derlucae98/spr23e-bmu/Doc/SPR23e-BMU-Doc_WIP.pdf

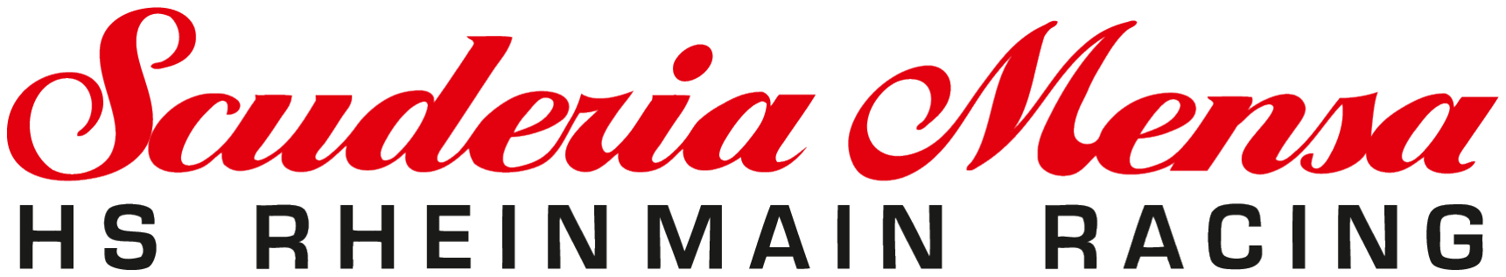
[picture p2: figure]
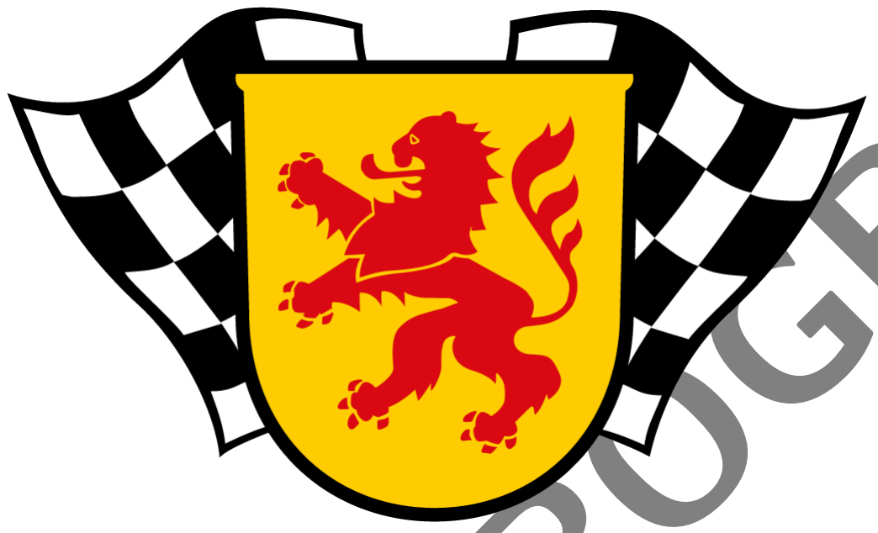
[picture p3: figure]
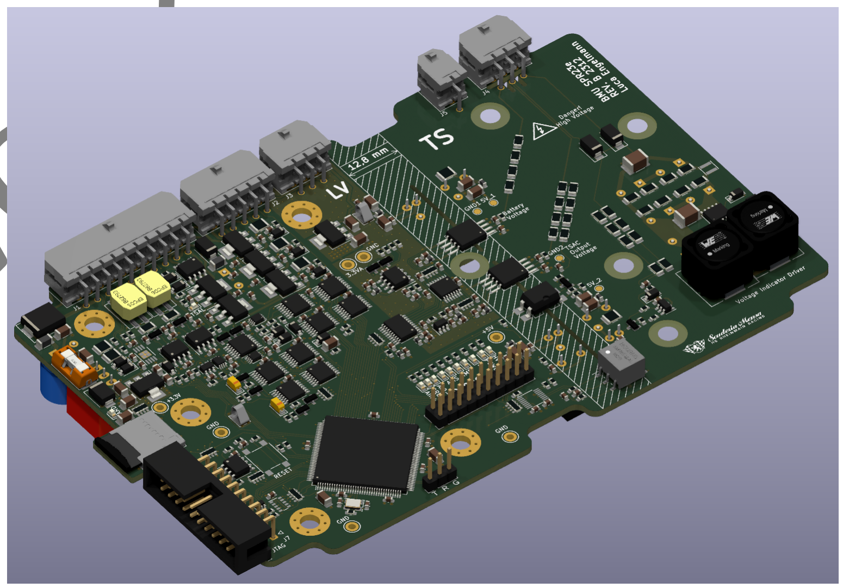
[picture p4: figure]

Department: | Electric Drive
Name: | Luca Engelmann
Season: | 2023/2024

# WORK IN PROGRESS

# Design Report

## Battery Management System for SPR23e

# Contents

Glossary | ii
List of Figures | iii
List of Tables | iv
1. Introduction | 1
2. Potential Improvements | 4
3. BMU Hardware Design | 5
4. Battery Disconnect Unit | 13
5. Software Architecture | 14
6. Test and Validation | 15
7. Bibliography | 26
A. Schematics Revision A (Only for reference!) | 27
B. Changelog Revision B | 40
C. Schematics Revision B | 41

i

# Glossary

AIR Accumulator Isolation Relay

AMS Accumulator Management System (See BMS)

BMS Battery Management System

BMU Battery Management Unit

BOM Bill Of Material

CAN Controller Area Network

CSV Comma-separated Values

EMI Electromagnetic Interference

ESD Electrostatic Discharge

FSG Formula Student Germany

HIL Hardware In the Loop

IMD Insulation Monitoring Device

LED Light Emitting Diode

LVS Low Voltage System

MCU Microcontroller Unit

PCB Printed Circuit Board

TS Tractive System

TSAC Tractive System Accumulator Container

TSAL Tractive System Active Light

UART Universal Asynchronous Receiver Transmitter

ii

# List of Figures

iii

# List of Tables

3.1. Truth table for the plausibility check for each AIR | | 10
3.2. Truth table for the TSAC output voltage plausibility check | | 11

iv

# 1. Introduction

## 1.1. Accumulator

Kurz auf den Akku eingehen; Zellen, Konfiguration und Rendering.

### 1.1.1. System Overview

Blockdiagramm mit Stacks, BMS Slave, AIRs und Sicherung, AIR-PCB mit pre-charge und abgesicherte Messabgriffe, Stromsensor, BMU, IMD

## 1.2. Requirements

### 1.2.1. General Requirements

The requirements are mostly based on the FSG rule set for 2023 [1]. Some general requirements for the vehicle integration apply also. These include

- Power supply from the low-voltage system (LVS) in a range from 18 V to 25 V, which is the unregulated voltage from the low-voltage accumulator.
- One CAN bus with a bitrate of 1 Mbit/s for the communication with the Vehicle Control Unit.
- One IsoSPI [2] interface for the communication with the BMS slaves on the accumulator stacks.
- Isolated voltage measurement for the accumulator and TSAC output voltage with an accuracy better than 1 % of the full measuring range.
- Isolated current measurement with a resolution better than ±140 A, which is two times the fuse rating to allow for any short current peaks, and an accuracy better than 1 % of the full measuring range.

### 1.2.2. Rule Requirements

Since the BMU contains many different parts required by the rules, all of the following rules have to be fulfilled. For the TSAL logic in the accumulator these rules apply:

- EV 4.10.3 [p. 85][1] The TSAL itself must have a green light, continuously on, active if and only if the LVS is active and ALL of the following conditions are true:

– All AIRs are opened.

– The pre-charge relay, see EV 5.7.2, is opened.

– The voltage at the vehicle side of the AIRs inside the TSAC does not exceed 60 V DC or 50 V AC RMS.

- EV 4.10.4 [p. 85][1] The mentioned voltage detection must be performed inside the respective TS enclosure.
- EV 4.10.5 [p. 85][1] The mentioned states of the relays (opened/closed) are the actual mechanical states. The mechanical state can differ from the intentional state, i.e. if a relay is stuck. Any circuitry detecting the mechanical state must meet EV 5.6.2.
- EV 4.10.6 [p. 85][1] The voltage detection circuit of the red light and the relay state and voltage detection circuit of the green light must be independent. Any plausibility check between both lights is not allowed. A TSAL state with both lights simultaneously active might occur and must not be prevented.
- EV 4.10.9 [p. 85][1] The TSAL and all needed circuitry must be hard-wired electronics. Software control is not permitted.
- EV 4.10.10 [p. 85][1] A green indicator light in the cockpit that is easily visible even in bright sunlight and clearly marked with “TS off” must light up if TSAL green light is on, see EV 4.10.3.
- EV 4.10.11 [p. 86][1] Signals influencing the TSAL and the indicator according to EV 4.10.10 are SCS, see T 11.9. The individual safe state of each of the TSAL lights is off. The TSAL has an active indication of the absence of failures (continuous green illumination) and thus the red light must not be illuminated for a visible check, see T 11.9.5.
- EV 4.10.13 [p. 86][1] The TSAL’s green light relay state detection circuit, see EV 4.10.3, does not need to detect an open circuit, as required by T 11.9, when the intentional state of the used (auxiliary) contact is opened. A plausibility check against the intentional relay state must be implemented in a way that the TSAL’s green light stays off after the open circuit is detectable.
- EV 4.10.14 [p. 86][1] The TSAL’s green light voltage detection circuit, see EV 4.10.3, does not need to detect an open circuit, as required by T 11.9, when no voltage is present. A plausibility check against the intentional relay states must be implemented in a way that the TSAL’s green light stays off after the open circuit of the accumulator voltage detection circuit is detectable.
- EV 4.10.14 [p. 86][1] The latching required by EV 4.10.13 and EV 4.10.14 must not be triggered during normal operation conditions and must only be reset by power cycling the LVS.

### 1.2.3. Additional Requirements

Firlefanz, der von der Regeln nicht gefordert wird, aber trotzdem drin ist

## 1.3. SPR21evo BMU

Kurz auf 21er BMU eingehen, Bild der Platine und Beschreibung der Key Features.

## 1.4. Comparing Legacy and Contemporary Solutions

Was kann die alte BMU anders als die neue? Welche Features kamen hinzu? Welche sind entfernt worden? Was ist der Ausblick auf Software-Seite? Logging auf SD-Karte, EEPROM, 2 CAN-Busse

Auch auf AIR-PCB und Stromsensor eingehen

# 2. Potential Improvements

Mögliche Verbesserungen

# 3. BMU Hardware Design

## 3.1. Implementations

Umsetzung der Anforderungen in REV A und REV B beschreiben.

Für REV A wird nur auf den Schaltplan und einen Changelog im Anhang verwiesen. REV B wird im Detail beschrieben

The TSAL logic will be implemented in the following way:

- The actual states of the relays will be monitored using auxiliary contacts in the relays. They are mechanically linked to the main contacts as explained in the application note [3, p. 2]: “The auxiliary contact actuating method will indicate the true position of the main contacts. The auxiliary contact actuation is directly coupled to the main contact moving bridge, and will not indicate “open” unless both contact gaps of the double-make, Form X contact are fully disconnected.”
- The plausibility check to fulfill EV 4.10.5 is done against the intentional state indicated by the BMU. The following possible states can trigger the latch:

– The intentional state is active, the actual state reports inactive: A line break in the state detection is to be assumed.

– The intentional state is inactive, the actual state reports active: The relay is most probably stuck

Due to its mechanical construction, the relay takes 25 ms to switch from the opened to the closed position and 10 ms for the reverse [4, p. 2]. In these time periods, the relay states are implausible and must not trigger the latch, as EV 4.10.14 indicates.

- In order to fulfill EV 4.10.13, a line break in the state detection is detected by a plausibility check against the TSAC output voltage in the following way. In case the TSAC output voltage detection circuit detects a voltage greater than 60 V although all relays are open, these possibilities can occur:

– The discharge circuit is still active after the relay opened. This is not a fault condition, since the discharge circuit takes about 2 seconds to discharge the TS below 60 V.

– If the fault persists for more than 3 seconds than the discharge should have finished and it is to be expected that the relays are stuck and the state detection circuitry is broken.

Note that the permissible state during discharge must not lead to a detected fault. However, a delay of 3 seconds to detect the fault is permissible by the rule.

- Likewise, a line break in the voltage detection circuitry is detected using a plausibility check against the relay states. If the relays are closed and the voltage detection circuitry detects no voltage, a fault in the detection circuitry is to be assumed and must lead to the latched deactivation of the green light.
- Since the TSAL accumulator logic is located on the BMU PCB and all TS components needed to perform the checks are located inside the TSAC, EV 4.10.4 is fulfilled.

- The circuit will be build with logic gates without any software control. Therefore, EV 4.10.9 is fulfilled as well. The final circuit is discussed in full detail in section 3.3.3.

## 3.2. Hardware Block Diagram

Blockdiagramm der BMU Hardware

## 3.3. Schematic Explanation

The schematic is rather complex and would not fit on one page. It is divided into 11 logical modules, which are connected on the top-level schematic seen in Figure 3.1. Each module will be discussed in the
following subsections. The full schematic is available in Appendix C. 1 | 2 | 3 | 4 | 5 | 6
1 | 2 | 3 | 4 | 5 | 6

A

BC

D

A

BC

D Date: 2023-03-25 KiCad E.D.A. kicad 6.0.11-2627ca5db0~126~ubuntu22.04.1 Size: A4 | Rev: B

Id: 1/12 Title: SPR23e Battery Management Unit (BMU) File: spr23e-bmu.kicad_sch Sheet: / Scuderia Mensa HS RheinMain racing e.V. Author: Luca Engelmann Car number: 65

IMD_RESET AMS_RESET SC_INPUT SC_OUTPUT

IMD_RESET_STATUS
AMS_RESET_STATUS

IMD_INDICATOR

AMS_INDICATOR

IMD_STATUS | AMS_FAULT Shutdown ULINK+ ULINK- HVI_LED+ HVI_LED- PRE-CHARGE HVI | ULINK_ISO_B ULINK_ISO_A
TSAL_VOLTAGE_PRESENT ULINK- | UBATT_ISO_B UBATT_ISO_A ULINK+ UBATT- UBATT+ | VREF_H

TS_ISO

Power Datei: Power.kicad_sch | AIR+_STATE
| PRE-CHARGE_STATE

AIR-_STATE

TSAL_VOLTAGE_PRESENT

TSAL_SIG
PRE-CHRG_INTENT AIR+_INTENT AIR-_INTENT

TSAL SHUTDOWN_CIRCUIT DISCHARGE

PRE-CHARGE_INTENT AIR+_INTENT AIR-_INTENT Discharge_Ctrl | MISO_ADC MOSI_ADC

~{CS_ADC}

~{IRQ_ADC} CURRENT_SENS_B ULINK_ISO_A CURRENT_SENS_A ULINK_ISO_B UBATT_ISO_A UBATT_ISO_B SCK_ADC

VREF_H

ADC

~{CARD_DETECT}

~{CS_EEPROM}

~{CS_CARD} SCK_PERIPH MOSI_PERIPH MISO_PERIPH

CS_RTC

~{IRQ_RTC} CLKOUT_RTC

Periphery

ISO_A_SLAVES

ISO_B_SLAVES

~{CS_SLAVES} CAN_H_DIAG CAN_L_DIAG CAN_H_VEHIC CAN_L_VEHIC
CAN0_TX CAN0_RX CAN1_TX CAN1_RX

SCK_SLAVES MOSI_SLAVES MISO_SLAVES

Interface

IMD_STATUS

IMD_MEAS

SC_STATUS

AMS_FAULT

IMD_RESET_STATUS

AMS_RESET_STATUS

AIR+_STATE

AIR-_STATE

PRE-CHARGE_STATE | CAN0_TX CAN0_RX

SPI0_MOSI SPI1_SCK

SPI1_MISO

# SPI1_MOSI SPI2_MOSI UART0_TX UART0_RX CAN1_TX CAN1_RX

SPI0_MISO

SPI0_SCK

SPI2_SCK
SPI2_MISO

AIR+_~{RESET}

AIR-_~{RESET} PRE-CHARGE_SET AIR+_SET PRE-CHARGE_~{RESET} AIR-_SET

~{CS_ADC}
~{IRQ_ADC}

~{CS_EEPROM}
~{CS_CARD} CS_RTC

~{IRQ_RTC}

~{CARD_DETECT}

~{CS_SLAVES} AIR+_INTENT AIR-_INTENT PRE_INTENT

TSAC_VOLTAGE_PRESENT CLKOUT_RTC

AMS-Master AIR+_STATE

PRE-CHARGE_STATE

AIR-_STATE

IMD_MEAS

IMD_STATUS

SC_RETURN

AIR+_~{RESET} AIR+_SET AIR-_SET AIR-_~{RESET} PRE-CHARGE_SET PRE-CHARGE_~{RESET} AIR-_STATE_FILT AIR+_STATE_FILT PRE-CHARGE_STATE_FILT

IMD_MEAS_FILT

IMD_STATUS_FILT SC_STATUS

AIR+ PRE-CHARGE
AIR-

IMD_RESET_FILT AMS_RESET_FILT

IMD_RESET AMS_RESET | PRE-CHRG_INTENT AIR-_INTENT AIR+_INTENT
IO_EMI | GND | GND

H2 GND

H1 | GNDGND | GND
H9 H3 H4 H5 GND | GND

1
2
3

4
5
6

J3 SENSOR

1
2
3

J6UART VCC

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
LV_IO

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
LV ACCU

+24V | H8 N2SHIELD GND | GND

N1SHIELD

1 | 2

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
J4TS | H10 S4SYMBOL S1SYMBOL | H6 H7 S3SYMBOL S2SYMBOL GND

IMD_STATUS

ISO_A CAN_L_VEHIC

HVI+

IMD_RESET CAN_L_DIAG

PRE-CHRG

HVI- TSAL_SIG
AMS_RESET AMS_INDICATOR

## SC_INPUT GND

IMD_INDICATOR

SC_OUTPUT SC_INPUT PRE-CHARGE_STATE

PRE-CHARGE
AIR+ AIR+_STATE HVI+

IMD_MEAS

IMD_STATUS

AIR+_STATE
AIR-_STATE

SC_RETURN

AMS_RESET | AMS_INDICATOR DISCHARGE ULINK+ HVI- | ULINK- DISCHARGE

PRE-CHRG

SENS- | SENS+ | UBATT- ULINK+ AIR-_STATE UBATT+ | UBATT+
ISO_B | ULINK+ ULINK- UBATT-

ISO_A

# SENS+ SENS- SC_OUTPUT

IMD_RESET SC_RETURN

CAN_H_VEHIC

IMD_INDICATOR

CAN_H_DIAG

AIR-

# IMD_MEAS ULINK-

ISO_B

PRE-CHARGE

PRE-CHARGE_STATE
AIR+ AIR- +24V

TSAL_SIG

CAN_H_DIAG

CAN_L_VEHIC

CAN_H_VEHIC

CAN_L_DIAG

GND

J6UART

1
2
3 +24V

J1

LV_IO

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
9 | VCC

J3 SENSOR
1
2
3

4
5
6 | H3 H4 H5 GNDGND

H1 GND

H2 GND | GND
H9 H8 H7 H6 S1SYMBOL S3SYMBOL S2SYMBOL S4SYMBOL N1SHIELD GND | GND

N2SHIELD

Figure 3.1.: Top-level BMU schematic.

### 3.3.1. Power Supply

The power supply schematic provides input protection and all necessary power rails for the BMU. The schematic for the power supply section is shown in Figure 3.2. At the input, L1, C77, and C78 form a low-pass filter to filter out any high-frequency noise which might be on the low-voltage system. D16 is used in conjunction with F1 to protect the BMU against over-voltages. D15 not only protects the BMU from reverse-polarity, but it also isolates the BMU supply from the low-voltage system. A high-current spike will not drain C78, leading to a stable power supply of the BMU in case of voltage dips caused by switching of the cooling fans or pumps. The 18 V to 25 V provided by the LVS is stepped-down to 5 V using an integrated DC to DC converter. Two low-dropout regulators U25 and U26 generate the main 3.3 V digital voltage rail used by the microcontroller and the other digital circuits and a secondary 3.3 V voltage rail used by the analog circuits. The use of two independent regulators for analog and digital circuits prevents noise coupling from the digital to the analog circuit. A power LED signalizes that the BMU is powered. Test points for all voltage rails are provided for easy measurement on the PCB.

B

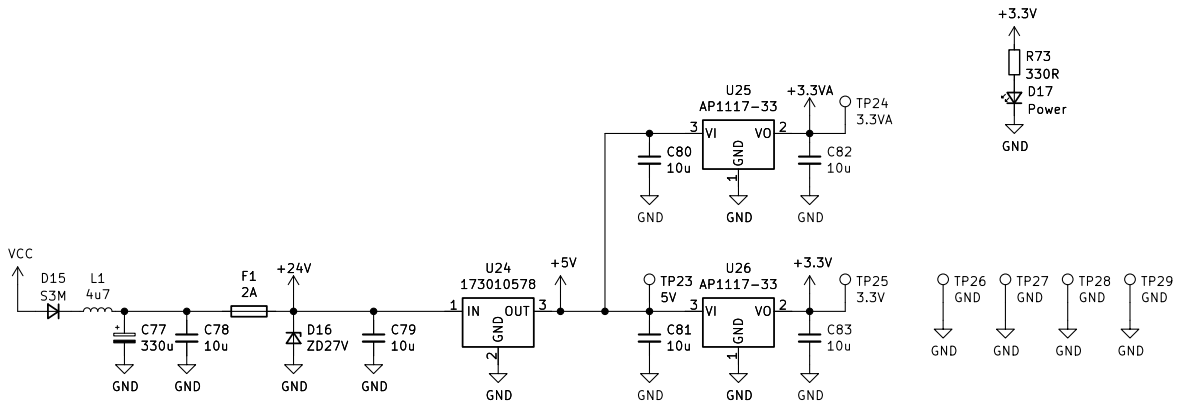
[picture p5: figure]
GND; 2 OUT 3 U24; 10u VCC; 1 VO 2 VI 3 U25 AP1117-33 +3.3VAC82; 10u GND; TP28 GND GND GND; D16 ZD27V C78 10u GND; 2A GND; D17 Power GND; TP27 GND; TP26 GND; +3.3V GND GND 1 VO 2 VI 3 U26 AP1117-33 GND; 5V GND; R73 330RGND; C81 10u GND; TP29 GND; +3.3V U26 AP1117-33GND; 1 VO 2 VI 3 GND; U25 AP1117-33GND; 1 VO 2 VI 3 +3.3VA GND; 2 OUT 3 GND; C78 10u GND; C77 330u GND; +24VD16 ZD27V GND; 330R GND; D17 Power +3.3V

Figure 3.2.: Schematic of the power supply section.

### 3.3.2. I/O

This section of the schematic conditions the input signals for the BMU logic and drives the AIRs. It can be seen in Figure 3.3. Since the digital section operates at 3.3 V and the signals outside the BMU operate at LVS levels, zener diodes are used to limit the voltages. Each signal has a pull-down resistor to ensure stable logic levels in case of unconnected inputs. The 2.2 kΩ resistors at the inputs for the state detection of each relay ensure the minimum wetting current needed for the LEV100 relays: "Minimum Aux Contact Load 10mA/12Vdc" [4, p. 3]. Likewise, the pull-down resistors R77 and R78 for the IMD are the recommended values from the datasheet [5, p. 5]. Note that these resistors have to dissipate some power at the maximum voltage of the LVS: Pd,pull−down =

(25 V)

2
2.2 kΩ = 0.28 W. Therefore, resistors in a 1210 package are used, since they are rated for 0.5 W of power [6]. The capacitors form in combination with the zener diode dropper resistors a low-pass filter used to filter out any noise which might be picked up by the signal wires. The status of the shutdown circuit is also evaluated by the BMU. The same input protection circuit is used to measure the voltage of it. The relays are directly supplied from the shutdown circuit. L2 and C96 form low-pass filter, which limits the current spike caused by the switching of the relays. D18 is important to separate the high-current path from the detection path. Imagine that the AIRs are not energized and the shutdown circuit is active. Now, one emergency button is pressed. The shutdown circuit is turned off but C96 is still charged. Without D18, it would lead to a false reading of the SC_STATUS signal until the capacitor is discharged. With D18, C96 is blocked from holding up the voltage at the SC_RETURN node in this scenario. This ensures, that the microcontroller and the latches U28A, U28B, and U29A detect a power-loss in the shutdown circuit without any noticeably delay.

The AIRs are controlled by ITS4200 high-side switches [7] which are supplied by the shutdown circuit. This is required by EV 6.1.1 [1]. U30 is used as level shifters to drive the high-side switches. This step is needed, since the ITS4200 is advertised with a "CMOS compatible input" [7, p. 2] and has an input voltage turn-on threshold of 3.0 V [7, Table 4]. Its input is driven with 5 volt instead of 3.3 V to avoid potential problems. The inputs of the 74HCT logic series recognize a logical high signal at and above 2.0 V. The ITS4200 is internally protected against short-circuits and voltage backfeed, making it an ideal output driver for the BMU. The relays are not directly controlled by the BMU. Instead, flip-flops isolate the control from the microcontroller to the outputs. The MCU can set and clear the flip-flops. Additionally, the flip-flops can be cleared by the shutdown circuit signal. This has the advantage that the relays are not only de-energized by the loss of power but also the turn-on request is cleared in hardware. In the BMU for the SPR21e, this was solely done in software. Now imagine that the flip-flops were omitted and the microcontroller crashes as soon as the AIRs are energized. If the emergency switch is pushed, the AIRs will de-energize. However, since the crashed microntroller still requests the positive and negative AIR to be energized, re-activation of the emergency switch results in an uncontrolled re-activation of the tractive system without pre-charging. Due to the large current spike, both the positive and negative AIR will be most likely stuck after this event. This has happened in the early testing phase of the SPR21e. With the hardware flip-flops, it doesn’t matter if the microcontroller crashes while the AIRs are energized. The flip-flops will only react on the rising-edge of the SET-signals and will be cleared, as soon as the shutdown circuit opens. The intentional states of the relays are taken from the outputs of the flip-flops. Notice that the flip-flops are reset-dominant, meaning that they cannot be set if the clear input is set to a logical zero.

# 10k GND

# 2k2D18 US1M

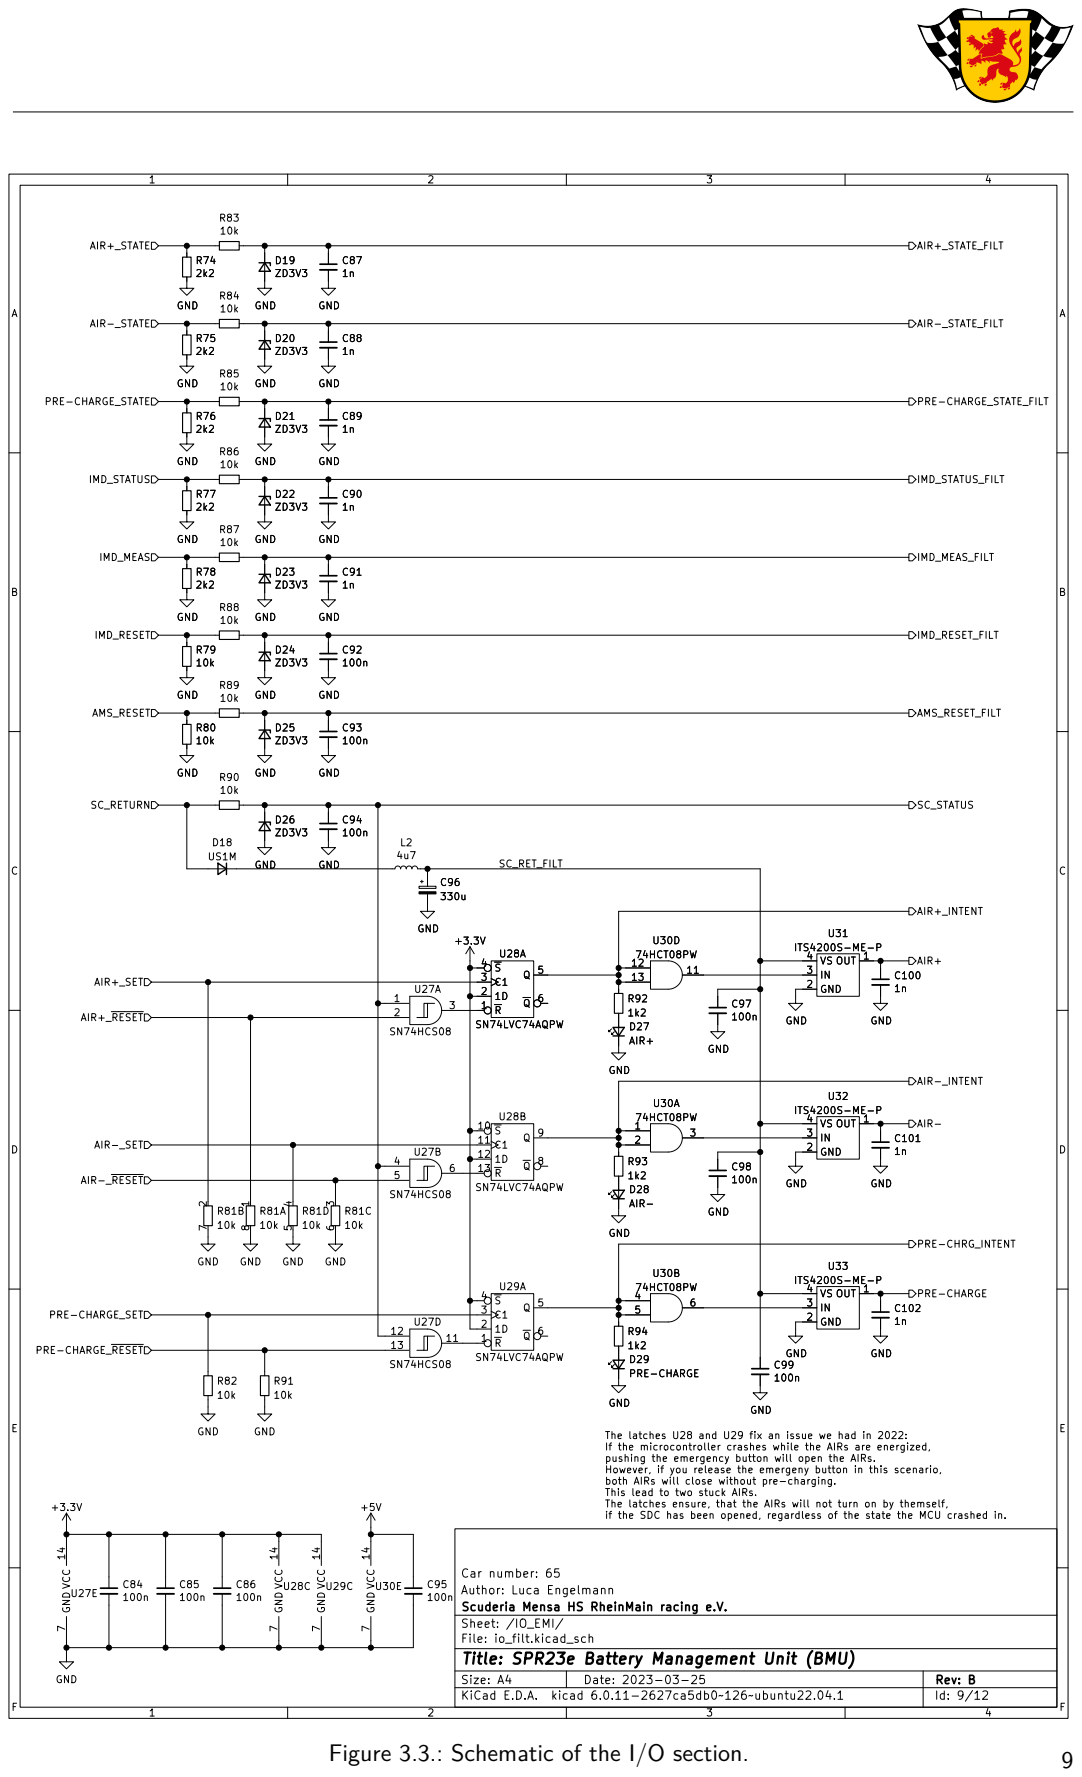
[picture p6: page 15]

1n GND VCC ¹⁴ GND
IMD_STATUS

ITS4200S-ME-P OUT 1 GND 2
OUT 1 GND 2
ITS4200S-ME-P GND GND OUT 1 GND 2

The latches U28 and U29 fix an issue we had in 2022:
pushing the emergency button will open the AIRs. However, if you release the emergeny button in this scenario, both AIRs will close without pre-charging. This lead to two stuck AIRs. The latches ensure, that the AIRs will not turn on by themself,

Id: 9/12 Title: SPR23e Battery Management Unit (BMU) File: io_filt.kicad_sch Sheet: /IO_EMI/ Scuderia Mensa HS RheinMain racing e.V. Author: Luca Engelmann Car number: 65

### 3.3.3. TSAL

The TSAL schematic can be divided into three logical sections. The top section checks the three AIRs for plausible states. The second section checks the TS detection circuit for plausibility. The third section
controls the green light and contains the required latch. Figure 3.4 shows the schematic of the TSAL logic. 1 | 2 | 3 | 4 | 5 | 6
1 | 2 | 3 | 4 | 5 | 6

A

BC

D

A

BC

D Date: 2023-03-25 KiCad E.D.A. kicad 6.0.11-2627ca5db0~126~ubuntu22.04.1 Size: A4 | Rev: B

Id: 11/12 Title: SPR23e Battery Management Unit (BMU) File: tsal_accu.kicad_sch Sheet: /TSAL/ Scuderia Mensa HS RheinMain racing e.V. Author: Luca Engelmann Car number: 65

1

2 3 Q7 BSS84AK

+3.3V

11

12

13 U38D
SN74HCS7266QPWR
TP33 AIR_ACTIVE
+24V GND

4
5

6 U39B
74AHC32PW

10

8

9 U39C
74AHC32PW

1
2

3 U39A
74AHC32PW

R126
10k

1
2

3 U38A
SN74HCS7266QPWR

10

8

9 U38C
SN74HCS7266QPWR

D37 TSAL_GREEN

TP29 TSAL_LATCH_RESET | R122 100R

~{S} 10 C1 11

1D

12 ~{R} 13 | ~{Q}8 Q

9 U29B

SN74LVC74AQPW

GND

11
12

13 U37D
74AHC02PW

GND

11
12

13 U39D
74AHC32PW

GND

1

2 3 Q8 BSS84AK

+3.3VR119

10k +3.3VD36

1N4148 | R125

10k R123
100R

C124
10u

1

2

3 U37A
74AHC02PW

1

2 3 Q6 SQ2308CES

11

12

13 U1D
SN74HCS08 4

5

6 U38B
SN74HCS7266QPWR | GND

C126
1n GND

TP36 GREEN_SIG

GNDGND OUT 1 GND 2

IN

3 VS 4 U40

ITS4200S-ME-P C125

100n R120
1k 10

8

9 U30C
74HCT08PW

+3.3V

10

8

9 U37C
74AHC02PW

TP32 AIR_PLAUSIBLE

TP34 HV_DET_PLAUS

+3.3V

1

# 2 3 Q5 SQ2308CES R121

1k GND

C119

100n | C121

100n C120

100n | TP35 GREEN_EN
TP31 TSAL_PWR_ON_RST

10

8

9 U27C

SN74HCS08 C118

100n

4

5

6 U37B
74AHC02PW

10
8
9 | U1C
SN74HCS08 | TP37 AIR_PLAUSIBLE_DELAY VCC ¹⁴ GND

7 U38E VCC 14 GND

7 U39E VCC 14 GND

7 U1E

1
2

3 U1A
SN74HCS08 TP38 HV_DET_PLAUS_DLY VCC ¹⁴ GND

7 U37E R124
10k TP30 VOLTAGE_PRESENT GND | GND | GND

C123
10u C122
10u | +3.3V GND

AIR+_STATE

# TSAL_VOLTAGE_PRESENT AIR+_INTENT PRE-CHARGE_STATE

TSAL_SIG

AIR-_INTENT PRE-CHRG_INTENT AIR-_STATE | HV_DET_PLAUSIBLE
AIR+_ACTIVE | GREEN_EN

HV_DET_PLAUS_DLY

AIR-_ACTIVE

PRE_ACTIVE | AIR_ACTIVE

AIR_PLAUSIBLE

AIR+_PLAUSIBLE

PRE_PLAUSIBLE

AIR-_PLAUSIBLE

AIR_PLAUSIBLE_DELAY Retriggerable | delay
(falling | edge) 100ms Retriggerable | delay
(falling | edge) 100ms AIR plausibility | check | TS detection | plausibility | check | GND

C122

10u D36

1N4148 +3.3V R119

10k +3.3V | GND

C125
100n U40

ITS4200S-ME-P OUT 1 GND 2

IN

3 VS 4GND GND | GND

C126

1n GND Q6
1 | SQ2308CES

2 3 Q5
1 | SQ2308CES

2 3 U29B

SN74LVC74AQPW

~{S} 10 C1 11

1D

12 ~{R} 13 | ~{Q}8 Q

# 9 +3.3V U38D

SN74HCS7266QPWR
11

12
13 | R126
10k D37 TSAL_GREEN GND | GND
| R125
10k C124

## 10u GND

C123
10u GND

R124
10k

Figure 3.4.: Schematic of the TSAL accumulator logic.

The logic evaluates if the current state is plausible. A plausible state is always reached when the TSAC output voltage matches the relay state and if the actual relay state matches the intentional state. The truth table for the AIR plausibility check for each AIR is shown in Table 3.1. The resulting boolean function corresponds to an exclusive NOR gate (U38 in Figure 3.4).

Table 3.1.: Truth table for the plausibility check for each AIR.
AIR intentional | AIR actual | plausible | Comment
inactive | inactive | yes | No error
inactive | active | no | AIR stuck
active | inactive | no | State detection or coil wire broken
active | active | yes | No error

The AND gate U1 (Figure 3.4) combines the plausibility of all AIRs to one signal AIR_PLAUSIBLE, which is low as soon as one of the AIRs is implausible and high if all AIRs are plausible. A retriggerable delay circuit accommodates for the mechanical switching time of the AIRs. It delays the falling edge only and passes the rising edge through without any delay. The delay time is set by the time constant of C123 and

R124 (Figure 3.4) and the input threshold of the following AND gate (U1, Figure 3.4). The following gate needs to have Schmitt trigger inputs due to the slow falling edge caused by the delay. The input thresholds have a large tolerance and are not specified for a supply voltage of 3.3 V [8, Section 6.5]. The interpolated values for the negative threshold are 0.61 V < UT − < 1.22 V. At the maximum lower input threshold, the delay time is minimal and corresponds to the RC time constant τ . The circuit ensures a minimum delay time of 100 ms. At the minimum lower input voltage threshold, the delay time will increase to 170 ms.

The plausibility check for the TSAC output voltage detection uses both the intentional and the actual AIR states for comparison. U37 and U39 combine the six signals to one signal. If any of the AIRs is active (either intentional or unintentional) the signal AIR_ACTIVE will be high. The complex appearing connection of U37 and U38D results in an efficient utilization of the four independent gates within a package. U38D is configured to behave like an inverter. The signal HV_DET_PLAUSIBLE is a combination of the TSAC output voltage detection and the AIR state with the truth table shown below. The corresponding boolean function is an OR gate with one inverted input.

Table 3.2.: Truth table for the TSAC output voltage plausibility check.
Voltage present | AIR active | plausible | Comment
no | no | yes | No error
no | yes | no | Voltage detection broken wire
yes | no | yes | See text
yes | yes | yes | No error

A voltage greater than 60 V present at the TSAC output while no AIR is active is not considered as implausible since this happens on every discharge cycle. In this case, the green and the red LED of the TSAL will be active. This edge case is allowed by rule EV 4.10.6 and is thus not prevented. The HV_DET_PLAUSIBLE signal uses an identical retriggerable delay circuit. In this case, it is used to accommodate for the sum of the pre-charge time and the relay turn-on time. During pre-charge, the TSAC output voltage will rise depending on the time constant of the pre-charge resistor and the DC-Link capacitor. In order to detect a broken wire in the voltage detection circuitry, the plausibility check waits for the DC-Link voltage to rise above 60 V. This ensures that the broken wire is detected if the implausibility persists after the pre-charge time and pre-charging will not lead to a false triggering. The time it takes for the DC-Link voltage to rise above 60 V can be calculated with the basic capacitor charging formula shown in Equation 3.1.

Uc(t) = U0 · (1 − e

− t
τ ) | (3.1)

Re-arranging Equation 3.1 to solve for t is shown in Equation 3.2. The maximum t will be at the minimum battery voltage of 430 V. Solving for Uc(t) = 60 V, U0 = 430 V, τ = RC = 1000 Ω · 300 µF, Equation 3.2 yields:

tpre = −τ · ln
1 −

Uc(t)
U0

= −(1 kΩ · 300 µF) ln
1 −

60
430
= 45 ms | (3.2)

The turn-on time of the relays add to the pre-charge time. The resulting total pre-charge time tpre,sum equals:
tpre,sum = ton,relay + tpre = 25 ms + 45 ms = 70 ms | (3.3)

Therefore, a delay of 100 ms is sufficient as well.

The last section of the TSAL logic combines the plausibility check, the voltage detection signal, and the AIR_ACTIVE signal to control the green light of the TSAL. The flip-flop U29B is the latch required by EV 4.10.13 and EV 4.10.14. It is set on startup after a short delay, to ensure that all signals which clear the latch are stable. If the AIRs or the voltage detection are implausible, the latch is cleared. The output of the latch is used as enable signal for the green light. Therefore, the green light can only be activated, if the whole system is in a plausible state. The green light is then controlled by the AIR_ACTIVE and TSAL_VOLTAGE_PRESENT signal in a way that either of these signals turn off the green light. This ensures that the green light is deactivated as soon as at least one AIR is active and reactivated only if the voltage at the TSAC output is less than 60 V and all AIRs are off. The signal output uses the same method as described in subsection 3.3.2. The signal produced by U40 is sent to the TSAL logic in the inverter, where it is routed to the TSAL lights.

# 4. Battery Disconnect Unit

Hier auf AIR-PCB und Stromsensor eingehen und die Platzierung der Komponenten in der BDU; Rendering

## 4.1. AIR PCB

Schaltplan und Beschreibung der Funktion, Rendering

## 4.2. Current Sensor

Schaltplan, Beschreibung der Komponenten, Berechnung der Genauigkeit und Rendering

# 5. Software Architecture

Softwarearchitektur erläutern

## 5.1. <Software Modul>

Softwaremodule erläutern

# 6. Test and Validation

## 6.1. Test Setup

Testaufbau erklären

## 6.2. TSAL Test

The TSAL accumulator logic has been simulated with LTSpice before putting it onto the PCB. The simulation tests all possible error conditions, including stuck relays, broken relay state detections and a line break in the voltage detection. The simulation results have been checked against the real behavior using a Hardware-in-the-loop (HIL) test procedure. A S32K144-Q100 evaluation board [9] is connected via CAN to the BMU and controls the relays in the test setup based on the commands sent by the BMU. It also feeds back the current state of the TSAL signal. The BMU runs a modified firmware which contains the test procedures. These tests can be initiated via the UART interface. During the test, the BMU will output all necessary values in CSV format over the UART interface in 50 ms time intervals. The BMU firmware uses the measured DC-Link and battery voltages to perform the pre-charge. The simulation performs the pre-charge using a constant timing for the relays. Stuck relays may lead to different pre-charge times than usual. The simulation will not account for that fact. However, it does not influence the behavior of the TSAL logic. Furthermore, the slow appearing rise and fall times in the test results are an artifact from the 50 ms time slices. They do not represent the real rise and fall times. Another artifact from the same source are shifted edges by ±50 ms. The following pages show the simulation result on the left side and the real behavior on the right side in the following order:

1. No error
2. Positive AIR stuck
3. Pre-charge relay stuck
4. Negative AIR stuck
5. Voltage detection broken wire
6. Positive AIR state detection broken wire
7. Pre-charge relay state detection broken wire
8. Negative AIR state detection broken wire

The graphs in each plot represent the logic signals at the most important points in the circuit. The upper most plot shows the output of the TSAL logic, which controls the green light. The second graph shows the voltage detection with a logical high at 3.3 V representing a detected voltage > 60 V. The relay intent and state plots are self explanatory. They represent the intentional and actual state of the relay with a logical high representing an active state. The last plot shows the DC-Link voltage measured by the BMU. The simulation uses the accumulator voltage of 600 V while the HIL test uses 24 V. The plots of the HIL tests use 0 and 1 to denote the logical states.

Test 1: No error

In this test, the BMU performs a pre-charge and a discharge cycle. The TSAL green light shall turn off, as soon as at least one AIR is closed or the voltage across the DC-Capacitor is greater than 2.5 V and shall turn back on, if all AIRs are open and the DC-Link voltage is less than 2.5 V. The 24 V/2.5 V ratio between the battery voltage in the test setup and the TS detection threshold is approximately the same as in the real setup with a ratio of 600 V/60 V. As seen in Figure 6.2, the TSAL logic behaves exactly as simulated. The test would not be passed, if the LED would not turn off at the 1 s mark or would remain off at the 4.4 s mark.

Test 2: Positive AIR stuck

This test simulates a stuck positive AIR. The AIR+ state is therefore always high. During pre-charging, the negative AIR closes. Therefore, the pre-charge resistor is bridged in this scenario. Notice that the simulation uses a simple time-controlled pre-charging while the real BMU performs the pre-charging based on the DC-Link and battery voltage. This explains the short on-time of the pre-charge relay compared to the simulation due to the fast rise time of the DC-Link voltage. Notice also, that the BMU with the final firmware would not allow to close any relay if one of the relay is stuck. Both the simulation in Figure 6.3 and the HIL test in Figure 6.4 show, that the TSAL green light never turns on, as required.

Test 3: Pre-charge relay stuck

A stuck pre-charge relay does not directly lead to malfunction of the pre-charge sequence or the general function of the tractive system. However, it would violate EV 5.6.2 [1, p. 90]. A stuck pre-charge relay is detected correctly as Figure 6.5 and Figure 6.6 show. The TSAL’s green light does not turn on at all.

Test 4: Negative AIR stuck

Similarly to test 3, a stuck negative AIR causes no direct malfunction of the system but it will also violate EV 5.6.2 [1, p. 90]. This fault is correctly detected as well, as seen in Figure 6.7 and Figure 6.8.

Test 5: Voltage detection broken wire

A broken wire or blown fuse in the voltage detection circuit is simulated in this test. Since the voltage detection circuit and the TSAC output voltage measurement share the same wire and fuse, the DC-Link voltage and the voltage detection in both the simulation and the real hardware read always zero. Additionally, since the simulation does not use the DC-Link voltage to perform the pre-charge, the relay sequence looks identical to any other test (Figure 6.9). The BMU will remain in the pre-charge state since the DC-Link voltage does not reach 95 % of the battery voltage, causing the positive AIR to never energize (Figure 6.10). It is apparent that as soon as the negative AIR and the pre-charge relay turn on, the green light turns off and remains off, after both relays de-energize again.

Tests 6, 7, and 8: Relay state detection broken

Due to their similarities, the last three tests are summarized here. As seen in Figure 6.12, Figure 6.14, and Figure 6.16, the state detection of the positive AIR, pre-charge relay, and negative AIR read constantly zero. This fault is detectable, as soon as the corresponding relay is energized. The green light turns of, as soon as the AIRs are energized and remains off after the relays de-energize due to the fault latching.

TSAL Test: Summary

In summary, the tests show that the TSAL accumulator logic recognizes all possible faults correctly and behaves rule compliant. While these tests seem extremely elaborate and time-consuming, it is important to fully validate the functionality of the TSAL logic, since it is a safety-critical part that must behave under all circumstances as expected.

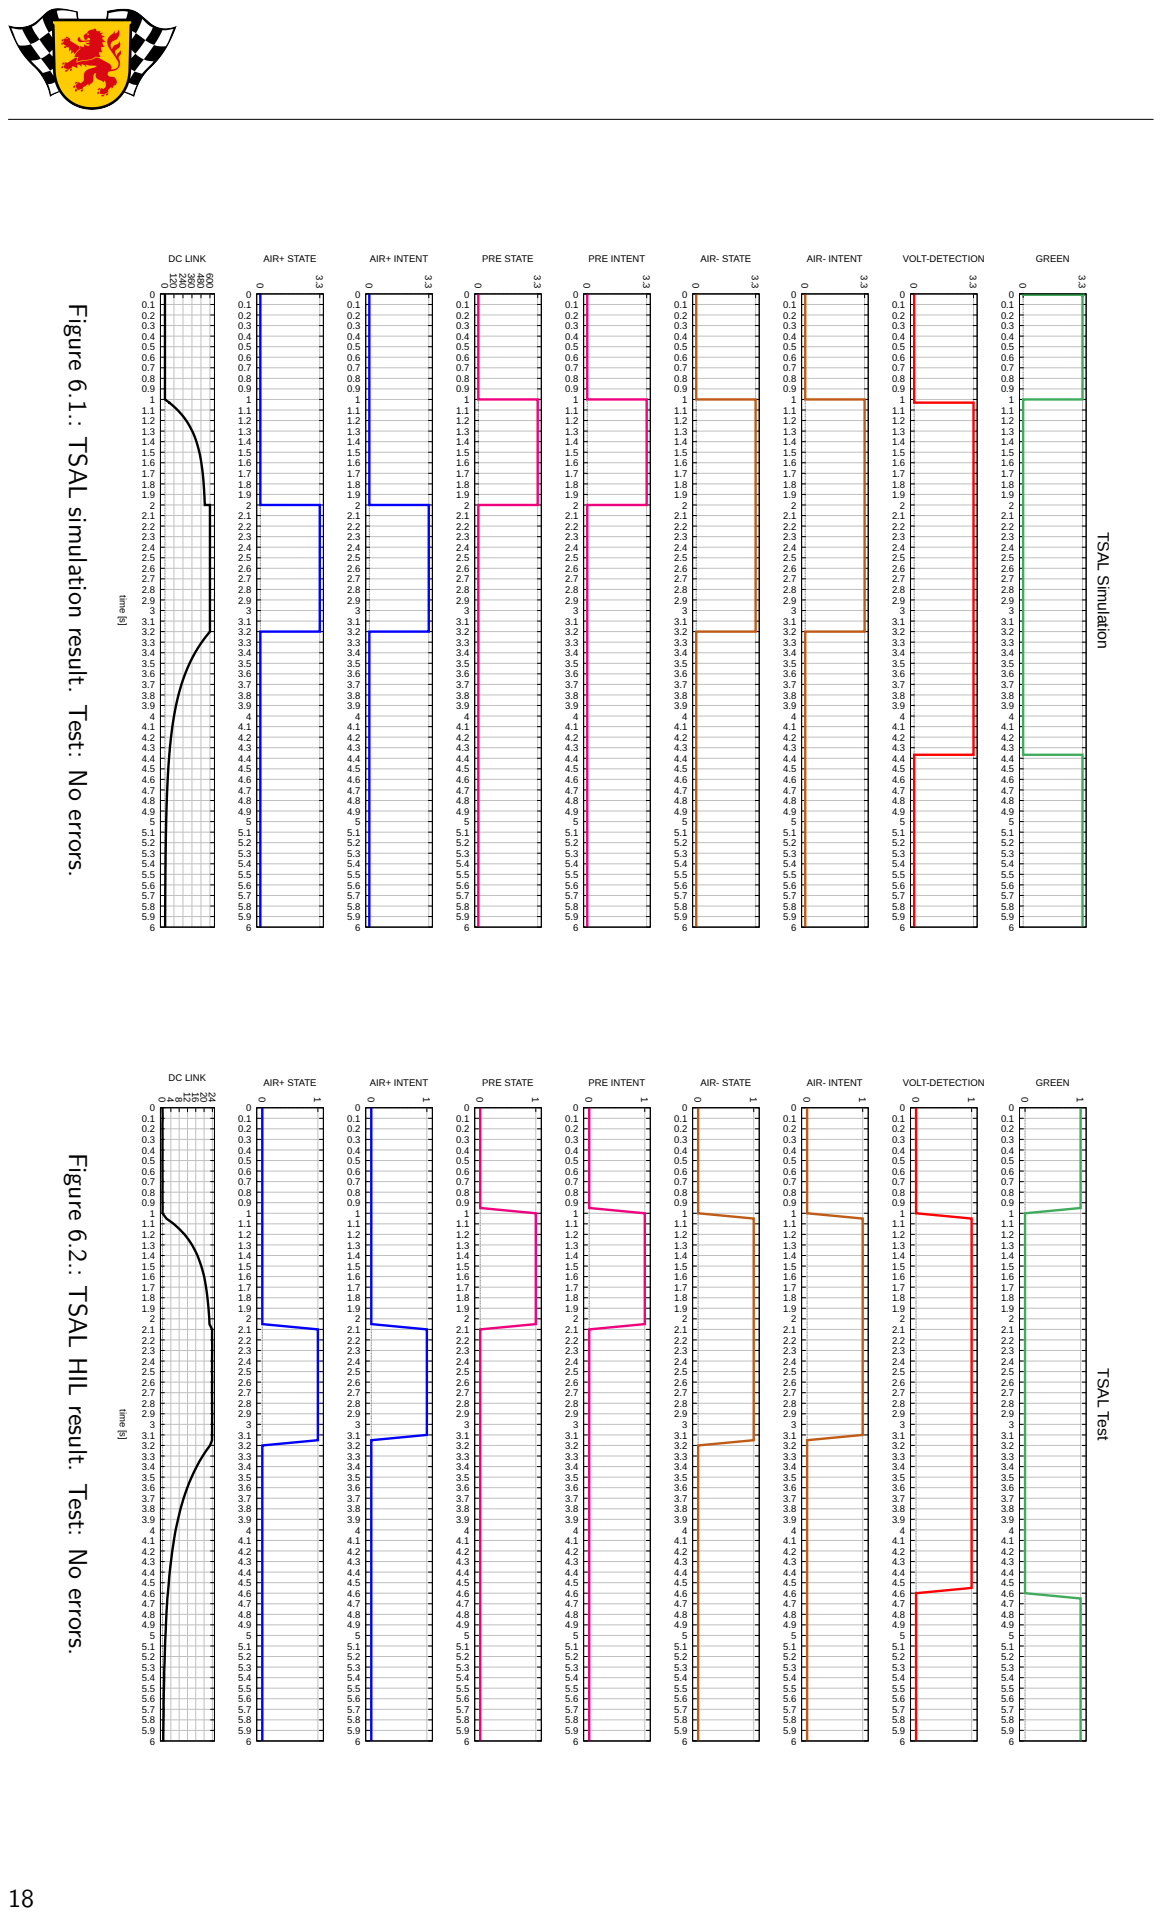
[picture p7: page 24]
TSAL Simulation; GREEN; VOLT-DETECTION; AIR- INTENT; AIR- STATE; PRE INTENT; PRE STATE; AIR+ INTENT; AIR+ STATE; DC LINK; time [s]; TSAL Test

Figure 6.1.: TSAL simulation result. Test: No errors.

Figure 6.2.: TSAL HIL result. Test: No errors.

TSAL Simulation

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
GREEN

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
VOLT-DETECTION

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
AIR- INTENT

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
AIR- STATE

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
PRE INTENT

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
PRE STATE

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
AIR+ INTENT

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
AIR+ STATE

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
DC LINK

time [s]

Figure 6.3.: TSAL simulation result. Test: Positive AIR

stuck.

TSAL Test

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
GREEN

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
VOLT-DETECTION

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
AIR- INTENT

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
AIR- STATE

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
PRE INTENT

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
PRE STATE

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
AIR+ INTENT

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
AIR+ STATE

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
DC LINK

time [s]

Figure 6.4.: TSAL HIL result. Test: Positive AIR stuck.

TSAL Simulation

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
GREEN

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
VOLT-DETECTION

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
AIR- INTENT

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
AIR- STATE

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
PRE INTENT

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
PRE STATE

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
AIR+ INTENT

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
AIR+ STATE

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
DC LINK

time [s]

Figure 6.5.:

relay stuck.

TSAL simulation result. Test: Pre-charge

TSAL Test

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
GREEN

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
VOLT-DETECTION

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
AIR- INTENT

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
AIR- STATE

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
PRE INTENT

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
PRE STATE

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
AIR+ INTENT

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
AIR+ STATE

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
DC LINK

time [s]

Figure 6.6.:

stuck.

TSAL HIL result. Test: Pre-charge relay

TSAL Simulation

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
GREEN

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
VOLT-DETECTION

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
AIR- INTENT

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
AIR- STATE

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
PRE INTENT

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
PRE STATE

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
AIR+ INTENT

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
AIR+ STATE

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
DC LINK

time [s]

Figure 6.7.: TSAL simulation result. Test: Negative AIR

stuck.

TSAL Test

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
GREEN

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
VOLT-DETECTION

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
AIR- INTENT

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
AIR- STATE

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
PRE INTENT

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
PRE STATE

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
AIR+ INTENT

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
AIR+ STATE

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
DC LINK

time [s]

Figure 6.8.: TSAL HIL result. Test: Negative AIR stuck.

TSAL Simulation

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
GREEN

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
VOLT-DETECTION

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
AIR- INTENT

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
AIR- STATE

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
PRE INTENT

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
PRE STATE

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
AIR+ INTENT

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
AIR+ STATE

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
DC LINK

time [s]

Figure 6.9.:

tection broken wire.

TSAL simulation result. Test: Voltage de-

TSAL Test

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
GREEN

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
VOLT-DETECTION

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
AIR- INTENT

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
AIR- STATE

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
PRE INTENT

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
PRE STATE

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
AIR+ INTENT

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
AIR+ STATE

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
DC LINK

time [s]

Figure 6.10.:

broken wire.

TSAL HIL result. Test: Voltage detection

TSAL Simulation

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
GREEN

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
VOLT-DETECTION

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
AIR- INTENT

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
AIR- STATE

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
PRE INTENT

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
PRE STATE

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
AIR+ INTENT

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
AIR+ STATE

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
DC LINK

time [s]

Figure 6.11.: TSAL simulation result. Test: Positive AIR

state detection broken wire.

TSAL Test

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
GREEN

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
VOLT-DETECTION

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
AIR- INTENT

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
AIR- STATE

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
PRE INTENT

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
PRE STATE

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
AIR+ INTENT

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
AIR+ STATE

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
DC LINK

time [s]

Figure 6.12.: TSAL HIL result. Test: Positive AIR state

detection broken wire.

TSAL Simulation

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
GREEN

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
VOLT-DETECTION

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
AIR- INTENT

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
AIR- STATE

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
PRE INTENT

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
PRE STATE

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
AIR+ INTENT

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
AIR+ STATE

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
DC LINK

time [s]

Figure 6.13.:

relay state detection broken wire.

TSAL simulation result. Test: Pre-charge

TSAL Test

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
GREEN

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
VOLT-DETECTION

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
AIR- INTENT

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
AIR- STATE

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
PRE INTENT

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
PRE STATE

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
AIR+ INTENT

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
AIR+ STATE

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
DC LINK

time [s]

Figure 6.14.:

state detection broken wire.

TSAL HIL result. Test: Pre-charge relay

TSAL Simulation

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
GREEN

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
VOLT-DETECTION

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
AIR- INTENT

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
AIR- STATE

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
PRE INTENT

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
PRE STATE

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
AIR+ INTENT

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
AIR+ STATE

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
DC LINK

time [s]

Figure 6.15.: TSAL simulation result. Test: Negative

AIR state detection broken wire.

TSAL Test

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
GREEN

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
VOLT-DETECTION

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
AIR- INTENT

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
AIR- STATE

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
PRE INTENT

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
PRE STATE

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
AIR+ INTENT

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
AIR+ STATE

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
DC LINK

time [s]

Figure 6.16.: TSAL HIL result. Test: Negative AIR state

detection broken wire.

# 7. Bibliography

[1] Formula Student Rules 2023, Formula Student Germany, 2023, Version 1.1. [Online]. Available: https://www.formulastudent.de/fileadmin/user_upload/all/2023/rules/FS-Rules_2023_v1.1.pdf [Accessed: 2023/03/19]
[2] J. | Munson, | “Low | Cost | isoSPI | Coupling | Circuitry | for | High | Voltage | High | Capac-
ity | Battery | Systems.” | [Online]. | Available: | https://www.analog.com/en/technical-articles/
low-cost-isospi-coupling-circuitry-for-high-voltage-high-capacity-battery-systems.html (https://www.analog.com/en/technical-articles/low-cost-isospi-coupling-circuitry-for-high-voltage-high-capacity-battery-systems.html) | [Accessed:
2023/03/19]
[3] Application Notes for EV/LEV Contactors, | TE | Connectivity, | 2013. | [Online]. | Avail-
able: | https://www.flamecorp.com/PDF/TE-Connectivity/Kilovac/Application%20Notes%20for%
20EV-LEC%20Contactors.pdf (https://www.flamecorp.com/PDF/TE-Connectivity/Kilovac/Application%20Notes%20for%20EV-LEC%20Contactors.pdf) [Accessed: 2023/03/19]
[4] LEV100H Extended Performance w/ Aux Contact Data Sheet, TE Connectivity, 2016. [Online]. Available: https://www.te.com/commerce/DocumentDelivery/DDEController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. pdf%7F1618408-2 (https://www.te.com/commerce/DocumentDelivery/DDEController?Action=showdoc) [Accessed: 2023/03/19]
[5] ISOMETER® | IR155-3203/IR155-3204. | Isolationsüberwachungsgerät | für | ungeerdete | DC-
Antriebssysteme (IT-Systeme) in Elektrofahrzeugen., BENDER, 2021, Version V004. [Online]. Available: https://www.bender.de/fileadmin/content/Products/d/d/IR155-32xx-V004_D00115_D_XXDE.pdf (https://www.bender.de/fileadmin/content/Products/d/d/IR155-32xx-V004_D00115_D_XXDE.pdf) [Accessed: 2022/09/23]
[6] EEPOWER, “Resistor Sizes and Packages .” [Online]. Available: https://eepower.com/resistor-guide/resistor-standards-and-codes/resistor-sizes-and-packages/ (https://eepower.com/resistor-guide/resistor-standards-and-codes/resistor-sizes-and-packages/) [Accessed: 2023/03/31]
[7] ITS4200S-ME-P. Smart High-Side NMOS-Power Switch, | Infineon, | 2012. | [Online]. | Avail-
able: | https://www.infineon.com/dgdl/Infineon-ITS4200S_ME_P_01092012S-DS-v01_00-en.pdf?
fileId=db3a304339dcf4b1013a0140684a5741 (https://www.infineon.com/dgdl/Infineon-ITS4200S_ME_P_01092012S-DS-v01_00-en.pdf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) [Accessed: 2023/03/26]
[8] SN74HCS08 Quadruple 2-Input AND Gates with Schmitt-Trigger Inputs, Texas Instruments, 2021. [Online]. Available: https://www.ti.com/lit/ds/symlink/sn74hcs08.pdf [Accessed: 2023/03/26]
[9] NXP, | “S32K144-Q100 | Evaluation | Board | for | Automotive | General | Purpose.” | [Online].
Available: | https://www.nxp.com/design/development-boards/automotive-development-platforms/
s32k-mcu-platforms/s32k144-q100-evaluation-board-for-automotive-general-purpose:S32K144EVB (https://www.nxp.com/design/development-boards/automotive-development-platforms/s32k-mcu-platforms/s32k144-q100-evaluation-board-for-automotive-general-purpose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) [Accessed: 2023/03/26]

# A. Schematics Revision A (Only for reference!)

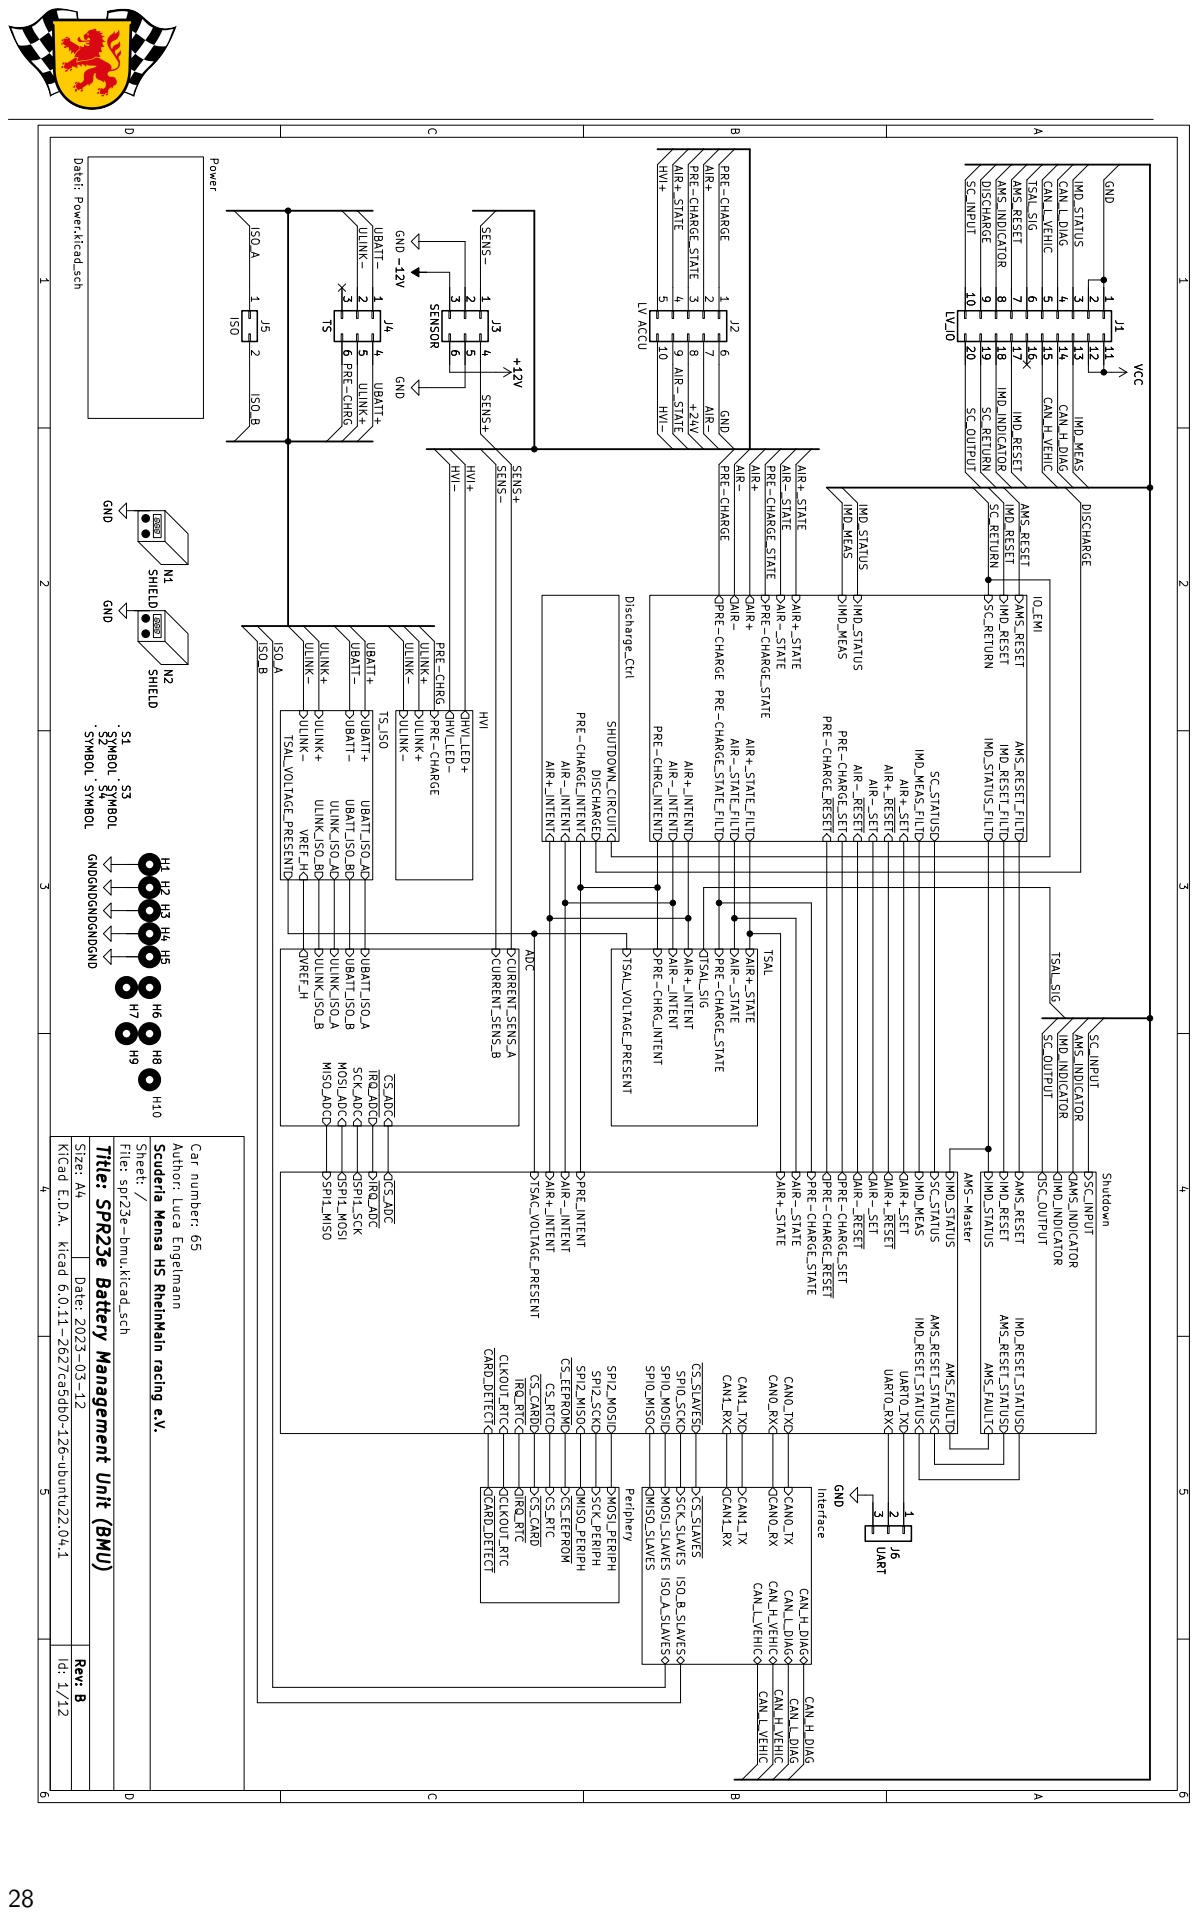
[picture p8: page 34]
TSAL_SIG; PRE-CHARGE_STATE; AIR-_STATE; AIR+_STATE; IMD_RESET AMS_RESET SC_OUTPUT SC_INPUT AMS_RESET_STATUS; IMD_RESET_STATUS; IMD_INDICATOR; AMS_INDICATOR; AMS_FAULT IMD_STATUS; Shutdown SHUTDOWN_CIRCUIT DISCHARGE; ISO_B_SLAVES; ~{CS_SLAVES} CAN_L_DIAG; CAN_H_DIAG; CAN_L_VEHIC; CAN_H_VEHIC MISO_SLAVES MOSI_SLAVES; SCK_SLAVES CAN1_RX CAN1_TX CAN0_RX CAN0_TX; Interface PRE-CHARGE_STATE; IMD_MEAS; IMD_STATUS; SC_RETURN; IMD_MEAS_FILT; IMD_STATUS_FILT SC_STATUS; PRE-CHARGE; AIR- AIR+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

TSAL Datei: Power Power.kicad_sch

PRE-CHARGE ULINK- ULINK+ UBATT+ PRE-CHARGE_STATE UBATT+

AIR- SENS+ AIR+ AIR+ SC_OUTPUT CAN_H_DIAG

ISO_B ULINK- UBATT- HVI- HVI+ AIR- ULINK+

LV ACCU GND

SENS+ ULINK+ PRE-CHRG

IMD_RESET PRE-CHARGE HVI- PRE-CHRG

PRE-CHARGE_INTENT AIR+_INTENT AIR-_INTENT Discharge_Ctrl ISO_A_SLAVES

IMD_RESET AMS_RESET PRE-CHRG_INTENT AIR-_INTENT AIR+_INTENT

N2 SYMBOL S3 SYMBOL S2SYMBOL S1 SYMBOL S4

AIR+_~{RESET} AIR-_SET AIR+_SET AIR-_~{RESET} PRE-CHARGE_SET PRE-CHARGE_~{RESET} AIR-_STATE_FILT AIR+_STATE_FILT PRE-CHARGE_STATE_FILT

Periphery ULINK- ULINK+ PRE-CHARGE HVI_LED- HVI_LED+ HVI ULINK_ISO_B ULINK_ISO_A

SYMBOL S3 H4 SYMBOL S2SYMBOL S1 GND GND

TSAL_VOLTAGE_PRESENT ULINK- UBATT_ISO_B UBATT_ISO_A ULINK+ UBATT- UBATT+ VREF_H

AMS-Master GND

TSAL_VOLTAGE_PRESENT PRE-CHRG_INTENT AIR-_INTENT AIR+_INTENT

A Date: 2023-03-12 KiCad E.D.A. kicad 6.0.11-2627ca5db0~126~ubuntu22.04.1 Rev: B Size: A4

Id: 1/12 Title: SPR23e Battery Management Unit (BMU) File: spr23e-bmu.kicad_sch Sheet: / Scuderia Mensa HS RheinMain racing e.V. Author: Luca Engelmann Car number: 65

PRE-CHARGE_~{RESET} PRE-CHARGE_SET AIR-_~{RESET} AIR-_SET AIR+_~{RESET} AIR+_SET

-> 10 mcd ideal: LED rt: 1 mA (1.2k) LED brgn: 5 mA (330R) LED Amber: 2 mA (680R) GND

LED gn: 20 mcd @ 1mA

LED rd: 20 mcd @ 2mA

LED brgn: 20 mcd @ 10mA

LED brgn: 3 mcd @ 2mA

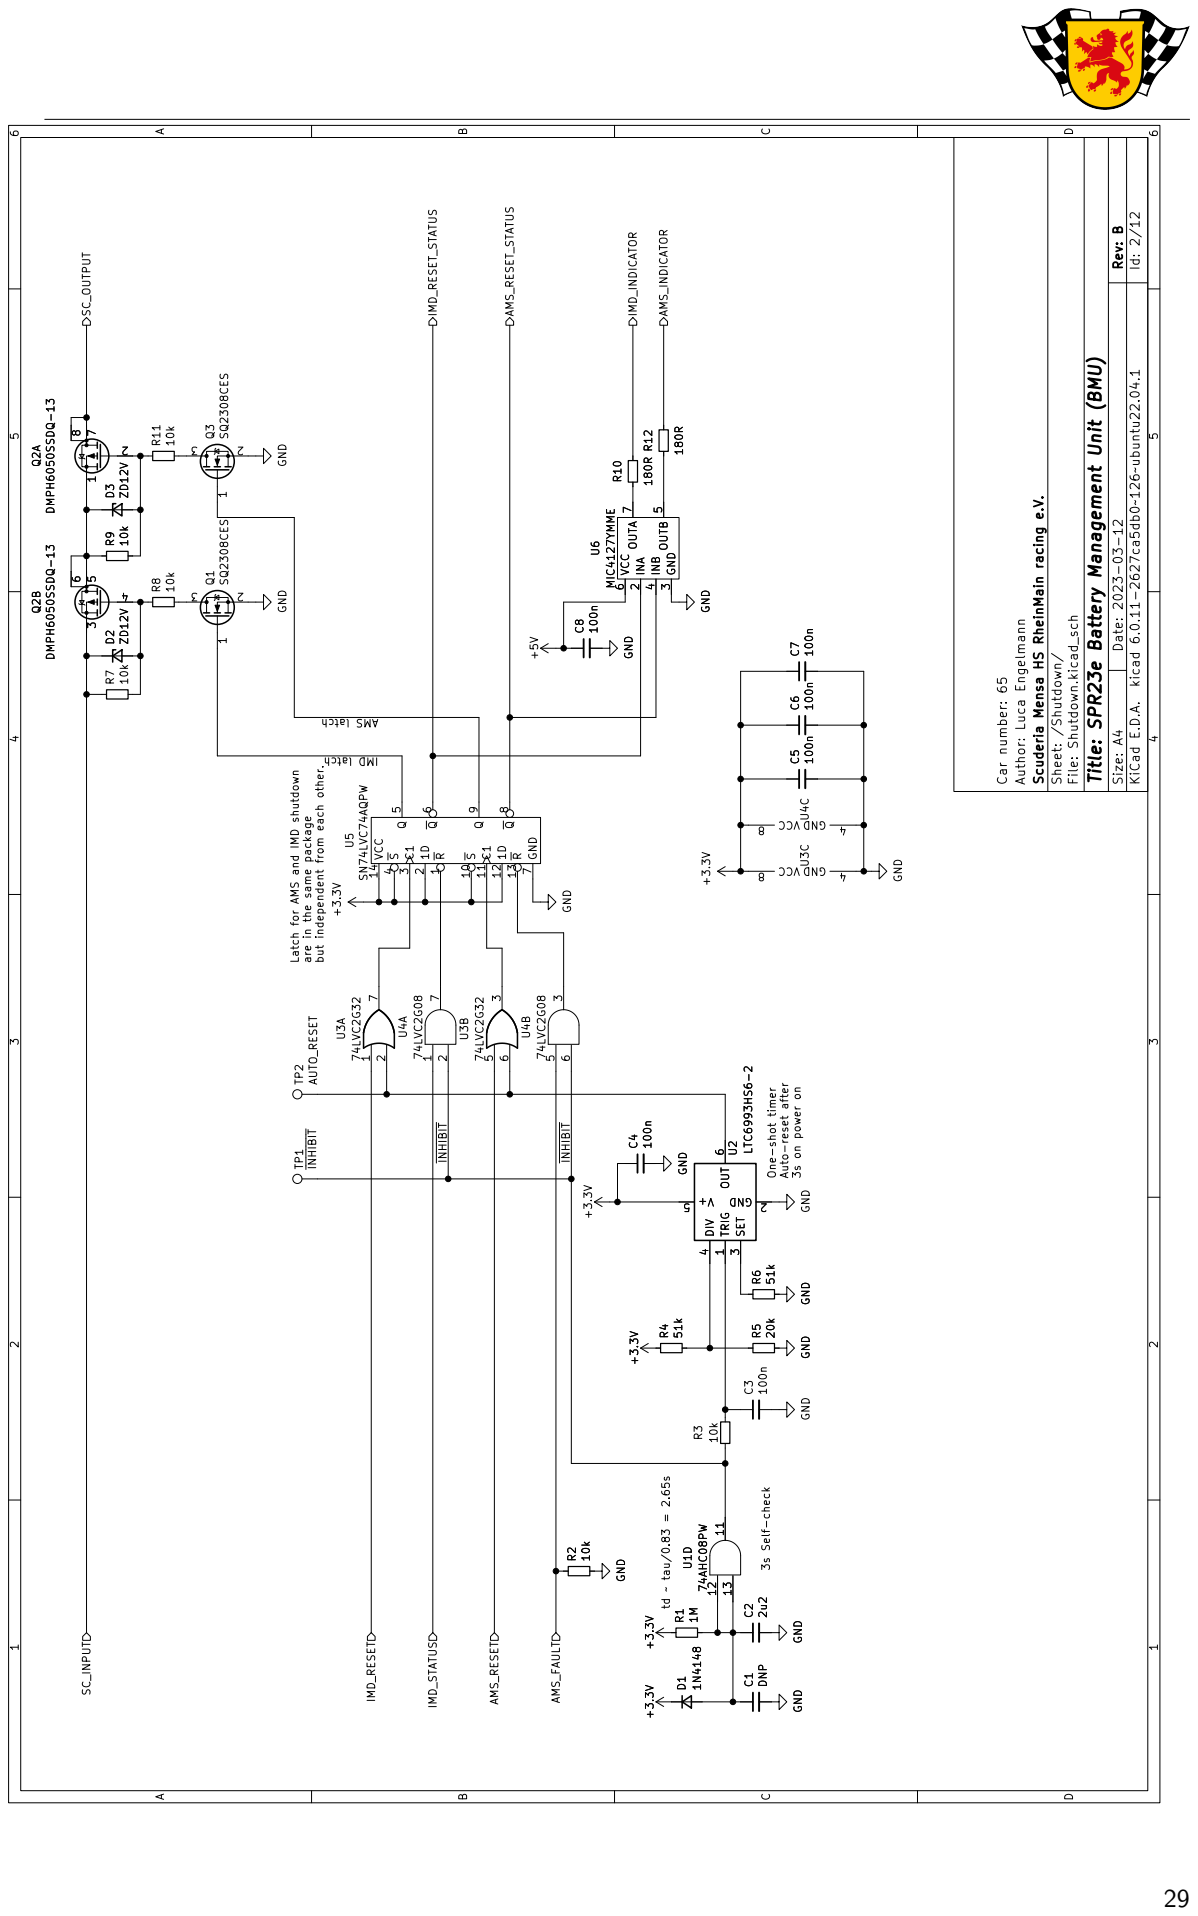
[picture p9: page 35]

D Date: 2023-03-12 KiCad E.D.A. kicad 6.0.11-2627ca5db0~126~ubuntu22.04.1 Rev: B Size: A4

Id: 2/12 Title: SPR23e Battery Management Unit (BMU) File: Shutdown.kicad_sch Sheet: /Shutdown/ Scuderia Mensa HS RheinMain racing e.V. Author: Luca Engelmann Car number: 65 GND GND

4 OUTB 5 VCC 6 OUTA 7 U6 MIC4127YMME GND

4 OUTB 5 VCC 6 OUTA 7 GND

but independent from each other. latch AMS One-shot timer Auto-reset after 3s on power on

td ~ tau/0.83 = 2.65s latch IMD

~{INHIBIT} Latch for AMS and IMD shutdown

are in the same package

1k C11

# 122 VSS 123 VDD ¹²⁴ PTE19

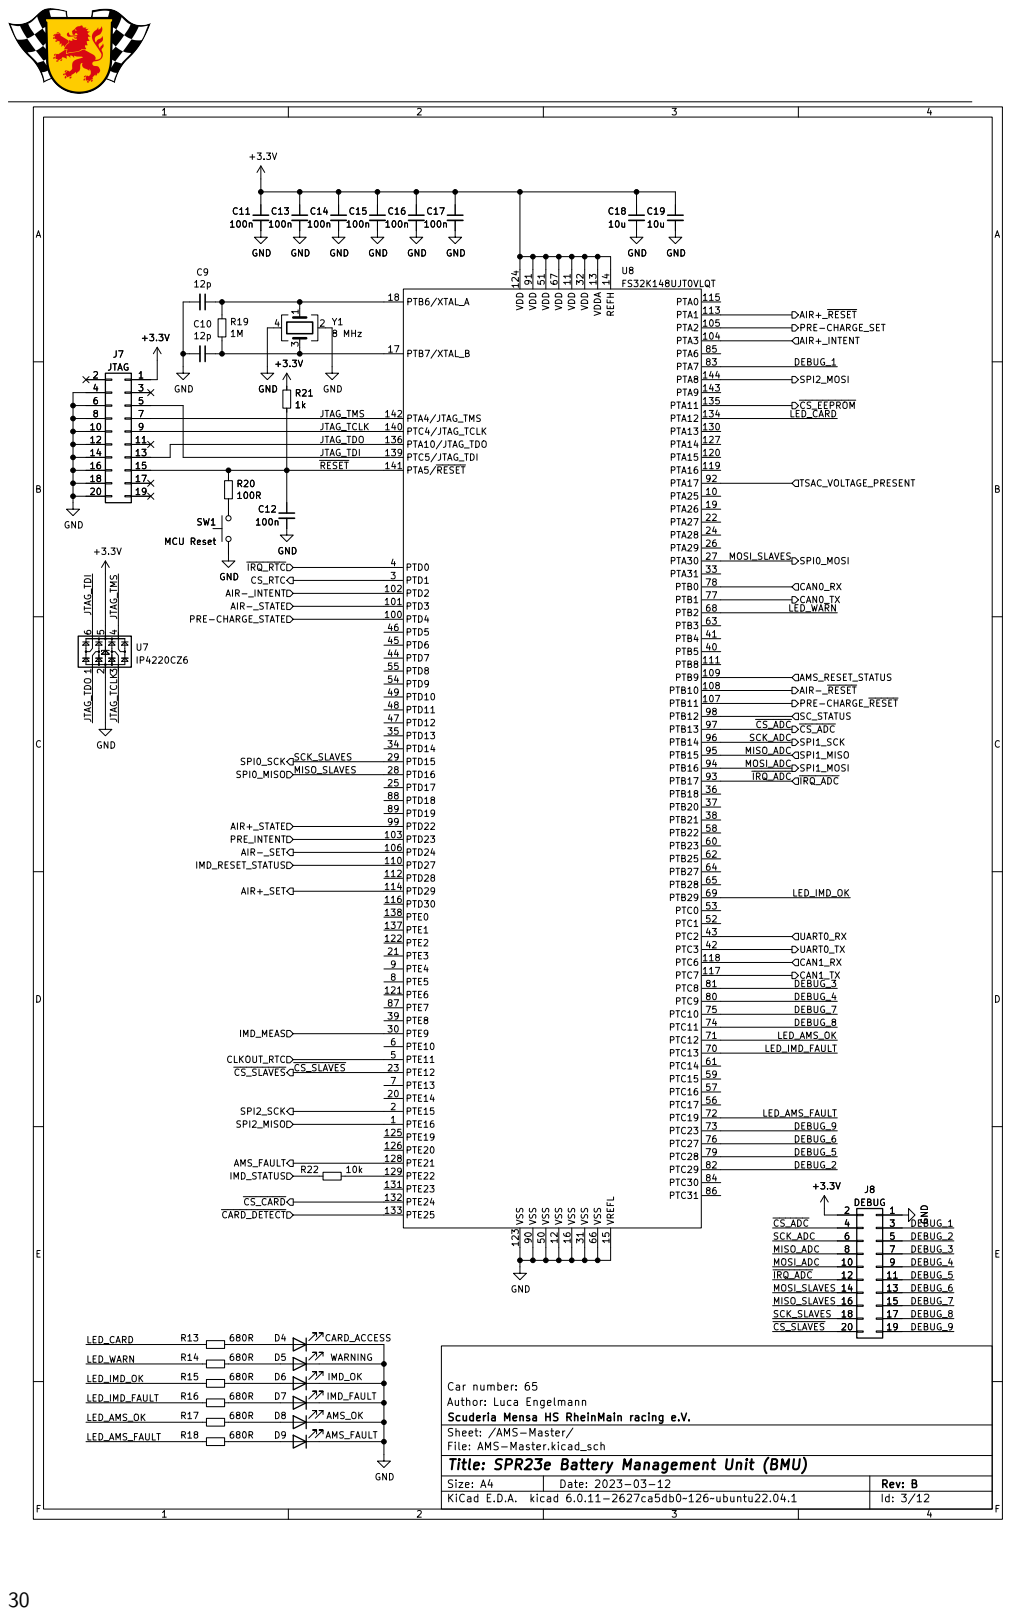
[picture p10: page 36]

Id: 3/12 Title: SPR23e Battery Management Unit (BMU) File: AMS-Master.kicad_sch Sheet: /AMS-Master/ Scuderia Mensa HS RheinMain racing e.V. Author: Luca Engelmann Car number: 65

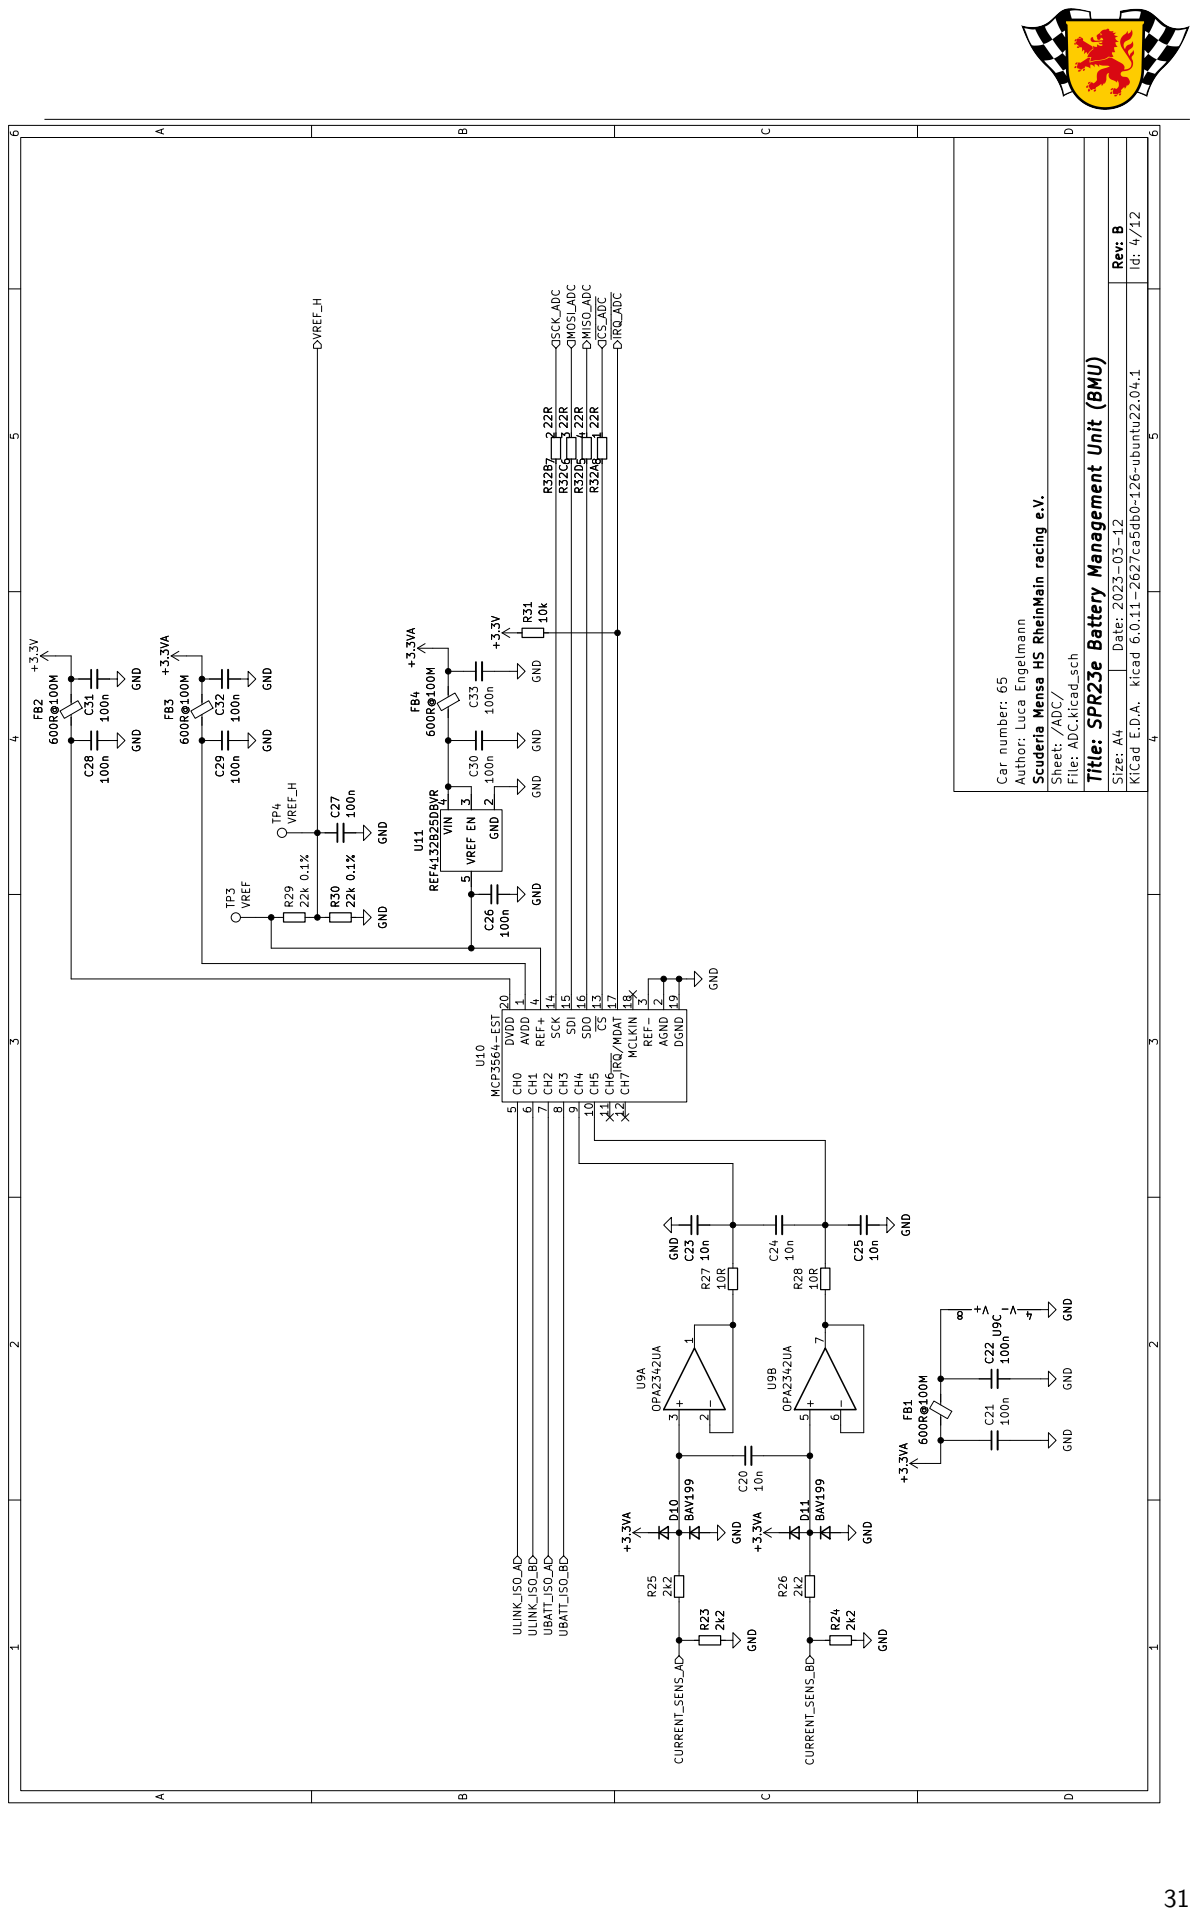
[picture p11: page 37]

D Date: 2023-03-12 KiCad E.D.A. kicad 6.0.11-2627ca5db0~126~ubuntu22.04.1 Rev: B Size: A4

Id: 4/12 Title: SPR23e Battery Management Unit (BMU) File: ADC.kicad_sch Sheet: /ADC/ Scuderia Mensa HS RheinMain racing e.V. Author: Luca Engelmann Car number: 65

10n GND GND GND GND

1 CH5 10 CH6 11 CH7 12 ~{CS}13 SCK 14 SDI 15 SDO 16 ~{IRQ}/MDAT17 MCLKIN 18 DGND 19 AGND 2 DVDD

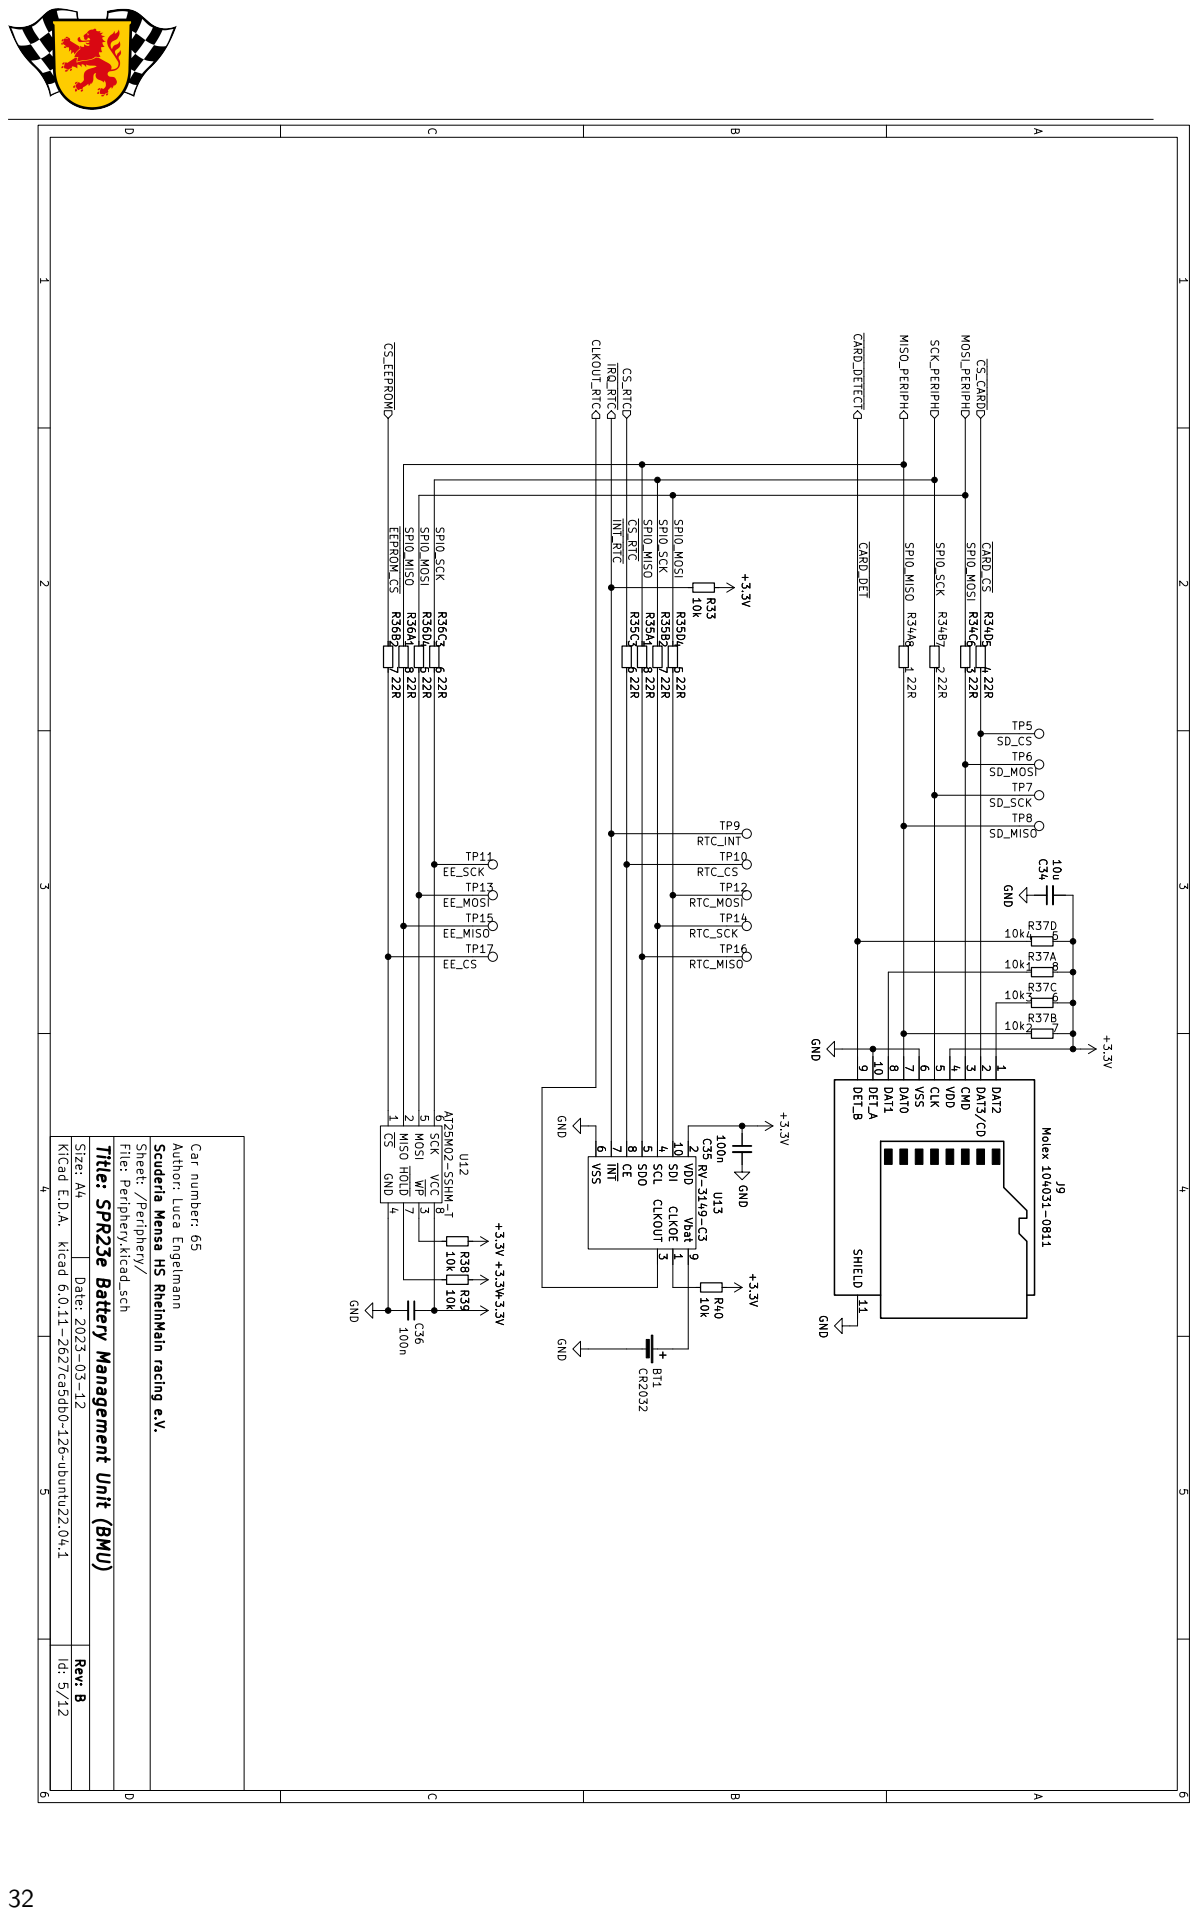
[picture p12: page 38]

2 CLKOUT 3 SCL 4 SDO 5 VSS 6 ~{INT} 7 CE 8 Vbat 9 GND

~{CS} 1 MISO 2 ~{WP}3 GND 4 MOSI 5 SCK 6 ~{HOLD}7 VCC 8 U12 AT25M02-SSHM-T TP16 RTC_MISO

10 SHIELD 11 DAT3/CD 2 CMD 3 VDD

2 CLKOUT 3 SCL 4 SDO 5 VSS 6 ~{INT} 7 CE 8 Vbat 9 U13 RV-3149-C3 GND

A Date: 2023-03-12 KiCad E.D.A. kicad 6.0.11-2627ca5db0~126~ubuntu22.04.1 Rev: B Size: A4

Id: 5/12 Title: SPR23e Battery Management Unit (BMU) File: Periphery.kicad_sch Sheet: /Periphery/ Scuderia Mensa HS RheinMain racing e.V. Author: Luca Engelmann Car number: 65

10k R38 +3.3V +3.3V U13 RV-3149-C3 CLKOE 1 SDI 10 VDD

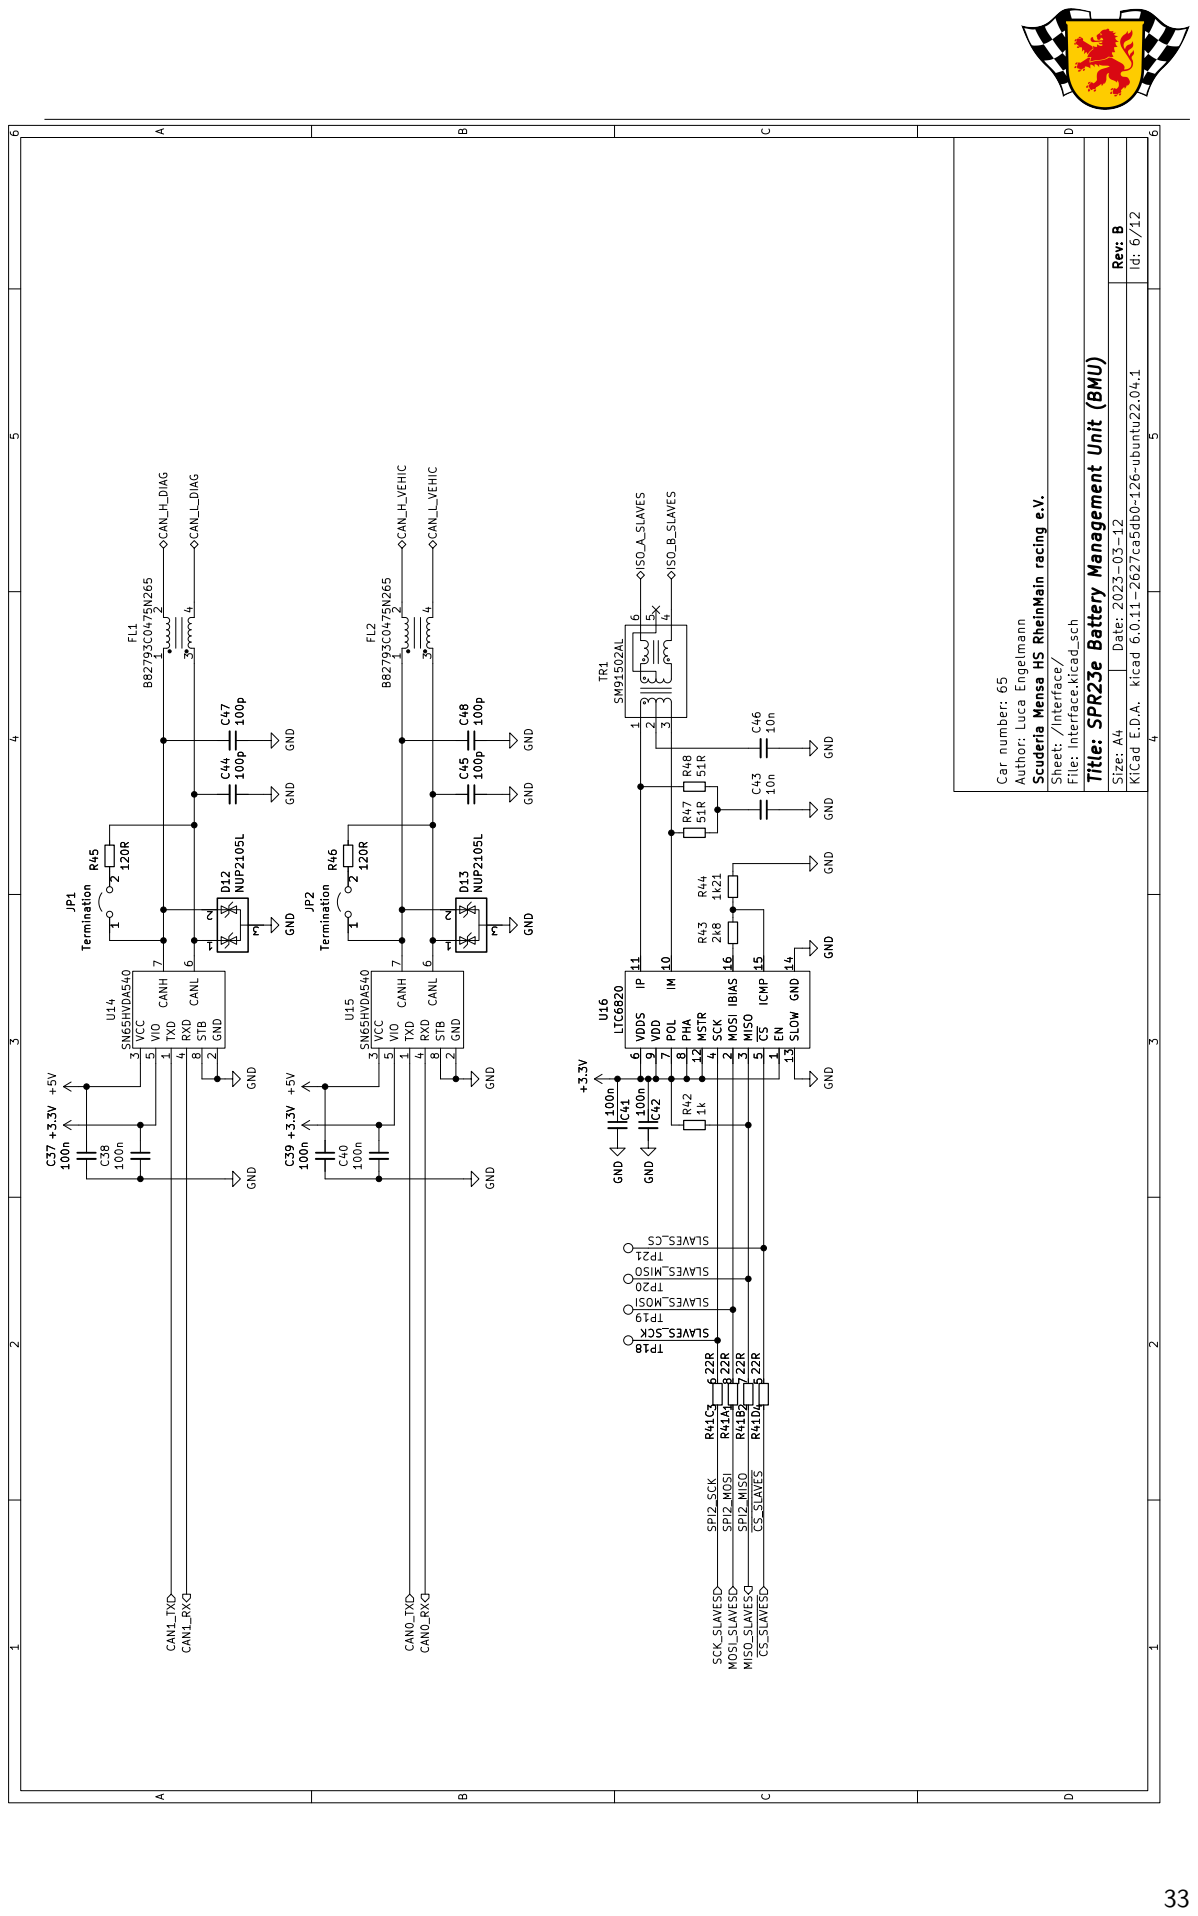
[picture p13: page 39]

D Date: 2023-03-12 KiCad E.D.A. kicad 6.0.11-2627ca5db0~126~ubuntu22.04.1 Rev: B Size: A4

Id: 6/12 Title: SPR23e Battery Management Unit (BMU) File: Interface.kicad_sch Sheet: /Interface/ Scuderia Mensa HS RheinMain racing e.V. Author: Luca Engelmann Car number: 65

100n GND GND GND GND

4 VIO 5 CANL 6 CANH 7 STB 8 U14 SN65HVDA540 C45

4 VIO 5 CANL 6 CANH 7 STB 8 U15 SN65HVDA540 C43

IBIAS 16 MOSI 2 MISO 3 SCK 4 ~{CS} 5 VDDS 6 POL 7 PHA

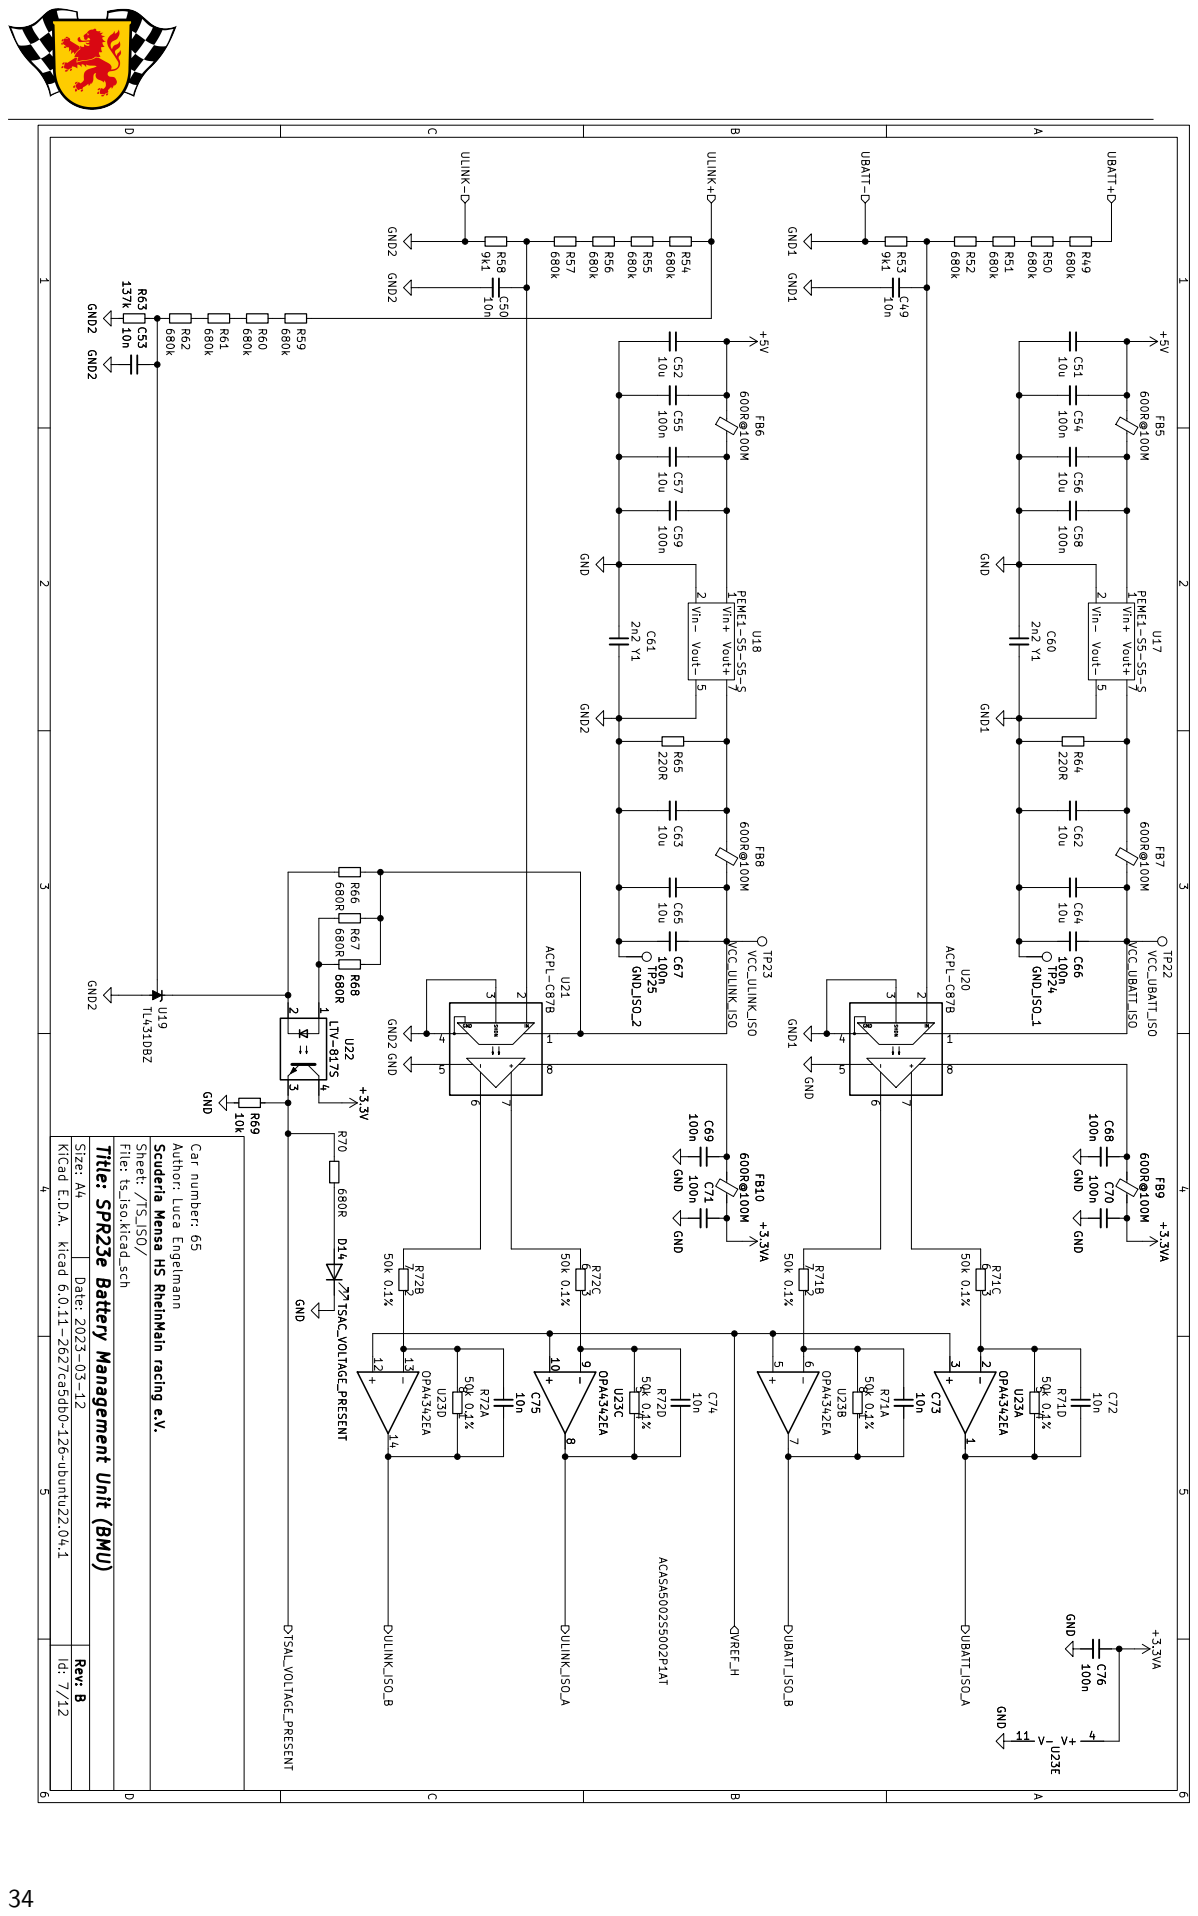
[picture p14: page 40]

Id: 7/12 Title: SPR23e Battery Management Unit (BMU) File: ts_iso.kicad_sch Sheet: /TS_ISO/ Scuderia Mensa HS RheinMain racing e.V. Author: Luca Engelmann Car number: 65 GND1 GND2

A Date: 2023-03-12 KiCad E.D.A. kicad 6.0.11-2627ca5db0~126~ubuntu22.04.1 Rev: B Size: A4

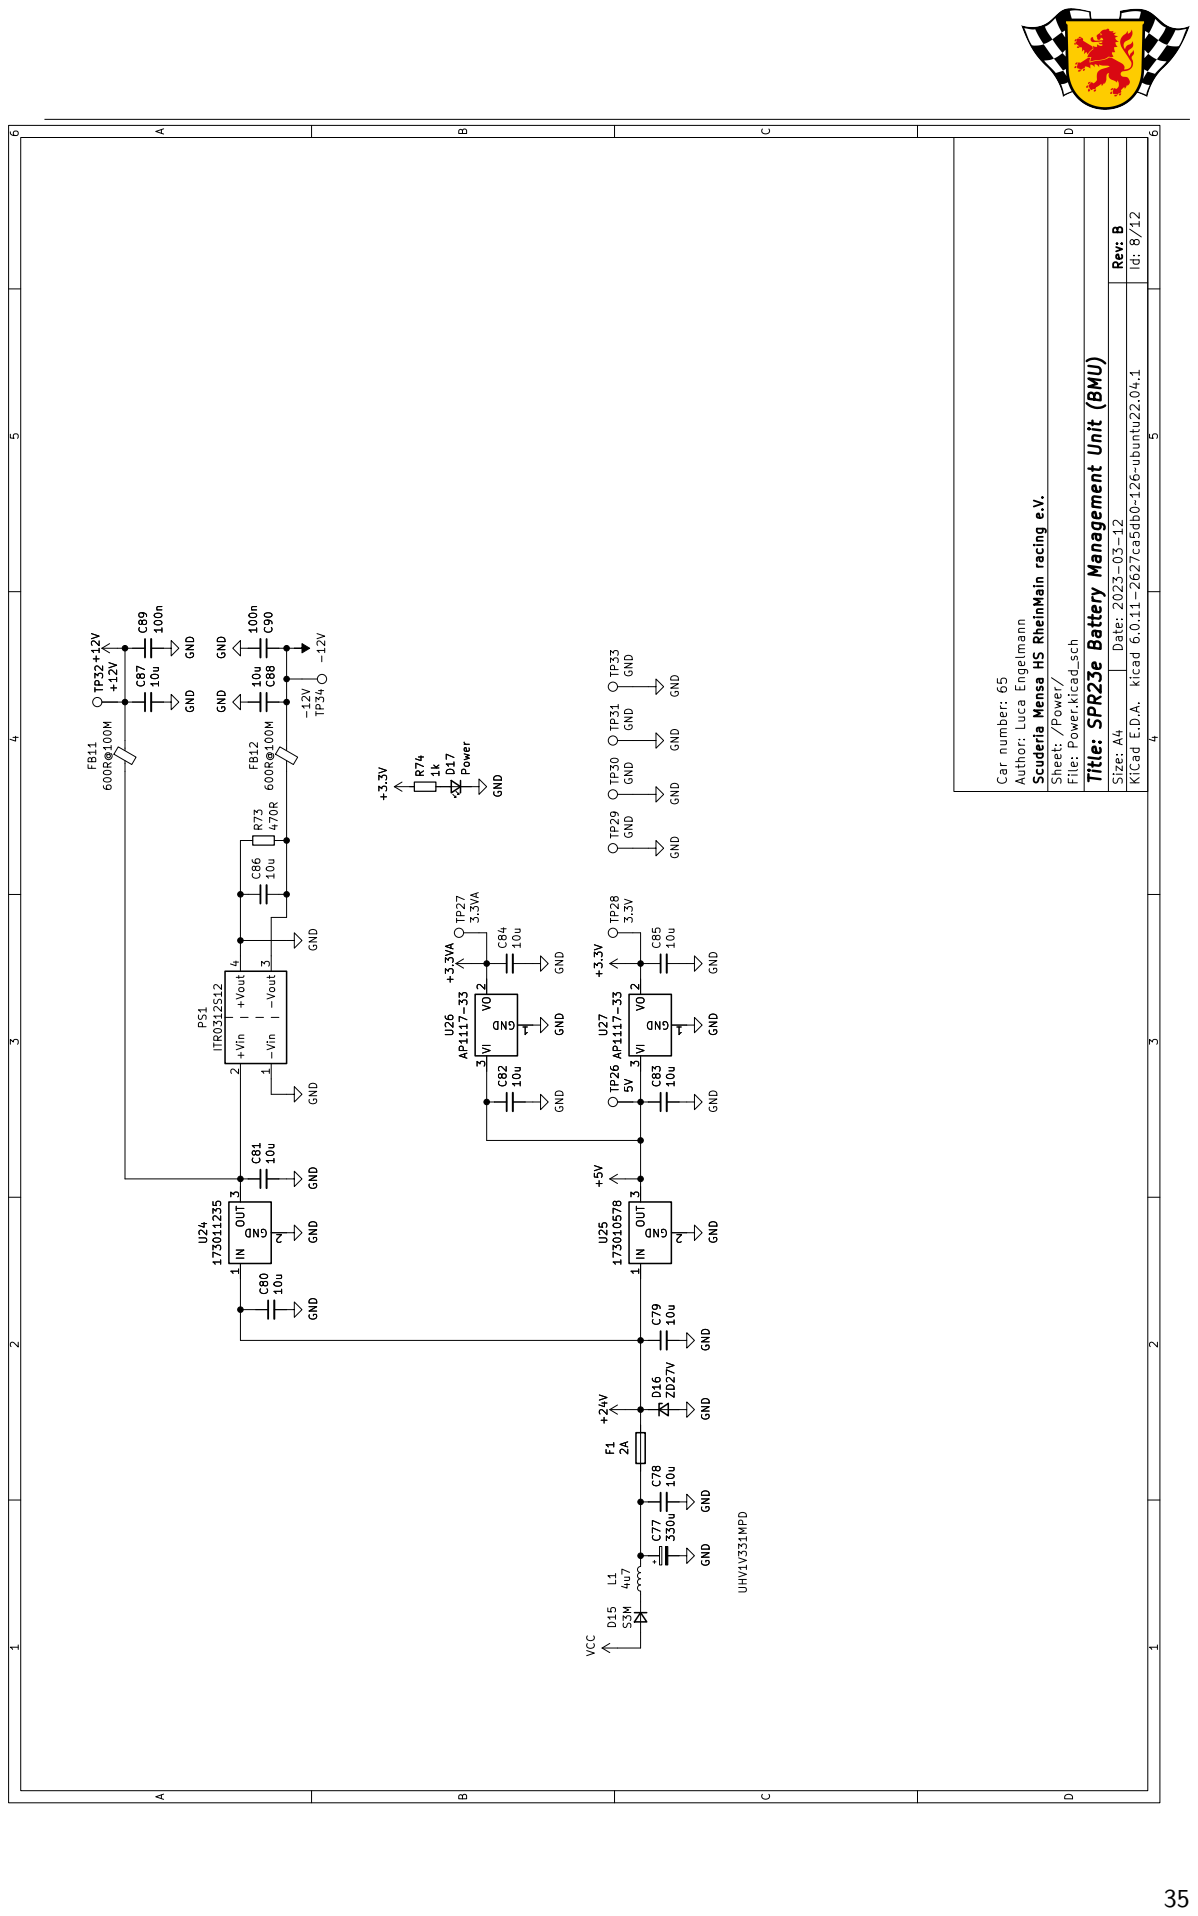
[picture p15: page 41]
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

Id: 8/12 Title: SPR23e Battery Management Unit (BMU) File: Power.kicad_sch Sheet: /Power/ Scuderia Mensa HS RheinMain racing e.V. Author: Luca Engelmann Car number: 65

10u GND GND GND GND

# GND VCC ¹⁴ GND

# 10k D22 ZD3V3 GND GND R91

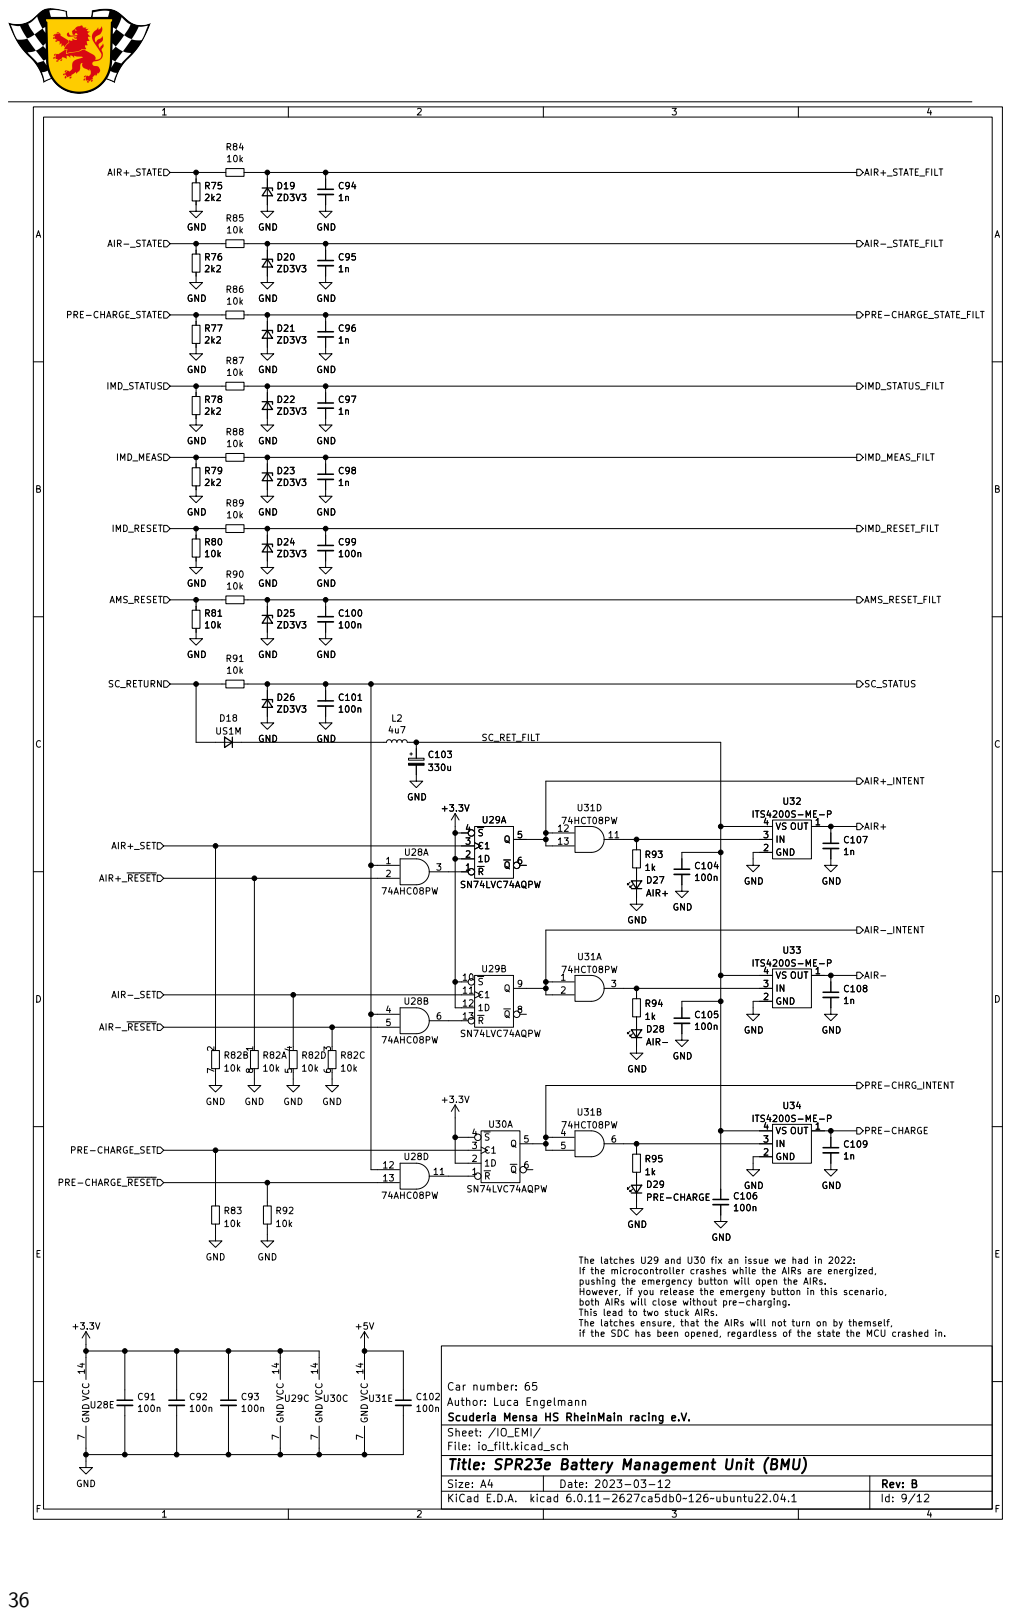
[picture p16: page 42]

The latches U29 and U30 fix an issue we had in 2022:
pushing the emergency button will open the AIRs. However, if you release the emergeny button in this scenario, both AIRs will close without pre-charging. This lead to two stuck AIRs. The latches ensure, that the AIRs will not turn on by themself,

Id: 9/12 Title: SPR23e Battery Management Unit (BMU) File: io_filt.kicad_sch Sheet: /IO_EMI/ Scuderia Mensa HS RheinMain racing e.V. Author: Luca Engelmann Car number: 65

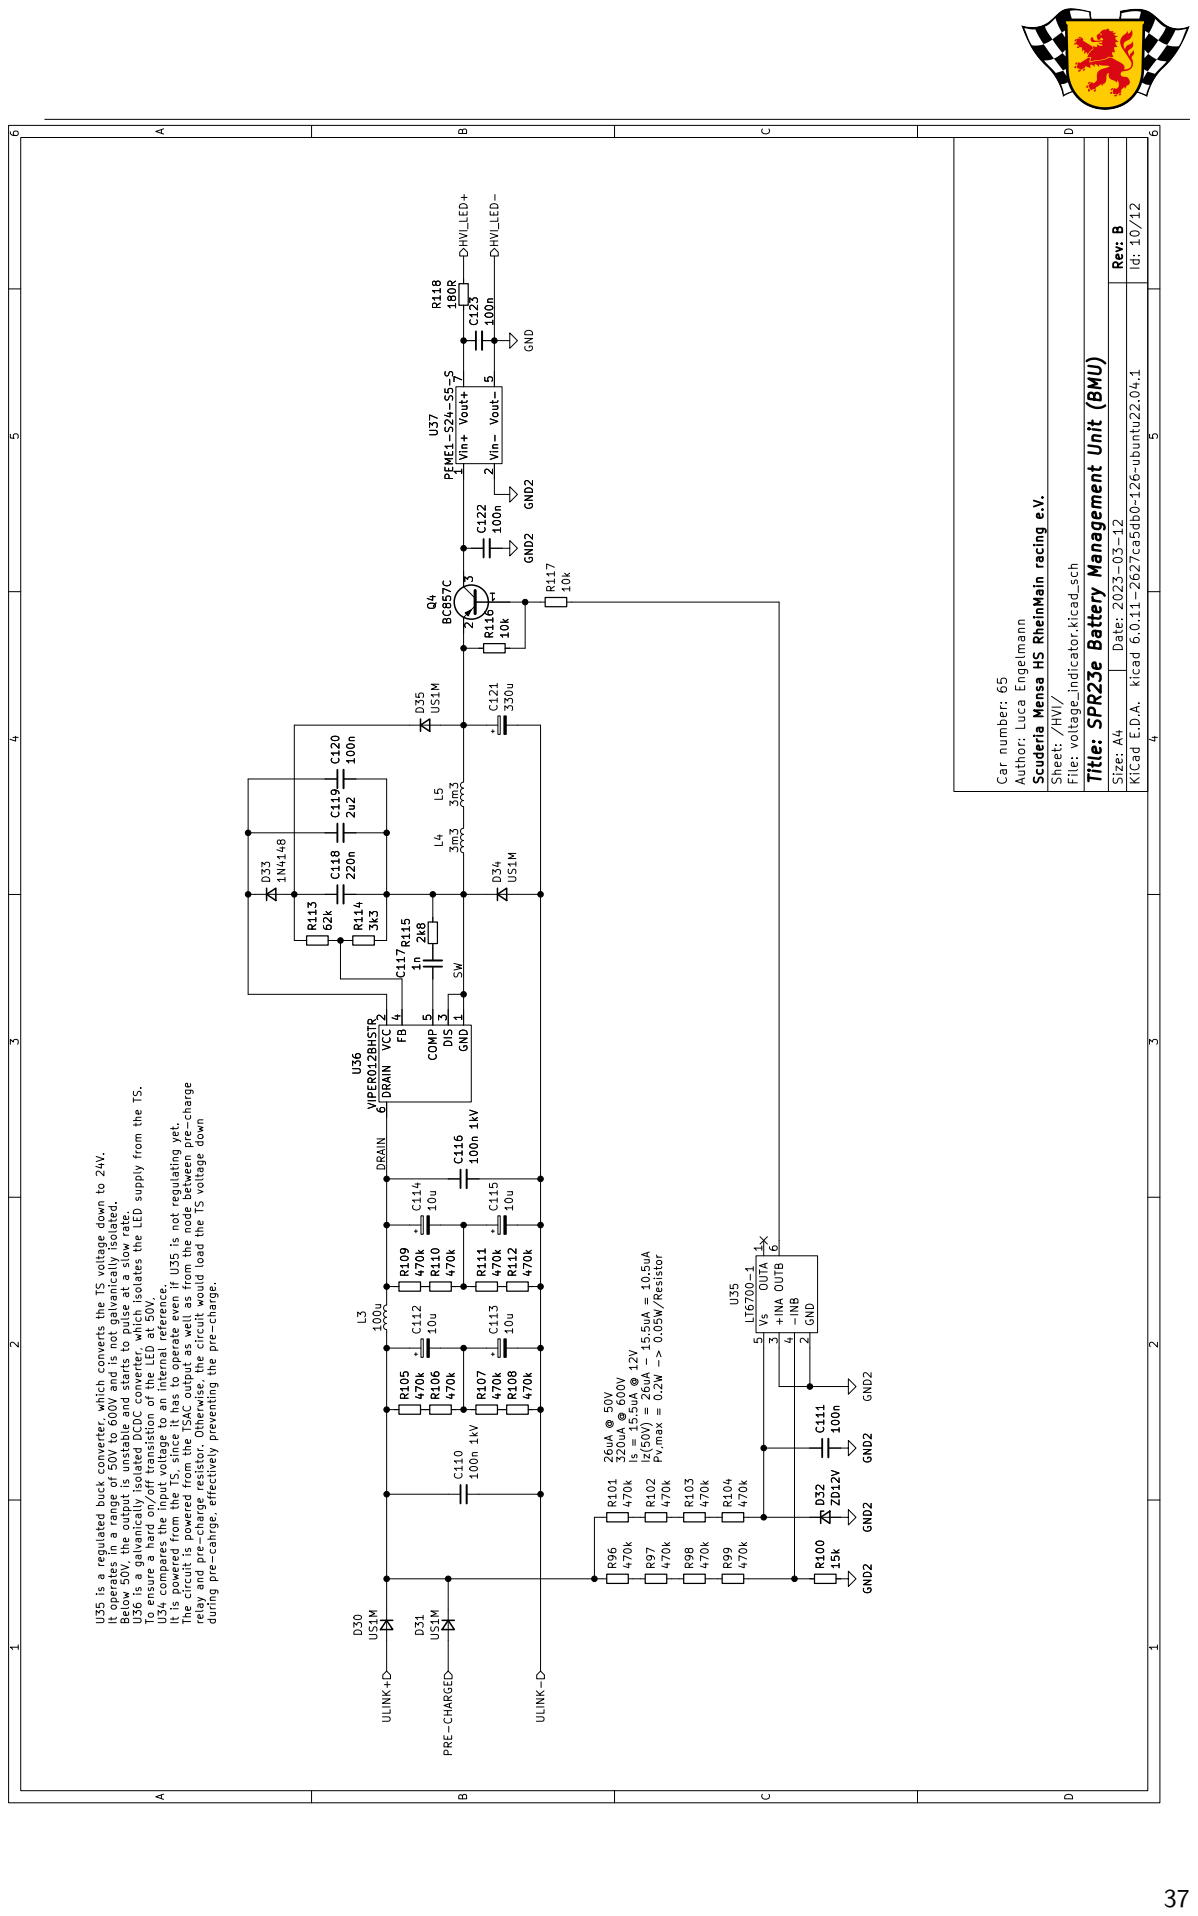
[picture p17: page 43]
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

10k ULINK+ PRE-CHARGE ULINK- HVI_LED+ HVI_LED- DRAIN

Id: 10/12 Title: SPR23e Battery Management Unit (BMU) File: voltage_indicator.kicad_sch Sheet: /HVI/ Scuderia Mensa HS RheinMain racing e.V. Author: Luca Engelmann Car number: 65 R108

2 3 U36 VIPER012BHSTR GND 1 VCC 2 DIS 3 FB

100n 1kV GND 1 VCC 2 DIS 3 FB

It operates in a range of 50V to 600V and is not galvanically isolated. Below 50V, the output is unstable and starts to pulse at a slow rate. U36 is a galvanically isolated DCDC converter, which isolates the LED supply from the TS. To ensure a hard on/off transistion of the LED at 50V, U34 compares the input voltage to an internal reference.

It is powered from the TS, since it has to operate even if U35 is not regulating yet. The circuit is powered from the TSAC output as well as from the node between pre-charge

relay and pre-charge resistor. Otherwise, the circuit would load the TS voltage down

U35 is a regulated buck converter, which converts the TS voltage down to 24V.

during pre-cahrge, effectively preventing the pre-charge. 26uA @ 50V

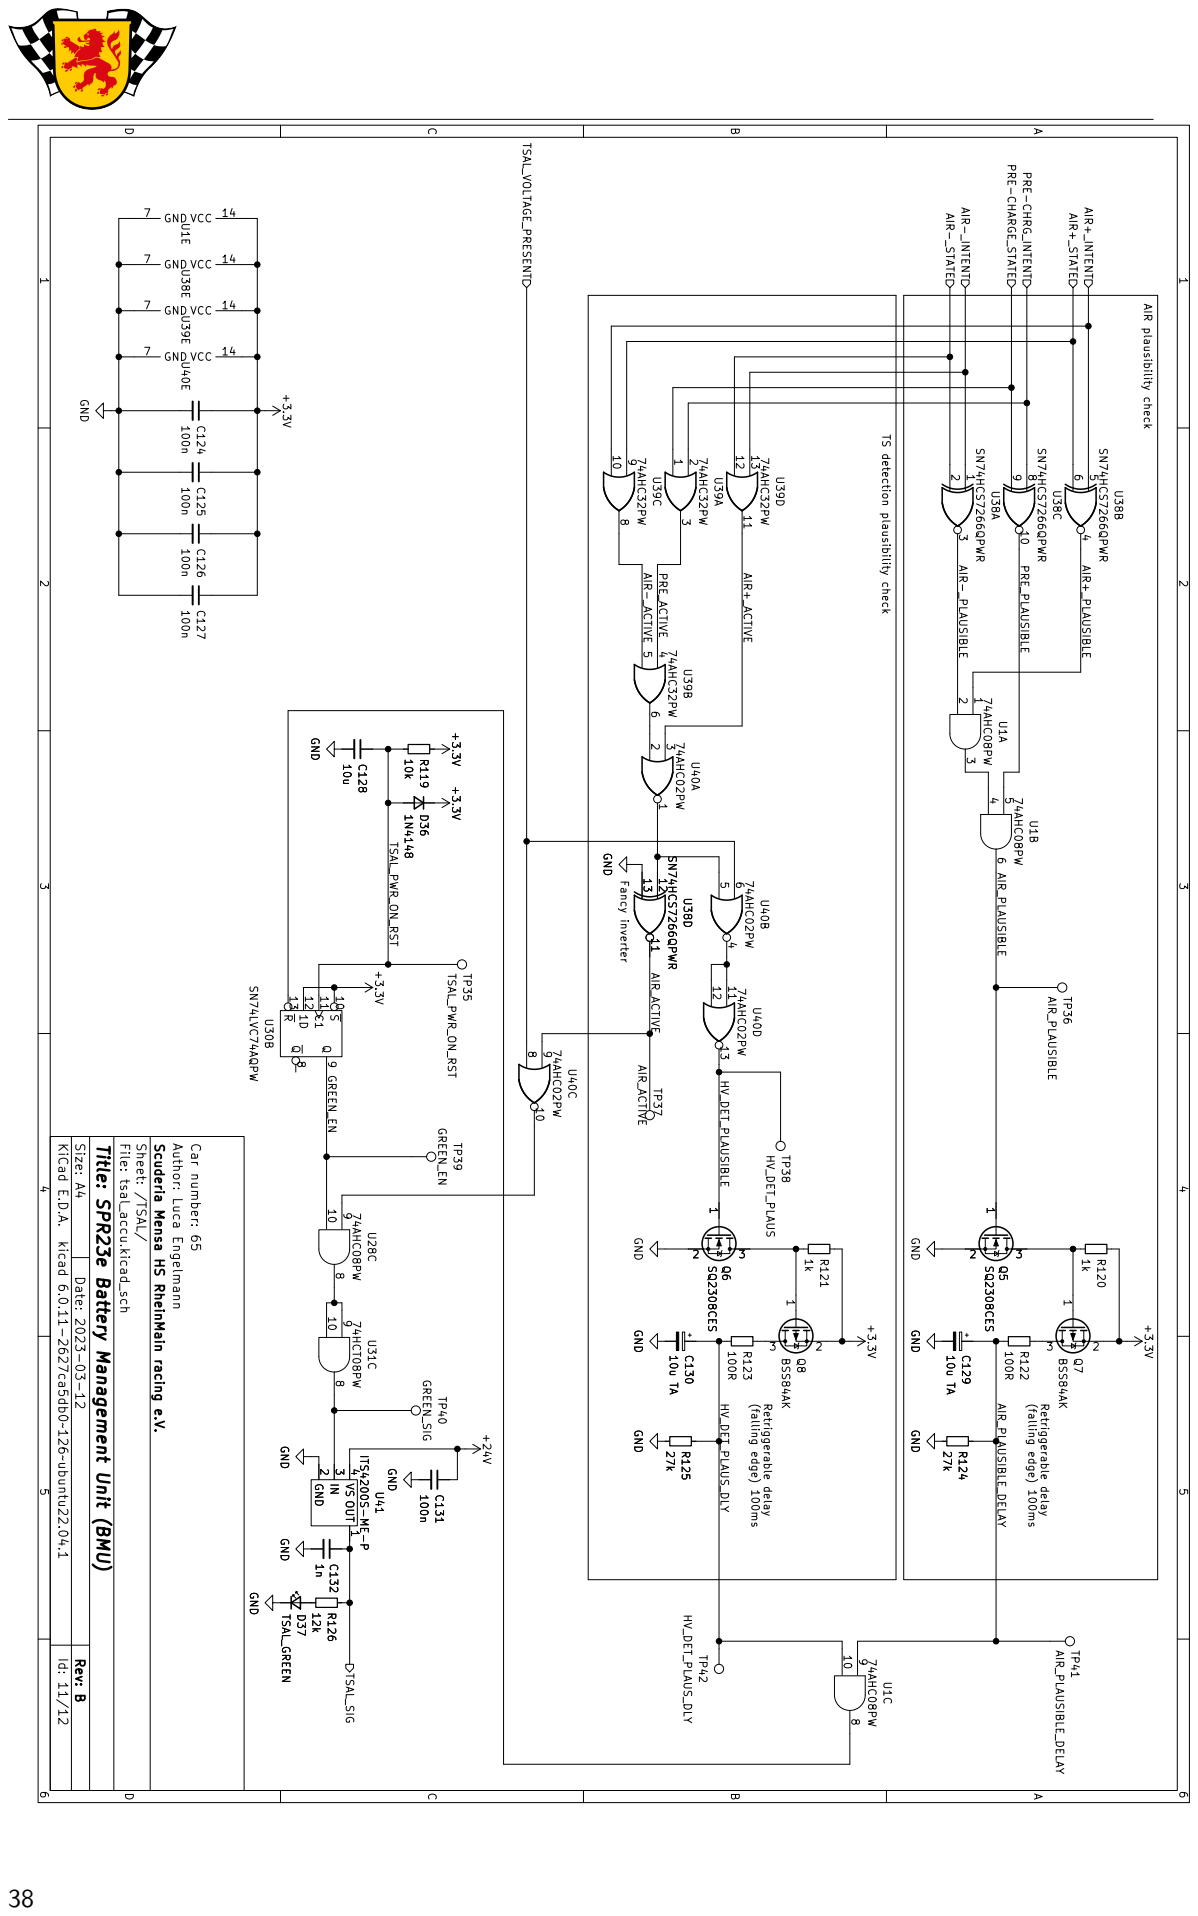
[picture p18: page 44]

TS detection plausibility check AIR plausibility check Fancy inverter Retriggerable delay

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

Id: 11/12 Title: SPR23e Battery Management Unit (BMU) File: tsal_accu.kicad_sch Sheet: /TSAL/ Scuderia Mensa HS RheinMain racing e.V. Author: Luca Engelmann Car number: 65

(falling edge) 100ms Retriggerable delay

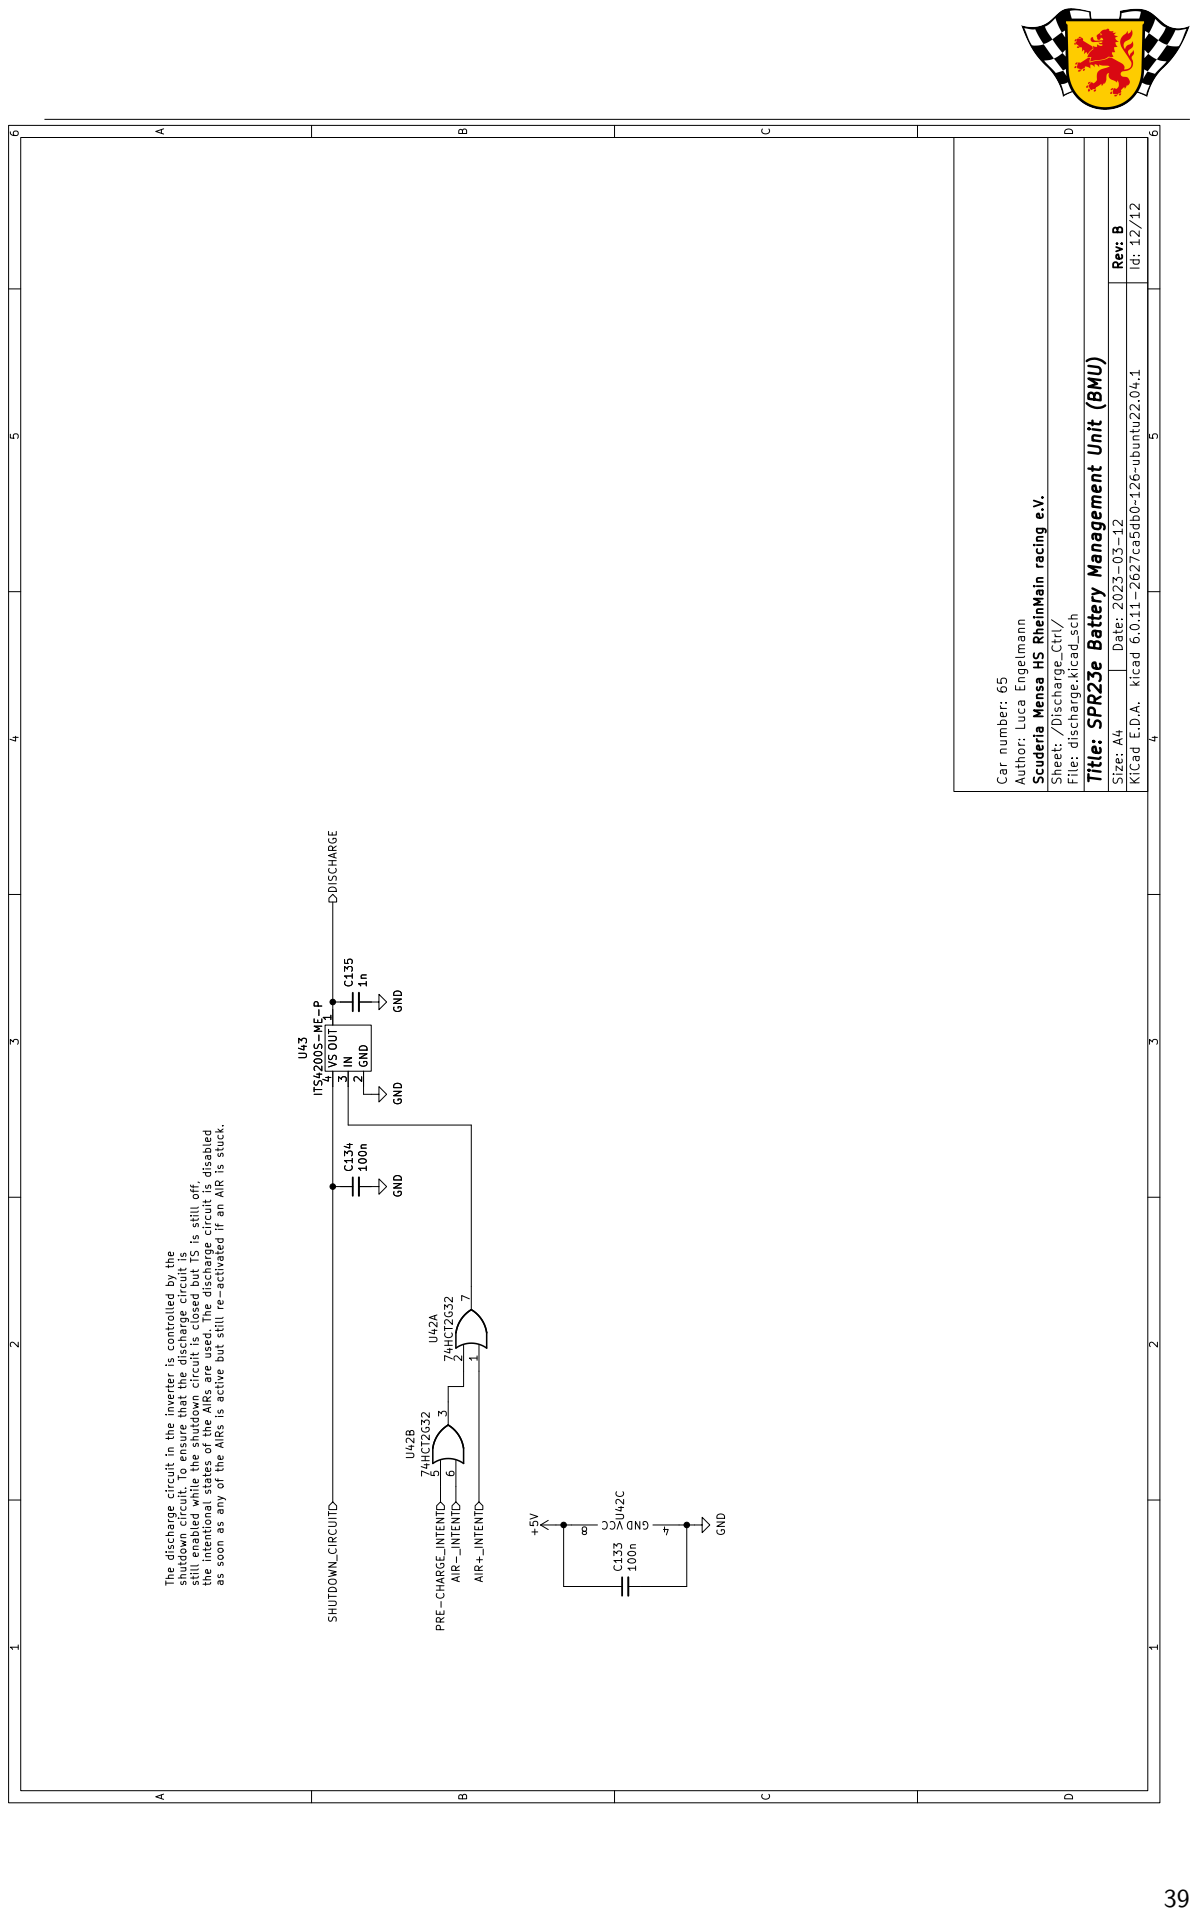
[picture p19: page 45]
OUT 1 GND 2; ITS4200S-ME-P C135; 1n GND; 74HCT2G32; 74HCT2G32 GND GND; +5V GND; 100n GND; DISCHARGE; 3 VS 4 GND

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

Id: 12/12 Title: SPR23e Battery Management Unit (BMU) File: discharge.kicad_sch Sheet: /Discharge_Ctrl/ Scuderia Mensa HS RheinMain racing e.V. Author: Luca Engelmann Car number: 65

as soon as any of the AIRs is active but still re-activated if an AIR is stuck. GND

ITS4200S-ME-P OUT 1 GND 2

the intentional states of the AIRs are used. The discharge circuit is disabled

still enabled while the shutdown circuit is closed but TS is still off,

The discharge circuit in the inverter is controlled by the

shutdown circuit. To ensure that the discharge circuit is

PRE-CHARGE_INTENT SHUTDOWN_CIRCUIT AIR-_INTENT AIR+_INTENT

# B. Changelog Revision B

- Corrected pinout of 74xx08
- Corrected pinout of 74xx2G08
- Corrected pinout of 74xx32
- Corrected pinout of 74xx2G32
- 74AHC08PW has no "real" Schmitt trigger inputs. Replaced by SN74HCS08.
- Removed ±12 V power supplies from the BMU to clear out some space. It is only needed for the current sensor. Therefore it has been moved to the sensor PCB.
- Different comparator circuit for the voltage indicator for a sharp transition between on and off.
- Added minimum load for the isolated DCDC converters
- Increased the resistance value of the zener diode current limiting resistors at the inputs.
- Added test points for VREF, VREF_H and the outputs of the isolated DCDC converters.
- Increased the power-on-reset time for the TSAL latch
- Added ESD and overvoltage protection for the current sensor inputs
- Corrected the footprints of the electrolytic capacitors
- Corrected the footprints of the EMI suppression capacitors
- Corrected the control of the indicator LEDs. The LEDs must light up, if the power stage is disabled.
- Added pull-down resistor for the AMS fault signal
- Added a diode between SC_RET_FILT and SC_RETURN to decouple the high power signal from the low power signal.
- Typos corrected
- Changed reverse polarity protection diode for a higher current type
- Changed LED dropper resistors for equalized brightness
- Changed shutdown circuit auto-reset time to 3 s since IMD takes up to two seconds to power up.
- Only one power LED at the 3.3 V rail
- Reduced the delay time for the AIR plausibility to 100 ms to reduce BOM. 100 ms is sufficient.

# C. Schematics Revision B

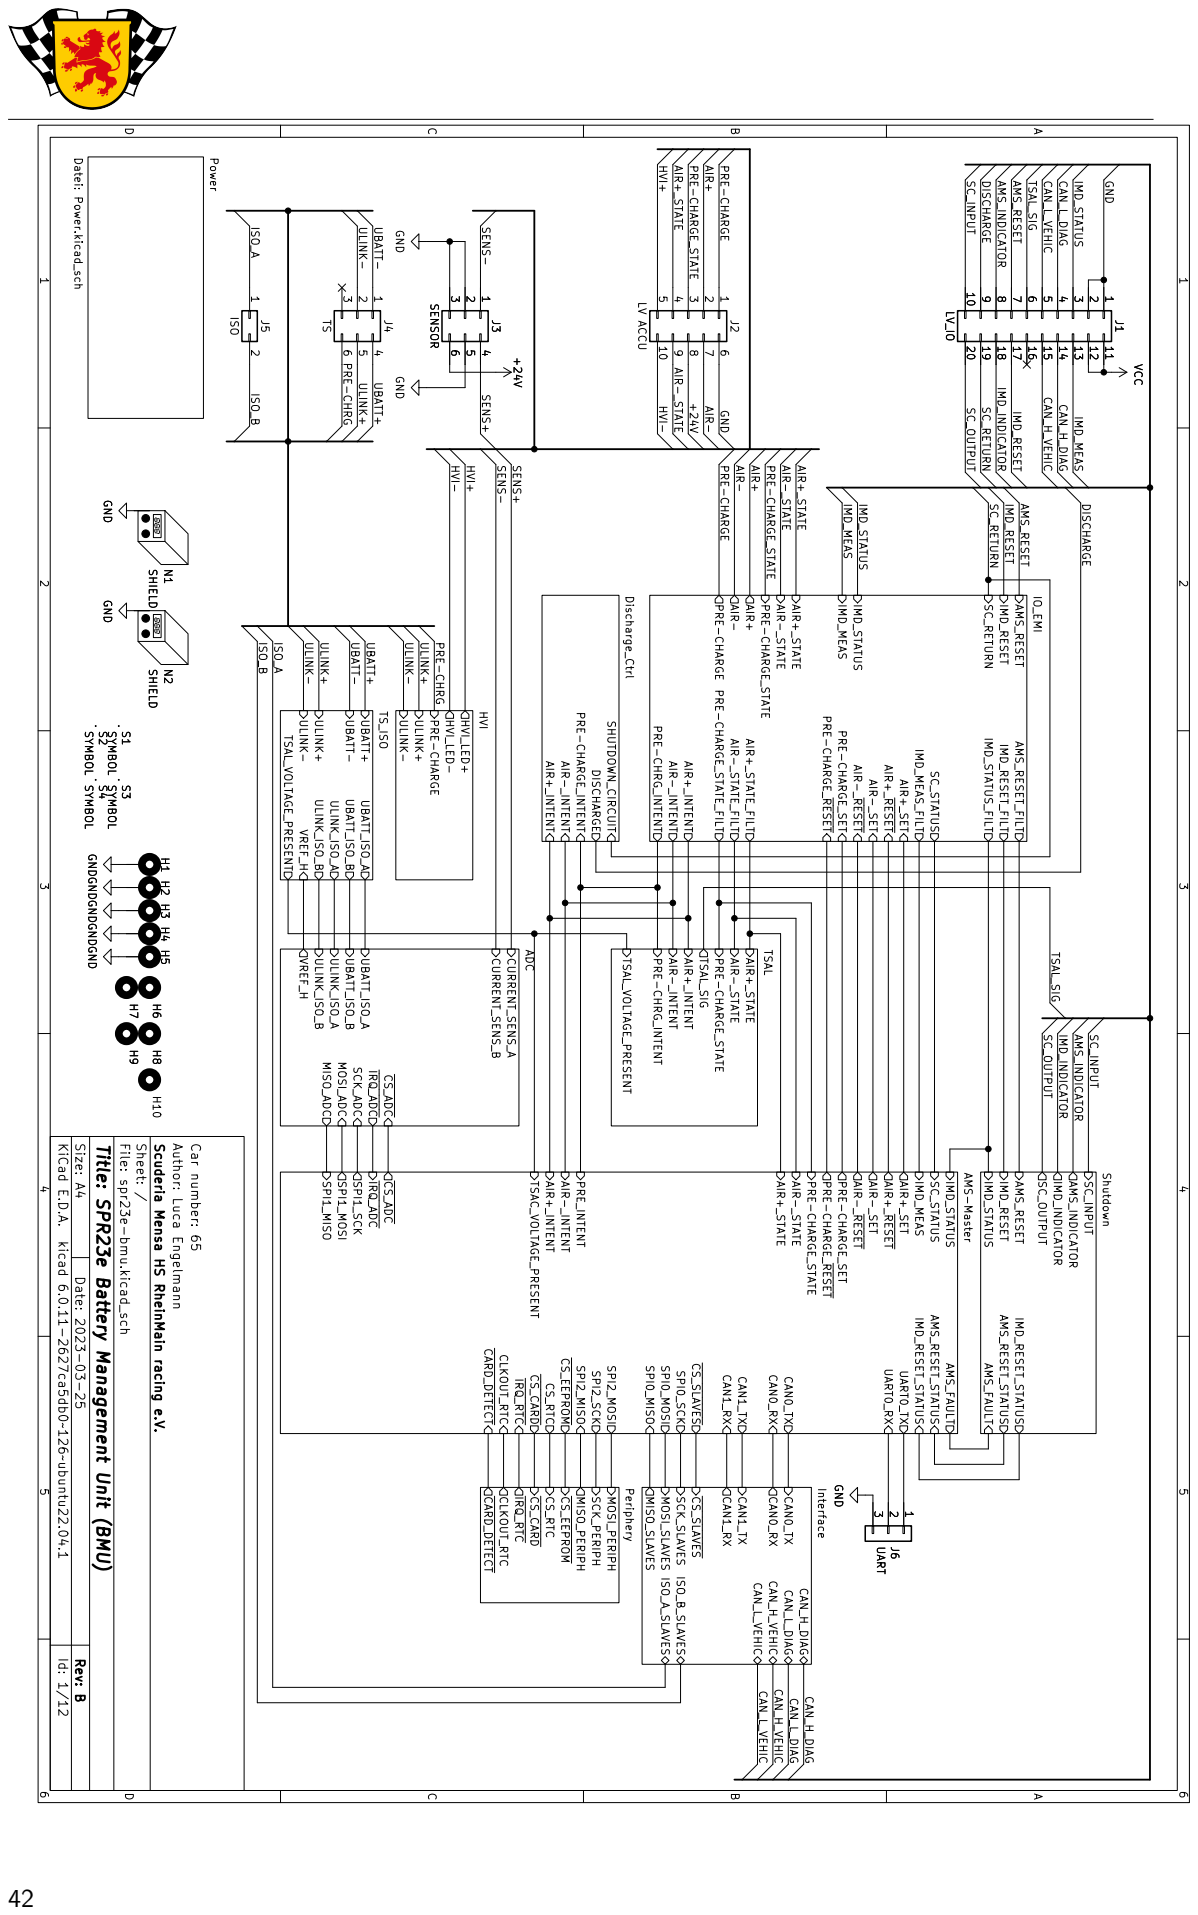
[picture p20: page 48]
IMD_RESET AMS_RESET SC_OUTPUT SC_INPUT AMS_RESET_STATUS; IMD_RESET_STATUS; IMD_INDICATOR; AMS_INDICATOR; AMS_FAULT IMD_STATUS; TS_ISO; TSAL_SIG; PRE-CHARGE_STATE; AIR-_STATE; AIR+_STATE; TSAL SHUTDOWN_CIRCUIT DISCHARGE; ~{CS_ADC}; ~{IRQ_ADC} ULINK_ISO_B ULINK_ISO_A UBATT_ISO_B UBATT_ISO_A CURRENT_SENS_B CURRENT_SENS_A; SCK_ADC; VREF_H; ADC; ~{CARD_DETECT} CLKOUT_RTC; ~{IRQ_RTC}; ~{CS_CARD} CS_RTC; ~{CS_EEPROM} MISO_PERIPH; SCK_PERIPH MOSI_PERIPH; Periphery; ISO_A_SLAVES; ISO_B_SLAVES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

Datei: Power Power.kicad_sch

AMS_RESET AMS_INDICATOR DISCHARGE ULINK+ HVI- ULINK- DISCHARGE

AIR+ PRE-CHARGE

ISO_A ULINK- UBATT- SENS- SENS+ SC_OUTPUT

SENS+ SENS- UBATT- ULINK+ AIR-_STATE UBATT+ UBATT+

J4 H8 SYMBOL S1 SYMBOL S4 H7 H6 SYMBOL S3 SYMBOL S2 GND

ISO_B ULINK- PRE-CHARGE

AIR- AIR+ PRE-CHARGE_STATE

H9 H8 H7 H6 SYMBOL S4SYMBOL S3 SYMBOL S2SYMBOL S1 SHIELD

PRE-CHARGE_INTENT AIR+_INTENT AIR-_INTENT Discharge_Ctrl MISO_ADC MOSI_ADC

IMD_RESET AMS_RESET PRE-CHRG_INTENT AIR-_INTENT AIR+_INTENT

AMS-Master PRE-CHARGE_STATE

AIR+_~{RESET} AIR-_SET AIR+_SET AIR-_~{RESET} PRE-CHARGE_SET PRE-CHARGE_~{RESET} AIR-_STATE_FILT AIR+_STATE_FILT PRE-CHARGE_STATE_FILT

Shutdown ULINK- ULINK+ PRE-CHARGE HVI_LED- HVI_LED+ HVI ULINK_ISO_B ULINK_ISO_A

TSAL_VOLTAGE_PRESENT ULINK- UBATT_ISO_B UBATT_ISO_A ULINK+ UBATT- UBATT+ VREF_H

TSAL_VOLTAGE_PRESENT PRE-CHRG_INTENT AIR-_INTENT AIR+_INTENT

A Date: 2023-03-25 KiCad E.D.A. kicad 6.0.11-2627ca5db0~126~ubuntu22.04.1 Rev: B Size: A4

Id: 1/12 Title: SPR23e Battery Management Unit (BMU) File: spr23e-bmu.kicad_sch Sheet: / Scuderia Mensa HS RheinMain racing e.V. Author: Luca Engelmann Car number: 65

PRE-CHARGE_~{RESET} PRE-CHARGE_SET AIR-_~{RESET} AIR-_SET AIR+_~{RESET} AIR+_SET

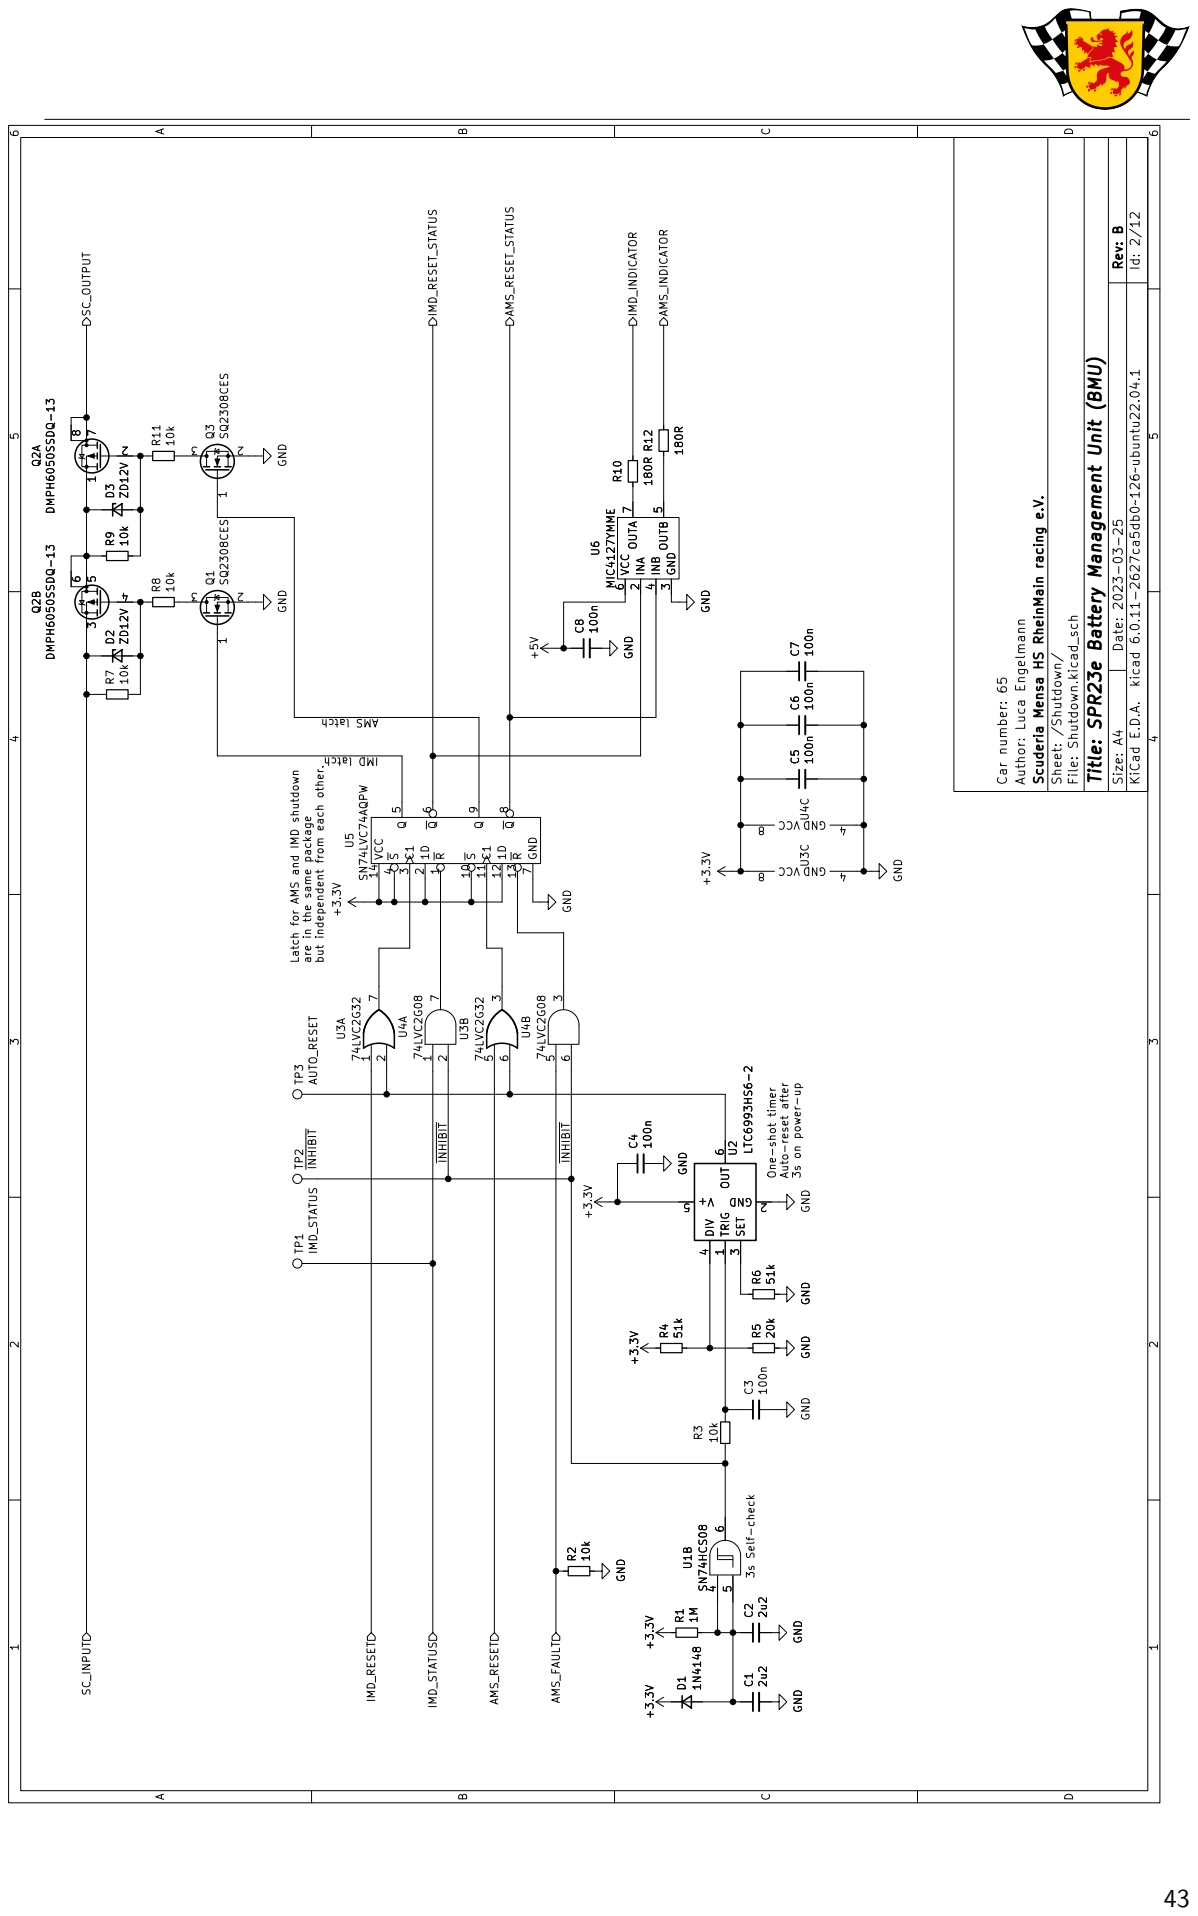
[picture p21: page 49]

D Date: 2023-03-25 KiCad E.D.A. kicad 6.0.11-2627ca5db0~126~ubuntu22.04.1 Rev: B Size: A4

Id: 2/12 Title: SPR23e Battery Management Unit (BMU) File: Shutdown.kicad_sch Sheet: /Shutdown/ Scuderia Mensa HS RheinMain racing e.V. Author: Luca Engelmann Car number: 65

4 OUTB 5 VCC 6 OUTA 7 U6 MIC4127YMME GND

4 OUTB 5 VCC 6 OUTA 7 GND

but independent from each other. One-shot timer Auto-reset after 3s on power-up latch AMS latch IMD

~{INHIBIT} 3s Self-check Latch for AMS and IMD shutdown

are in the same package

# 8 MHz GND

# 122 VSS 123 VDD ¹²⁴ PTE19

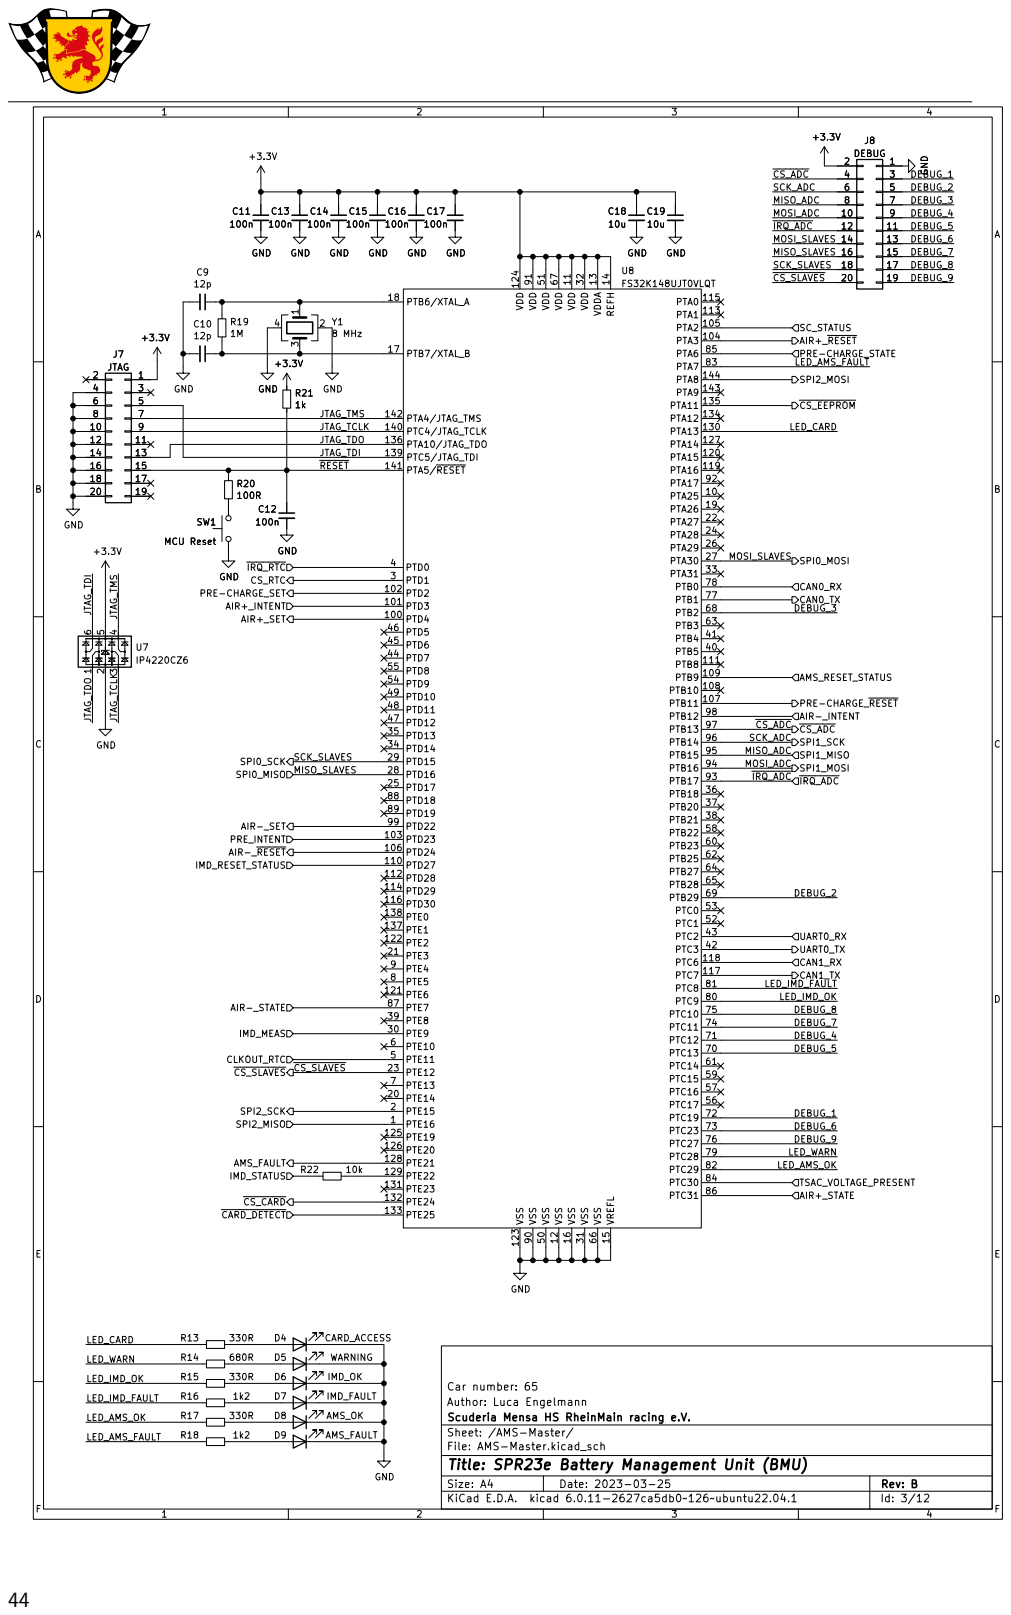
[picture p22: page 50]

Id: 3/12 Title: SPR23e Battery Management Unit (BMU) File: AMS-Master.kicad_sch Sheet: /AMS-Master/ Scuderia Mensa HS RheinMain racing e.V. Author: Luca Engelmann Car number: 65

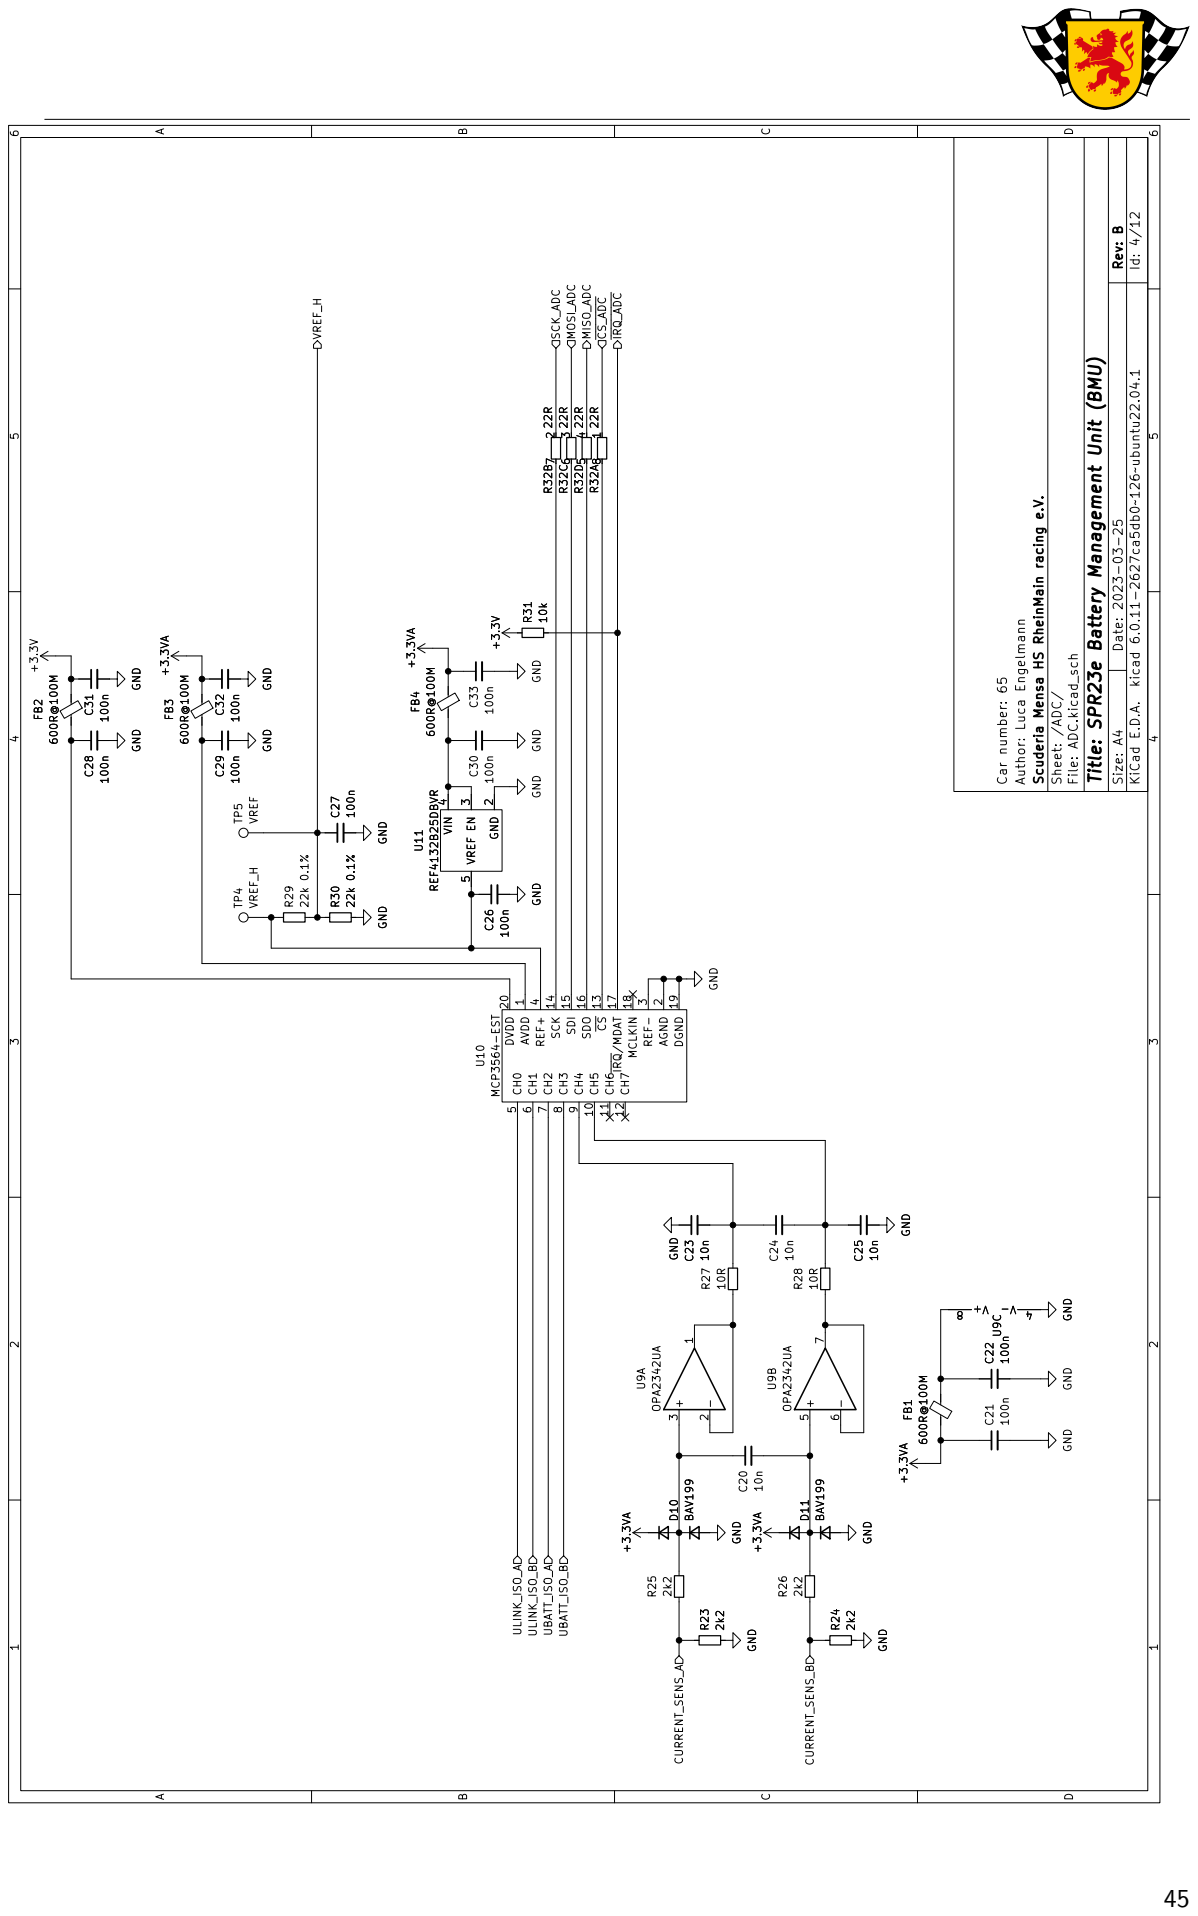
[picture p23: page 51]
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

Id: 4/12 Title: SPR23e Battery Management Unit (BMU) File: ADC.kicad_sch Sheet: /ADC/ Scuderia Mensa HS RheinMain racing e.V. Author: Luca Engelmann Car number: 65

1 CH5 10 CH6 11 CH7 12 ~{CS}13 SCK 14 SDI 15 SDO 16 ~{IRQ}/MDAT17 MCLKIN 18 DGND 19 AGND 2 DVDD

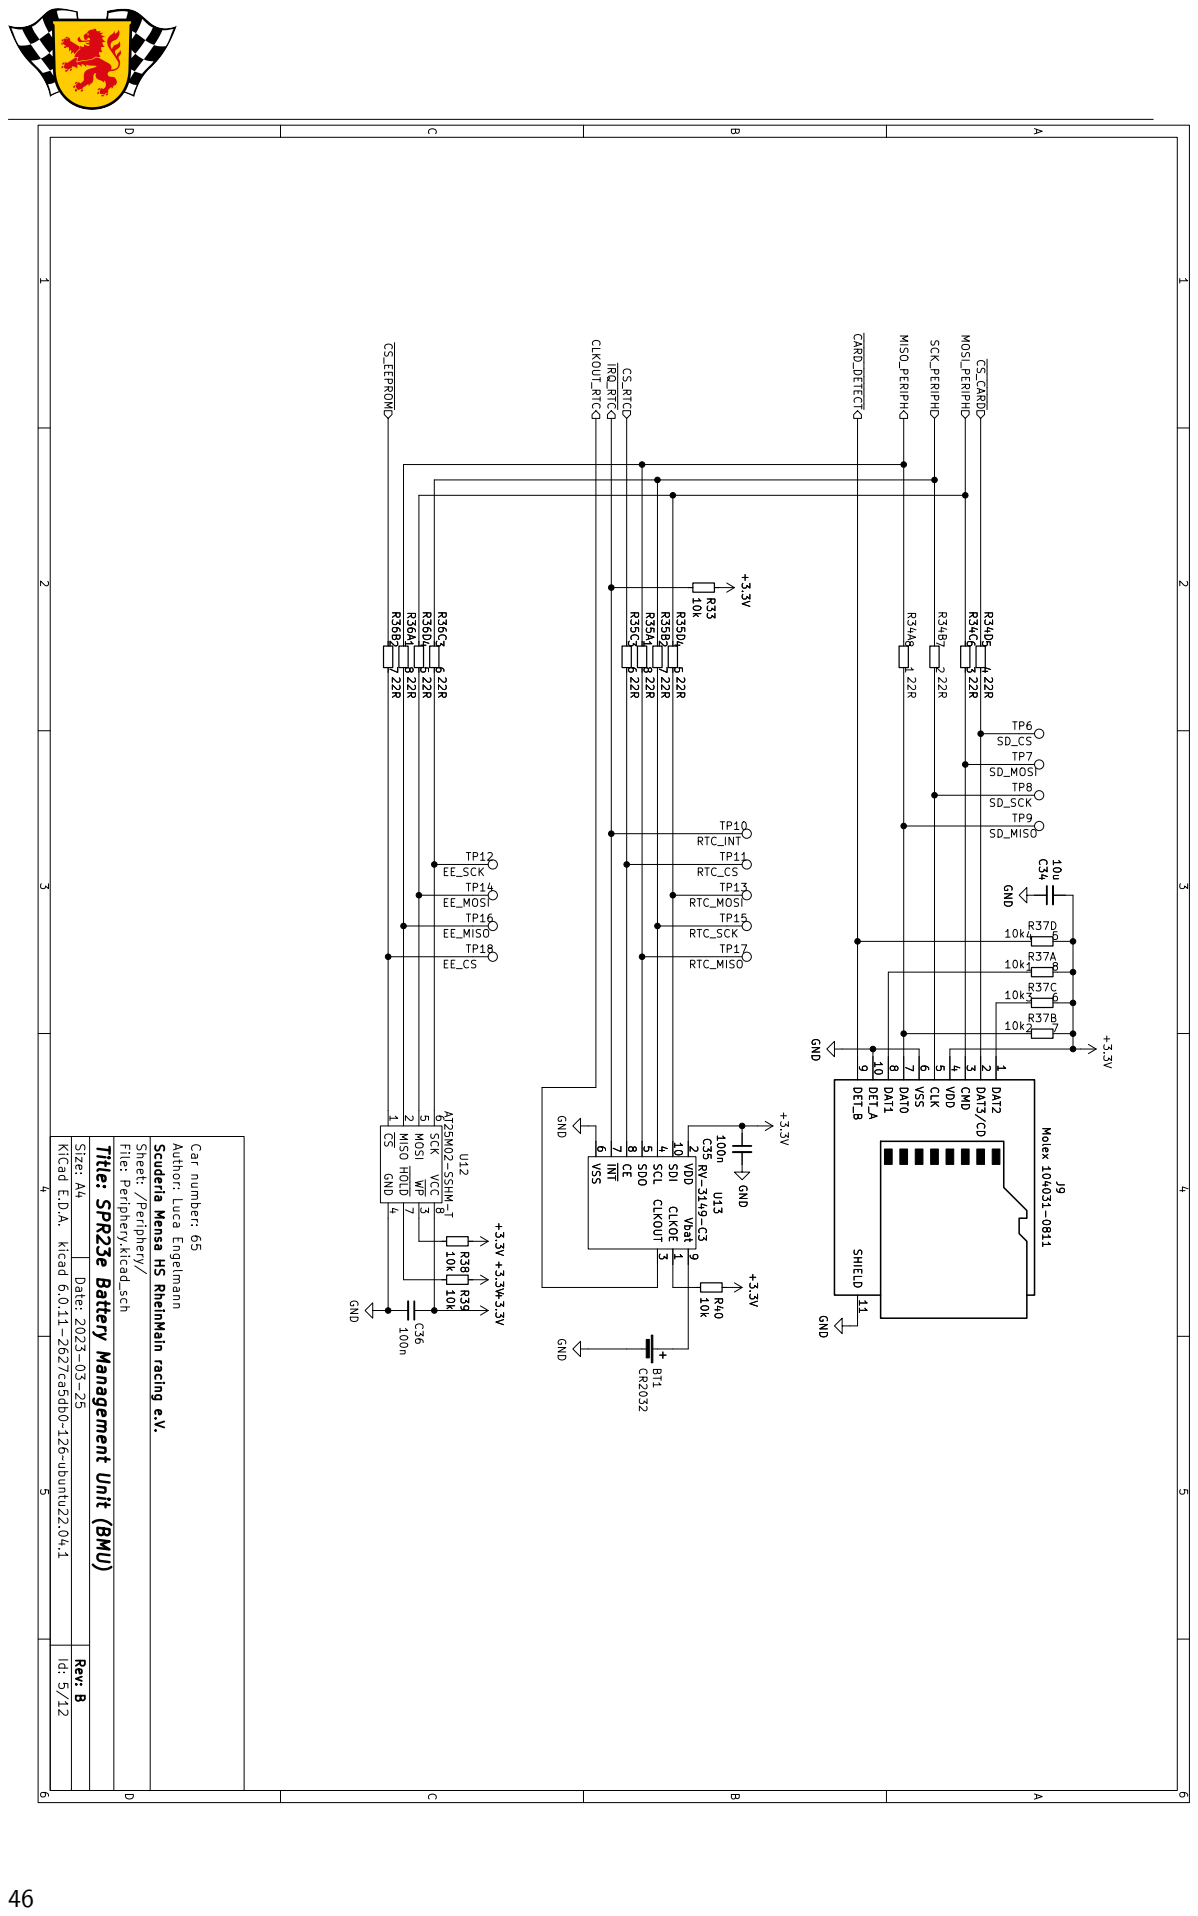
[picture p24: page 52]

10u ~{CS} 1 MISO 2 ~{WP}3 GND 4 MOSI 5 SCK 6 ~{HOLD}7 VCC 8 U12 AT25M02-SSHM-T 3 6 R36C 22R TP12 EE_SCK

Id: 5/12 Title: SPR23e Battery Management Unit (BMU) File: Periphery.kicad_sch Sheet: /Periphery/ Scuderia Mensa HS RheinMain racing e.V. Author: Luca Engelmann Car number: 65 TP6 SD_CS

2 CLKOUT 3 SCL 4 SDO 5 VSS 6 ~{INT} 7 CE 8 Vbat 9 U13 RV-3149-C3 GND TP15 RTC_SCK 10k R40 GND

10 SHIELD 11 DAT3/CD 2 CMD 3 VDD

A Date: 2023-03-25 KiCad E.D.A. kicad 6.0.11-2627ca5db0~126~ubuntu22.04.1 Rev: B Size: A4

10k R38+3.3V +3.3V +3.3V U13 RV-3149-C3 CLKOE 1 SDI 10 VDD

2 CLKOUT 3 SCL 4 SDO 5 VSS 6 ~{INT} 7 CE 8 Vbat 9 C35

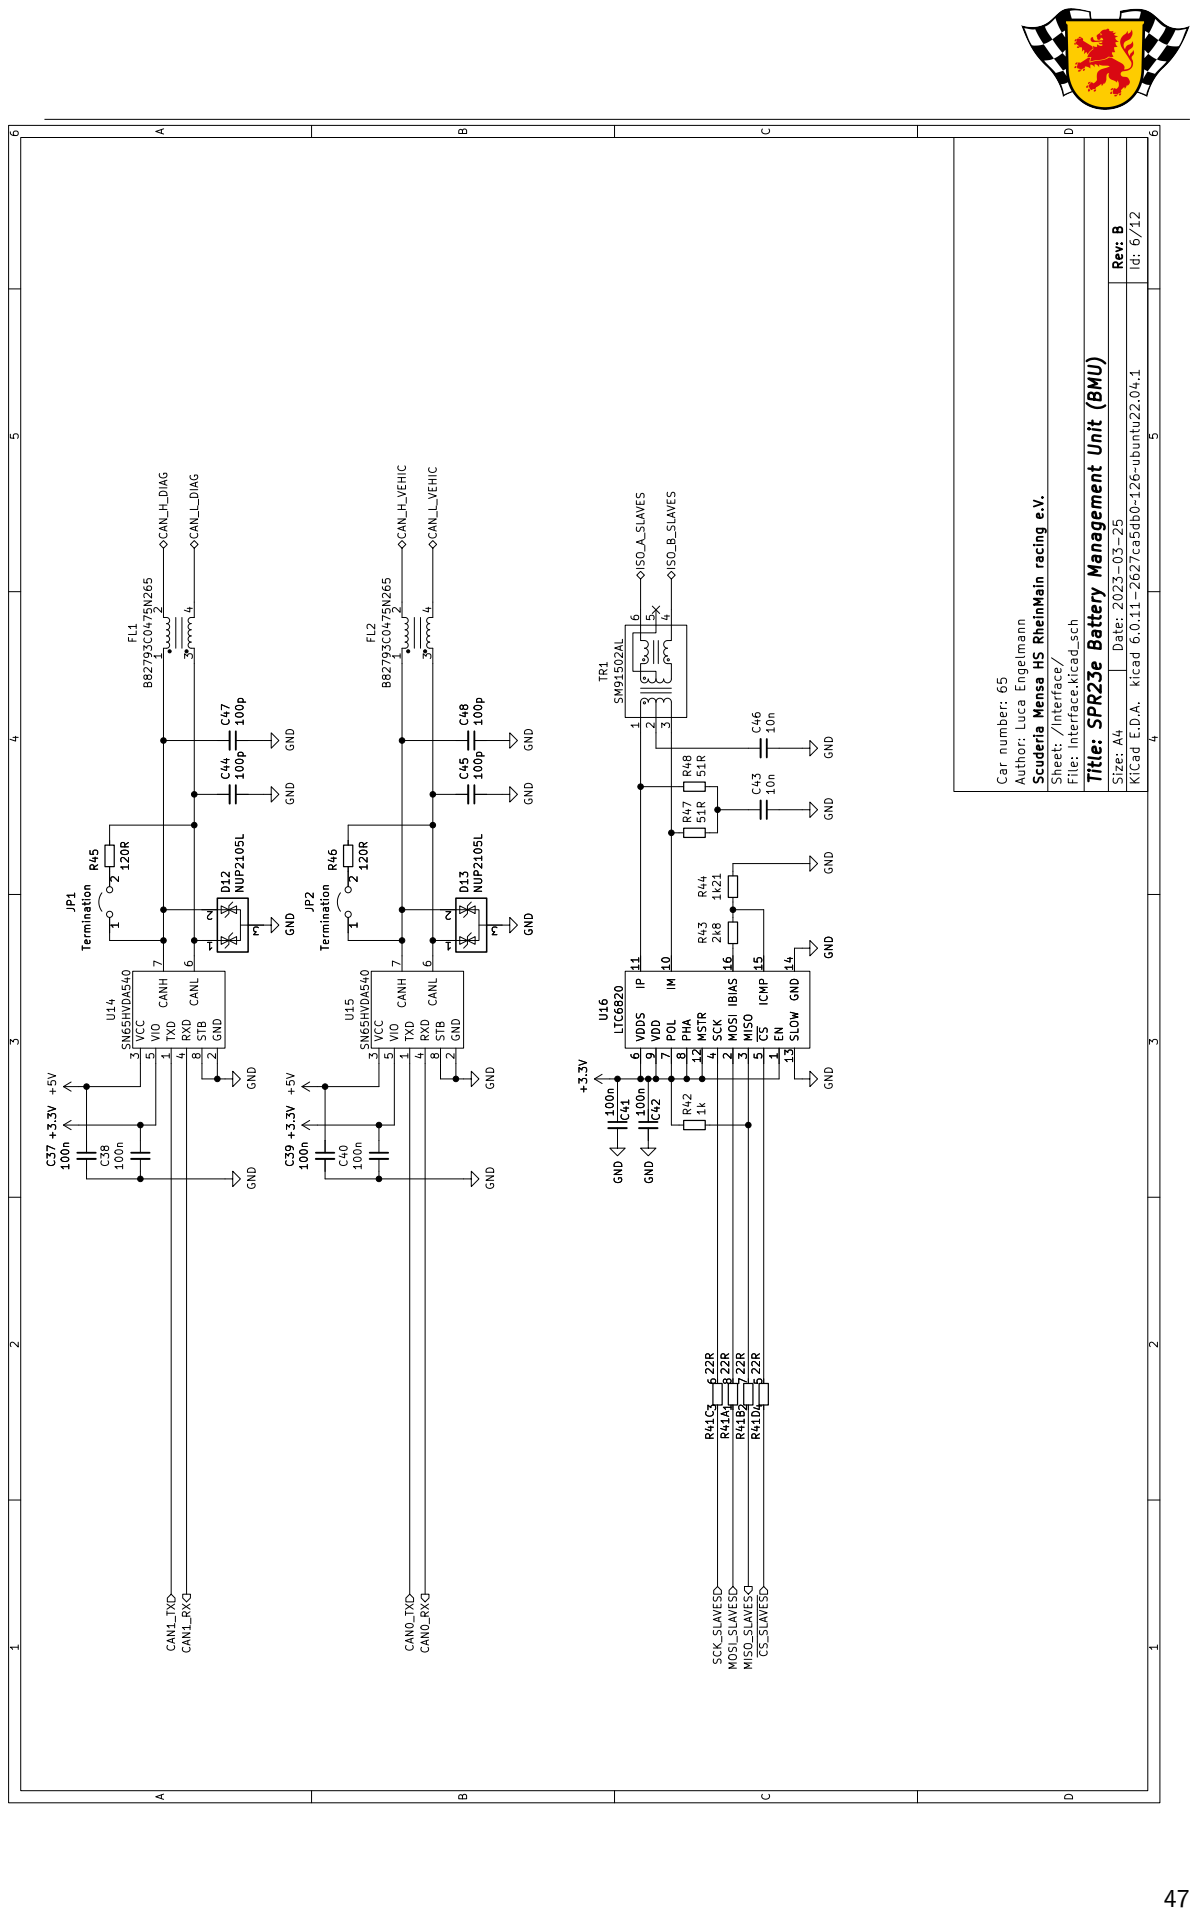
[picture p25: page 53]
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

Id: 6/12 Title: SPR23e Battery Management Unit (BMU) File: Interface.kicad_sch Sheet: /Interface/ Scuderia Mensa HS RheinMain racing e.V. Author: Luca Engelmann Car number: 65 C45

4 VIO 5 CANL 6 CANH 7 STB 8 U15 SN65HVDA540 R45

100n +5V GND GND GND GND

4 5 R41D 22R GND GND GND GND

4 VIO 5 CANL 6 CANH 7 STB 8 U14 SN65HVDA540

IBIAS 16 MOSI 2 MISO 3 SCK 4 ~{CS} 5 VDDS 6 POL 7 PHA

# 4 U23E ¹⁰u C51 +5V

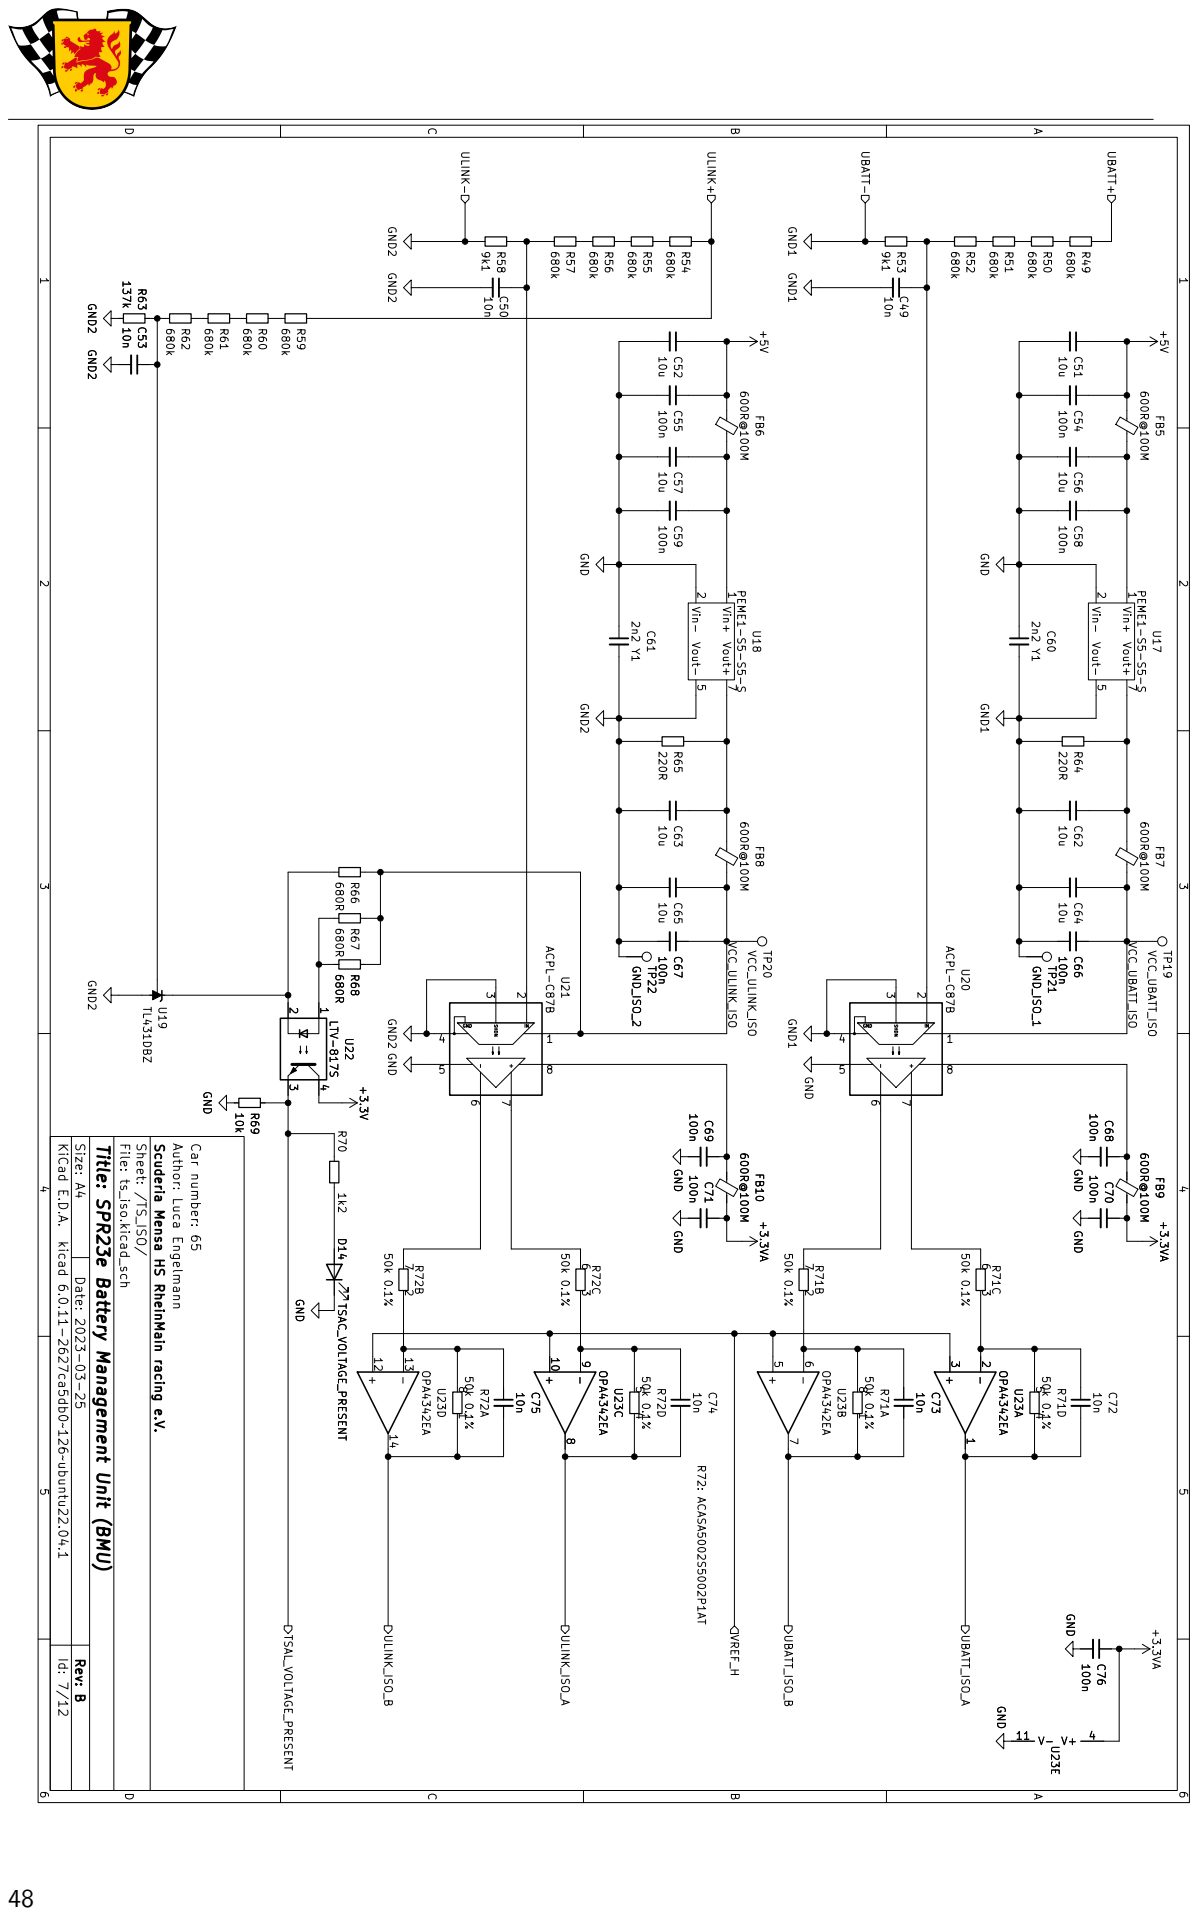
[picture p26: page 54]

A Date: 2023-03-25 KiCad E.D.A. kicad 6.0.11-2627ca5db0~126~ubuntu22.04.1 Rev: B Size: A4

Id: 7/12 Title: SPR23e Battery Management Unit (BMU) File: ts_iso.kicad_sch Sheet: /TS_ISO/ Scuderia Mensa HS RheinMain racing e.V. Author: Luca Engelmann Car number: 65

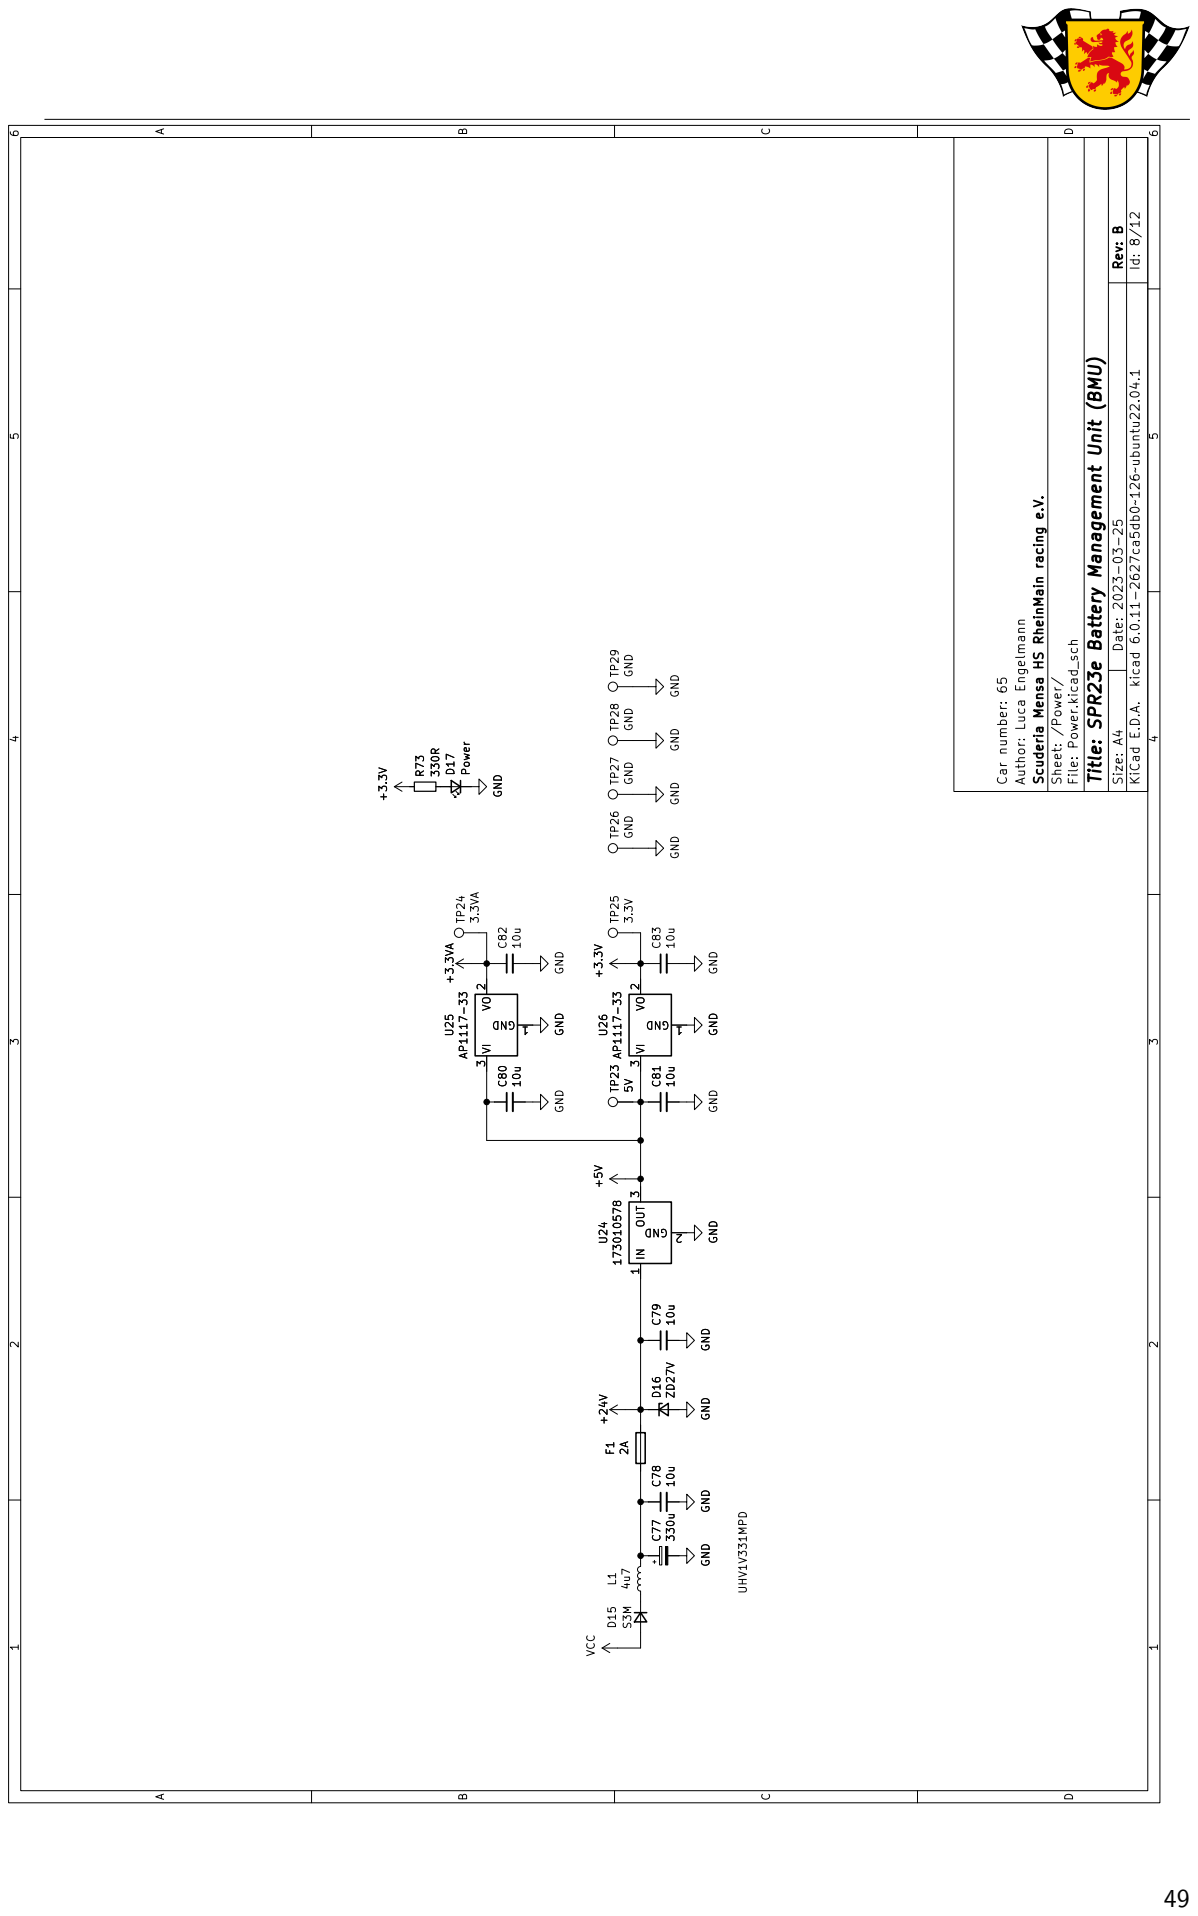
[picture p27: page 55]
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

Id: 8/12 Title: SPR23e Battery Management Unit (BMU) File: Power.kicad_sch Sheet: /Power/ Scuderia Mensa HS RheinMain racing e.V. Author: Luca Engelmann Car number: 65

4u7 TP29 GND GND GND GND

## 2k2 GND

# 10k D27 AIR+ R91

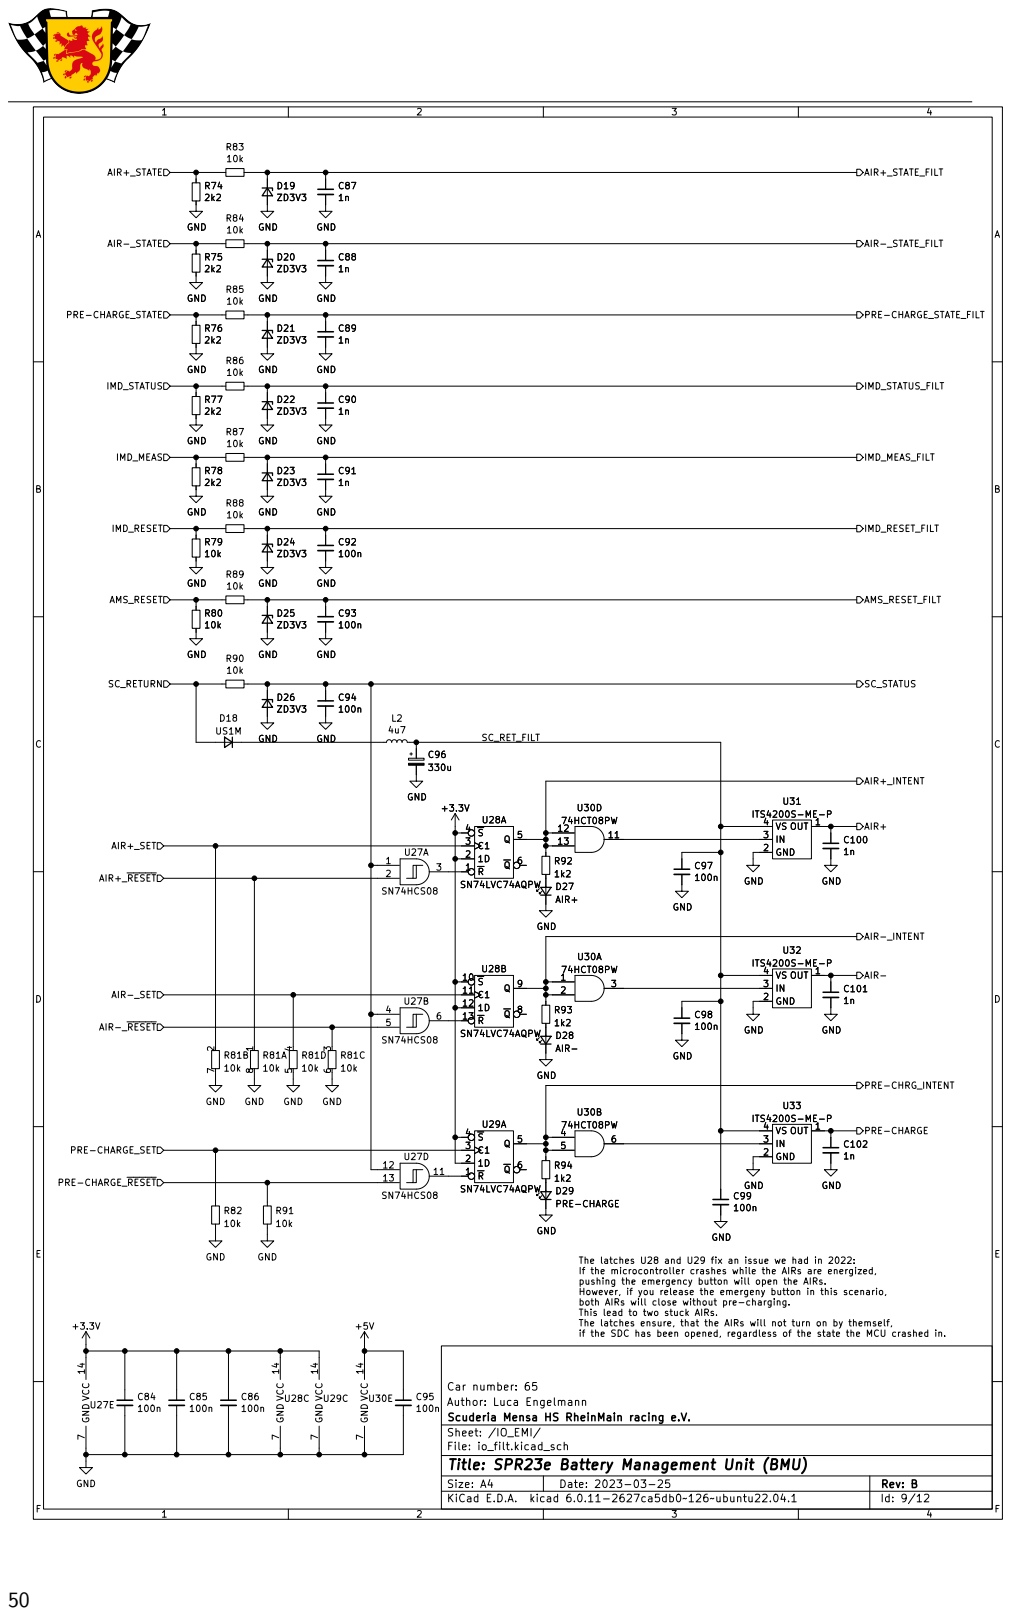
[picture p28: page 56]

1n GND VCC ¹⁴ GND

Id: 9/12 Title: SPR23e Battery Management Unit (BMU) File: io_filt.kicad_sch Sheet: /IO_EMI/ Scuderia Mensa HS RheinMain racing e.V. Author: Luca Engelmann Car number: 65 GND

The latches U28 and U29 fix an issue we had in 2022:
pushing the emergency button will open the AIRs. However, if you release the emergeny button in this scenario, both AIRs will close without pre-charging. This lead to two stuck AIRs. The latches ensure, that the AIRs will not turn on by themself,

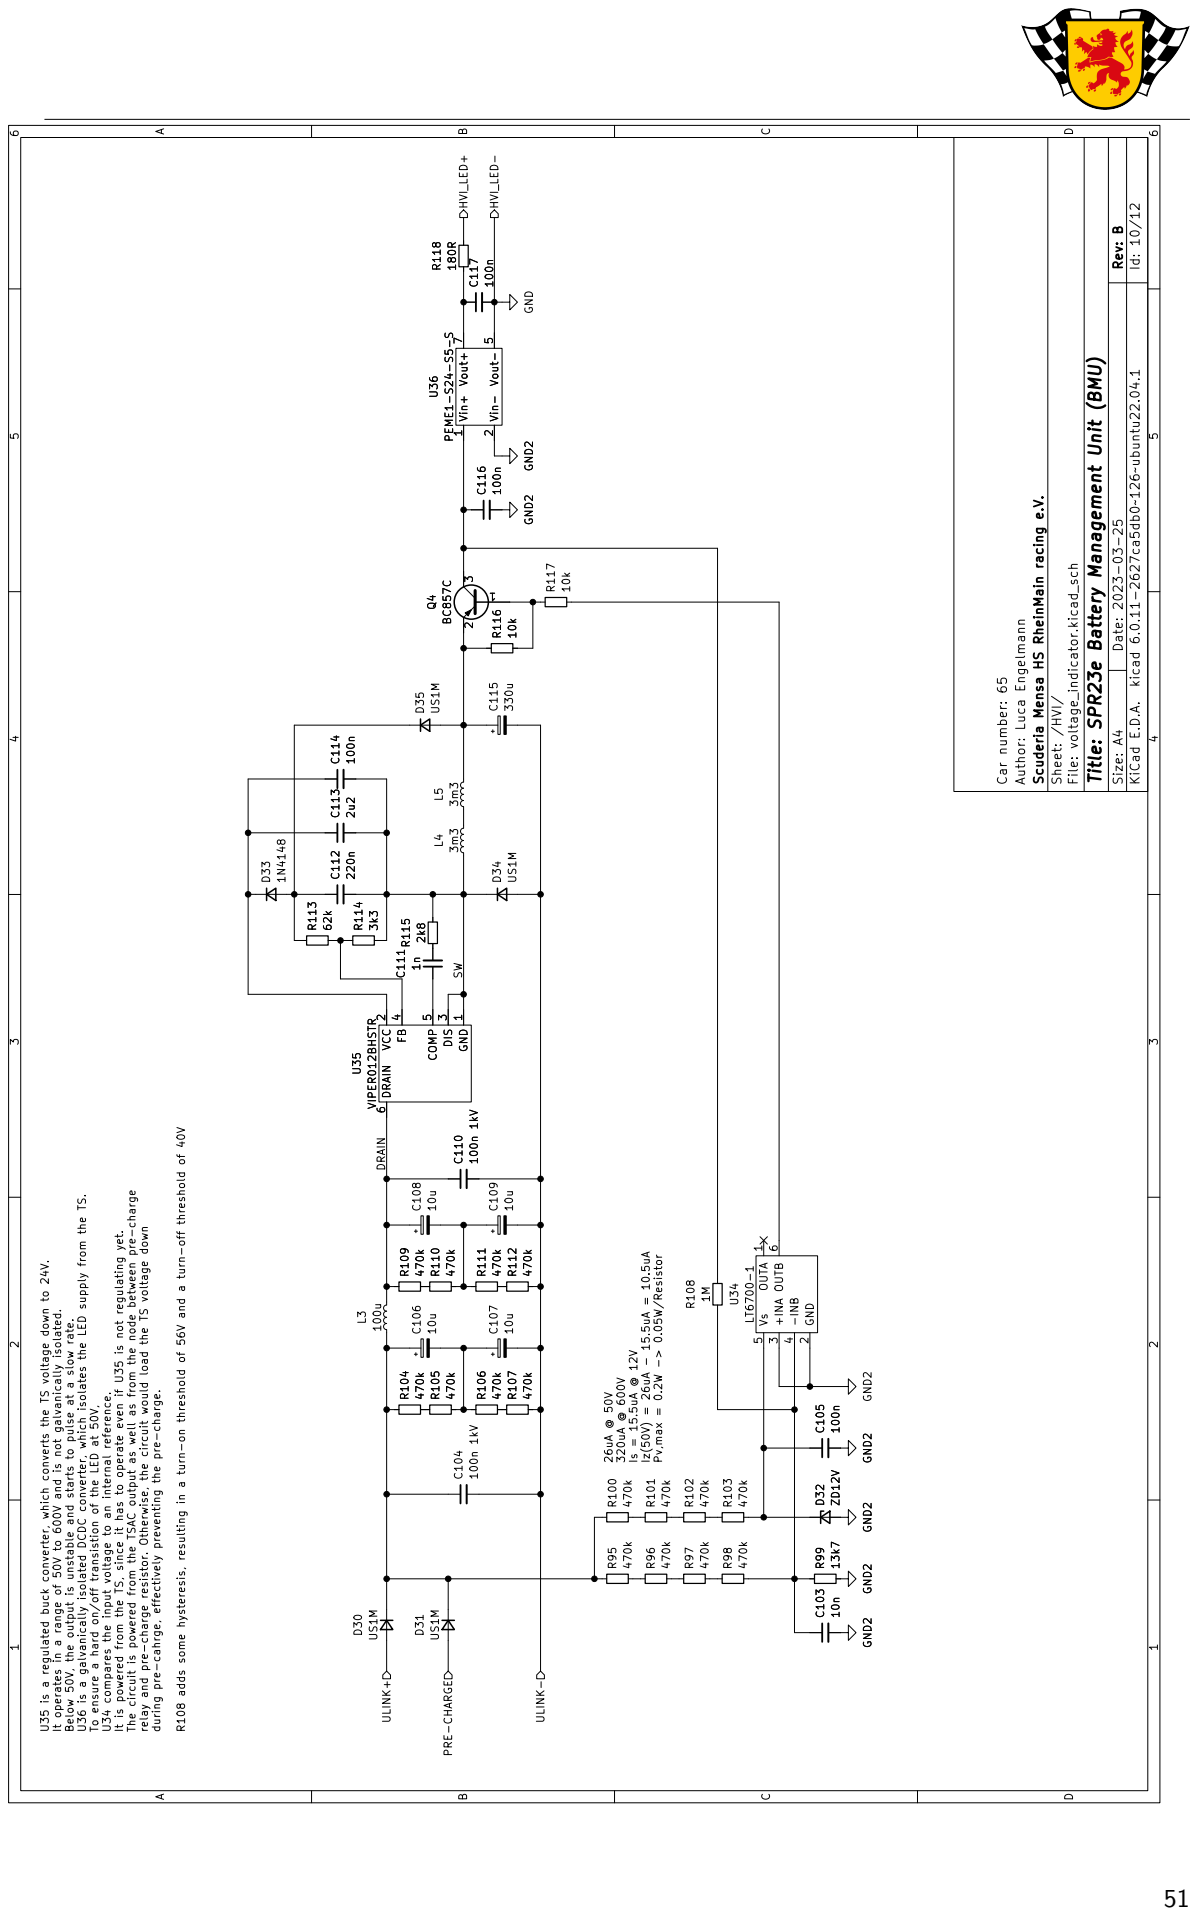
[picture p29: page 57]
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

100n ULINK+ HVI_LED- ULINK- HVI_LED+ PRE-CHARGE DRAIN

Id: 10/12 Title: SPR23e Battery Management Unit (BMU) File: voltage_indicator.kicad_sch Sheet: /HVI/ Scuderia Mensa HS RheinMain racing e.V. Author: Luca Engelmann Car number: 65 R102

1n GND 1 VCC 2 DIS 3 FB

Pv,max = 0.2W -> 0.05W/Resistor U35 VIPER012BHSTR GND 1 VCC 2 DIS 3 FB

during pre-cahrge, effectively preventing the pre-charge. R108 adds some hysteresis, resulting in a turn-on threshold of 56V and a turn-off threshold of 40V

It operates in a range of 50V to 600V and is not galvanically isolated. Below 50V, the output is unstable and starts to pulse at a slow rate. U36 is a galvanically isolated DCDC converter, which isolates the LED supply from the TS. To ensure a hard on/off transistion of the LED at 50V, U34 compares the input voltage to an internal reference.

It is powered from the TS, since it has to operate even if U35 is not regulating yet. The circuit is powered from the TSAC output as well as from the node between pre-charge

relay and pre-charge resistor. Otherwise, the circuit would load the TS voltage down

U35 is a regulated buck converter, which converts the TS voltage down to 24V.

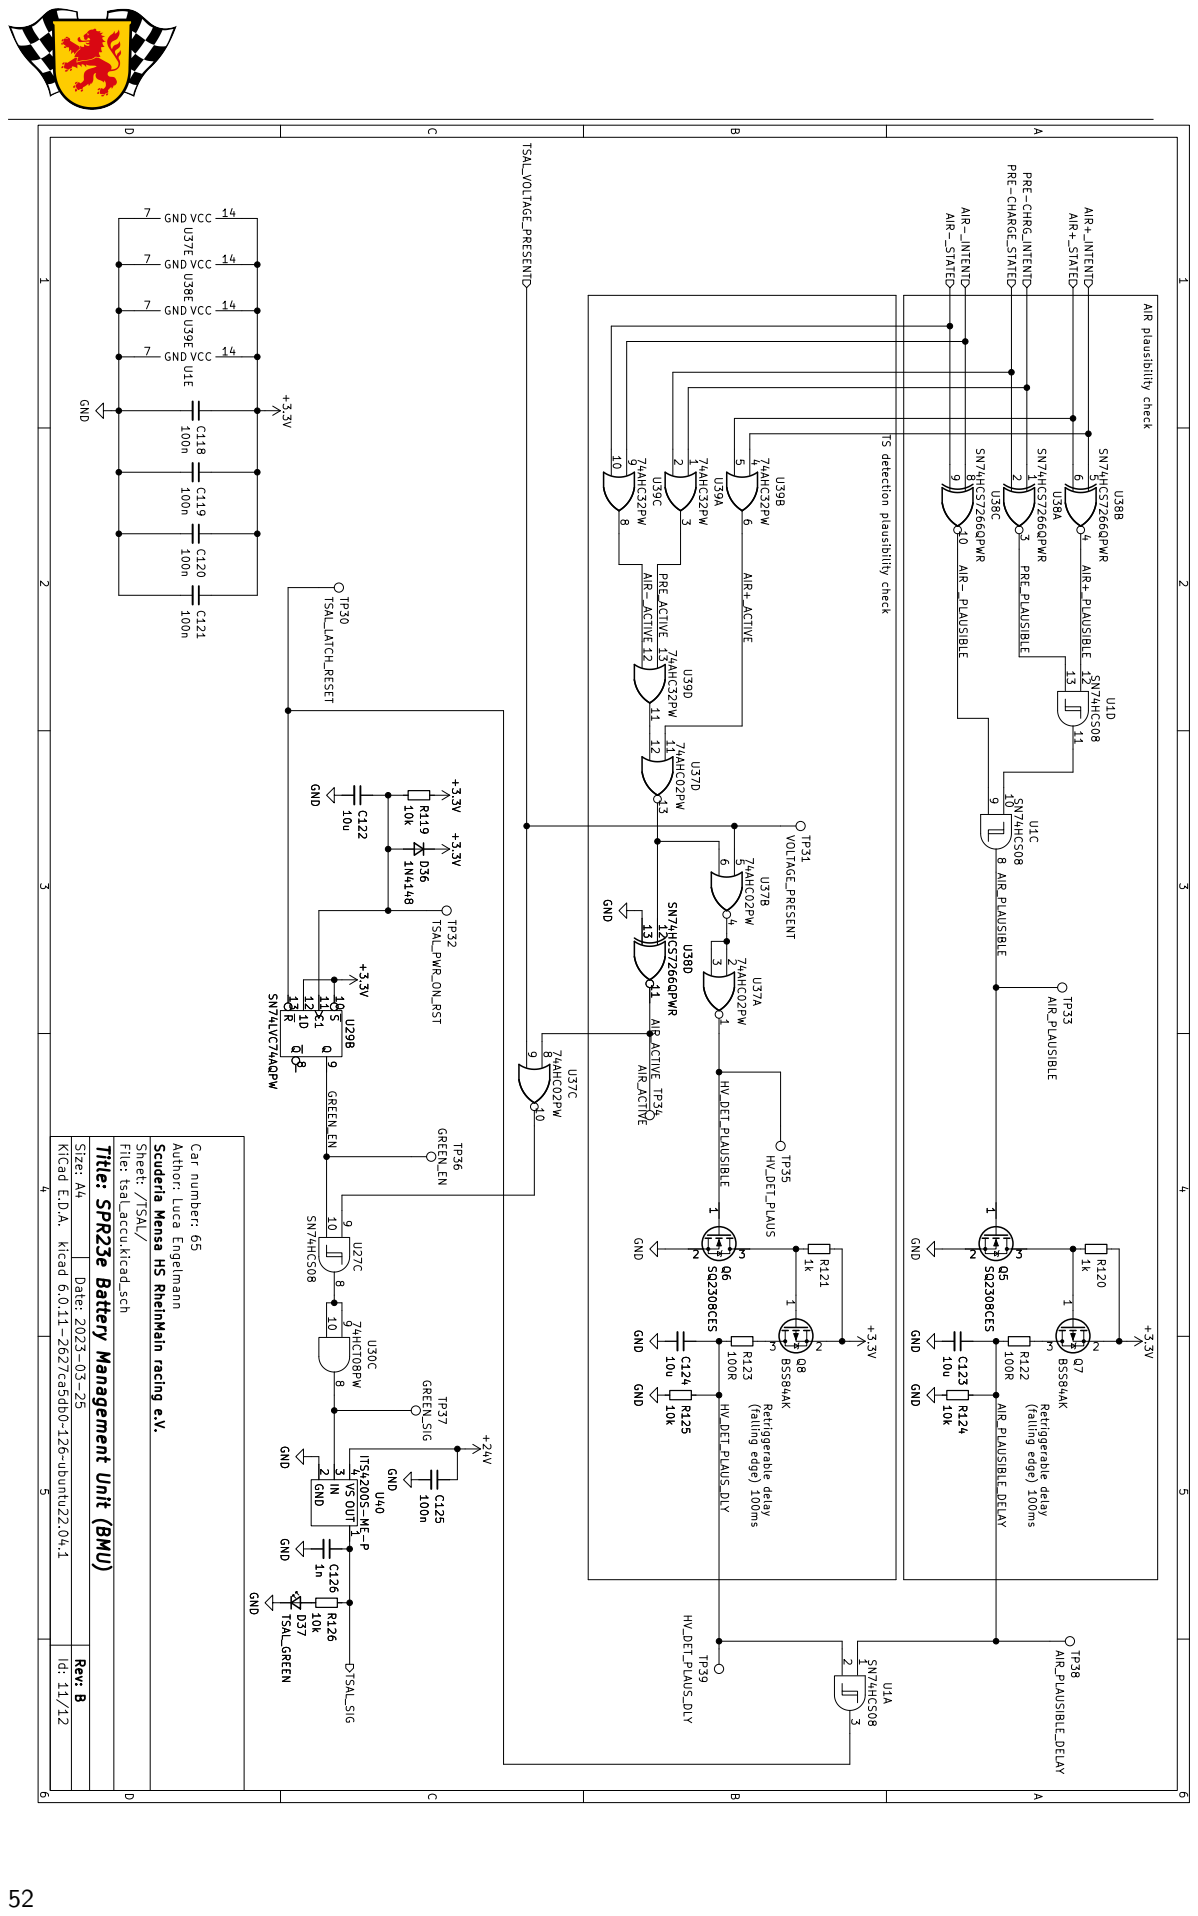
[picture p30: page 58]

(falling edge) 100ms AIR plausibility check TS detection plausibility check GND

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

Id: 11/12 Title: SPR23e Battery Management Unit (BMU) File: tsal_accu.kicad_sch Sheet: /TSAL/ Scuderia Mensa HS RheinMain racing e.V. Author: Luca Engelmann Car number: 65

(falling edge) 100ms Retriggerable delay

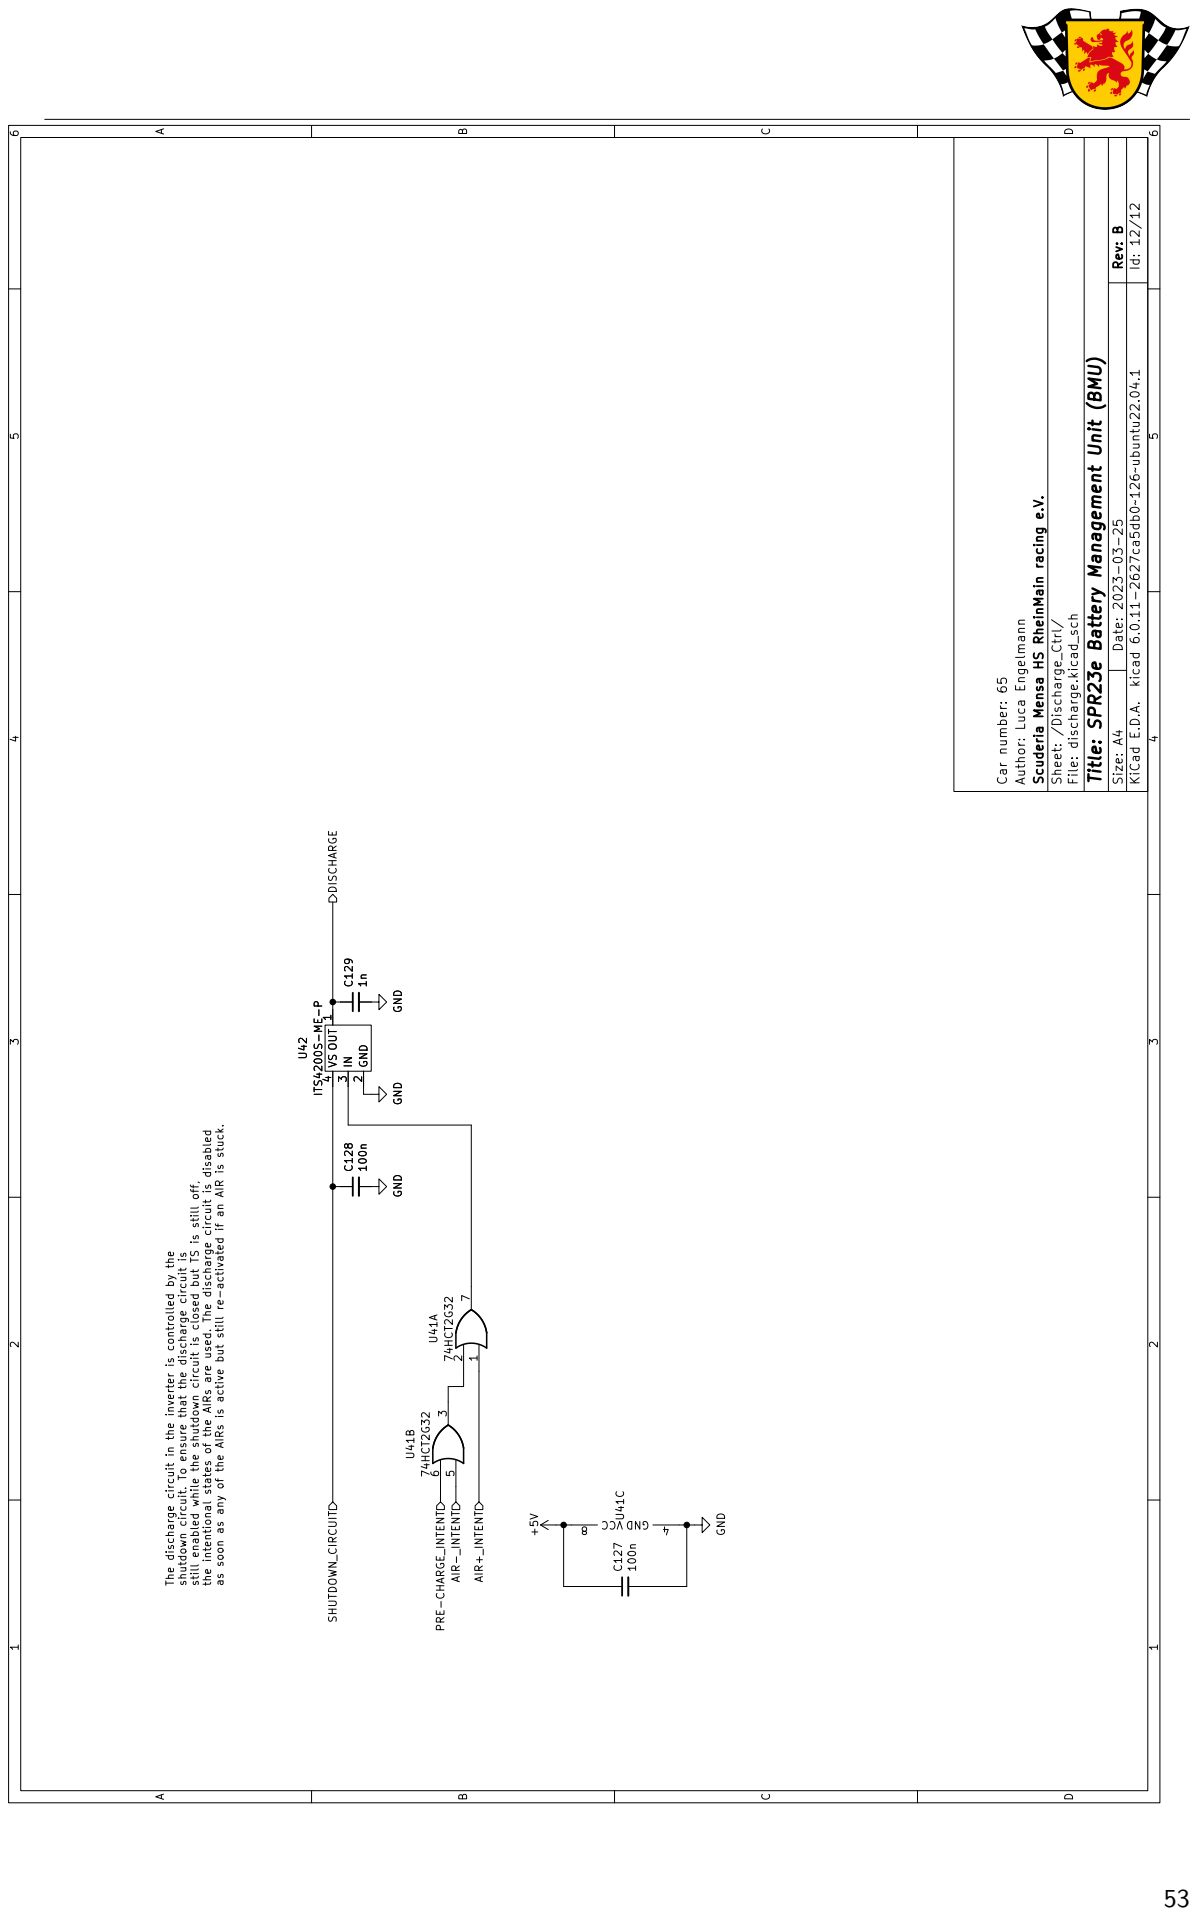
[picture p31: page 59]
1n GND; 74HCT2G32; ITS4200S-ME-P; +5V GNDGND; 100n DISCHARGE; 100n GND

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

Id: 12/12 Title: SPR23e Battery Management Unit (BMU) File: discharge.kicad_sch Sheet: /Discharge_Ctrl/ Scuderia Mensa HS RheinMain racing e.V. Author: Luca Engelmann Car number: 65 GND

3 VS 4 GND GND

ITS4200S-ME-P OUT 1 GND 2

74HCT2G32 GND OUT 1 GND 2

as soon as any of the AIRs is active but still re-activated if an AIR is stuck. U42

the intentional states of the AIRs are used. The discharge circuit is disabled

still enabled while the shutdown circuit is closed but TS is still off,

The discharge circuit in the inverter is controlled by the

shutdown circuit. To ensure that the discharge circuit is

PRE-CHARGE_INTENT SHUTDOWN_CIRCUIT AIR-_INTENT AIR+_INTENT
