derlucae98/spr23e-bmu/spr23e-bmu.pdf

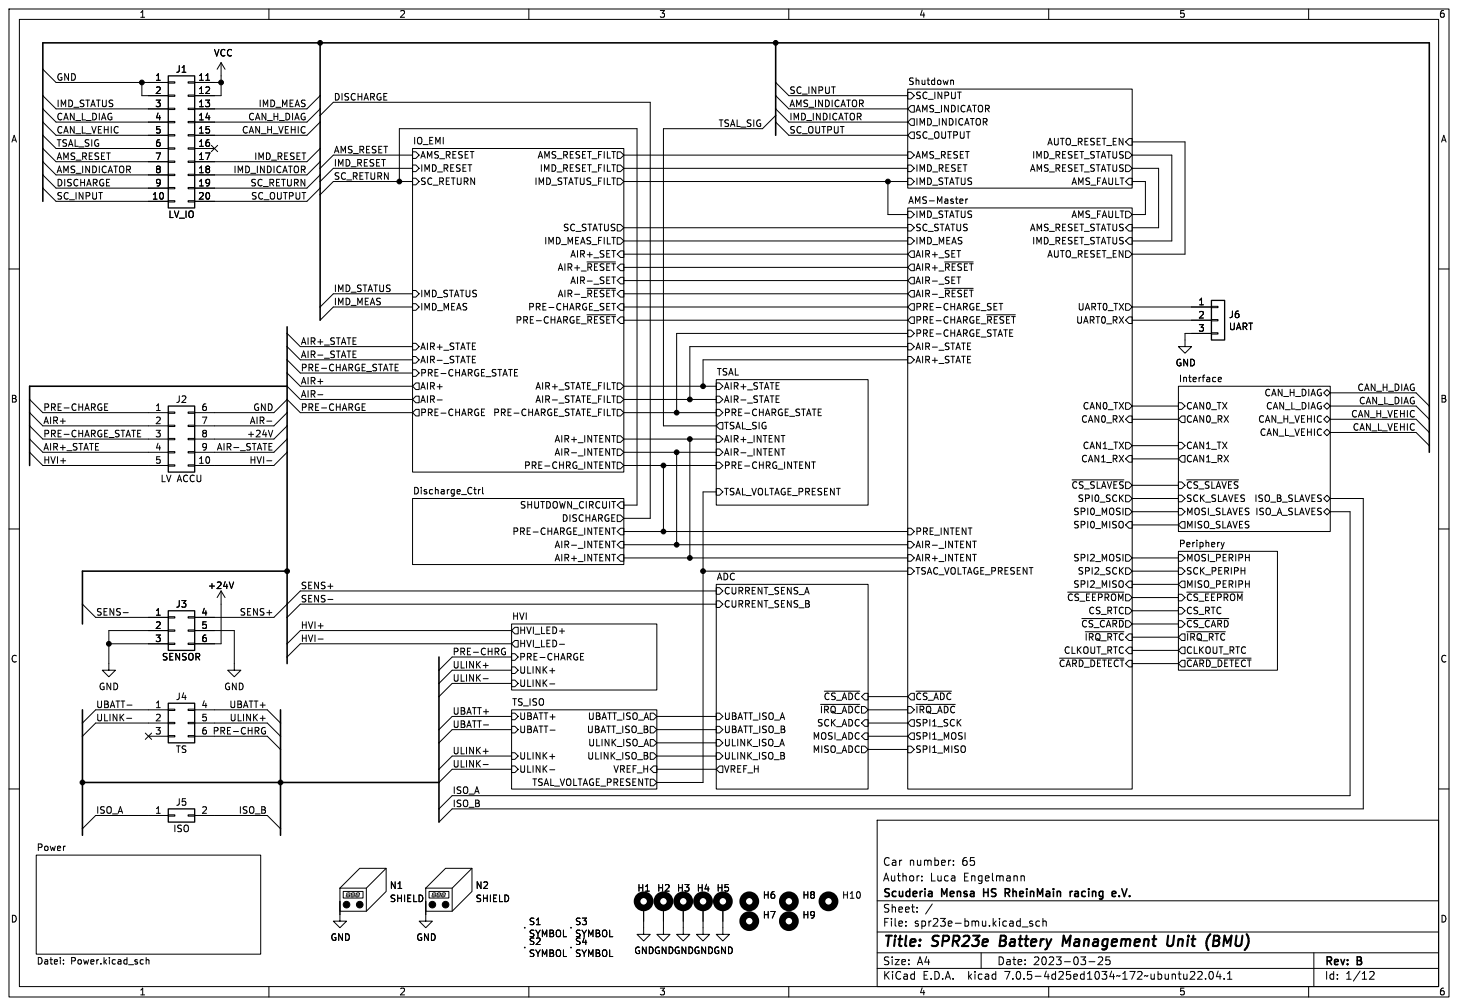
[picture p32: page 1]

AIR+_~{RESET} AIR+_SET AIR-_SET AIR-_~{RESET} PRE-CHARGE_SET PRE-CHARGE_~{RESET} AIR-_STATE_FILT AIR+_STATE_FILT PRE-CHARGE_STATE_FILT

PRE-CHARGE_INTENT AIR+_INTENT AIR-_INTENT Discharge_Ctrl Power Datei: Power.kicad_sch

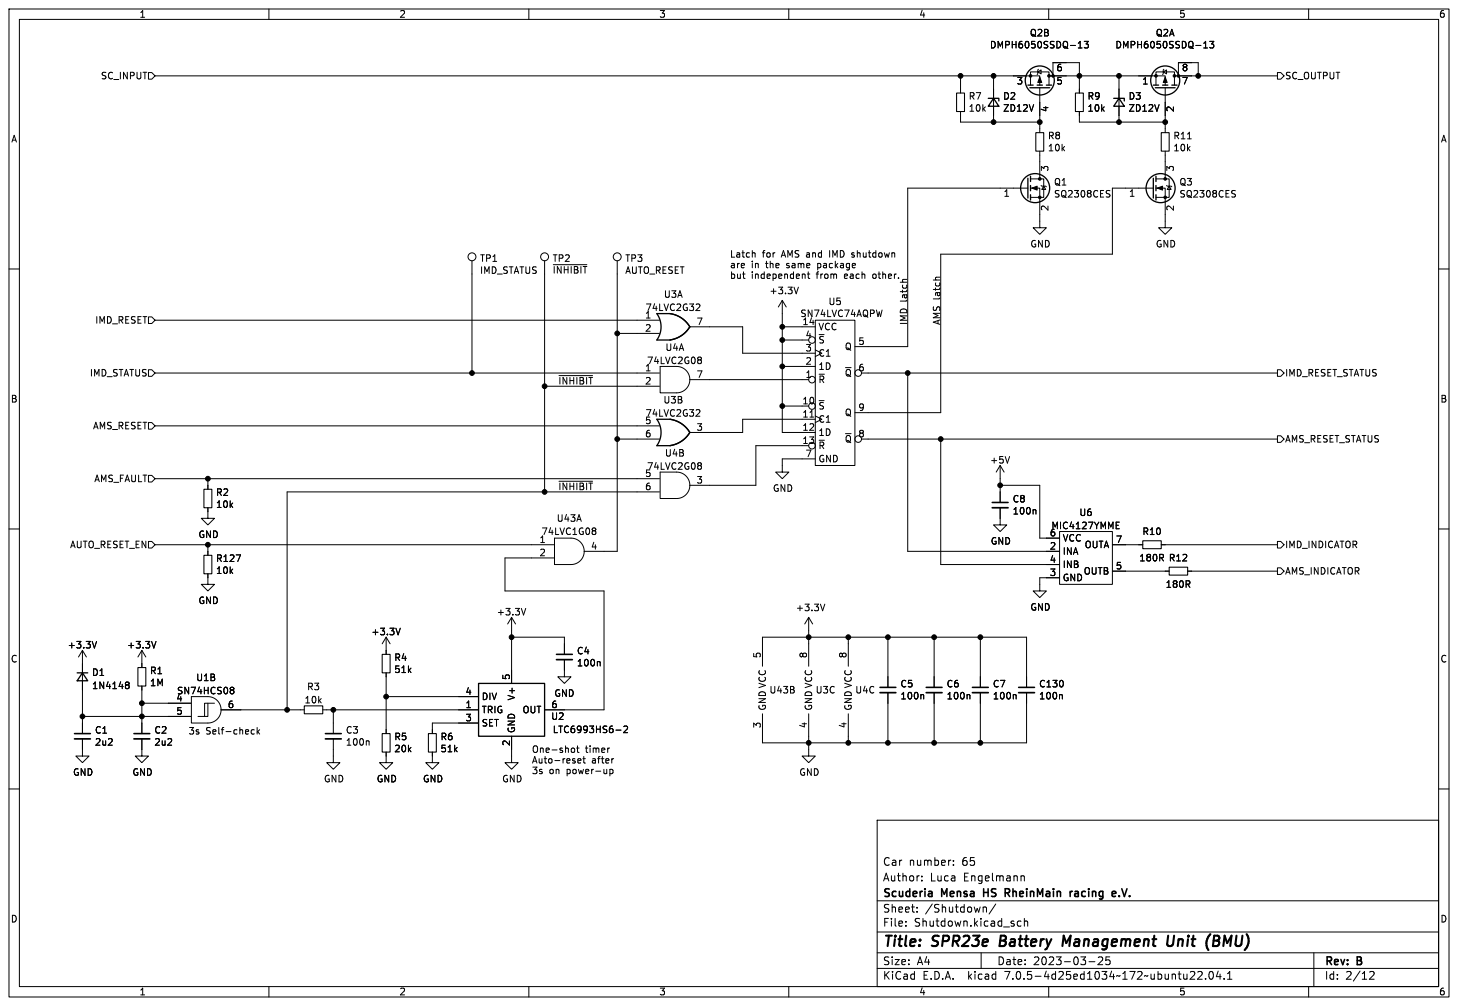
[picture p33: page 2]

Latch for AMS and IMD shutdown
are in the same package
1D 12 ~{R} 13 VCC 14

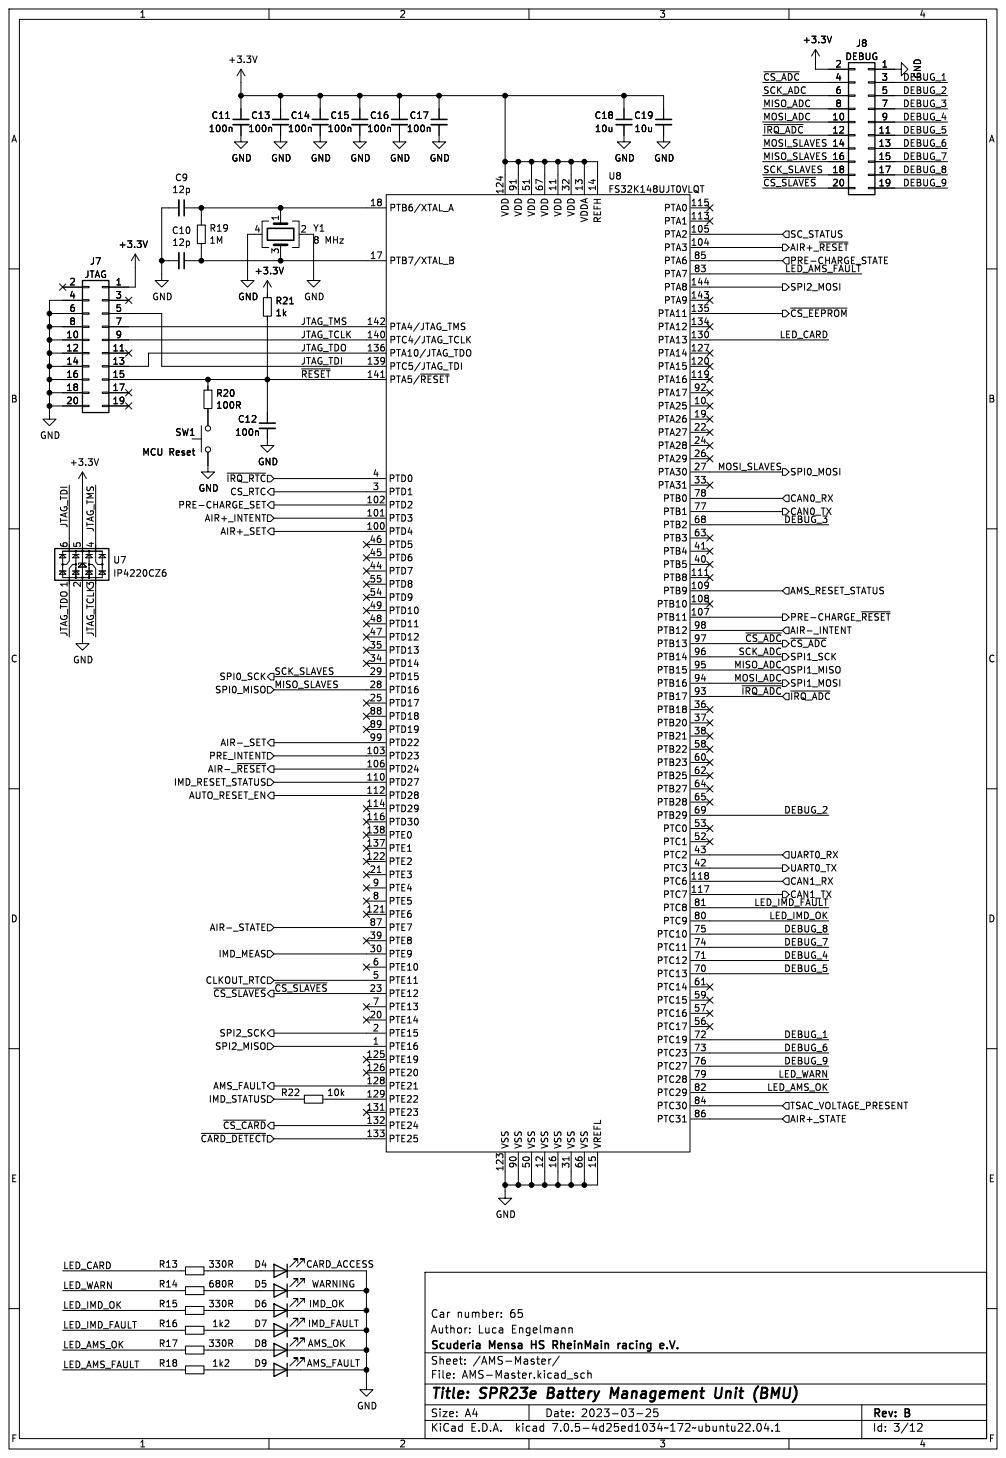
[picture p34: page 3]

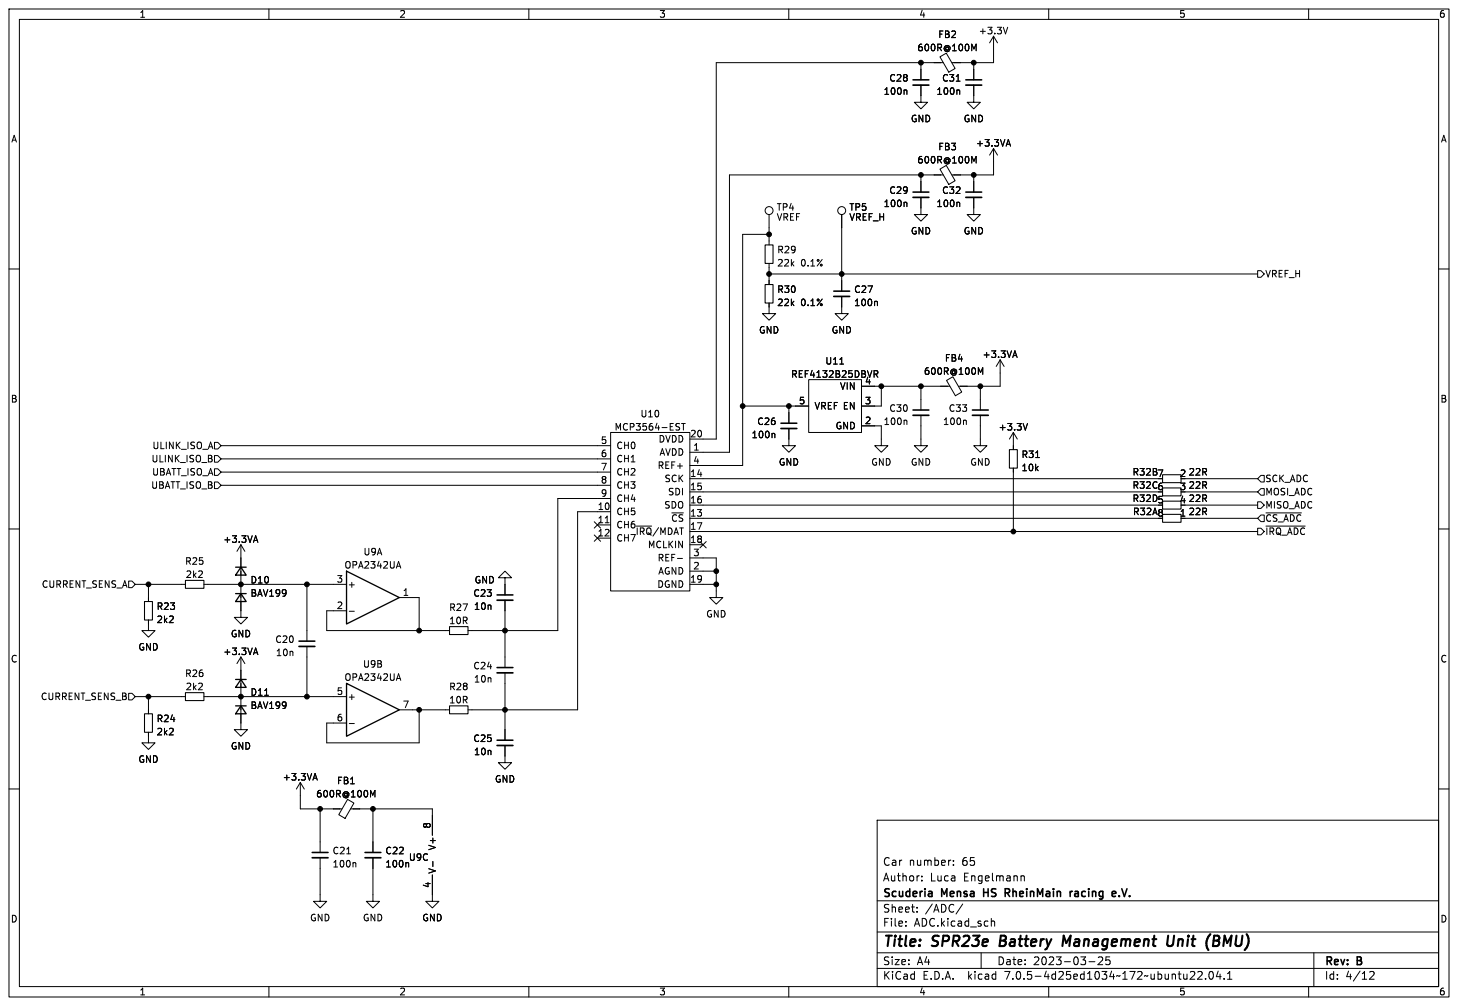
[picture p35: page 4]

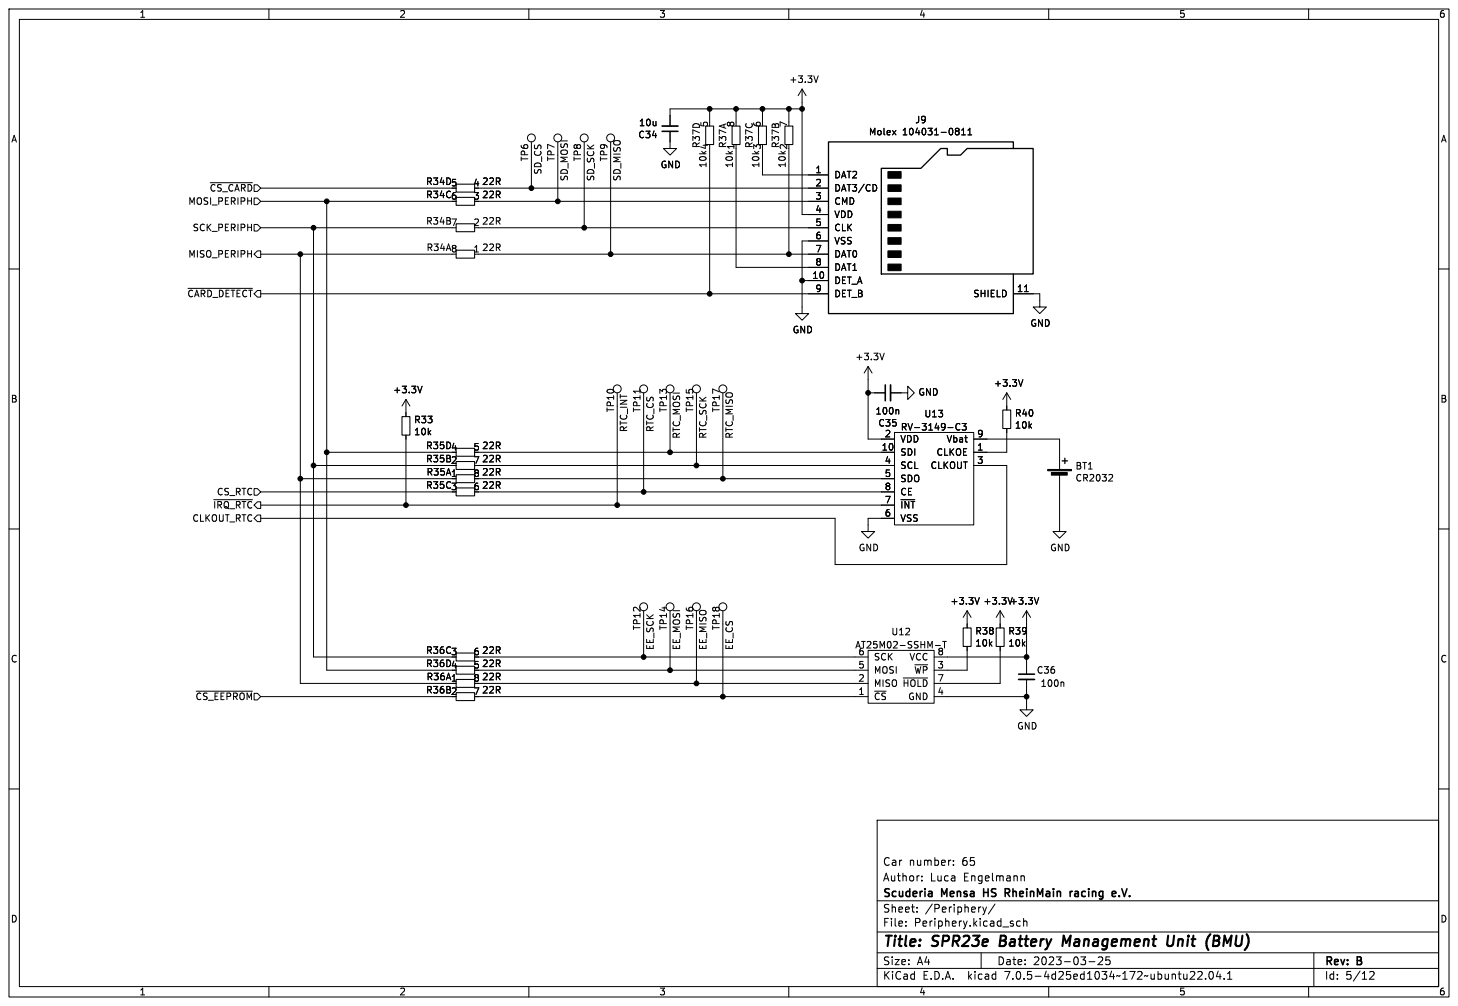
[picture p36: page 5]

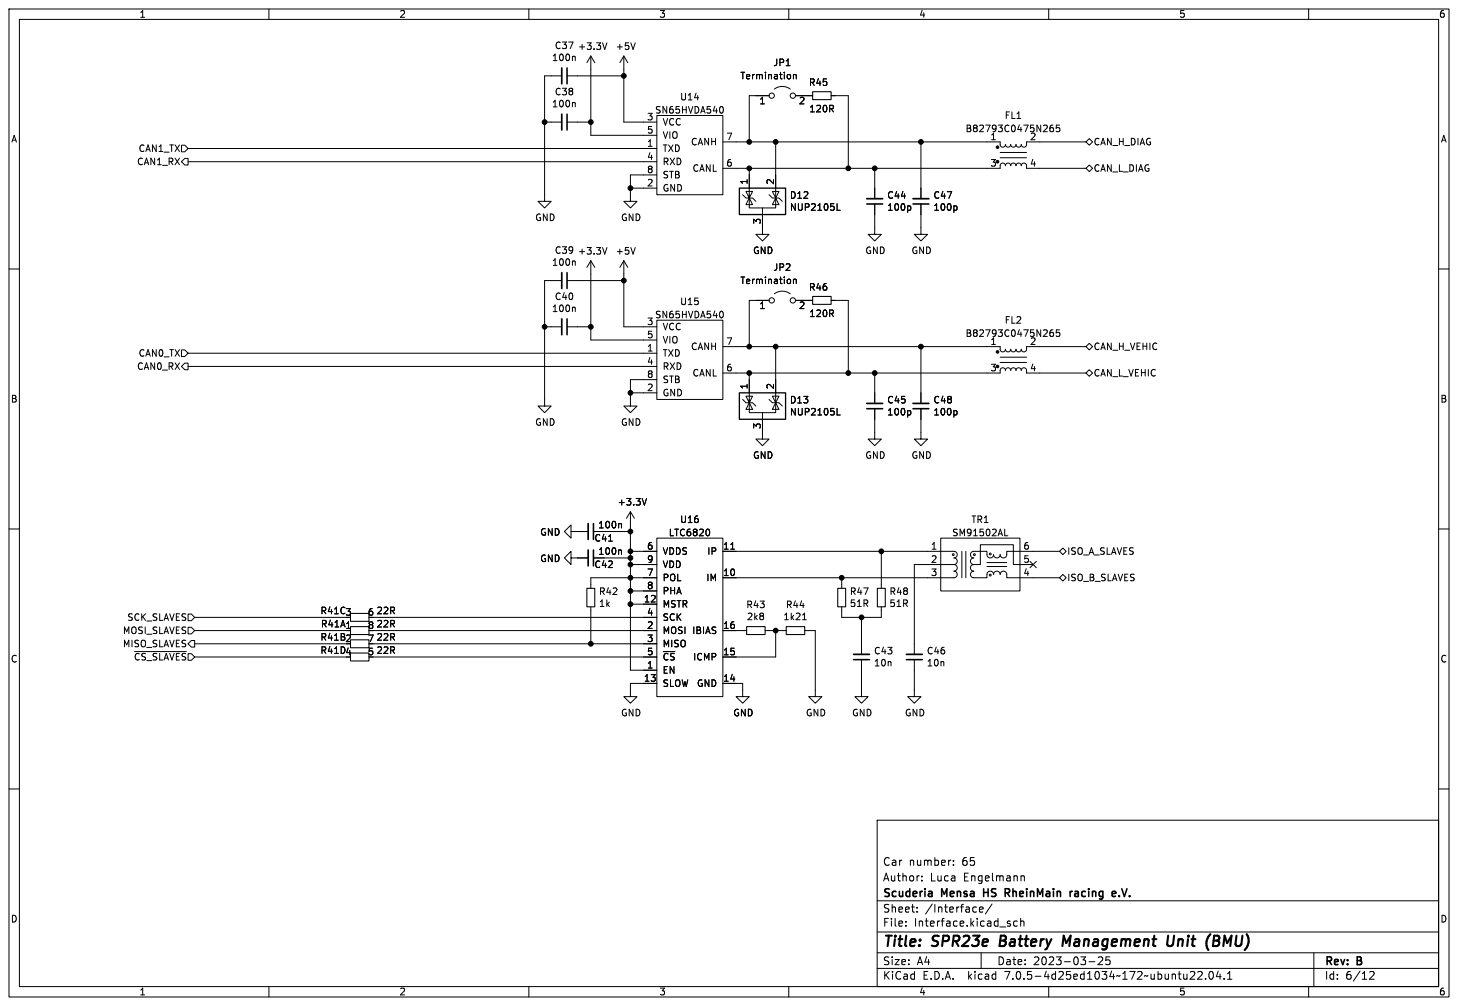
[picture p37: page 6]

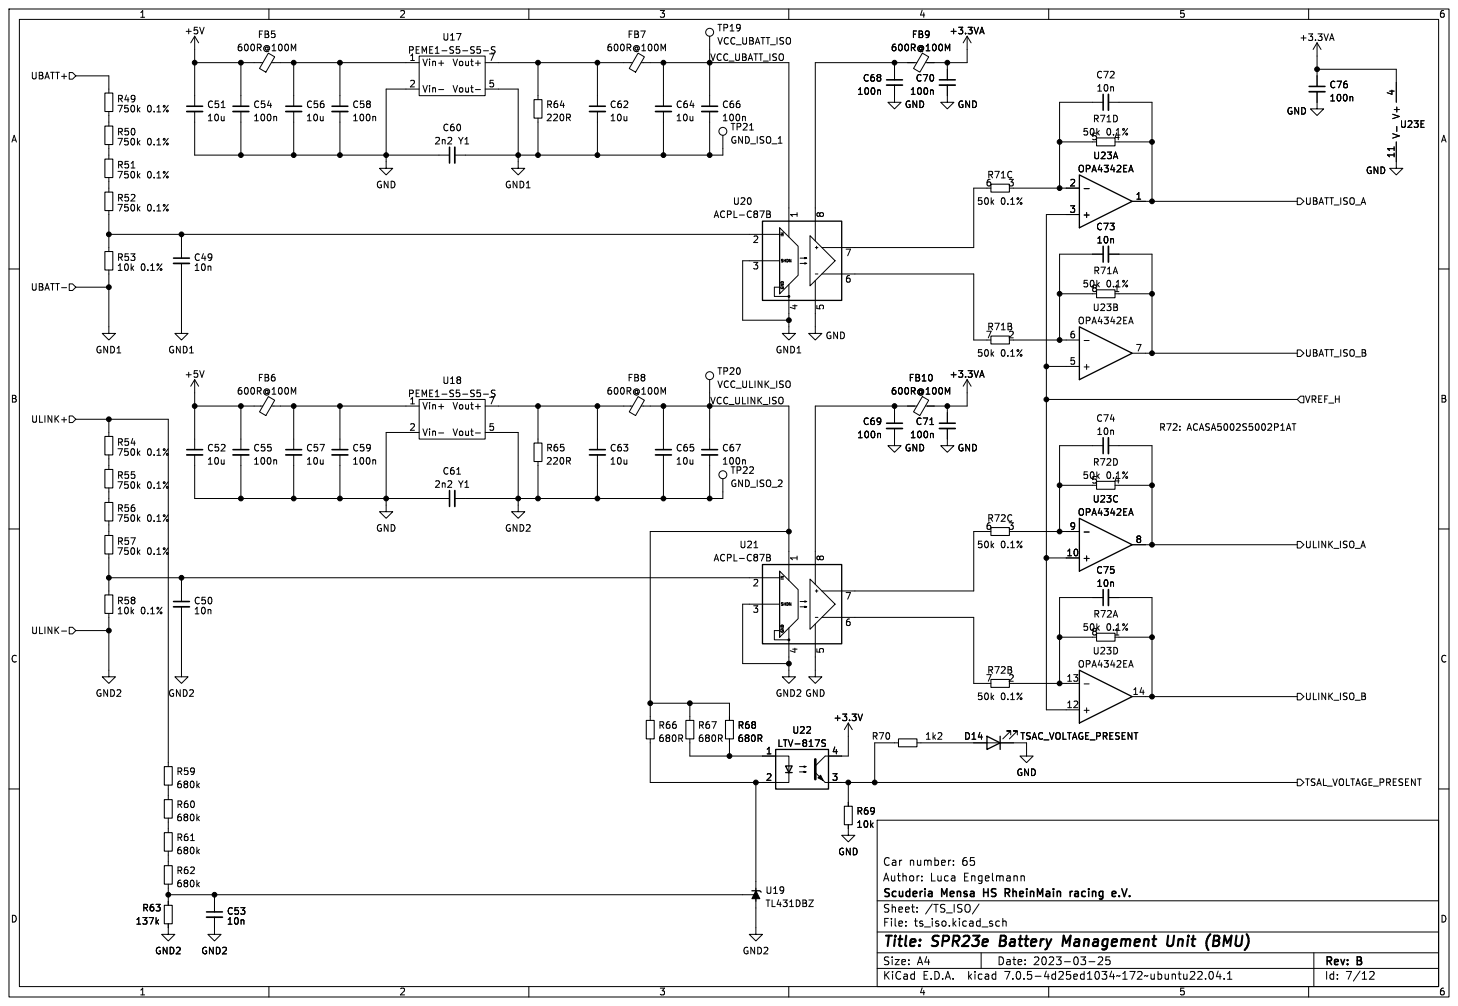
[picture p38: page 7]

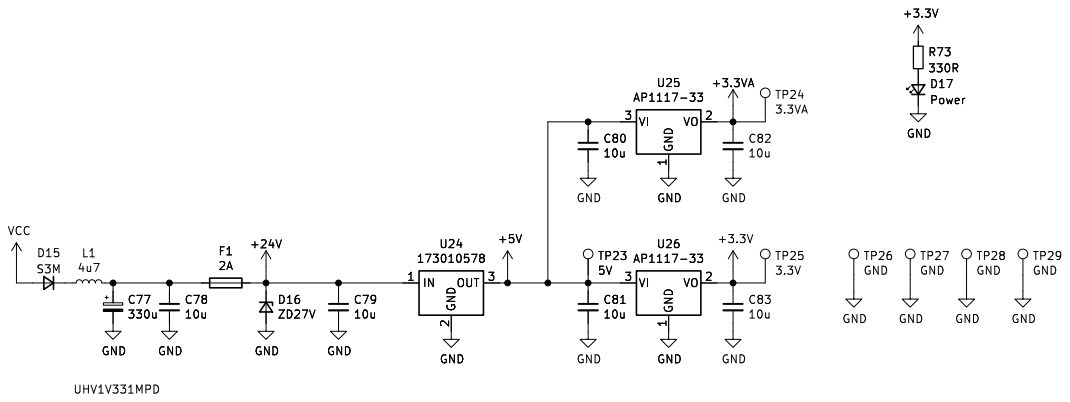
[picture p39: page 8]

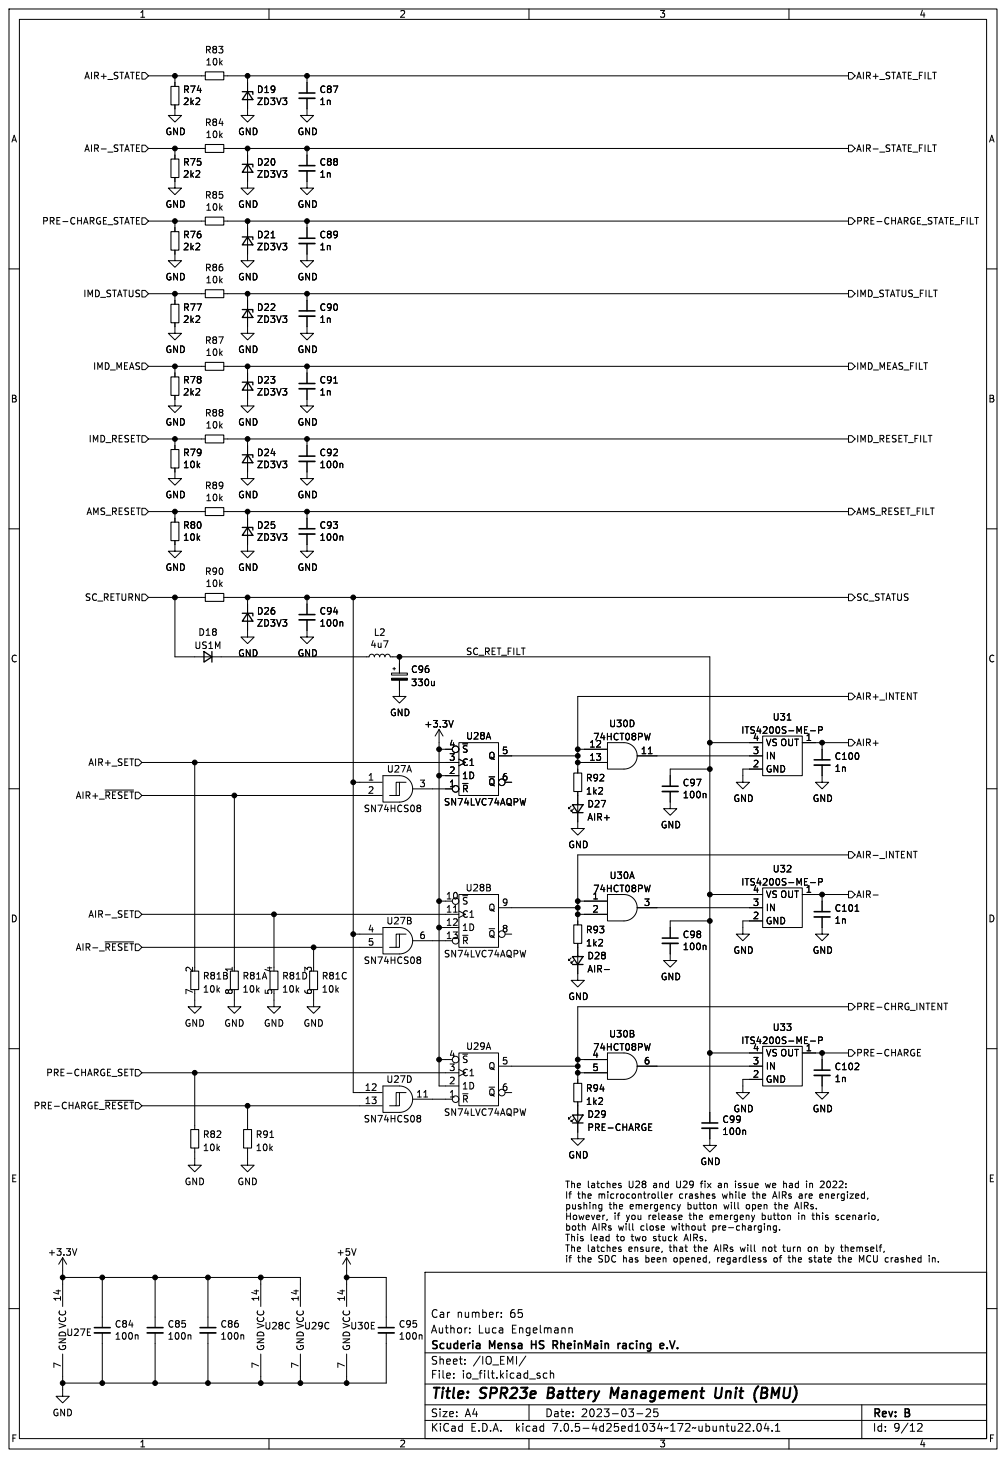
[picture p40: page 9]

GND GND VCC 14 GND

The latches U28 and U29 fix an issue we had in 2022:
pushing the emergency button will open the AIRs. However, if you release the emergeny button in this scenario, both AIRs will close without pre-charging. This lead to two stuck AIRs. The latches ensure, that the AIRs will not turn on by themself,

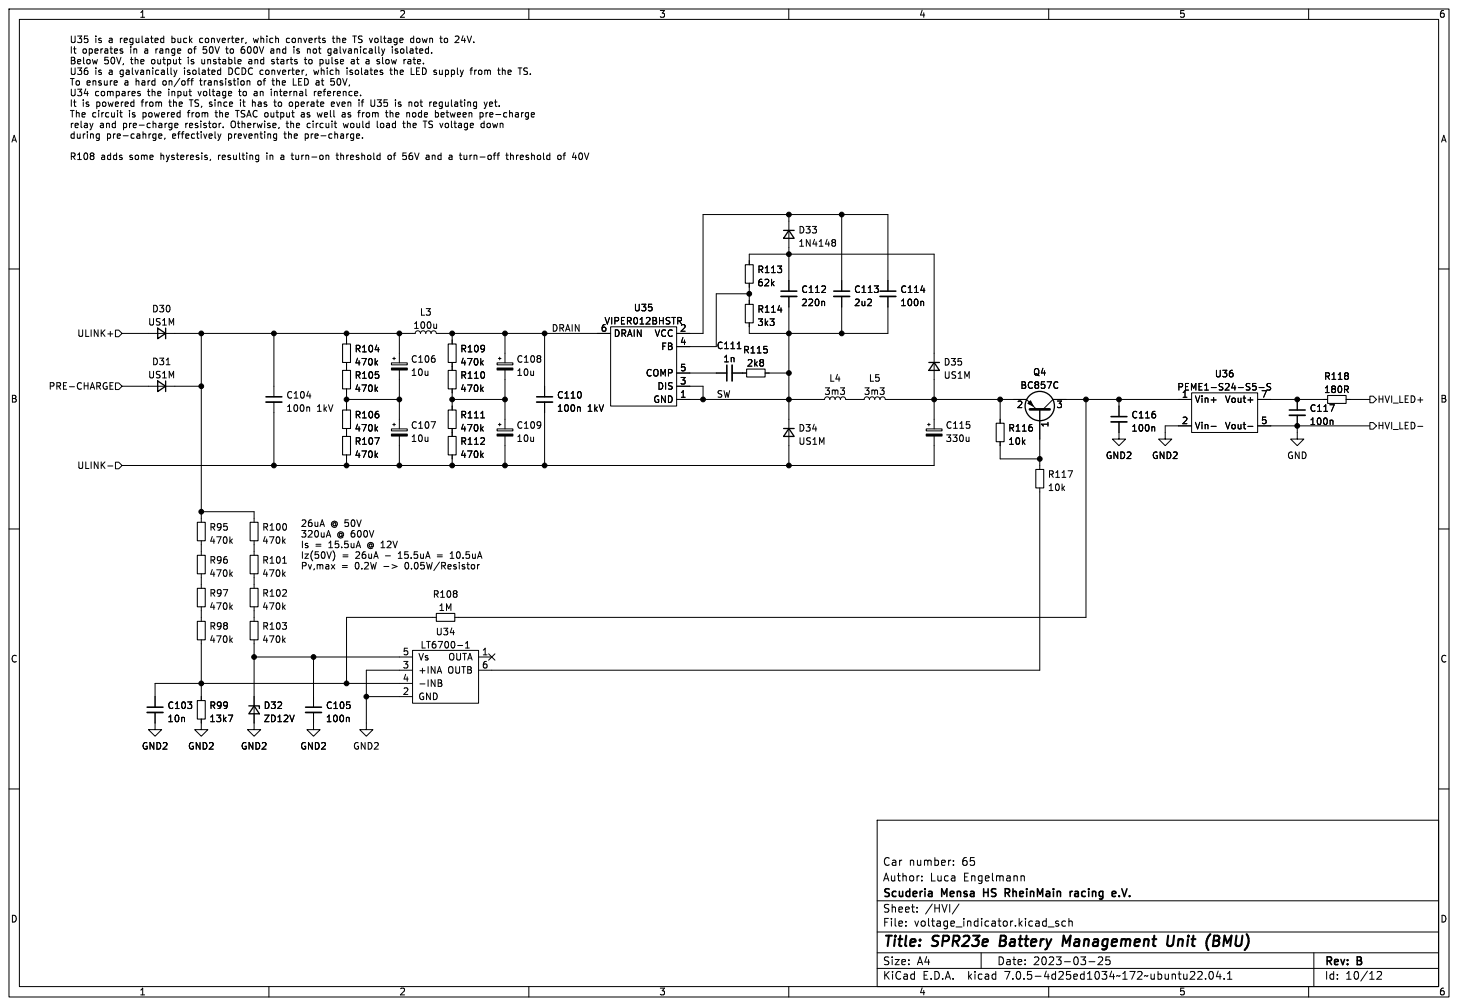
[picture p41: page 10]

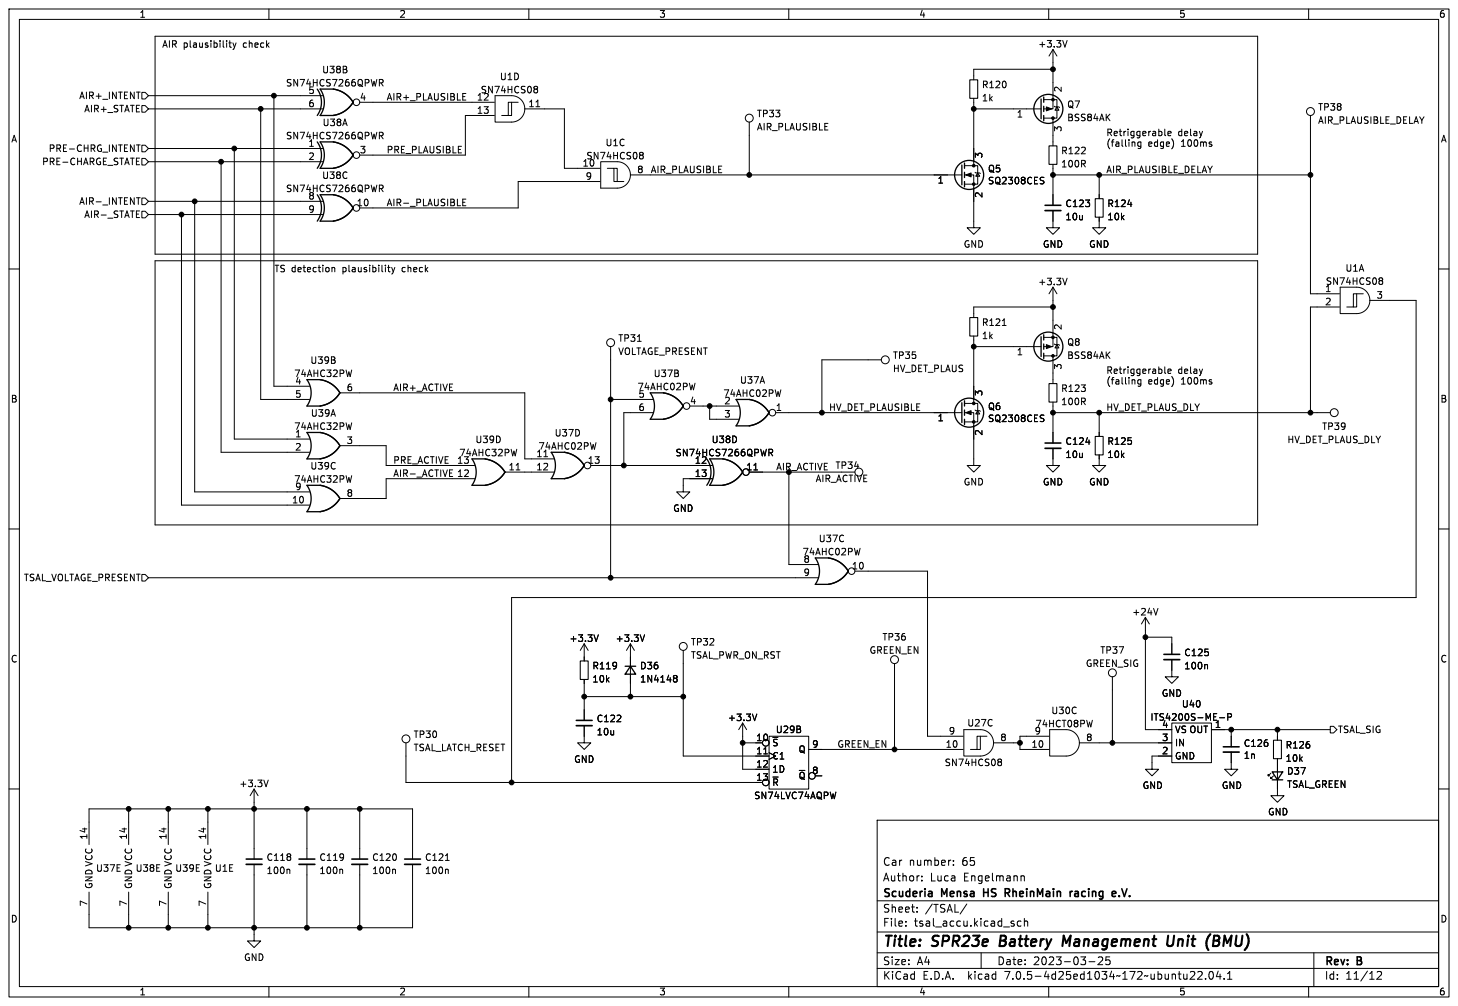
[picture p42: page 11]

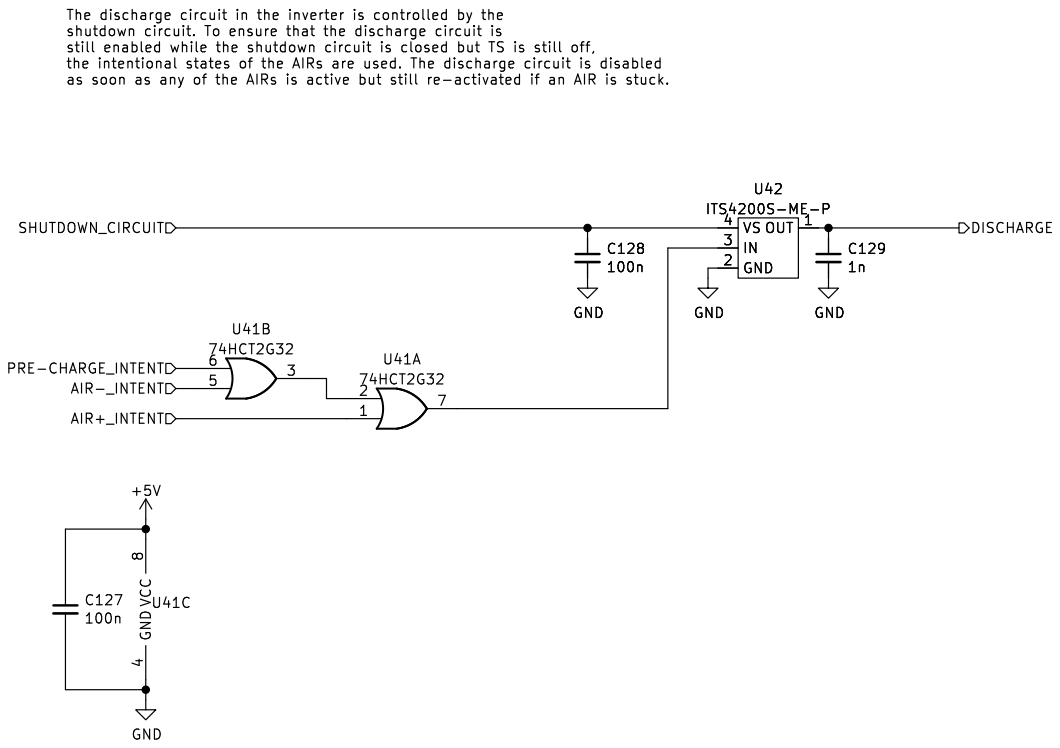
[picture p43: page 12]
