derlucae98/spr23e-bmu/KiCad/spr23e-bmu.kicad_pcb

## KiCad design KiCad/spr23e-bmu.kicad_pcb (2023-07-14)

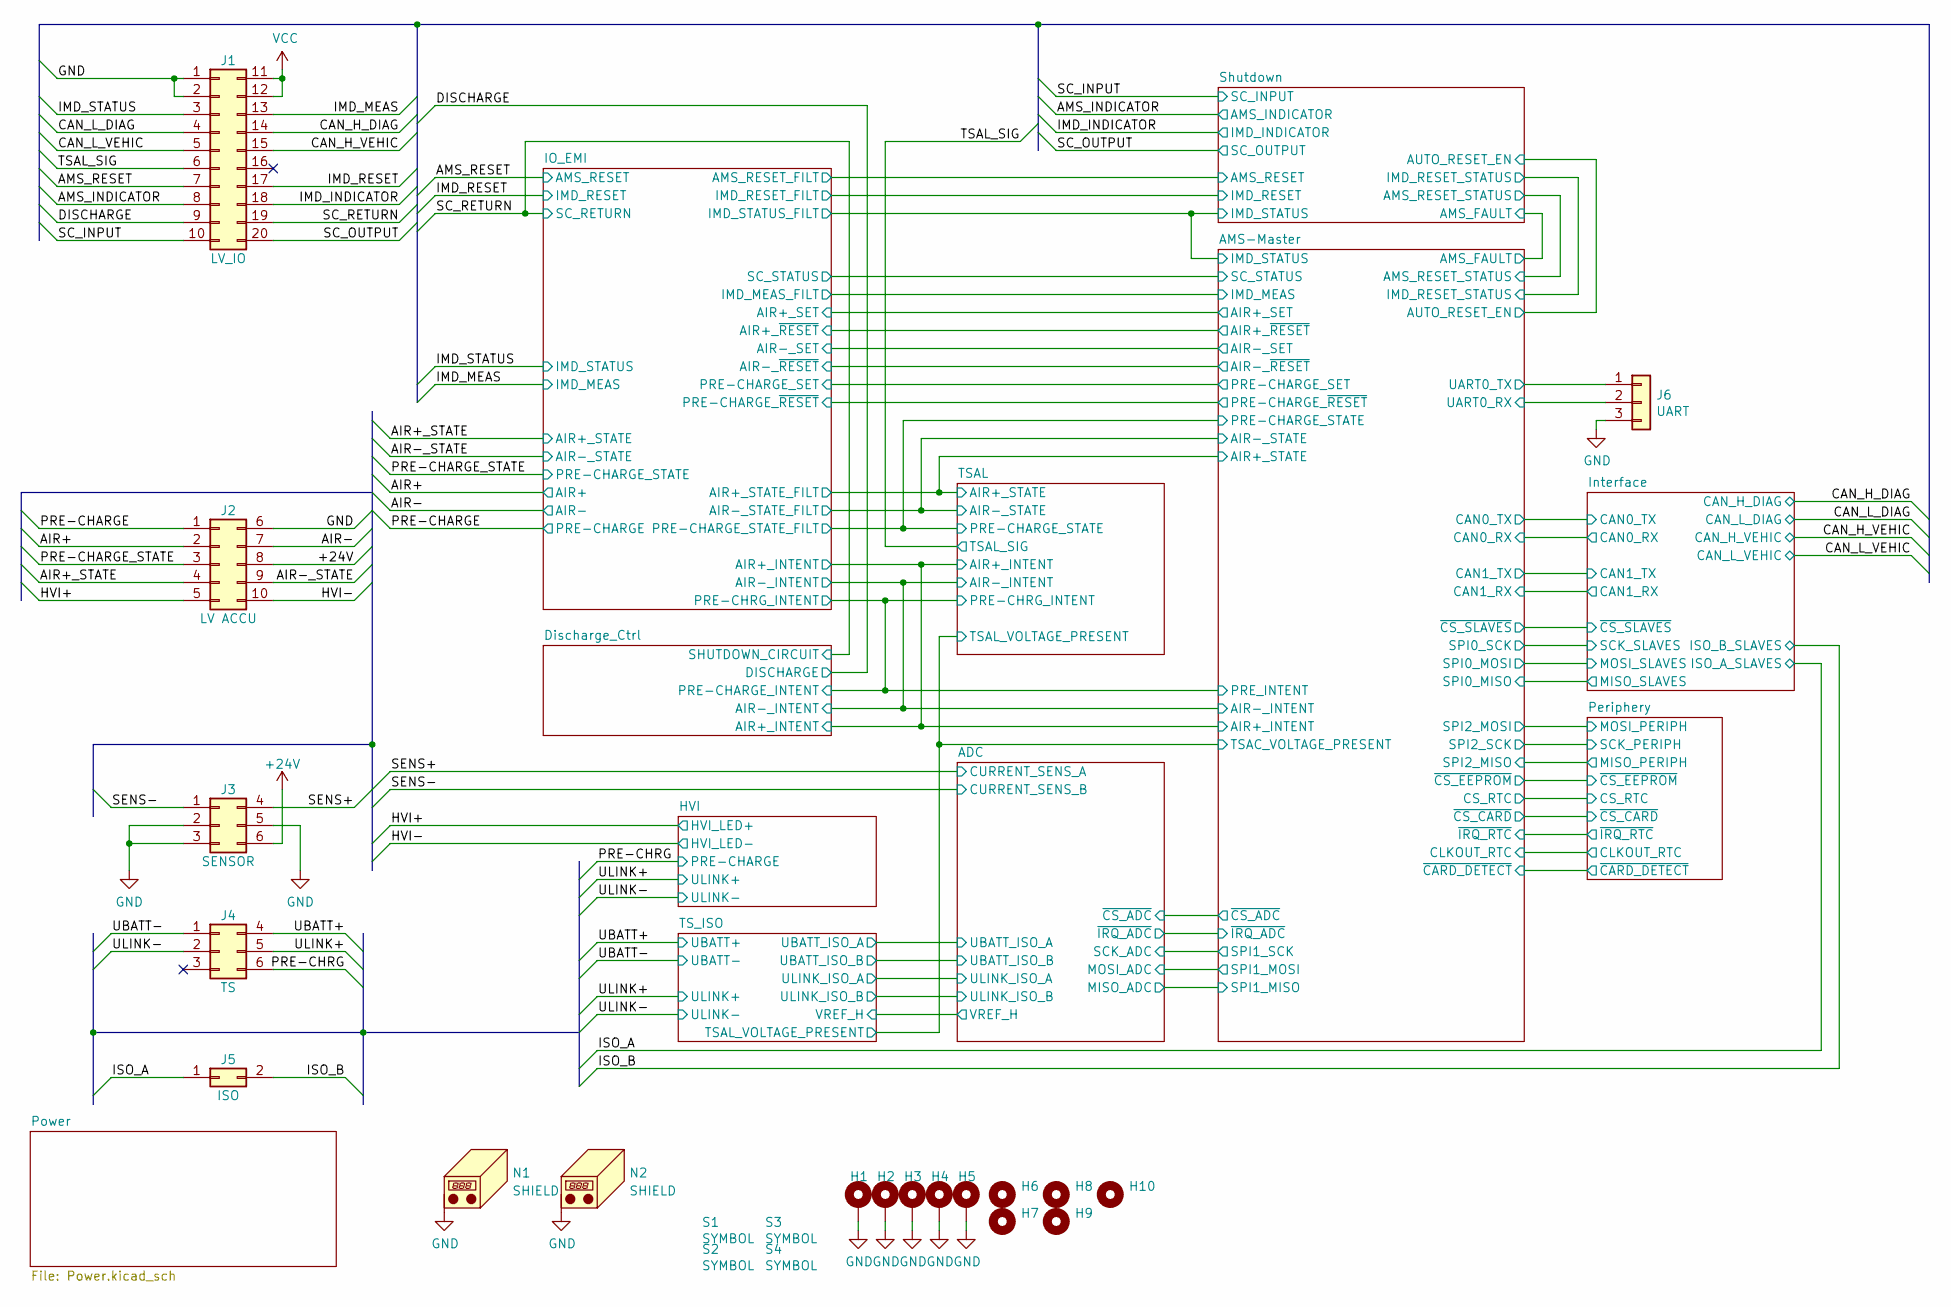
[picture p44: schematic spr23e-bmu.kicad_sch, SPR23e Battery Management Unit (BMU)]

Parts:
H1, H2, H3, H4, H5: MountingHole_4.3mm_M4_Pad_Via
H6, H7, H8, H9, H10: MountingHole_4.3mm_M4_ISO14580
J1: LV_IO; Molex_Micro-Fit_3.0_43045-2000_2x10_P3.00mm_Horizontal
J2: LV ACCU; Molex_Micro-Fit_3.0_43045-1000_2x05_P3.00mm_Horizontal
J3: SENSOR; Molex_Micro-Fit_3.0_43045-0600_2x03_P3.00mm_Horizontal
J4: TS; Molex_Micro-Fit_3.0_43045-0600_2x03_P3.00mm_Horizontal
J5: ISO; Molex_Micro-Fit_3.0_43045-0200_2x01_P3.00mm_Horizontal
J6: UART; PinHeader_1x03_P2.54mm_Vertical
N1, N2: SHIELD; SHIELD_FINGER_TE_1734303-1
S1: SYMBOL; Scuderia-Logo-Klein
S2: SYMBOL; Wappen-klein
S3, S4: SYMBOL; HV_WARNING_SMALL

Connections:
+24V: J2.8, J3.6; also elsewhere on the board
/AIR+: J2.2; also elsewhere on the board
/AIR+_STATE: J2.4; also elsewhere on the board
/AIR-: J2.7; also elsewhere on the board
/AIR-_STATE: J2.9; also elsewhere on the board
/AMS-Master/UART0_RX: J6.2; also elsewhere on the board
/AMS-Master/UART0_TX: J6.1; also elsewhere on the board
/AMS_INDICATOR: J1.8; also elsewhere on the board
/AMS_RESET: J1.7; also elsewhere on the board
/CAN_H_DIAG: J1.14; also elsewhere on the board
/CAN_H_VEHIC: J1.15; also elsewhere on the board
/CAN_L_DIAG: J1.4; also elsewhere on the board
/CAN_L_VEHIC: J1.5; also elsewhere on the board
/DISCHARGE: J1.9; also elsewhere on the board
/HVI+: J2.5; also elsewhere on the board
/IMD_INDICATOR: J1.18; also elsewhere on the board
/IMD_MEAS: J1.13; also elsewhere on the board
/IMD_RESET: J1.17; also elsewhere on the board
/IMD_STATUS: J1.3; also elsewhere on the board
/ISO_A: J5.1; also elsewhere on the board
/ISO_B: J5.2; also elsewhere on the board
/PRE-CHARGE: J2.1; also elsewhere on the board
/PRE-CHARGE_STATE: J2.3; also elsewhere on the board
/PRE-CHRG: J4.6; also elsewhere on the board
/SC_INPUT: J1.10; also elsewhere on the board
/SC_OUTPUT: J1.20; also elsewhere on the board
/SC_RETURN: J1.19; also elsewhere on the board
/SENS+: J3.4; also elsewhere on the board
/SENS-: J3.1; also elsewhere on the board
/TSAL_SIG: J1.6; also elsewhere on the board
/UBATT+: J4.4; also elsewhere on the board
/ULINK+: J4.5; also elsewhere on the board
GND: H1.1, H2.1, H3.1, H4.1, H5.1, J1.1, J1.2, J2.6, J2.10, J3.2, J3.3, J3.5, J6.3, N1.1 (PAD), N2.1 (PAD); also elsewhere on the board
GND1: J4.1; also elsewhere on the board
GND2: J4.2; also elsewhere on the board
VCC: J1.11, J1.12; also elsewhere on the board

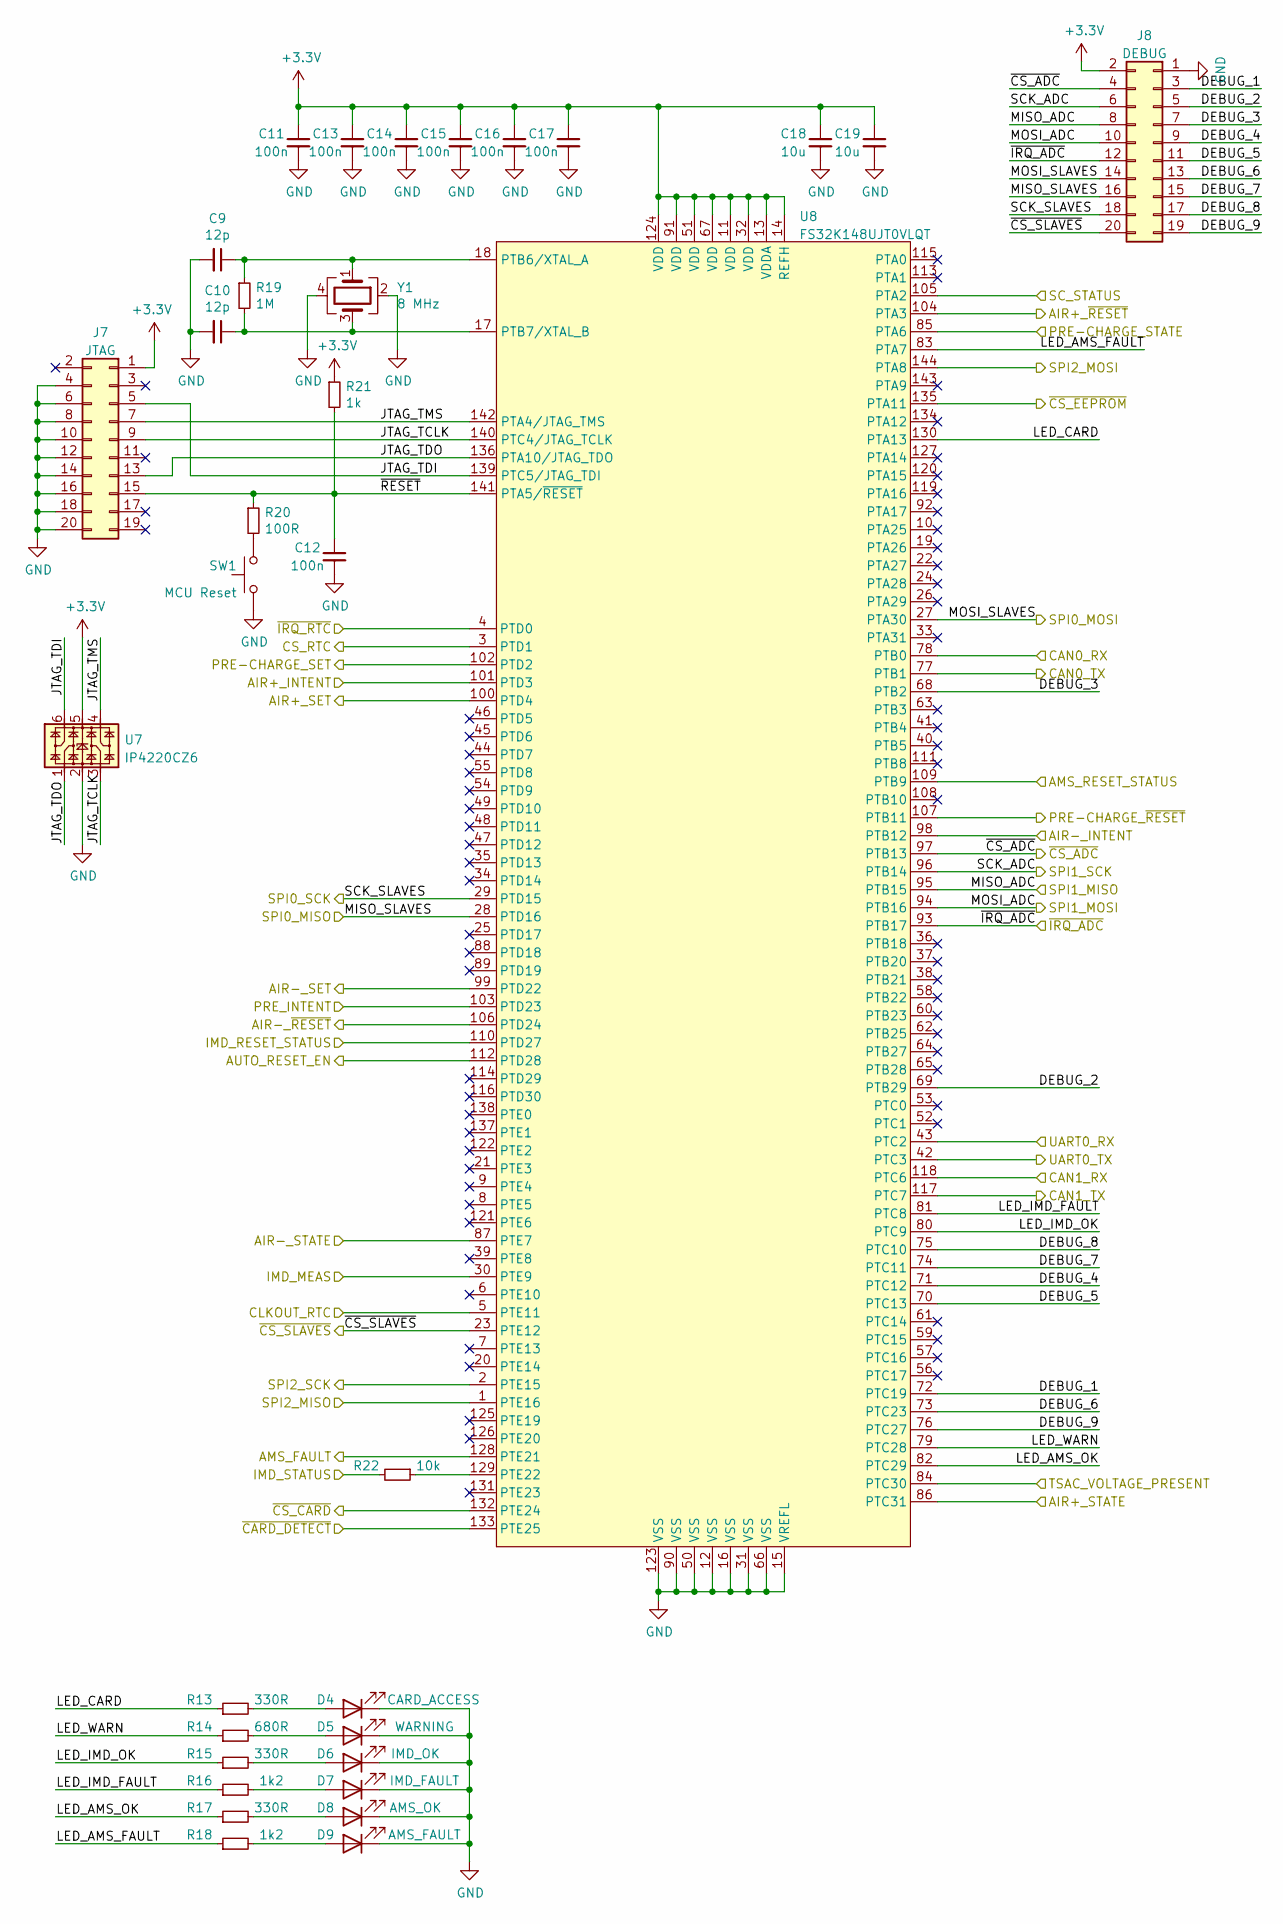
[picture p45: schematic AMS-Master.kicad_sch, SPR23e Battery Management Unit (BMU)]

Parts:
C9, C10: 12p; C_0603_1608Metric
C11, C12, C13, C14, C15, C16, C17: 100n; C_0603_1608Metric
C18, C19: 10u; C_1206_3216Metric
D4: CARD_ACCESS; LED_0603_1608Metric
D5: WARNING; LED_0603_1608Metric
D6: IMD_OK; LED_0603_1608Metric
D7: IMD_FAULT; LED_0603_1608Metric
D8: AMS_OK; LED_0603_1608Metric
D9: AMS_FAULT; LED_0603_1608Metric
J7: JTAG; IDC-Header_2x10_P2.54mm_Horizontal
J8: DEBUG; PinHeader_2x10_P2.54mm_Vertical
R13, R15, R17: 330R; R_0603_1608Metric
R14: 680R; R_0603_1608Metric
R16, R18: 1k2; R_0603_1608Metric
R19: 1M; R_0603_1608Metric
R20: 100R; R_0603_1608Metric
R21: 1k; R_0603_1608Metric
R22: 10k; R_0603_1608Metric
SW1: MCU Reset; SW_Push_1P1T_NO_6x6mm_H9.5mm
U7: IP4220CZ6; SOT-363_SC-70-6
U8: FS32K148UJT0VLQT; LQFP-144_20x20mm_P0.5mm
Y1: 8 MHz; Crystal_SMD_SeikoEpson_FA238V-4Pin_3.2x2.5mm

Connections:
+3.3V: C11.1, C13.1, C14.1, C15.1, C16.1, C17.1, C18.1, C19.1, J7.1, J8.2, R21.1, U7.5, U8.11 (VDD), U8.13 (VDDA), U8.14 (REFH), U8.32 (VDD), U8.51 (VDD), U8.67 (VDD), U8.91 (VDD), U8.124 (VDD); also elsewhere on the board
/AMS-Master/AIR+_INTENT: U8.101 (PTD3); also elsewhere on the board
/AMS-Master/AIR+_SET: U8.100 (PTD4); also elsewhere on the board
/AMS-Master/AIR+_STATE: U8.86 (PTC31); also elsewhere on the board
/AMS-Master/AIR+_~RESET: U8.104 (PTA3); also elsewhere on the board
/AMS-Master/AIR-_INTENT: U8.98 (PTB12); also elsewhere on the board
/AMS-Master/AIR-_SET: U8.99 (PTD22); also elsewhere on the board
/AMS-Master/AIR-_STATE: U8.87 (PTE7); also elsewhere on the board
/AMS-Master/AIR-_~RESET: U8.106 (PTD24); also elsewhere on the board
/AMS-Master/AMS_FAULT: U8.128 (PTE21); also elsewhere on the board
/AMS-Master/AMS_RESET_STATUS: U8.109 (PTB9); also elsewhere on the board
/AMS-Master/AUTO_RESET_EN: U8.112 (PTD28); also elsewhere on the board
/AMS-Master/CAN0_RX: U8.78 (PTB0); also elsewhere on the board
/AMS-Master/CAN0_TX: U8.77 (PTB1); also elsewhere on the board
/AMS-Master/CAN1_RX: U8.118 (PTC6); also elsewhere on the board
/AMS-Master/CAN1_TX: U8.117 (PTC7); also elsewhere on the board
/AMS-Master/CLKOUT_RTC: U8.5 (PTE11); also elsewhere on the board
/AMS-Master/CS_RTC: U8.3 (PTD1); also elsewhere on the board
/AMS-Master/DEBUG_1: J8.3, U8.72 (PTC19)
/AMS-Master/DEBUG_2: J8.5, U8.69 (PTB29)
/AMS-Master/DEBUG_3: J8.7, U8.68 (PTB2)
/AMS-Master/DEBUG_4: J8.9, U8.71 (PTC12)
/AMS-Master/DEBUG_5: J8.11, U8.70 (PTC13)
/AMS-Master/DEBUG_6: J8.13, U8.73 (PTC23)
/AMS-Master/DEBUG_7: J8.15, U8.74 (PTC11)
/AMS-Master/DEBUG_8: J8.17, U8.75 (PTC10)
/AMS-Master/DEBUG_9: J8.19, U8.76 (PTC27)
/AMS-Master/IMD_MEAS: U8.30 (PTE9); also elsewhere on the board
/AMS-Master/IMD_RESET_STATUS: U8.110 (PTD27); also elsewhere on the board
/AMS-Master/IMD_STATUS: R22.2; also elsewhere on the board
/AMS-Master/JTAG_TCLK: J7.9, U7.3, U8.140 (PTC4/JTAG_TCLK)
/AMS-Master/JTAG_TDI: J7.5, U7.6, U8.139 (PTC5/JTAG_TDI)
/AMS-Master/JTAG_TDO: J7.13, U7.1, U8.136 (PTA10/JTAG_TDO)
/AMS-Master/JTAG_TMS: J7.7, U7.4, U8.142 (PTA4/JTAG_TMS)
/AMS-Master/LED_AMS_FAULT: R18.1, U8.83 (PTA7)
/AMS-Master/LED_AMS_OK: R17.1, U8.82 (PTC29)
/AMS-Master/LED_CARD: R13.1, U8.130 (PTA13)
/AMS-Master/LED_IMD_FAULT: R16.1, U8.81 (PTC8)
/AMS-Master/LED_IMD_OK: R15.1, U8.80 (PTC9)
/AMS-Master/LED_WARN: R14.1, U8.79 (PTC28)
/AMS-Master/MISO_ADC: J8.8, U8.95 (PTB15); also elsewhere on the board
/AMS-Master/MISO_SLAVES: J8.16, U8.28 (PTD16); also elsewhere on the board
/AMS-Master/MOSI_ADC: J8.10, U8.94 (PTB16); also elsewhere on the board
/AMS-Master/MOSI_SLAVES: J8.14, U8.27 (PTA30); also elsewhere on the board
/AMS-Master/PRE-CHARGE_SET: U8.102 (PTD2); also elsewhere on the board
/AMS-Master/PRE-CHARGE_STATE: U8.85 (PTA6); also elsewhere on the board
/AMS-Master/PRE-CHARGE_~RESET: U8.107 (PTB11); also elsewhere on the board
/AMS-Master/PRE_INTENT: U8.103 (PTD23); also elsewhere on the board
/AMS-Master/SCK_ADC: J8.6, U8.96 (PTB14); also elsewhere on the board
/AMS-Master/SCK_SLAVES: J8.18, U8.29 (PTD15); also elsewhere on the board
/AMS-Master/SC_STATUS: U8.105 (PTA2); also elsewhere on the board
/AMS-Master/SPI2_MISO: U8.1 (PTE16); also elsewhere on the board
/AMS-Master/SPI2_MOSI: U8.144 (PTA8); also elsewhere on the board
/AMS-Master/SPI2_SCK: U8.2 (PTE15); also elsewhere on the board
/AMS-Master/TSAC_VOLTAGE_PRESENT: U8.84 (PTC30); also elsewhere on the board
/AMS-Master/UART0_RX: U8.43 (PTC2); also elsewhere on the board
/AMS-Master/UART0_TX: U8.42 (PTC3); also elsewhere on the board
/AMS-Master/~CARD_DETECT: U8.133 (PTE25); also elsewhere on the board
/AMS-Master/~CS_ADC: J8.4, U8.97 (PTB13); also elsewhere on the board
/AMS-Master/~CS_CARD: U8.132 (PTE24); also elsewhere on the board
/AMS-Master/~CS_EEPROM: U8.135 (PTA11); also elsewhere on the board
/AMS-Master/~CS_SLAVES: J8.20, U8.23 (PTE12); also elsewhere on the board
/AMS-Master/~IRQ_ADC: J8.12, U8.93 (PTB17); also elsewhere on the board
/AMS-Master/~IRQ_RTC: U8.4 (PTD0); also elsewhere on the board
/AMS-Master/~RESET: C12.1, J7.15, R20.1, R21.2, U8.141 (PTA5/~RESET)
GND: C9.2, C10.2, C11.2, C12.2, C13.2, C14.2, C15.2, C16.2, C17.2, C18.2, C19.2, D4.1 (K), D5.1 (K), D6.1 (K), D7.1 (K), D8.1 (K), D9.1 (K), J7.4, J7.6, J7.8, J7.10, J7.12, J7.14, J7.16, J7.18, J7.20, J8.1, SW1.1, U7.2, U8.12 (VSS), U8.15 (VREFL), U8.16 (VSS), U8.31 (VSS), U8.50 (VSS), U8.66 (VSS), U8.90 (VSS), U8.123 (VSS), Y1.2, Y1.4; also elsewhere on the board
unnamed: D4.2 (A), R13.2
unnamed: D5.2 (A), R14.2
unnamed: D6.2 (A), R15.2
unnamed: D7.2 (A), R16.2
unnamed: D8.2 (A), R17.2
unnamed: D9.2 (A), R18.2
unnamed: R20.2, SW1.2
unnamed: C9.1, R19.1, U8.18 (PTB6/XTAL_A), Y1.1
unnamed: C10.1, R19.2, U8.17 (PTB7/XTAL_B), Y1.3
unnamed: R22.1, U8.129 (PTE22)

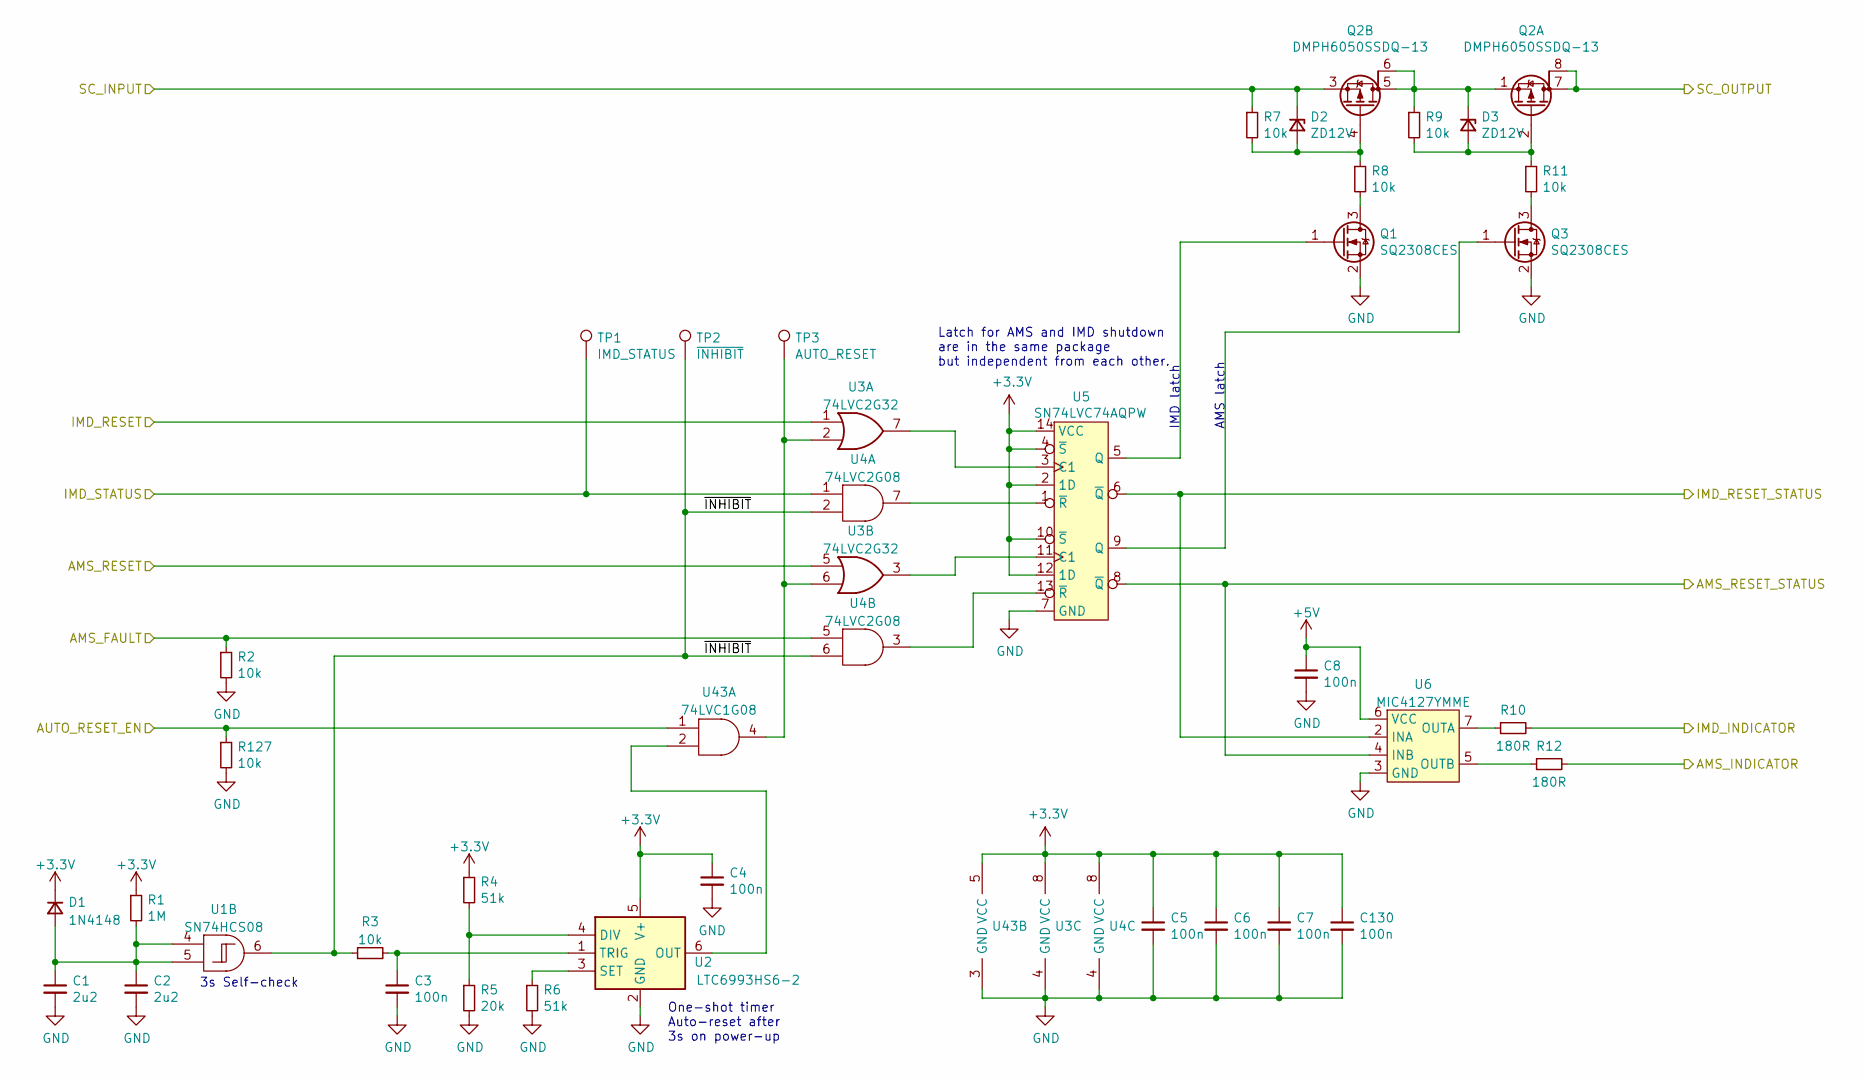
[picture p46: schematic Shutdown.kicad_sch, SPR23e Battery Management Unit (BMU)]

Parts:
C1, C2: 2u2; C_0805_2012Metric
C3, C4, C5, C6, C7, C8, C130: 100n; C_0603_1608Metric
D1: 1N4148; D_SOD-123
D2, D3: ZD12V; D_SOD-123
Q1, Q3: SQ2308CES; SOT-23
Q2: DMPH6050SSDQ-13; SOIC-8_3.9x4.9mm_P1.27mm
R1: 1M; R_0603_1608Metric
R2, R3, R7, R8, R9, R11, R127: 10k; R_0603_1608Metric
R4, R6: 51k; R_0603_1608Metric
R5: 20k; R_0603_1608Metric
R10, R12: 180R; R_0603_1608Metric
TP1: IMD_STATUS; TestPoint_Pad_D1.5mm
TP2: ~{INHIBIT}; TestPoint_Pad_D1.5mm
TP3: AUTO_RESET; TestPoint_Pad_D1.5mm
U1: SN74HCS08; TSSOP-14_4.4x5mm_P0.65mm
U2: LTC6993HS6-2; TSOT-23-6
U3: 74LVC2G32; VSSOP-8_2.4x2.1mm_P0.5mm
U4: 74LVC2G08; VSSOP-8_2.4x2.1mm_P0.5mm
U5: SN74LVC74AQPW; TSSOP-14_4.4x5mm_P0.65mm
U6: MIC4127YMME; MSOP-8-1EP_3x3mm_P0.65mm_EP1.95x2.15mm_ThermalVias
U43: 74LVC1G08; SOT-23-5

Connections:
+3.3V: C4.1, C5.1, C6.1, C7.1, C130.1, D1.1 (K), R1.1, R4.1, U2.5 (V+), U3.8 (VCC), U4.8 (VCC), U5.2 (1D), U5.4 (~S), U5.10 (~S), U5.12 (1D), U5.14 (VCC), U43.5 (VCC); also elsewhere on the board
+5V: C8.1, U6.6 (VCC); also elsewhere on the board
/AMS-Master/AMS_FAULT: R2.1, U4.5; also elsewhere on the board
/AMS-Master/AMS_RESET_STATUS: U5.8 (~Q), U6.4 (INB); also elsewhere on the board
/AMS-Master/AUTO_RESET_EN: R127.1, U43.1; also elsewhere on the board
/AMS-Master/IMD_RESET_STATUS: U5.6 (~Q), U6.2 (INA); also elsewhere on the board
/AMS-Master/IMD_STATUS: TP1.1, U4.1; also elsewhere on the board
/AMS_INDICATOR: R12.2; also elsewhere on the board
/IMD_INDICATOR: R10.2; also elsewhere on the board
/IO_EMI/AMS_RESET_FILT: U3.5; also elsewhere on the board
/IO_EMI/IMD_RESET_FILT: U3.1; also elsewhere on the board
/SC_INPUT: D2.1 (K), Q2.3 (S), R7.1; also elsewhere on the board
/SC_OUTPUT: Q2.7 (D), Q2.8 (G); also elsewhere on the board
/Shutdown/~INHIBIT: R3.1, TP2.1, U1.6, U4.2, U4.6
GND: C1.2, C2.2, C3.2, C4.2, C5.2, C6.2, C7.2, C8.2, C130.2, Q1.2 (S), Q3.2 (S), R2.2, R5.2, R6.2, R127.2, U2.2 (GND), U3.4 (GND), U4.4 (GND), U5.7 (GND), U6.3 (GND), U6.9 (GND), U43.3 (GND); also elsewhere on the board
unnamed: C1.1, C2.1, D1.2 (A), R1.2, U1.4, U1.5
unnamed: D2.2 (A), Q2.4 (G), R7.2, R8.1
unnamed: D3.2 (A), Q2.2 (G), R9.2, R11.1
unnamed: D3.1 (K), Q2.1 (S), Q2.5 (D), Q2.6 (G), R9.1
unnamed: Q1.3 (D), R8.2
unnamed: Q1.1 (G), U5.5 (Q)
unnamed: Q3.3 (D), R11.2
unnamed: Q3.1 (G), U5.9 (Q)
unnamed: TP3.1, U3.2, U3.6, U43.4
unnamed: R4.2, R5.1, U2.4 (DIV)
unnamed: U2.6 (OUT), U43.2
unnamed: R6.1, U2.3 (SET)
unnamed: C3.1, R3.2, U2.1 (TRIG)
unnamed: U3.3, U5.11 (C1)
unnamed: U3.7, U5.3 (C1)
unnamed: U4.3, U5.13 (~R)
unnamed: U4.7, U5.1 (~R)
unnamed: R10.1, U6.7 (OUTA)
unnamed: R12.1, U6.5 (OUTB)

Notes on the sheet:
Latch for AMS and IMD shutdown are in the same package but independent from each other.
3s Self-check
One-shot timer Auto-reset after 3s on power-up
AMS latch
IMD latch

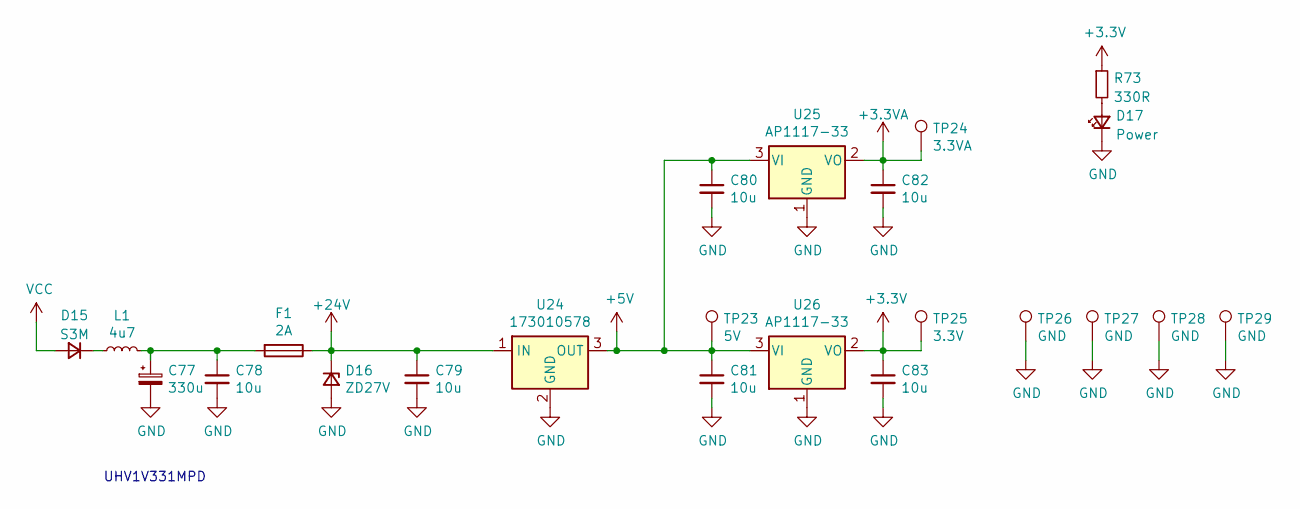
[picture p47: schematic Power.kicad_sch, SPR23e Battery Management Unit (BMU)]

Parts:
C77: 330u; CP_Radial_D10.0mm_P5.00mm
C78, C79, C80, C81, C82, C83: 10u; C_1206_3216Metric
D15: S3M; D_SMC
D16: ZD27V; D_SMB
D17: Power; LED_0603_1608Metric
F1: 2A; 0154xxxxxxx
L1: 4u7; L_1206_3216Metric
R73: 330R; R_0603_1608Metric
TP23: 5V; TestPoint_Keystone_5010-5014_Multipurpose
TP24: 3.3VA; TestPoint_Keystone_5010-5014_Multipurpose
TP25: 3.3V; TestPoint_Keystone_5010-5014_Multipurpose
TP26, TP27, TP28, TP29: GND; TestPoint_Keystone_5010-5014_Multipurpose
U24: 173010578; Converter_DCDC_TRACO_TSR-1_THT
U25, U26: AP1117-33; SOT-223-3_TabPin2

Connections:
+3.3V: C83.1, R73.1, TP25.1, U26.2 (VO); also elsewhere on the board
+3.3VA: C82.1, TP24.1, U25.2 (VO); also elsewhere on the board
+5V: C80.1, C81.1, TP23.1, U24.3 (OUT), U25.3 (VI), U26.3 (VI); also elsewhere on the board
+24V: C79.1, D16.1 (K), F1.1, U24.1 (IN); also elsewhere on the board
GND: C77.2, C78.2, C79.2, C80.2, C81.2, C82.2, C83.2, D16.2 (A), D17.1 (K), TP26.1, TP27.1, TP28.1, TP29.1, U24.2 (GND), U25.1 (GND), U26.1 (GND); also elsewhere on the board
unnamed: C77.1, C78.1, F1.2, L1.2
unnamed: D15.1 (K), L1.1
unnamed: D17.2 (A), R73.2
VCC: D15.2 (A); also elsewhere on the board

Notes on the sheet:
UHV1V331MPD

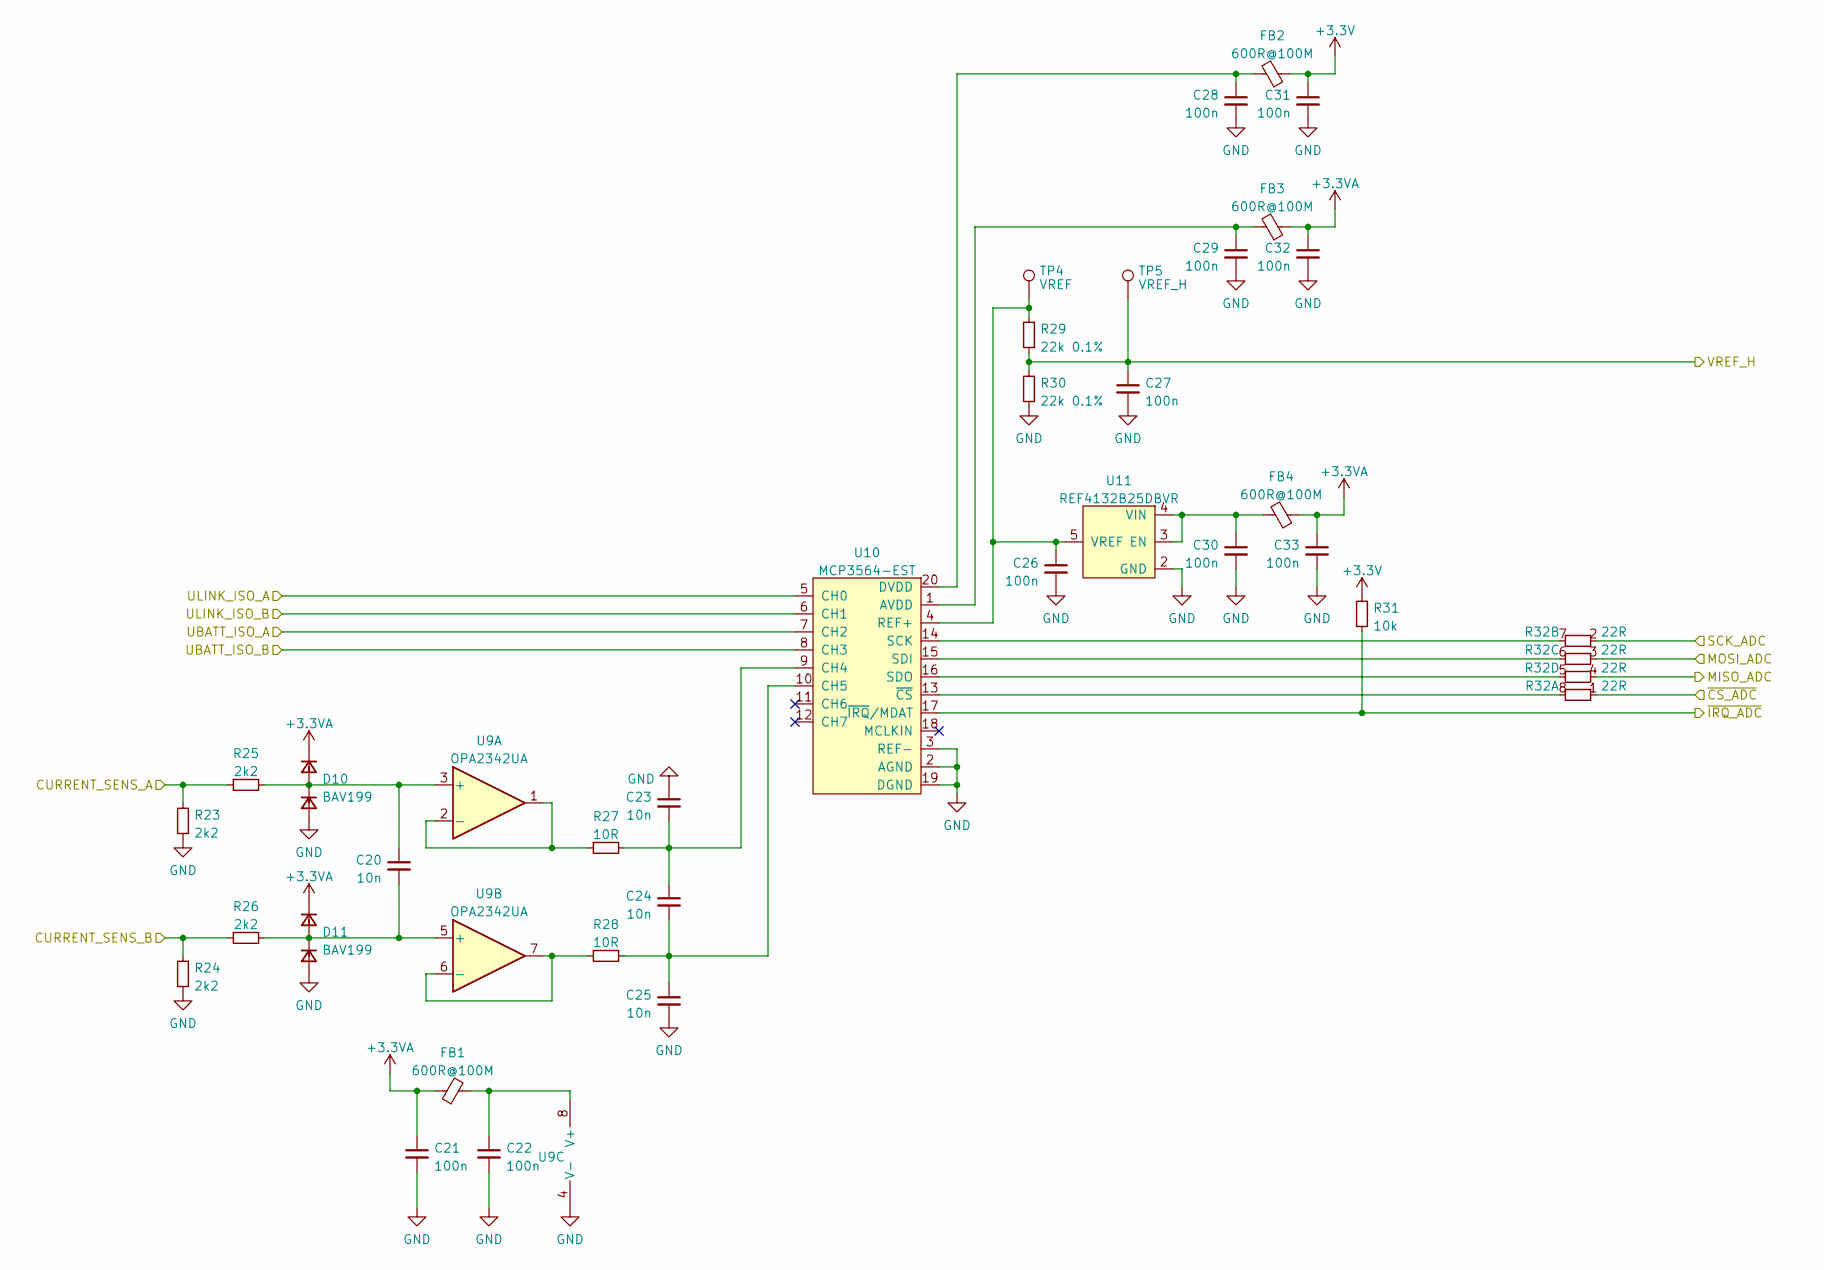
[picture p48: schematic ADC.kicad_sch, SPR23e Battery Management Unit (BMU)]

Parts:
C20, C23, C24, C25: 10n; C_0603_1608Metric
C21, C22, C26, C27, C28, C29, C30, C31, C32, C33: 100n; C_0603_1608Metric
D10, D11: BAV199; SOT-23
FB1, FB2, FB3, FB4: 600R@100M; L_0603_1608Metric
R23, R24, R25, R26: 2k2; R_0603_1608Metric
R27, R28: 10R; R_0603_1608Metric
R29, R30: 22k 0.1%; R_0603_1608Metric
R31: 10k; R_0603_1608Metric
R32: 22R; R_Array_Convex_4x0603
TP4: VREF; TestPoint_Pad_D1.5mm
TP5: VREF_H; TestPoint_Pad_D1.5mm
U9: OPA2342UA; SOIC-8_3.9x4.9mm_P1.27mm
U10: MCP3564-EST; TSSOP-20_4.4x6.5mm_P0.65mm
U11: REF4132B25DBVR; SOT-23-5

Connections:
+3.3V: C31.1, FB2.1, R31.1; also elsewhere on the board
+3.3VA: C21.1, C32.1, C33.1, D10.2 (K), D11.2 (K), FB1.1, FB3.1, FB4.1; also elsewhere on the board
/ADC/UBATT_ISO_A: U10.7 (CH2); also elsewhere on the board
/ADC/UBATT_ISO_B: U10.8 (CH3); also elsewhere on the board
/ADC/ULINK_ISO_A: U10.5 (CH0); also elsewhere on the board
/ADC/ULINK_ISO_B: U10.6 (CH1); also elsewhere on the board
/ADC/VREF_H: C27.1, R29.2, R30.1, TP5.1; also elsewhere on the board
/AMS-Master/MISO_ADC: R32.4; also elsewhere on the board
/AMS-Master/MOSI_ADC: R32.3; also elsewhere on the board
/AMS-Master/SCK_ADC: R32.2; also elsewhere on the board
/AMS-Master/~CS_ADC: R32.1; also elsewhere on the board
/AMS-Master/~IRQ_ADC: R31.2, U10.17 (~IRQ/MDAT); also elsewhere on the board
/SENS+: R23.1, R25.1; also elsewhere on the board
/SENS-: R24.1, R26.1; also elsewhere on the board
GND: C21.2, C22.2, C23.1, C25.2, C26.2, C27.2, C28.2, C29.2, C30.2, C31.2, C32.2, C33.2, D10.1 (A), D11.1 (A), R23.2, R24.2, R30.2, U9.4 (V-), U10.2 (AGND), U10.3 (REF-), U10.19 (DGND), U11.2 (GND); also elsewhere on the board
unnamed: C20.1, D10.3 (K), R25.2, U9.3 (+)
unnamed: R27.1, U9.1, U9.2 (-)
unnamed: C20.2, D11.3 (K), R26.2, U9.5 (+)
unnamed: R28.1, U9.6 (-), U9.7
unnamed: C22.1, FB1.2, U9.8 (V+)
unnamed: C29.1, FB3.2, U10.1 (AVDD)
unnamed: C23.2, C24.1, R27.2, U10.9 (CH4)
unnamed: C24.2, C25.1, R28.2, U10.10 (CH5)
unnamed: C28.1, FB2.2, U10.20 (DVDD)
unnamed: C26.1, R29.1, TP4.1, U10.4 (REF+), U11.5 (VREF)
unnamed: R32.7, U10.14 (SCK)
unnamed: R32.6, U10.15 (SDI)
unnamed: R32.5, U10.16 (SDO)
unnamed: R32.8, U10.13 (~CS)
unnamed: C30.1, FB4.2, U11.3 (EN), U11.4 (VIN)
