derlucae98/spr23e-bmu/KiCad/spr23e-bmu.kicad_pcb

## KiCad design KiCad/spr23e-bmu.kicad_pcb (continued)

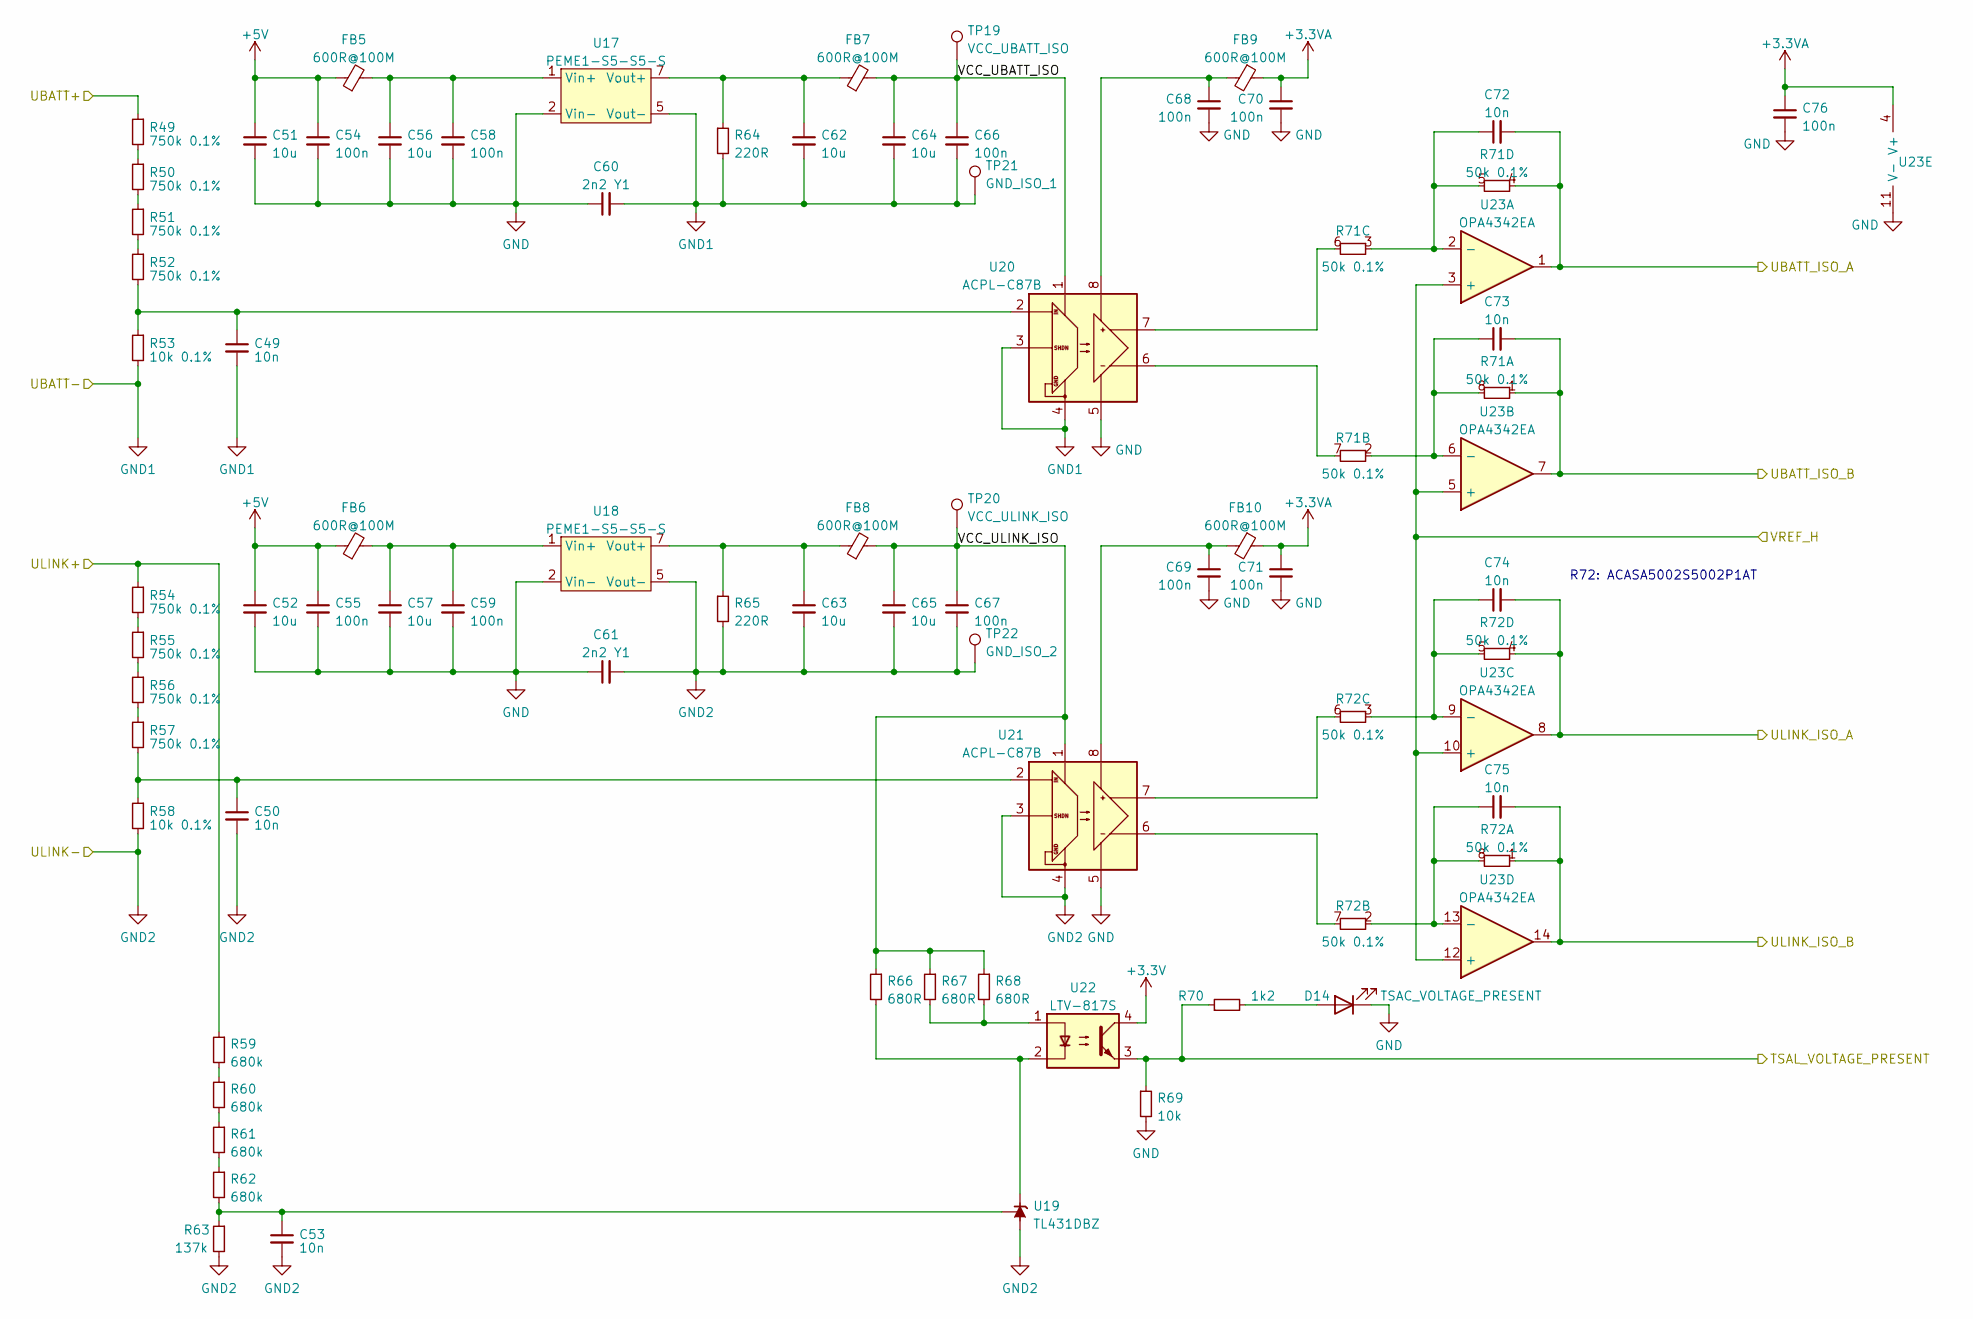
[picture p49: schematic ts_iso.kicad_sch, SPR23e Battery Management Unit (BMU)]

Parts:
C49, C50, C53, C72, C73, C74, C75: 10n; C_0603_1608Metric
C51, C52, C56, C57, C62, C63, C64, C65: 10u; C_1206_3216Metric
C54, C55, C58, C59, C66, C67, C68, C69, C70, C71, C76: 100n; C_0603_1608Metric
C60, C61: 2n2 Y1; C_Rect_L13.0mm_W4.0mm_P10.00mm_FKS3_FKP3_MKS4
D14: TSAC_VOLTAGE_PRESENT; LED_0603_1608Metric
FB5, FB6, FB7, FB8, FB9, FB10: 600R@100M; L_0603_1608Metric
R49, R50, R51, R52, R54, R55, R56, R57: 750k 0.1%; R_1206_3216Metric
R53, R58: 10k 0.1%; R_0603_1608Metric
R59, R60, R61, R62: 680k; R_1206_3216Metric
R63: 137k; R_0603_1608Metric
R64, R65: 220R; R_1210_3225Metric
R66, R67, R68: 680R; R_0603_1608Metric
R69: 10k; R_0603_1608Metric
R70: 1k2; R_0603_1608Metric
R71, R72: 50k 0.1%; R_Array_Convex_4x0603
TP19: VCC_UBATT_ISO; TestPoint_Pad_D1.5mm
TP20: VCC_ULINK_ISO; TestPoint_Pad_D1.5mm
TP21: GND_ISO_1; TestPoint_Pad_D1.5mm
TP22: GND_ISO_2; TestPoint_Pad_D1.5mm
U17, U18: PEME1-S5-S5-S; PEME1
U19: TL431DBZ; SOT-23
U20, U21: ACPL-C87B; SSO-8_6.8x5.9mm_P1.27mm_Clearance8mm
U22: LTV-817S; SMDIP-4_W9.53mm
U23: OPA4342EA; TSSOP-14_4.4x5mm_P0.65mm

Connections:
+3.3V: U22.4; also elsewhere on the board
+3.3VA: C70.1, C71.1, C76.1, FB9.1, FB10.1, U23.4 (V+); also elsewhere on the board
+5V: C51.1, C52.1, C54.1, C55.1, FB5.1, FB6.1; also elsewhere on the board
/ADC/UBATT_ISO_A: C72.2, R71.4, U23.1; also elsewhere on the board
/ADC/UBATT_ISO_B: C73.2, R71.1, U23.7; also elsewhere on the board
/ADC/ULINK_ISO_A: C74.2, R72.4, U23.8; also elsewhere on the board
/ADC/ULINK_ISO_B: C75.2, R72.1, U23.14; also elsewhere on the board
/ADC/VREF_H: U23.3 (+), U23.5 (+), U23.10 (+), U23.12 (+); also elsewhere on the board
/AMS-Master/TSAC_VOLTAGE_PRESENT: R69.1, R70.1, U22.3; also elsewhere on the board
/TS_ISO/VCC_UBATT_ISO: C64.1, C66.1, FB7.2, TP19.1, U20.1 (VDD1)
/TS_ISO/VCC_ULINK_ISO: C65.1, C67.1, FB8.2, R66.1, R67.1, R68.1, TP20.1, U21.1 (VDD1)
/UBATT+: R49.1; also elsewhere on the board
/ULINK+: R54.1, R59.1; also elsewhere on the board
GND: C51.2, C52.2, C54.2, C55.2, C56.2, C57.2, C58.2, C59.2, C60.1, C61.1, C68.2, C69.2, C70.2, C71.2, C76.2, D14.1 (K), R69.2, U17.2 (Vin-), U18.2 (Vin-), U20.5 (GND2), U21.5 (GND2), U23.11 (V-); also elsewhere on the board
GND1: C49.2, C60.2, C62.2, C64.2, C66.2, R53.2, R64.2, TP21.1, U17.5 (Vout-), U20.3 (IN-), U20.4 (GND1); also elsewhere on the board
GND2: C50.2, C53.2, C61.2, C63.2, C65.2, C67.2, R58.2, R63.2, R65.2, TP22.1, U18.5 (Vout-), U19.3 (A), U21.3 (IN-), U21.4 (GND1); also elsewhere on the board
unnamed: D14.2 (A), R70.2
unnamed: R49.2, R50.1
unnamed: R50.2, R51.1
unnamed: R51.2, R52.1
unnamed: R54.2, R55.1
unnamed: R55.2, R56.1
unnamed: R56.2, R57.1
unnamed: R59.2, R60.1
unnamed: R60.2, R61.1
unnamed: R61.2, R62.1
unnamed: R67.2, R68.2, U22.1
unnamed: C56.1, C58.1, FB5.2, U17.1 (Vin+)
unnamed: C62.1, FB7.1, R64.1, U17.7 (Vout+)
unnamed: C57.1, C59.1, FB6.2, U18.1 (Vin+)
unnamed: C63.1, FB8.1, R65.1, U18.7 (Vout+)
unnamed: R66.2, U19.1 (K), U22.2
unnamed: C53.1, R62.2, R63.1, U19.2 (REF)
unnamed: C49.1, R52.2, R53.1, U20.2 (IN)
unnamed: R71.6, U20.7 (OUT+)
unnamed: R71.7, U20.6 (OUT-)
unnamed: C68.1, FB9.2, U20.8 (VDD2)
unnamed: C50.1, R57.2, R58.1, U21.2 (IN)
unnamed: R72.6, U21.7 (OUT+)
unnamed: R72.7, U21.6 (OUT-)
unnamed: C69.1, FB10.2, U21.8 (VDD2)
unnamed: C72.1, R71.3, R71.5, U23.2 (-)
unnamed: C73.1, R71.2, R71.8, U23.6 (-)
unnamed: C74.1, R72.3, R72.5, U23.9 (-)
unnamed: C75.1, R72.2, R72.8, U23.13 (-)

Notes on the sheet:
R72: ACASA5002S5002P1AT

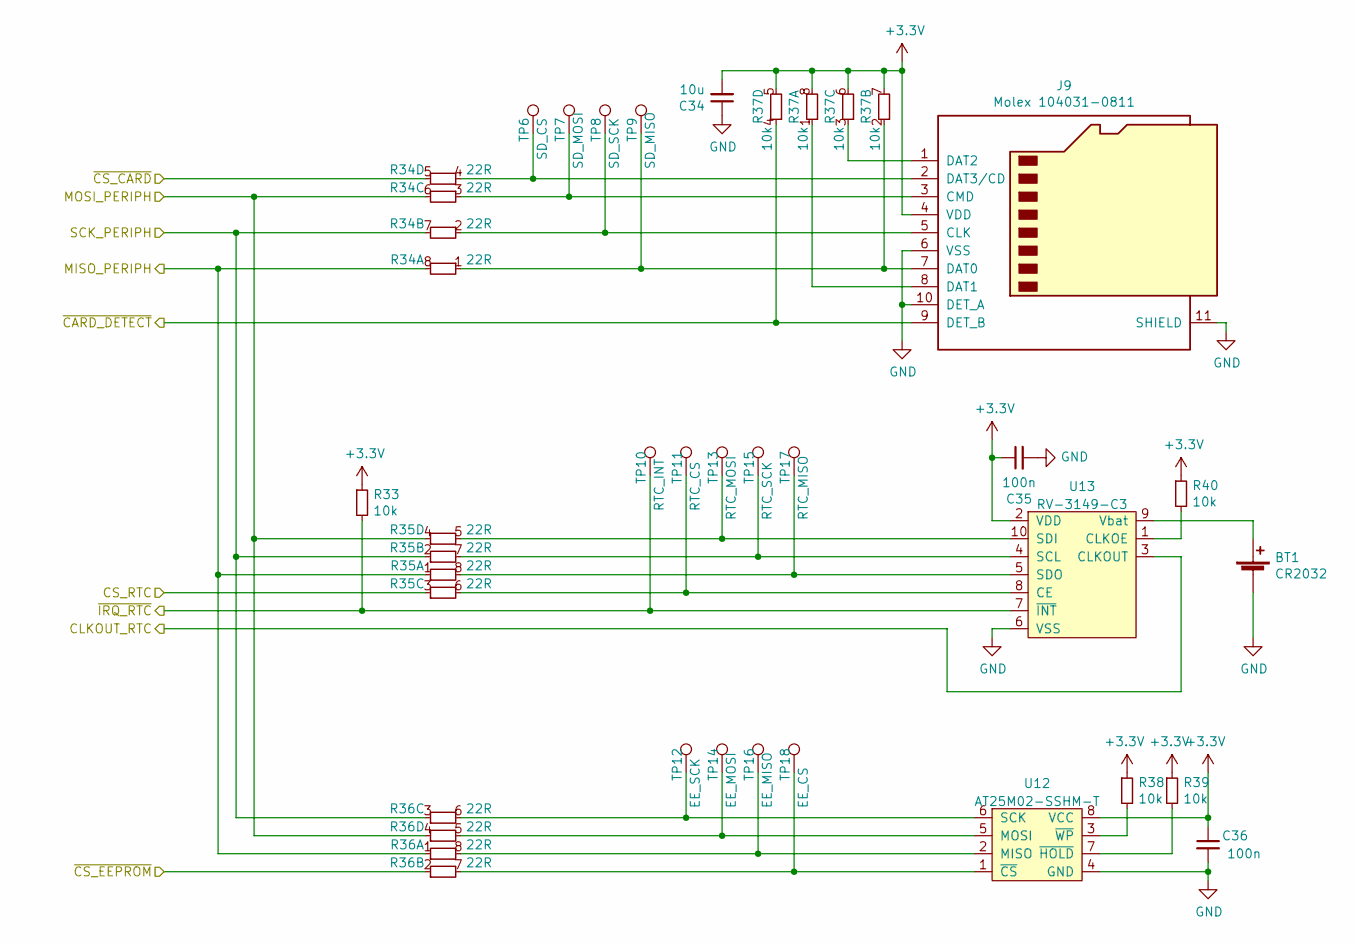
[picture p50: schematic Periphery.kicad_sch, SPR23e Battery Management Unit (BMU)]

Parts:
BT1: CR2032; WA-BCPH_79527141
C34: 10u; C_1206_3216Metric
C35, C36: 100n; C_0603_1608Metric
J9: Molex 104031-0811; microSD_HC_Molex_104031-0811
R33, R38, R39, R40: 10k; R_0603_1608Metric
R34, R35, R36: 22R; R_Array_Convex_4x0603
R37: 10k; R_Array_Convex_4x0603
TP6: SD_CS; TestPoint_Pad_D1.5mm
TP7: SD_MOSI; TestPoint_Pad_D1.5mm
TP8: SD_SCK; TestPoint_Pad_D1.5mm
TP9: SD_MISO; TestPoint_Pad_D1.5mm
TP10: RTC_INT; TestPoint_Pad_D1.5mm
TP11: RTC_CS; TestPoint_Pad_D1.5mm
TP12: EE_SCK; TestPoint_Pad_D1.5mm
TP13: RTC_MOSI; TestPoint_Pad_D1.5mm
TP14: EE_MOSI; TestPoint_Pad_D1.5mm
TP15: RTC_SCK; TestPoint_Pad_D1.5mm
TP16: EE_MISO; TestPoint_Pad_D1.5mm
TP17: RTC_MISO; TestPoint_Pad_D1.5mm
TP18: EE_CS; TestPoint_Pad_D1.5mm
U12: AT25M02-SSHM-T; SOIC-8_3.9x4.9mm_P1.27mm
U13: RV-3149-C3; RTC_SMD_MicroCrystal_C3_2.5x3.7mm

Connections:
+3.3V: C34.2, C35.1, C36.1, J9.4 (VDD), R33.1, R37.5, R37.6, R37.7, R37.8, R38.1, R39.1, R40.1, U12.8 (VCC), U13.2 (VDD); also elsewhere on the board
/AMS-Master/CLKOUT_RTC: U13.3 (CLKOUT); also elsewhere on the board
/AMS-Master/CS_RTC: R35.3; also elsewhere on the board
/AMS-Master/SPI2_MISO: R34.8, R35.1, R36.1; also elsewhere on the board
/AMS-Master/SPI2_MOSI: R34.6, R35.4, R36.4; also elsewhere on the board
/AMS-Master/SPI2_SCK: R34.7, R35.2, R36.3; also elsewhere on the board
/AMS-Master/~CARD_DETECT: J9.9 (DET_B), R37.4; also elsewhere on the board
/AMS-Master/~CS_CARD: R34.5; also elsewhere on the board
/AMS-Master/~CS_EEPROM: R36.2; also elsewhere on the board
/AMS-Master/~IRQ_RTC: R33.2, TP10.1, U13.7 (~INT); also elsewhere on the board
GND: BT1.2 (-), C34.1, C35.2, C36.2, J9.6 (VSS), J9.10 (DET_A), J9.11 (SHIELD), U12.4 (GND), U13.6 (VSS); also elsewhere on the board
unnamed: BT1.1 (+), U13.9 (Vbat)
unnamed: J9.5 (CLK), R34.2, TP8.1
unnamed: J9.3 (CMD), R34.3, TP7.1
unnamed: J9.7 (DAT0), R34.1, R37.2, TP9.1
unnamed: J9.8 (DAT1), R37.1
unnamed: J9.1 (DAT2), R37.3
unnamed: J9.2 (DAT3/CD), R34.4, TP6.1
unnamed: R36.8, TP16.1, U12.2 (MISO)
unnamed: R36.5, TP14.1, U12.5 (MOSI)
unnamed: R36.6, TP12.1, U12.6 (SCK)
unnamed: R36.7, TP18.1, U12.1 (~CS)
unnamed: R39.2, U12.7 (~HOLD)
unnamed: R38.2, U12.3 (~WP)
unnamed: R35.6, TP11.1, U13.8 (CE)
unnamed: R40.2, U13.1 (CLKOE)
unnamed: R35.7, TP15.1, U13.4 (SCL)
unnamed: R35.5, TP13.1, U13.10 (SDI)
unnamed: R35.8, TP17.1, U13.5 (SDO)

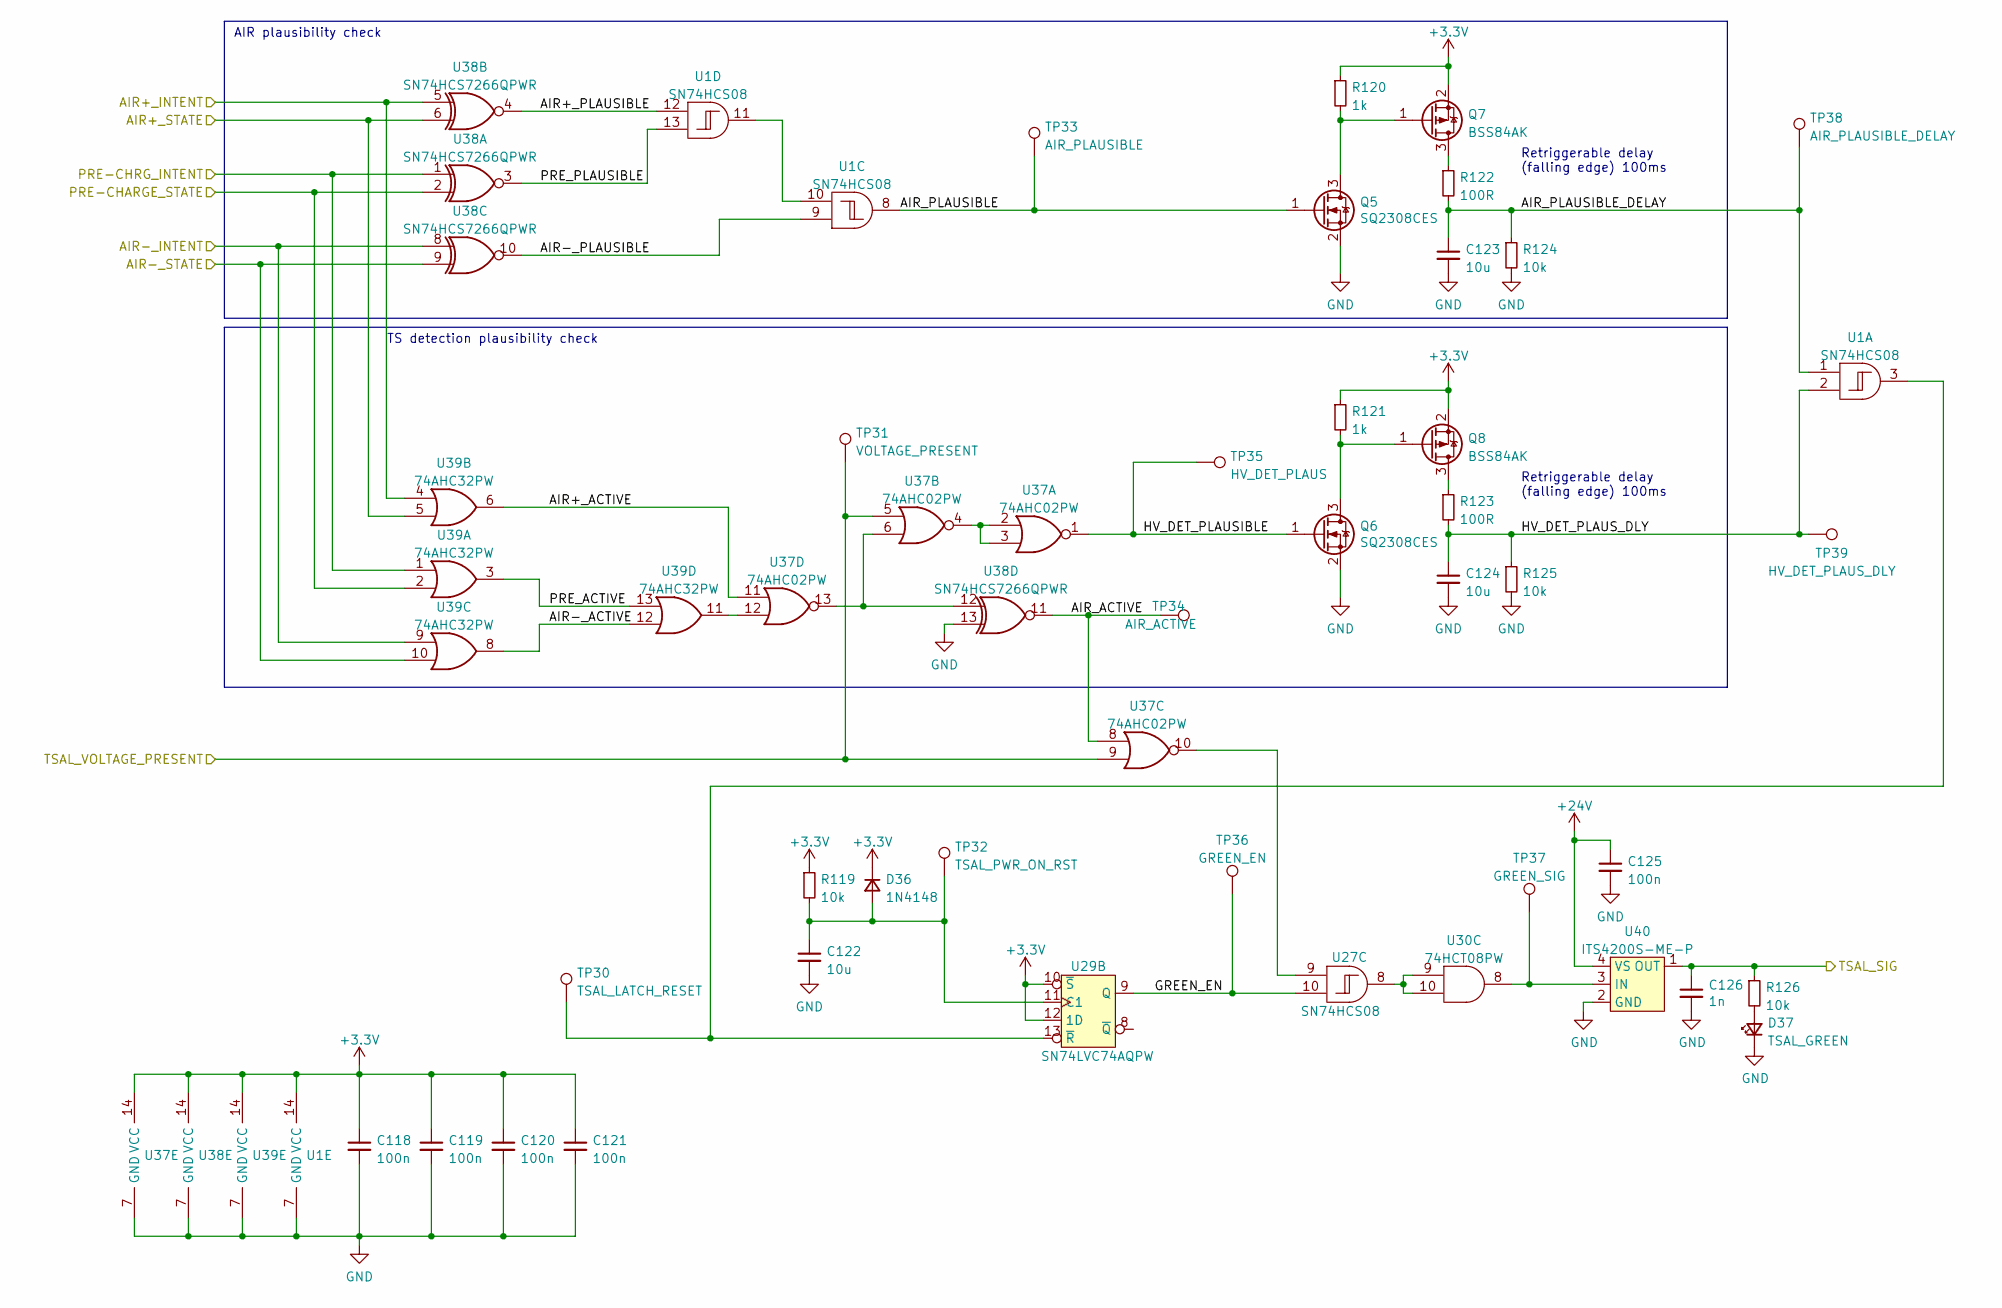
[picture p51: schematic tsal_accu.kicad_sch, SPR23e Battery Management Unit (BMU)]

Parts:
C118, C119, C120, C121, C125: 100n; C_0603_1608Metric
C122, C123, C124: 10u; C_1206_3216Metric
C126: 1n; C_0603_1608Metric
D36: 1N4148; D_SOD-123
D37: TSAL_GREEN; LED_0603_1608Metric
Q5, Q6: SQ2308CES; SOT-23
Q7, Q8: BSS84AK; SOT-23
R119, R124, R125, R126: 10k; R_0603_1608Metric
R120, R121: 1k; R_0603_1608Metric
R122, R123: 100R; R_0603_1608Metric
TP30: TSAL_LATCH_RESET; TestPoint_Pad_D1.5mm
TP31: VOLTAGE_PRESENT; TestPoint_Pad_D1.5mm
TP32: TSAL_PWR_ON_RST; TestPoint_Pad_D1.5mm
TP33: AIR_PLAUSIBLE; TestPoint_Pad_D1.5mm
TP34: AIR_ACTIVE; TestPoint_Pad_D1.5mm
TP35: HV_DET_PLAUS; TestPoint_Pad_D1.5mm
TP36: GREEN_EN; TestPoint_Pad_D1.5mm
TP37: GREEN_SIG; TestPoint_Pad_D1.5mm
TP38: AIR_PLAUSIBLE_DELAY; TestPoint_Pad_D1.5mm
TP39: HV_DET_PLAUS_DLY; TestPoint_Pad_D1.5mm
U1, U27: SN74HCS08; TSSOP-14_4.4x5mm_P0.65mm
U29: SN74LVC74AQPW; TSSOP-14_4.4x5mm_P0.65mm
U30: 74HCT08PW; TSSOP-14_4.4x5mm_P0.65mm
U37: 74AHC02PW; TSSOP-14_4.4x5mm_P0.65mm
U38: SN74HCS7266QPWR; TSSOP-14_4.4x5mm_P0.65mm
U39: 74AHC32PW; TSSOP-14_4.4x5mm_P0.65mm
U40: ITS4200S-ME-P; SOT-223

Connections:
+3.3V: C118.1, C119.1, C120.1, C121.1, D36.1 (K), Q7.2 (S), Q8.2 (S), R119.1, R120.1, R121.1, U1.14 (VCC), U29.10 (~S), U29.12 (1D), U37.14 (VCC), U38.14 (VCC), U39.14 (VCC); also elsewhere on the board
+24V: C125.1, U40.4 (VS); also elsewhere on the board
/AMS-Master/AIR+_INTENT: U38.5, U39.4; also elsewhere on the board
/AMS-Master/AIR+_STATE: U38.6, U39.5; also elsewhere on the board
/AMS-Master/AIR-_INTENT: U38.8, U39.9; also elsewhere on the board
/AMS-Master/AIR-_STATE: U38.9, U39.10; also elsewhere on the board
/AMS-Master/PRE-CHARGE_STATE: U38.2, U39.2; also elsewhere on the board
/AMS-Master/PRE_INTENT: U38.1, U39.1; also elsewhere on the board
/AMS-Master/TSAC_VOLTAGE_PRESENT: TP31.1, U37.5, U37.9; also elsewhere on the board
/TSAL/AIR+_ACTIVE: U37.11, U39.6
/TSAL/AIR+_PLAUSIBLE: U1.12, U38.4
/TSAL/AIR-_ACTIVE: U39.8, U39.12
/TSAL/AIR-_PLAUSIBLE: U1.9, U38.10
/TSAL/AIR_ACTIVE: TP34.1, U37.8, U38.11
/TSAL/AIR_PLAUSIBLE: Q5.1 (G), TP33.1, U1.8
/TSAL/AIR_PLAUSIBLE_DELAY: C123.1, R122.2, R124.1, TP38.1, U1.1
/TSAL/GREEN_EN: TP36.1, U27.10, U29.9 (Q)
/TSAL/HV_DET_PLAUSIBLE: Q6.1 (G), TP35.1, U37.1
/TSAL/HV_DET_PLAUS_DLY: C124.1, R123.2, R125.1, TP39.1, U1.2
/TSAL/PRE_ACTIVE: U39.3, U39.13
/TSAL/PRE_PLAUSIBLE: U1.13, U38.3
/TSAL_SIG: C126.1, R126.1, U40.1 (OUT); also elsewhere on the board
GND: C118.2, C119.2, C120.2, C121.2, C122.2, C123.2, C124.2, C125.2, C126.2, D37.1 (K), Q5.2 (S), Q6.2 (S), R124.2, R125.2, U1.7 (GND), U37.7 (GND), U38.7 (GND), U38.13, U39.7 (GND), U40.2 (GND); also elsewhere on the board
unnamed: C122.1, D36.2 (A), R119.2, TP32.1, U29.11 (C1)
unnamed: D37.2 (A), R126.2
unnamed: Q5.3 (D), Q7.1 (G), R120.2
unnamed: Q6.3 (D), Q8.1 (G), R121.2
unnamed: Q7.3 (D), R122.1
unnamed: Q8.3 (D), R123.1
unnamed: U1.10, U1.11
unnamed: U27.8, U30.9, U30.10
unnamed: U27.9, U37.10
unnamed: TP30.1, U1.3, U29.13 (~R)
unnamed: U37.2, U37.3, U37.4
unnamed: U37.12, U39.11
unnamed: U37.6, U37.13, U38.12
unnamed: TP37.1, U30.8, U40.3 (IN)

Notes on the sheet:
AIR plausibility check
Retriggerable delay (falling edge) 100ms
TS detection plausibility check

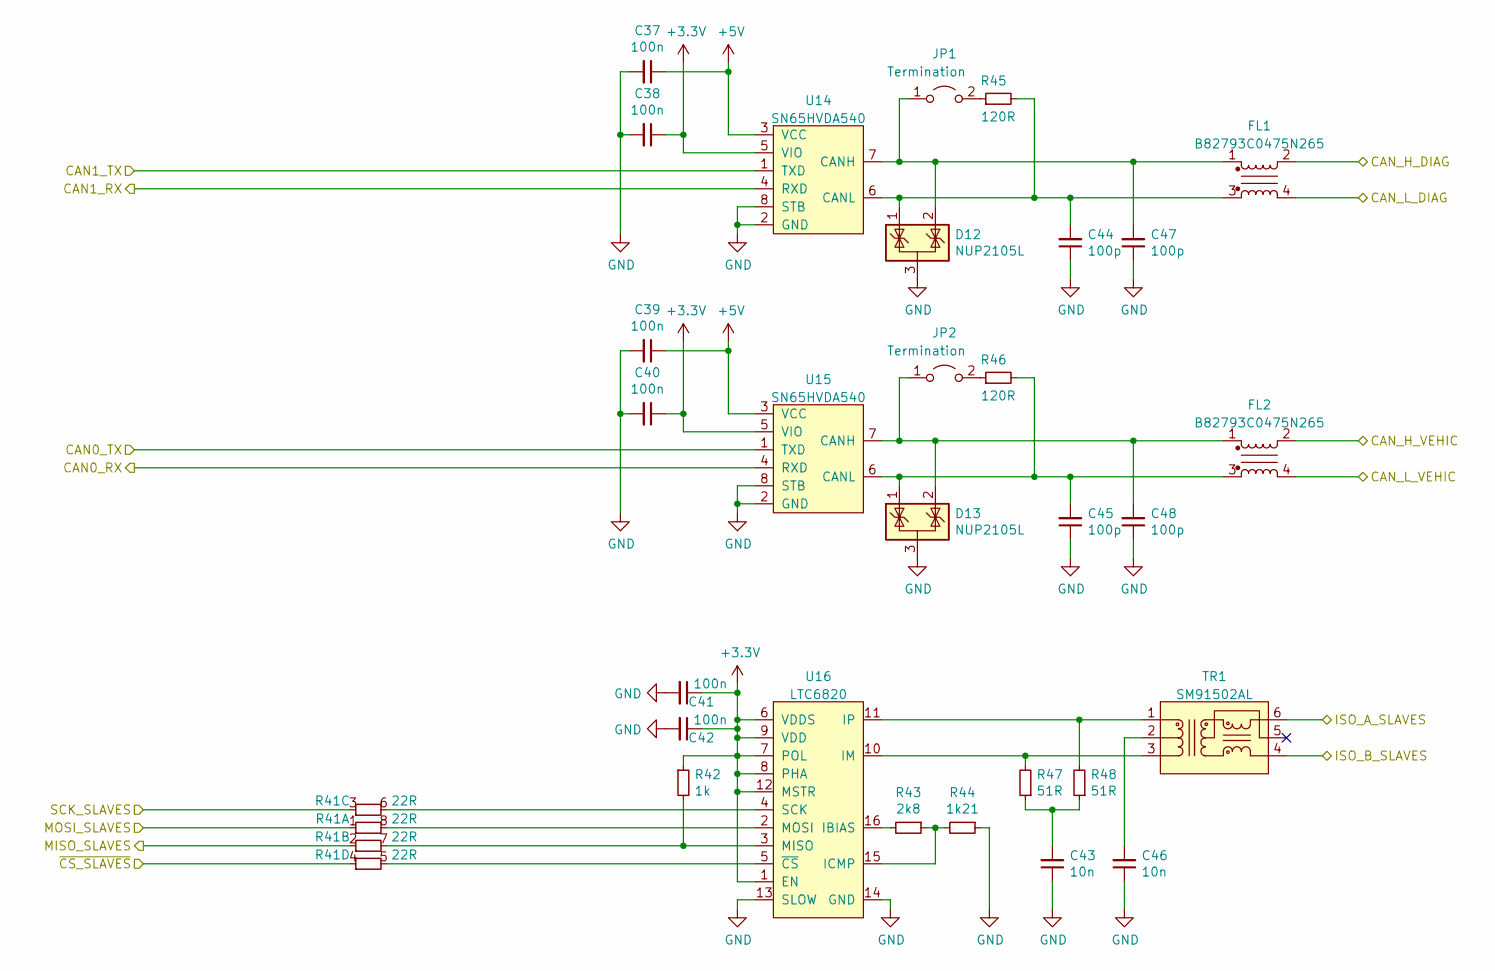
[picture p52: schematic Interface.kicad_sch, SPR23e Battery Management Unit (BMU)]

Parts:
C37, C38, C39, C40, C41, C42: 100n; C_0603_1608Metric
C43, C46: 10n; C_0603_1608Metric
C44, C45, C47, C48: 100p; C_0603_1608Metric
D12, D13: NUP2105L; SOT-23
FL1, FL2: B82793C0475N265; B82793C0
JP1, JP2: Termination; SolderJumper-2_P1.3mm_Open_Pad1.0x1.5mm
R41: 22R; R_Array_Convex_4x0603
R42: 1k; R_0603_1608Metric
R43: 2k8; R_0603_1608Metric
R44: 1k21; R_0603_1608Metric
R45, R46: 120R; R_1206_3216Metric
R47, R48: 51R; R_0603_1608Metric
TR1: SM91502AL
U14, U15: SN65HVDA540; SOIC-8_3.9x4.9mm_P1.27mm
U16: LTC6820; MSOP-16_3x4.039mm_P0.5mm

Connections:
+3.3V: C38.1, C40.1, C41.1, C42.1, R42.1, U14.5 (VIO), U15.5 (VIO), U16.1 (EN), U16.6 (VDDS), U16.7 (POL), U16.8 (PHA), U16.9 (VDD), U16.12 (MSTR); also elsewhere on the board
+5V: C37.1, C39.1, U14.3 (VCC), U15.3 (VCC); also elsewhere on the board
/AMS-Master/CAN0_RX: U15.4 (RXD); also elsewhere on the board
/AMS-Master/CAN0_TX: U15.1 (TXD); also elsewhere on the board
/AMS-Master/CAN1_RX: U14.4 (RXD); also elsewhere on the board
/AMS-Master/CAN1_TX: U14.1 (TXD); also elsewhere on the board
/AMS-Master/MISO_SLAVES: R41.2; also elsewhere on the board
/AMS-Master/MOSI_SLAVES: R41.1; also elsewhere on the board
/AMS-Master/SCK_SLAVES: R41.3; also elsewhere on the board
/AMS-Master/~CS_SLAVES: R41.4; also elsewhere on the board
/CAN_H_DIAG: FL1.2; also elsewhere on the board
/CAN_H_VEHIC: FL2.2; also elsewhere on the board
/CAN_L_DIAG: FL1.4; also elsewhere on the board
/CAN_L_VEHIC: FL2.4; also elsewhere on the board
/ISO_A: TR1.6; also elsewhere on the board
/ISO_B: TR1.4; also elsewhere on the board
GND: C37.2, C38.2, C39.2, C40.2, C41.2, C42.2, C43.1, C44.1, C45.1, C46.1, C47.1, C48.1, D12.3 (A), D13.3 (A), R44.1, U14.2 (GND), U14.8 (STB), U15.2 (GND), U15.8 (STB), U16.13 (SLOW), U16.14 (GND); also elsewhere on the board
unnamed: C43.2, R47.1, R48.1
unnamed: C46.2, TR1.2
unnamed: C47.2, D12.2 (K), FL1.1, JP1.1 (A), U14.7 (CANH)
unnamed: JP1.2 (B), R45.1
unnamed: C48.2, D13.2 (K), FL2.1, JP2.1 (A), U15.7 (CANH)
unnamed: JP2.2 (B), R46.1
unnamed: C44.2, D12.1 (K), FL1.3, R45.2, U14.6 (CANL)
unnamed: C45.2, D13.1 (K), FL2.3, R46.2, U15.6 (CANL)
unnamed: R43.2, U16.16 (IBIAS)
unnamed: R43.1, R44.2, U16.15 (ICMP)
unnamed: R47.2, TR1.3, U16.10 (IM)
unnamed: R48.2, TR1.1, U16.11 (IP)
unnamed: R41.7, R42.2, U16.3 (MISO)
unnamed: R41.8, U16.2 (MOSI)
unnamed: R41.6, U16.4 (SCK)
unnamed: R41.5, U16.5 (~CS)

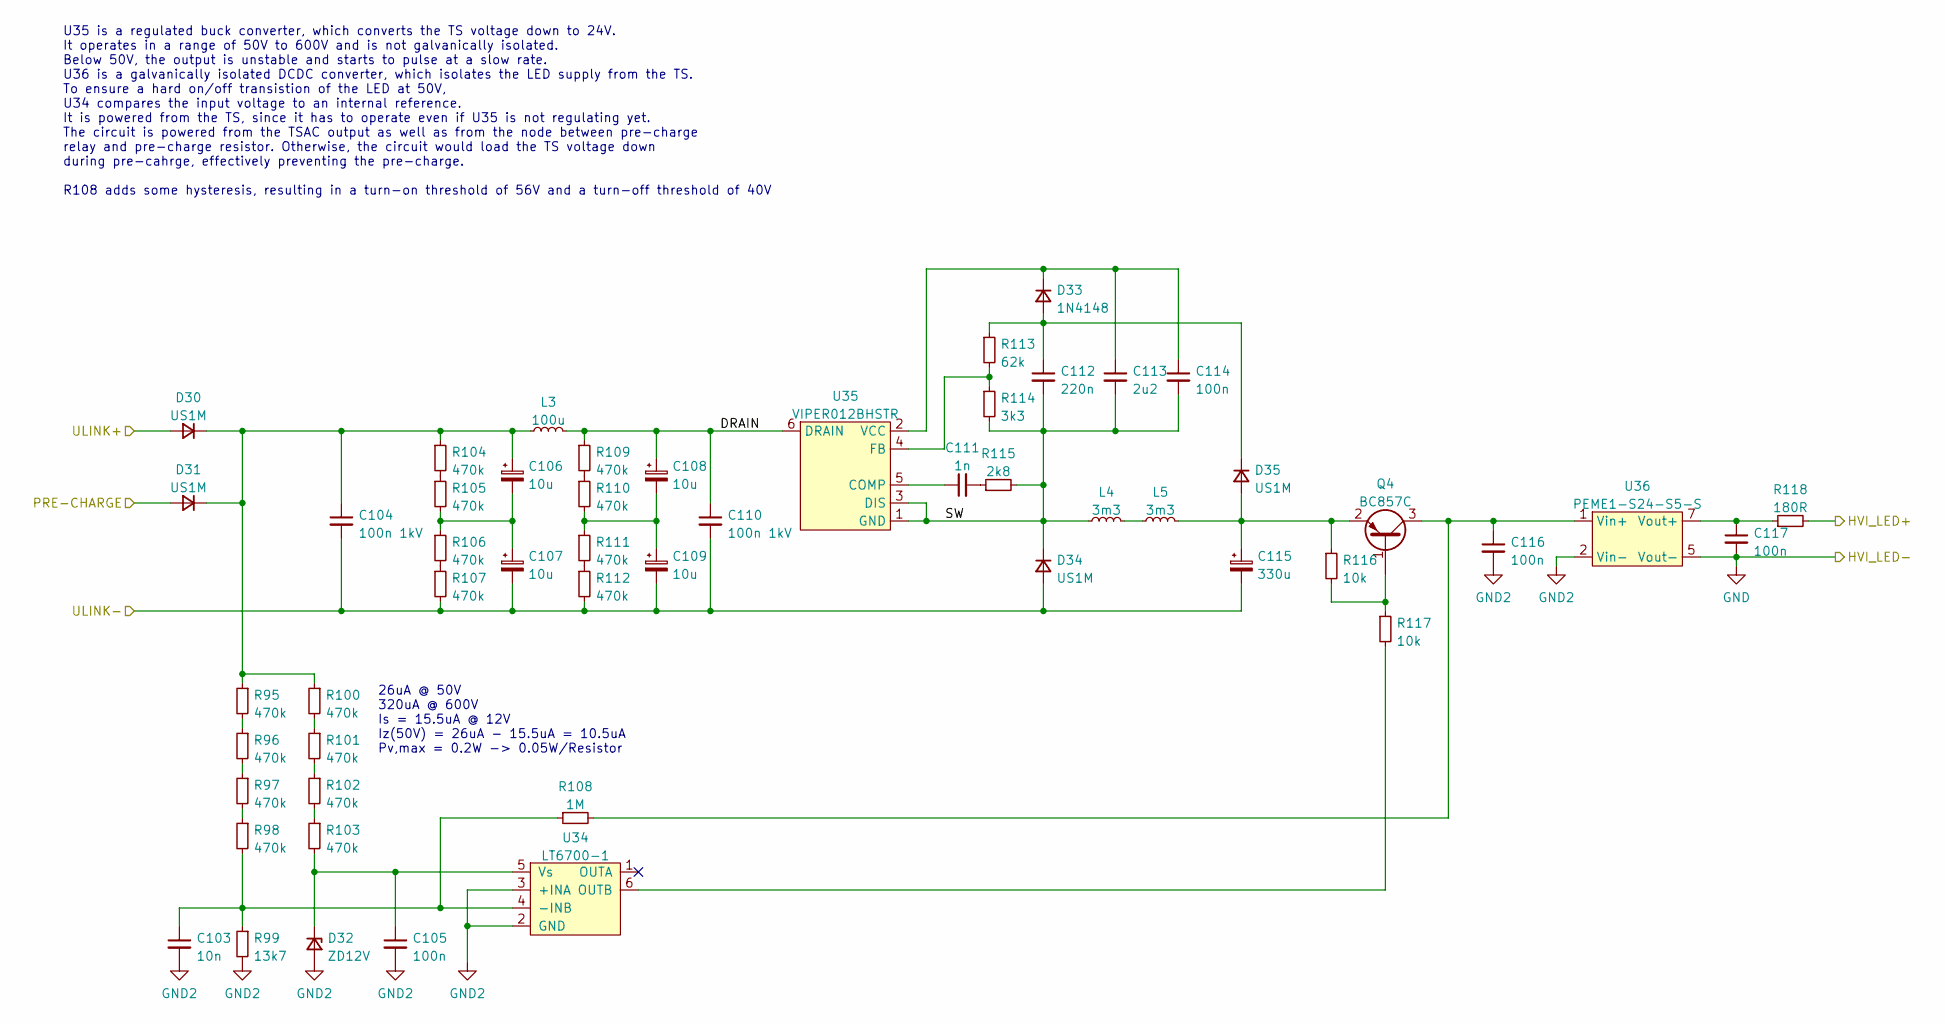
[picture p53: schematic voltage_indicator.kicad_sch, SPR23e Battery Management Unit (BMU)]

Parts:
C103: 10n; C_0603_1608Metric
C104, C110: 100n 1kV; C_1812_4532Metric
C105, C114, C116, C117: 100n; C_0603_1608Metric
C106, C107, C108, C109: 10u; CP_Radial_D10.0mm_P5.00mm
C111: 1n; C_0603_1608Metric
C112: 220n; C_0603_1608Metric
C113: 2u2; C_0805_2012Metric
C115: 330u; CP_Radial_D10.0mm_P5.00mm
D30, D31, D34, D35: US1M; D_SMA
D32: ZD12V; D_SOD-123
D33: 1N4148; D_SOD-123
L3: 100u; L_Taiyo-Yuden_MD-3030
L4, L5: 3m3; L_Wuerth_WE-PD-Typ-LS
Q4: BC857C; SOT-23
R95, R96, R97, R98, R100, R101, R102, R103, R104, R105, R106, R107, R109, R110, R111, R112: 470k; R_1206_3216Metric
R99: 13k7; R_0603_1608Metric
R108: 1M; R_0603_1608Metric
R113: 62k; R_0603_1608Metric
R114: 3k3; R_0603_1608Metric
R115: 2k8; R_0603_1608Metric
R116, R117: 10k; R_0603_1608Metric
R118: 180R; R_0603_1608Metric
U34: LT6700-1; SOT-23-6
U35: VIPER012BHSTR; SSOP-10_3.9x4.9mm_P1.00mm
U36: PEME1-S24-S5-S; PEME1

Connections:
/HVI+: R118.2; also elsewhere on the board
/HVI/DRAIN: C108.1, C110.1, L3.2, R109.1, U35.6 (DRAIN), U35.7 (DRAIN), U35.8 (DRAIN), U35.9 (DRAIN), U35.10 (DRAIN)
/HVI/SW: C112.2, C113.2, C114.2, D34.1 (K), L4.1, R114.2, R115.2, U35.1 (GND), U35.3 (DIS)
/PRE-CHRG: D31.2 (A); also elsewhere on the board
/ULINK+: D30.2 (A); also elsewhere on the board
GND: C117.2, U36.5 (Vout-); also elsewhere on the board
GND2: C103.2, C104.2, C105.2, C107.2, C109.2, C110.2, C115.2, C116.2, D32.2 (A), D34.2 (A), R99.2, R107.2, R112.2, U34.2 (GND), U34.3 (+INA), U36.2 (Vin-); also elsewhere on the board
unnamed: C106.2, C107.1, R105.2, R106.1
unnamed: C108.2, C109.1, R110.2, R111.1
unnamed: C111.2, R115.1
unnamed: C104.1, C106.1, D30.1 (K), D31.1 (K), L3.1, R95.1, R100.1, R104.1
unnamed: C105.1, D32.1 (K), R103.2, U34.5 (Vs)
unnamed: C112.1, D33.2 (A), D35.1 (K), R113.1
unnamed: C113.1, C114.1, D33.1 (K), U35.2 (VCC)
unnamed: C115.1, D35.2 (A), L5.2, Q4.2 (E), R116.1
unnamed: L4.2, L5.1
unnamed: Q4.1 (B), R116.2, R117.1
unnamed: C116.1, Q4.3 (C), R108.2, U36.1 (Vin+)
unnamed: R95.2, R96.1
unnamed: R96.2, R97.1
unnamed: R97.2, R98.1
unnamed: R100.2, R101.1
unnamed: R101.2, R102.1
unnamed: R102.2, R103.1
unnamed: R104.2, R105.1
unnamed: R106.2, R107.1
unnamed: R109.2, R110.1
unnamed: R111.2, R112.1
unnamed: C103.1, R98.2, R99.1, R108.1, U34.4 (-INB)
unnamed: R117.2, U34.6 (OUTB)
unnamed: C111.1, U35.5 (COMP)
unnamed: R113.2, R114.1, U35.4 (FB)
unnamed: C117.1, R118.1, U36.7 (Vout+)

Notes on the sheet:
26uA @ 50V 320uA @ 600V Is = 15.5uA @ 12V Iz(50V) = 26uA - 15.5uA = 10.5uA Pv,max = 0.2W -> 0.05W/Resistor
U35 is a regulated buck converter, which converts the TS voltage down to 24V. It operates in a range of 50V to 600V and is not galvanically isolated. Below 50V, the output is unstable and starts to pulse at a slow rate. U36 is a galvanically isolated DCDC converter, which isolates the LED supply fr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
