derlucae98/spr23e-bmu/KiCad/spr23e-bmu.kicad_pcb

## KiCad design KiCad/spr23e-bmu.kicad_pcb (continued)

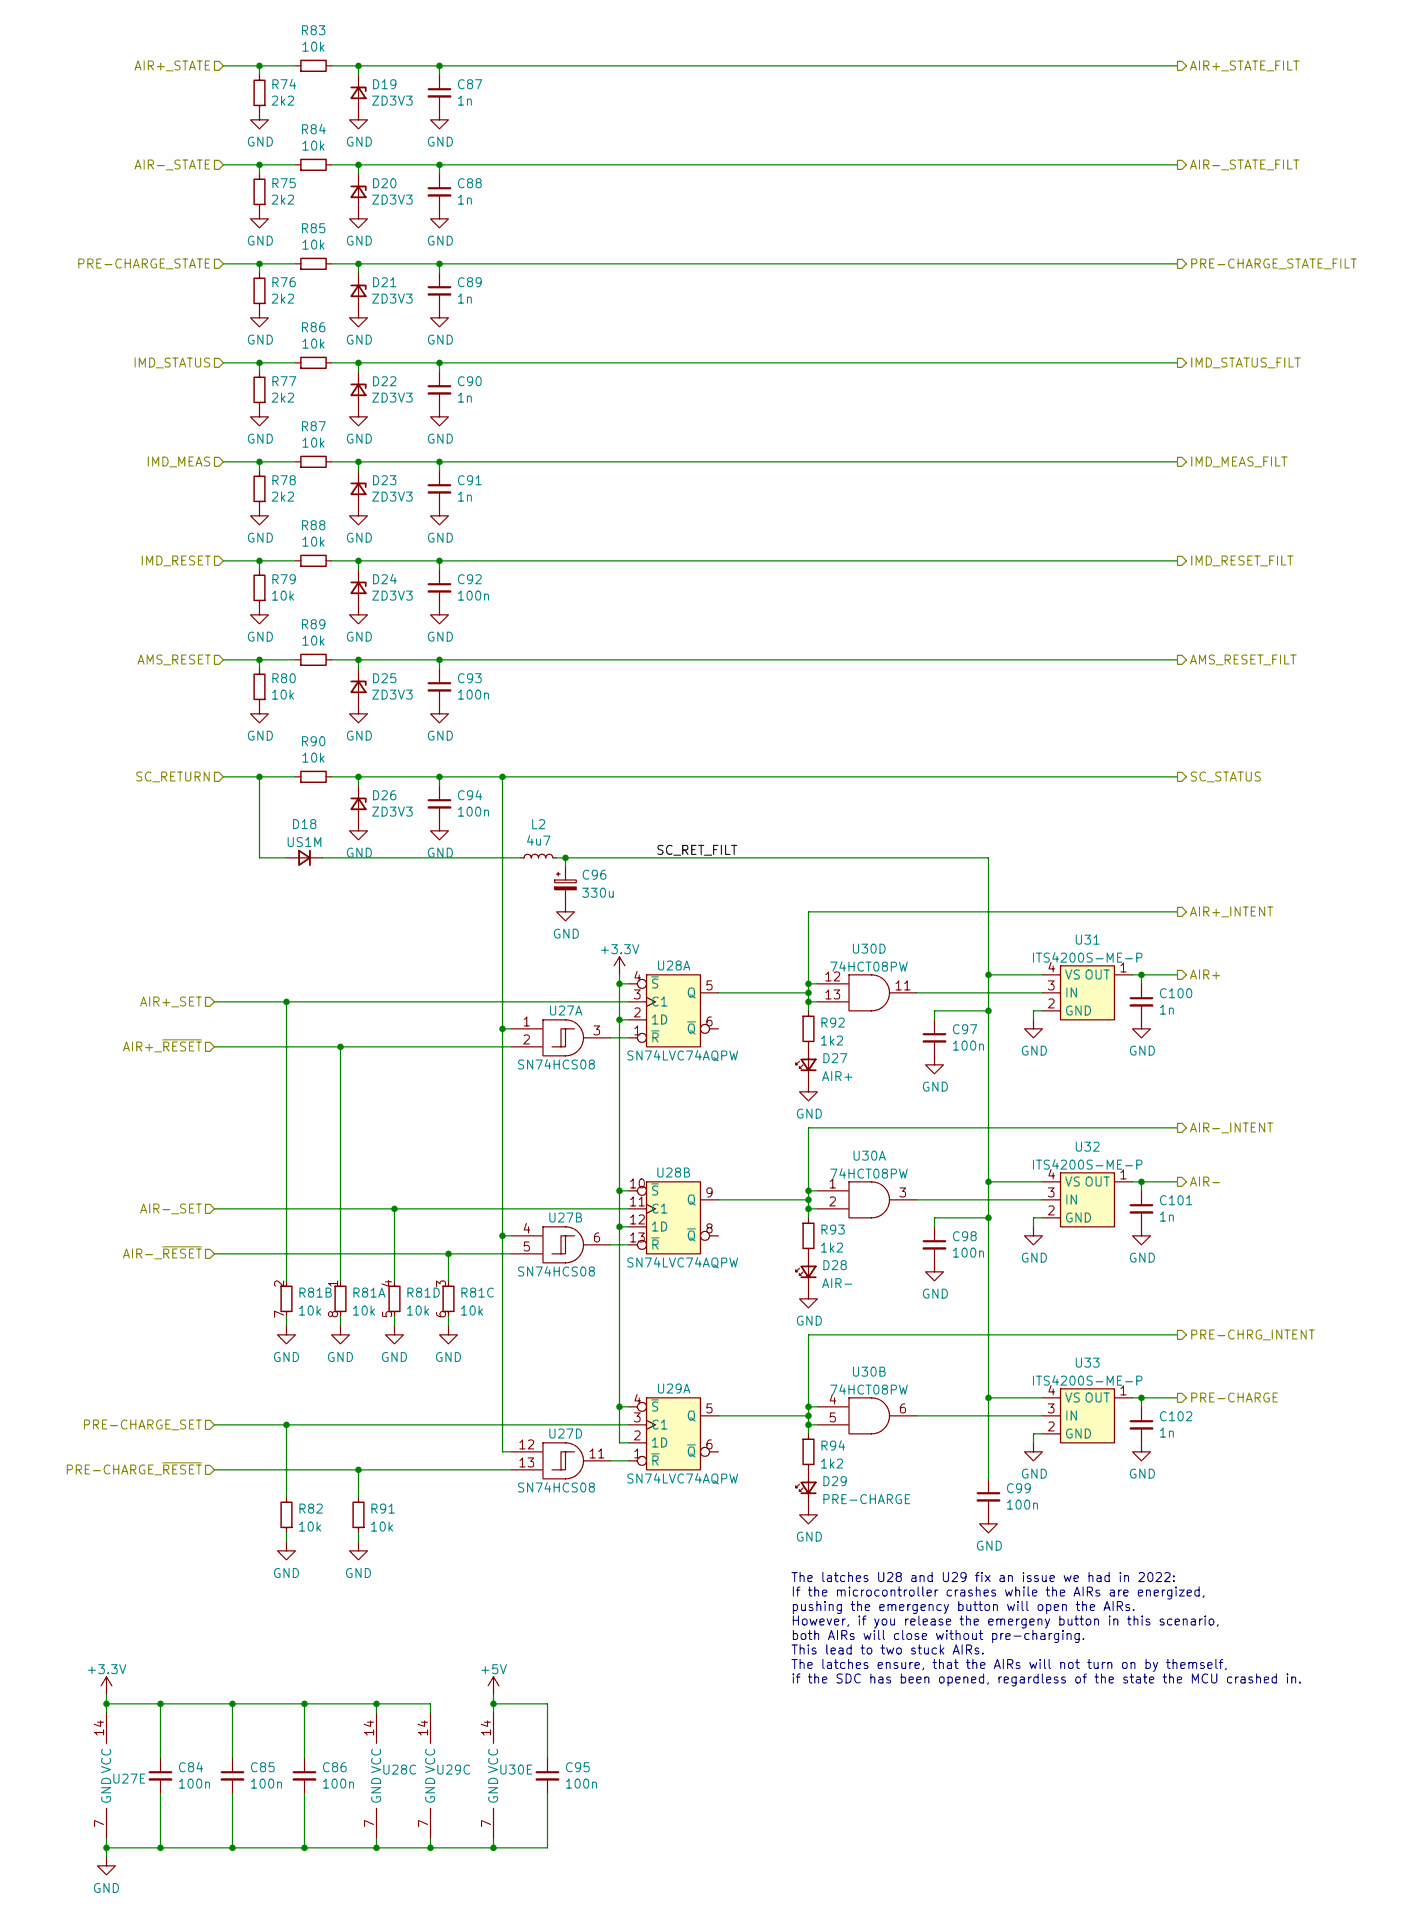
[picture p54: schematic io_filt.kicad_sch, SPR23e Battery Management Unit (BMU)]

Parts:
C84, C85, C86, C92, C93, C94, C95, C97, C98, C99: 100n; C_0603_1608Metric
C87, C88, C89, C90, C91, C100, C101, C102: 1n; C_0603_1608Metric
C96: 330u; CP_Radial_D10.0mm_P5.00mm
D18: US1M; D_SMA
D19, D20, D21, D22, D23, D24, D25, D26: ZD3V3; D_SOD-123
D27: AIR+; LED_0603_1608Metric
D28: AIR-; LED_0603_1608Metric
D29: PRE-CHARGE; LED_0603_1608Metric
L2: 4u7; L_1206_3216Metric
R74, R75, R76, R77, R78: 2k2; R_1210_3225Metric
R79, R80, R82, R83, R84, R85, R86, R87, R88, R89, R90, R91: 10k; R_0603_1608Metric
R81: 10k; R_Array_Convex_4x0603
R92, R93, R94: 1k2; R_0603_1608Metric
U27: SN74HCS08; TSSOP-14_4.4x5mm_P0.65mm
U28, U29: SN74LVC74AQPW; TSSOP-14_4.4x5mm_P0.65mm
U30: 74HCT08PW; TSSOP-14_4.4x5mm_P0.65mm
U31, U32, U33: ITS4200S-ME-P; SOT-223

Connections:
+3.3V: C84.1, C85.1, C86.1, U27.14 (VCC), U28.2 (1D), U28.4 (~S), U28.10 (~S), U28.12 (1D), U28.14 (VCC), U29.2 (1D), U29.4 (~S), U29.14 (VCC); also elsewhere on the board
+5V: C95.1, U30.14 (VCC); also elsewhere on the board
/AIR+: C100.1, U31.1 (OUT); also elsewhere on the board
/AIR+_STATE: R74.2, R83.1; also elsewhere on the board
/AIR-: C101.1, U32.1 (OUT); also elsewhere on the board
/AIR-_STATE: R75.2, R84.1; also elsewhere on the board
/AMS-Master/AIR+_INTENT: R92.1, U28.5 (Q), U30.12, U30.13; also elsewhere on the board
/AMS-Master/AIR+_SET: R81.2, U28.3 (C1); also elsewhere on the board
/AMS-Master/AIR+_STATE: C87.1, D19.1 (K), R83.2; also elsewhere on the board
/AMS-Master/AIR+_~RESET: R81.1, U27.2; also elsewhere on the board
/AMS-Master/AIR-_INTENT: R93.1, U28.9 (Q), U30.1, U30.2; also elsewhere on the board
/AMS-Master/AIR-_SET: R81.4, U28.11 (C1); also elsewhere on the board
/AMS-Master/AIR-_STATE: C88.1, D20.1 (K), R84.2; also elsewhere on the board
/AMS-Master/AIR-_~RESET: R81.3, U27.5; also elsewhere on the board
/AMS-Master/IMD_MEAS: C91.1, D23.1 (K), R87.2; also elsewhere on the board
/AMS-Master/IMD_STATUS: C90.1, D22.1 (K), R86.2; also elsewhere on the board
/AMS-Master/PRE-CHARGE_SET: R82.2, U29.3 (C1); also elsewhere on the board
/AMS-Master/PRE-CHARGE_STATE: C89.1, D21.1 (K), R85.2; also elsewhere on the board
/AMS-Master/PRE-CHARGE_~RESET: R91.2, U27.13; also elsewhere on the board
/AMS-Master/PRE_INTENT: R94.1, U29.5 (Q), U30.4, U30.5; also elsewhere on the board
/AMS-Master/SC_STATUS: C94.1, D26.1 (K), R90.2, U27.1, U27.4, U27.12; also elsewhere on the board
/AMS_RESET: R80.2, R89.1; also elsewhere on the board
/IMD_MEAS: R78.2, R87.1; also elsewhere on the board
/IMD_RESET: R79.2, R88.1; also elsewhere on the board
/IMD_STATUS: R77.2, R86.1; also elsewhere on the board
/IO_EMI/AMS_RESET_FILT: C93.1, D25.1 (K), R89.2; also elsewhere on the board
/IO_EMI/IMD_RESET_FILT: C92.1, D24.1 (K), R88.2; also elsewhere on the board
/IO_EMI/SC_RET_FILT: C96.1, C97.1, C98.1, C99.1, L2.2, U31.4 (VS), U32.4 (VS), U33.4 (VS)
/PRE-CHARGE: C102.1, U33.1 (OUT); also elsewhere on the board
/PRE-CHARGE_STATE: R76.2, R85.1; also elsewhere on the board
/SC_RETURN: D18.2 (A), R90.1; also elsewhere on the board
GND: C84.2, C85.2, C86.2, C87.2, C88.2, C89.2, C90.2, C91.2, C92.2, C93.2, C94.2, C95.2, C96.2, C97.2, C98.2, C99.2, C100.2, C101.2, C102.2, D19.2 (A), D20.2 (A), D21.2 (A), D22.2 (A), D23.2 (A), D24.2 (A), D25.2 (A), D26.2 (A), D27.1 (K), D28.1 (K), D29.1 (K), R74.1, R75.1, R76.1, R77.1, R78.1, R79.1, R80.1, R81.5, R81.6, R81.7, R81.8, R82.1, R91.1, U27.7 (GND), U28.7 (GND), U29.7 (GND), U30.7 (GND), U31.2 (GND), U32.2 (GND), U33.2 (GND); also elsewhere on the board
unnamed: D18.1 (K), L2.1
unnamed: D27.2 (A), R92.2
unnamed: D28.2 (A), R93.2
unnamed: D29.2 (A), R94.2
unnamed: U27.3, U28.1 (~R)
unnamed: U27.6, U28.13 (~R)
unnamed: U27.11, U29.1 (~R)
unnamed: U30.11, U31.3 (IN)
unnamed: U30.3, U32.3 (IN)
unnamed: U30.6, U33.3 (IN)

Notes on the sheet:
The latches U28 and U29 fix an issue we had in 2022: If the microcontroller crashes while the AIRs are energized, pushing the emergency button will open the AIRs. However, if you release the emergeny button in this scenario, both AIRs will close without pre-charging. This lead to two stuck AIRs. Th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

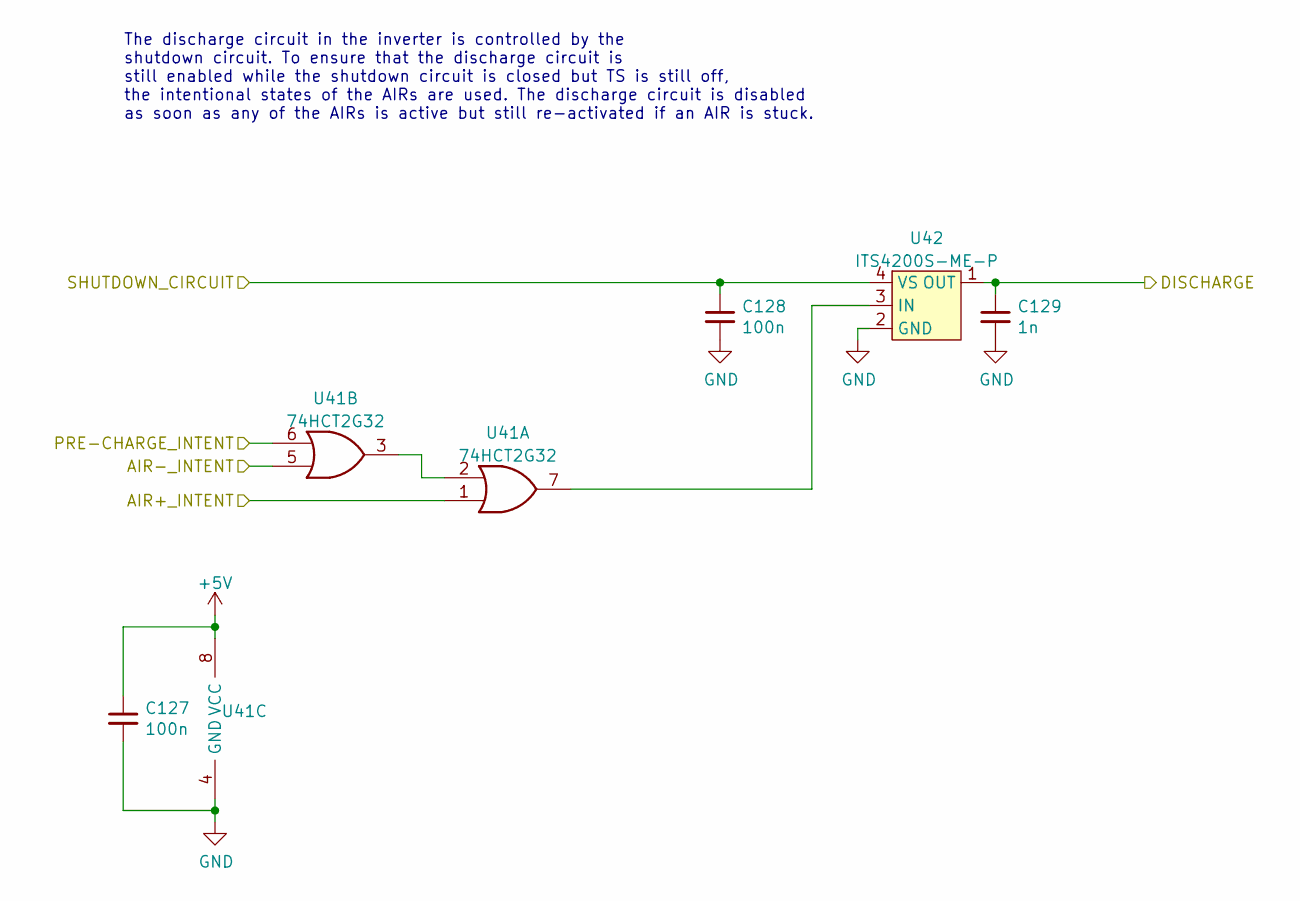
[picture p55: schematic discharge.kicad_sch, SPR23e Battery Management Unit (BMU)]

Parts:
C127, C128: 100n; C_0603_1608Metric
C129: 1n; C_0603_1608Metric
U41: 74HCT2G32; VSSOP-8_2.4x2.1mm_P0.5mm
U42: ITS4200S-ME-P; SOT-223

Connections:
+5V: C127.1, U41.8 (VCC); also elsewhere on the board
/AMS-Master/AIR+_INTENT: U41.1; also elsewhere on the board
/AMS-Master/AIR-_INTENT: U41.5; also elsewhere on the board
/AMS-Master/PRE_INTENT: U41.6; also elsewhere on the board
/DISCHARGE: C129.1, U42.1 (OUT); also elsewhere on the board
/SC_RETURN: C128.1, U42.4 (VS); also elsewhere on the board
GND: C127.2, C128.2, C129.2, U41.4 (GND), U42.2 (GND); also elsewhere on the board
unnamed: U41.2, U41.3
unnamed: U41.7, U42.3 (IN)

Notes on the sheet:
The discharge circuit in the inverter is controlled by the shutdown circuit. To ensure that the discharge circuit is still enabled while the shutdown circuit is closed but TS is still off, the intentional states of the AIRs are used. The discharge circuit is disabled as soon as any of the AIRs is a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

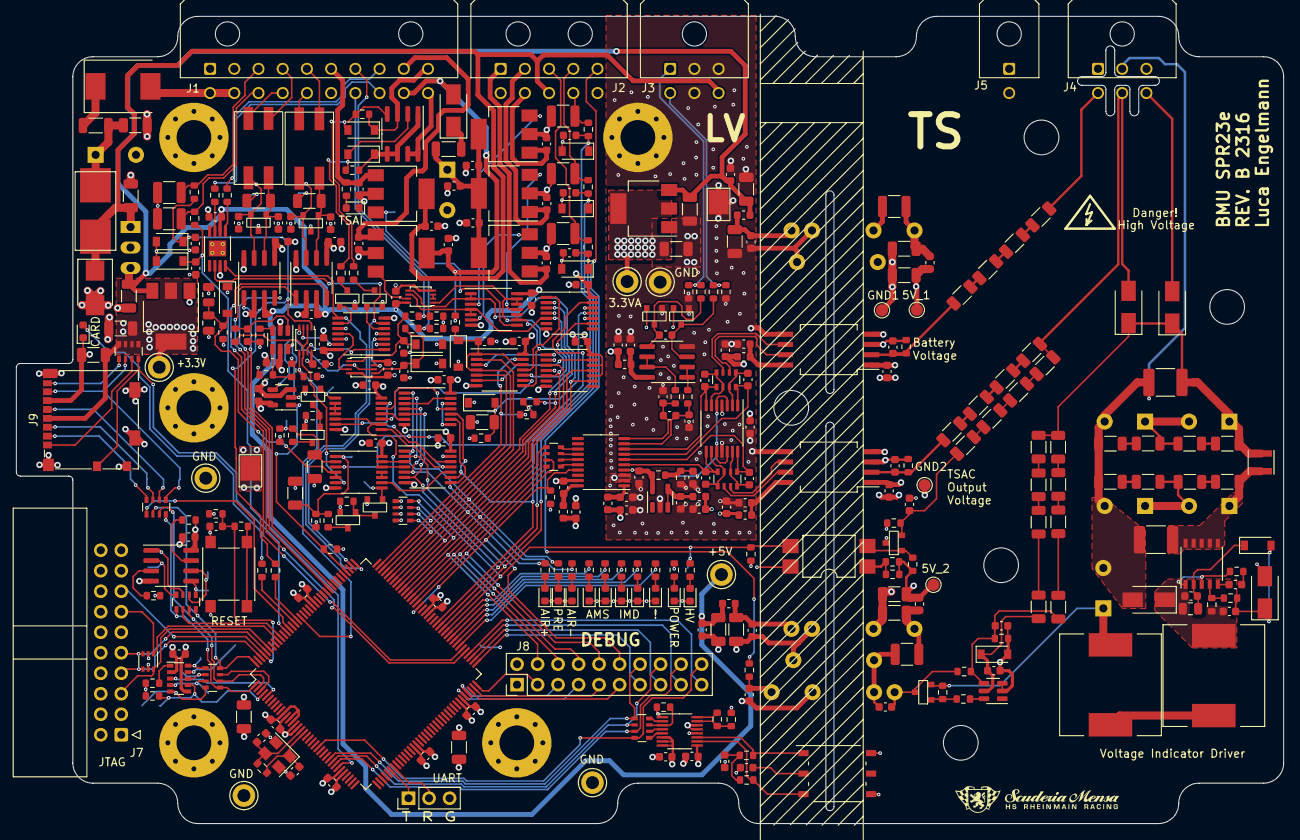
[picture p56: board spr23e-bmu.kicad_pcb from above]

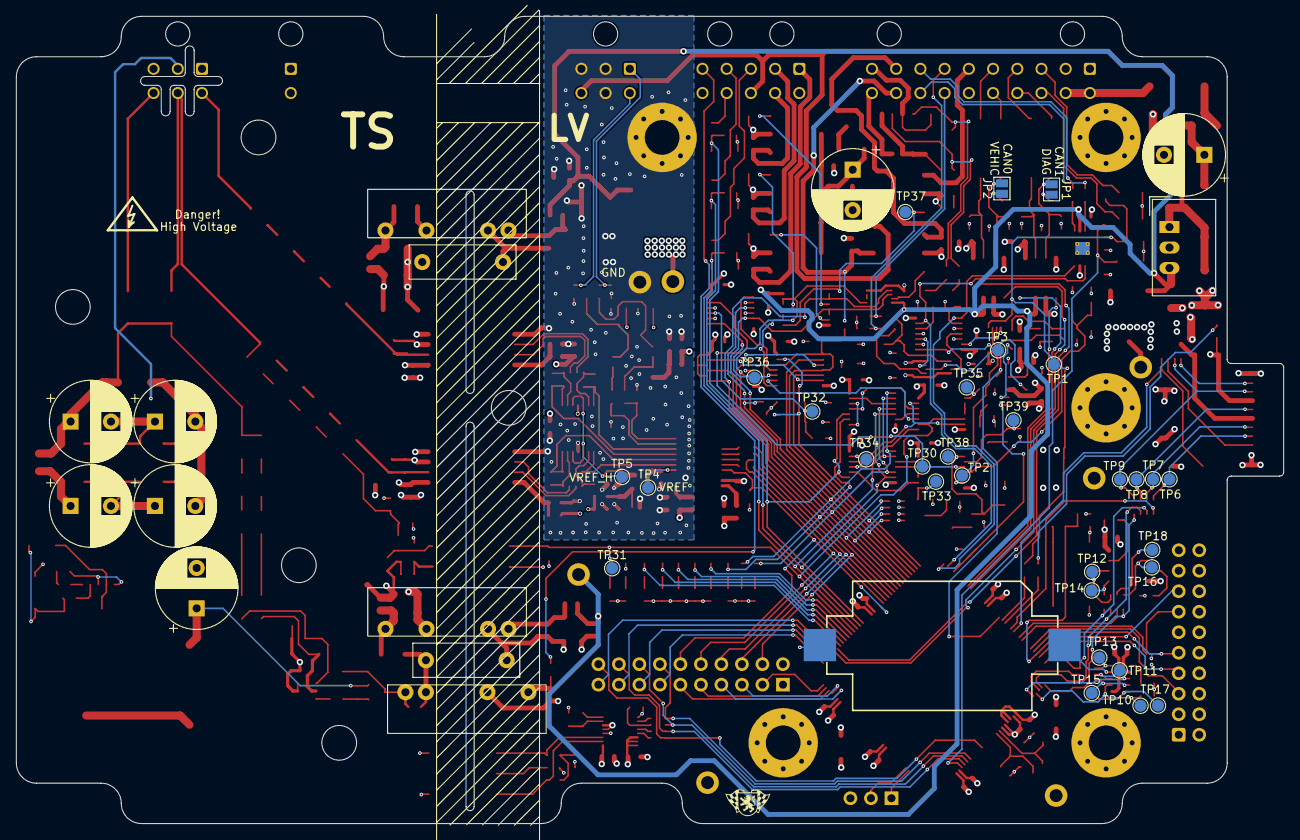
[picture p57: board spr23e-bmu.kicad_pcb from below]

Board: 4 copper layers, 157.0 x 100.0 mm, 433 parts (46 on the bottom side), 288 nets.
