derlucae98/spr23e-bmu/(commit log)

2023-04-23 Port to Kicad 7, small changes in auto-reset feature
    [ADC.kicad_sch, AMS-Master.kicad_sch, Interface.kicad_sch, Periphery.kicad_sch, Power.kicad_sch, Shutdown.kicad_sch, discharge.kicad_sch, io_filt.kicad_sch]
2023-07-14 Update KiCad project to newest version
    [ADC.kicad_sch, spr23e-bmu.kicad_pcb, ts_iso.kicad_sch]
